sequoia-hope/matrix-play/design/study/sunflower/README.md

# Sunflower: a low-cost 38 mm round board on 4 layers

Started 2026-11-06 at the user's request. The goal was to take the low-cost parallelogram parts (XL-1615RGBC-RF LEDs, AW20198QNR QFN drivers, all in stock at JLC) into a round board, lay the LEDs out in a sunflower pattern at the lower spacing, find how many LEDs a 4-layer board can route, and cost it down. The user first asked for 32–35 mm, then set the diameter at 38 mm, the same as the main round pendant.

Generator: `scripts/sunflower/`, forked from `scripts/parallelogram/`. Boards: `hw/sunflower/<tier>/`.

## Design

- **Outline:** a 38 mm circle. The 35 mm round cell (403535) sits behind the board and is wired to BT1, as on the main pendant.
- **LEDs:** XL-1615RGBC-RF at 0°, laid out as a Vogel spiral with r = 17.2·√((n+a)/(N−1+a)) and θ = n·137.5°. The innermost LED sits at 2.4 mm, so the centre is left for the Q2 light sensor. Density is uniform over the ring. Where diagonal neighbours' 2.0 × 1.9 mm courtyards would overlap, a relaxation step nudges them apart. That step only did anything at 132 LEDs.
- **Matrix map:** LEDs are sorted by angle and cut into wedges of 11. Each wedge is one CS triplet, with cathodes running radially. Within a wedge, the SW line is the LED's radius rank, so SW_m forms a ring across a driver's wedges. U1 takes the west wedges and U2 the east. The table is generated, so firmware reads it from `build_led_cells()`.
- **Back side:** Variant D is also a 38 mm disc, so its proven RP2350, flash, charger, LDO and USB block keeps its exact position (macro offset 0, 0). The rest of the back is placed as follows:

  | Part | Position |
  |---|---|
  | AW20198 drivers | (±12.6, 3) mm |
  | EVQP7J side buttons | north-east and north-west rim (±21°), 0.40 mm proud of the edge |
  | J1 (USB pads) | Variant D's position |
  | BT1 battery socket | Molex PicoBlade 1.25 mm 2-pin right-angle, 53261-0271 (C177225), at the north-west rim (−11.4, −10.2) mm, turned 250°, plug entering from the board-centre side |

- **Battery connector:** the user asked for a JST-style plug and first picked JST GH 1.25 mm. The 1.25 mm plugs on most small LiPo cells are friction-fit Molex PicoBlade clones ("micro JST 1.25", MX1.25), which don't mate with latching GH, so BT1 is now a genuine PicoBlade 53261-0271 (C177225, 27k at JLC; the CJT A1251WR-S-2P clone, C225111, is a cheaper same-size option). Its courtyard is 9.4 × 6.8 mm, wider than GH's 7.0 × 6.5 mm. `scripts/sunflower/jst_site.py` searches every routed tier for a spot where the courtyard clears all back parts. With the plug facing the rim nothing fits on every tier. The user chose the north-west rim with the plug entering from the board-centre side, which needs no parts moved. The alternative was the south-east rim by the charger, which needs U8, C6 and R8 moved. The battery nets run about 30 mm across the board at 0.25 mm, roughly 20 mV of drop at the 300 mA charge rate. Pin 1 is +, marked on the silk; check the cell's plug polarity, since makers differ. The plug has to go in before the cell is laid on the board, and the cell rests on the socket body.
- **Silkscreen:** the front carries the main pendant's seed web, the Voronoi cells of the LED centres with a ring round the outside, clipped clear of pads. The back names the buttons by function (PWR on SW1, USER/WAKE; BOOT on SW2, BOOTSEL) and marks the battery socket BATT with + and −, plus a LIPO 403535 note and IC designators.
- **Stackup:** 4 layers, JLC04161H-7628. In1 is an unbroken GND plane, In2 is the only inner signal layer. Vias are 0.30/0.15 mm. No vias go through the solid exposed pads except their own GND thermal vias.

## Tiers and results (ultraroute 3de3d83)

| Tier | LEDs | Drivers | mm² per LED | Nearest spacing | Opens | Hard DRC | Vias | Vias in SMD pads | BOM/bd @10 |
|---|---:|---:|---:|---:|---:|---:|---:|---:|---:|
| s1-66 (pofv) | 66 | 1 | 13.8 | 3.46 mm | **0** | **0** | 395 | 83 | $10.73 |
| s2-88 (pofv) | 88 | 2 | 10.4 | 3.00 mm | **0** | **0** | 472 | 84 | $12.02 |
| s2-110 (pofv) | 110 | 2 | 8.3 | 2.69 mm | 1 (`I2C_SDA` at U1 pin 28) | 5 (the 2 old `+3V3` 0.10 mm tracks by U3, 3 dangling stubs) | 632 | 121 | $12.37 |
| s2-132 (pofv) | 132 | 2 | 6.9 | 2.38 mm | 2 (an LED cathode by U3, one GND link) | 0 | 709 | 137 | $12.72 |

Numbers are after the battery socket moved to the north-west rim (2026-11-06; first JST GH, then Molex PicoBlade). Each board was re-routed locally round the new socket: `apply_jst.py` swaps the footprint, moves it and strips the copper in the way, then `route_variant.py --continue-plough` runs with a rip disc at the site. `finish_jst.sh` then cleans the copper, keeping `clean_copper_4l.py`'s output only when it stays at 0 open, and redoes silk, 3D models and the audit. s2-110 and s2-132 were at 0 open before the move; one more targeted pass each didn't close their new opens. The pre-move boards are kept as `route/pre_jst.kicad_pcb` (pads) and `route/pre_picoblade.kicad_pcb` (GH) in each folder.

For comparison, the parallelogram's p2-132 used 9.6 mm² per LED and its p3-162 (10.5 LEDs/cm²) did not close. Main round-pendant Variant E is $26.46 per board in parts, on 8 layers with 5 WLCSP drivers.

"pofv" means the router put same-net vias inside SMD pads (79–125 per board, about half of them in LED pads), so the board must be ordered with filled and capped vias (POFV).

**Threshold:** with vias allowed in pads, every tier up to 132 LEDs on the 38 mm disc routes to 0 opens on 4 layers. s2-110 and s2-132 still have small width and joint defects left by the router at tight spots. Unlike the parallelogram, a sunflower has no columns lined up over the drivers' 3.4 mm solid exposed pads: the escapes spread in every direction, so the 4-layer ceiling is not set by column pitch. Past 132 LEDs the limit would come from LED packing first: at 0° the XL-1615 courtyards start to collide at 132 and needed relaxation.

## Cost-down

Per board at qty 10 (live LCSC prices, `cost.json`):

1. **4 layers instead of 8.** This is the largest saving, in fab cost. Fab price was not quoted; read it from JLC's quote tool.
2. **AW20198 QFN instead of IS31FL3745 WLCSP.** $0.89 against about $2.26 each, in stock at JLC, with no Global Sourcing or pre-order. 66 LEDs need 1 driver; 88–132 need 2.
3. **XL-1615 instead of XL-1010.** $0.0159 against $0.027–0.029 each: $0.84 to $1.47 less per board, and 699k in stock against 12.9k.
4. **No vias in pads.** POFV is an added cost on JLC 4-layer boards. The rules generator now writes `no via hole in an SMD pad` (`physical_hole_clearance`, with the solid exposed pads exempt). ultraroute honours it since 0b0f336. Re-route results are below.
5. **Not yet done: RP2040 instead of RP2350 + L1.** $1.01 against $1.57, which also drops the AOTA inductor (43 in stock at JLC). It means a new MCU block, because the current one is copied from Variant D.

### No vias in pads (s1-66, s2-88)

These were re-routed from bare boards with the rule in place. The generator's pre-placed regulator GND vias now also stay out of all pads, which leaves 1 PGND via where there were 2.

| Tier | Opens | Hard DRC | Vias | Note |
|---|---:|---:|---:|---|
| s2-88 | **0** | **0** | 529 | Raw router copper: `clean_copper_4l.py` breaks 2 connections on this board, so it isn't used. Left: thin pad joints and untidy copper (off-centre via joins, cap gaps) that DRC accepts. |
| s1-66 | 1 (`SW1_4` at U1 pin 3) | 5 (3 GND-plane necks on In1, 2 dangling USB_DM stubs) | 434 | Probe board, not for fab. |

A bounding-box check of vias in non-GND SMD pads flags a few on each board, all false: rotated BT1 pads and the drivers' unnumbered paste windows. Tested against the real pad shapes, neither board has a via in a copper pad.

Keeping vias out of pads costs at most an open or two and some clean-up, so a POFV-free 4-layer order is in reach at 88 LEDs. The filled-via (POFV) routes are kept as `hw/sunflower/s1-66-pofv` and `s2-88-pofv`, each with fab files.

## USB-C study (s2-110-usbc)

Asked for on 2026-11-06: a real USB-C on the back instead of the wire pads, buttons and battery socket at the top, an LED at the centre, and the light sensor out at the rim. Built as its own variant beside s2-110 (`hw/sunflower/s2-110-usbc`, `VariantSpec(centre_led, usb_c, als_pos)` in `config.py`).

- **Receptacle:** HRO TYPE-C-31-M-12 (C165948, 322k at JLC), KiCad's footprint, on B.Cu at the south rim, mouth out, front 0.3 mm past the edge. Its 4 shell legs and 2 pegs go through the board, so they are keepouts for the front LEDs: `sunflower_points(..., keepouts=...)` pushes LED centres out of them (and out of the light sensor's spot) before the courtyard relaxation. Note that flipping a footprint to B.Cu mirrors it front-to-back, so the receptacle sits at 180°.
- **Why not beside the battery socket:** at every angle next to the socket on the north rim, the receptacle's 10.7 × 9.5 mm courtyard lands on U3 itself (and Y1, the RP2350 decoupling). That spot needs the RP2350 block moved, which every tier copies from Variant D. At the south rim it only displaces U7 (ESD), U8/R8/C6 (cell protection) and C1, which the legaliser moves round it.
- **Centre LED and light sensor:** the spiral starts at the centre (LED 0 at 0, 0); Q2 sits on F.Cu at the top rim (0, −18.2) with R43/C70 behind it.
- **Route:** from scratch, then plough passes with wider shove reach and targeted rip-ups. VBAT_EN would not route from GPIO14 (pin 18), nor from GPIO15 or GPIO0: its 22 mm run south to Q1 (by the USB-C) has to cross the LED field. It now sits on **GPIO28 (pin 42)**, beside VBAT_SENSE on pin 40, and routes along the same inner-layer path (`VariantSpec.vbat_en_gpio`, this variant only; firmware must use GPIO28 here). Unlike s2-110 (121 vias in pads), this variant keeps the no-via-in-pad rule, so U2's south pins had to escape between its PVCC caps: those caps (C40-C42) now sit 0.45 mm further out (`pcb_gen.py`, east driver, USB-C variants only). The +3V3 neck at the LDO output was a second stub into U6 pin 1; the via now feeds the fanout track directly. **Result: 0 opens, 0 DRC errors and warnings, copper audit, pad joints, sync and nets checks clean; 612 vias. Fab files in `hw/sunflower/s2-110-usbc/fab/`.** BOM $12.55 at qty 10 ($0.18 over s2-110 for the receptacle).
- **USB data fix:** the first USB-C schematic joined D+/D- (A6/A7, B6/B7) into CC1: the jogged wire from J1 down to U7 ended on the CC1 wire. `sch_gen.py` now joins J1 and U7 by `USB_DM_C`/`USB_DP_C` labels; the board was synced and those nets re-routed. Commit 997affe carried the short.
- **Bring-up pads and board ID (2026-11-07):** asked for after the first route. Fourteen 1.0 mm test pads on the back (KiCad's pad with its courtyard cut to 0.75 mm, `round_pendant:TestPoint_Pad_D1.0mm_CrtYd0.75`, so they fit the pockets between routed parts):
  - Power: VSYS, 3V3, VBAT, 1V1, VBUS and GND.
  - Debug: RUN, SWCLK and SWDIO, grouped at the north rim.
  - I2C0: SDA and SCL.
  - **UART1 on GPIO24 (TX, TP14) and GPIO25 (RX, TP15).**
  - GPIO29, the spare ADC input (TP16).

  UART first went on GPIO8/9 with pads west of U3 (TP9/TP10). Those pads blocked the west LED rows and ACC_SDA, so they were dropped on the user's call. **Board ID straps** are on GPIO19/20/21 (pins 31-33), read with pull-ups: `ID = GPIO19 + 2·GPIO20 + 4·GPIO21`, with tied = 0 and open = 1. This board ties GPIO19 to GND through net tie NT1, so it reads **ID 6**; boards without straps read 7. The tie is a net tie, not a wire, because ERC flags a bidirectional pin on GND. Re-routed locally from the 612-via board over eight plough passes (`route/run-tp*.log`). **Result: 0 opens, 0 DRC errors and warnings, copper audit, pad joints, sync and nets checks clean; 637 vias; fab files re-exported (BOM unchanged: test pads and net tie are not assembled).** Back silk names each test pad only where the label clearly sits by its own pad. 3V3, VBAT, RUN, CLK, SDA and VBUS have no room for one; the viewer shows their nets.
- **LX cutout trimmed (2026-11-07):** the In1 GND cutout under the regulator's switch node was the bounding box of U3 pin 48 and L1's LX pad, so it also cleared plane under pins 46/47 and the PGND pour (9.2 mm²). `pcb_gen.py` now draws it as the VREG_LX copper itself (zone and LX pads) grown 0.25 mm: 5.4 mm². Applied to the routed board in place (no copper moved, plane refilled): 0 DRC, copper audit clean; gerbers re-exported, BOM and CPL unchanged.
- **Release set, CPL fix, and phase gates (2026-11-08):** `hw/sunflower/s2-110-usbc/fab/` (`sunflower-s2-110-usbc-gerbers.zip`, `bom-jlcpcb.csv`, `cpl-jlcpcb.csv`) is the current release set; the older KiCad Fabrication Toolkit export from 01:37 on 2026-11-07 (predating test pads, the LX cutout trim, and CPL fixes) was moved aside to `hw/sunflower/s2-110-usbc/production-stale-2026-11-07-0137/`. `scripts/sunflower/export_and_cost.py` was fixed to mirror Bottom-side rotations `(180 - rot_kicad + rot_off) % 360` and apply EasyEDA pick-origin offsets across all 34 LCSC parts (`BT1` at `110.00°`, `(87.7073, -89.4751)`; `J1` at `0.00°`, `(100.0000, -114.0290)`), verified across all 191 placements (`design/renders/sunflower-s2-110-usbc/cpl-check-{top,bottom}.png`). All 34 unique LCSC parts are in stock with normal lifecycle on 2026-11-08 (`L1` `C42411119` restocked to 1,520; lowest stock is `U6` `C2860046` at 531). Full phase-gate evidence lives in `design/gates/sunflower-s2-110-usbc/phase0.md`..`phase10.md` (study/sim/bring-up docs: `intent-s2-110-usbc.md`, `architecture-s2-110-usbc.md`, `brief-s2-110-usbc.md`, `stackup-4l.md`, `bringup-s2-110-usbc.md`, and `design/sim/sunflower-s2-110-usbc/`): **Gates 1, 2, 3 `passed`; Gates 0, 4, 10 `awaiting_signoff`; Gates 5, 6, 7, 8, 9 `failed`** on frozen `Rev S3C` rules/placement/copper/silk findings listed below.
- **Helpers:** `scripts/sunflower/fix_open_4l.py` (4-layer copy of the one-connection maze fixer; no via holes in SMD pads) and `gnd_via.py` (tie a GND pad to the In1 plane). Neither found legal room round U2.

## Open items

- **s2-110-usbc user sign-off (Gates 0, 4, 10 in `design/gates/sunflower-s2-110-usbc/`):** decide between ordering `Rev S3C` (`hw/sunflower/s2-110-usbc/fab/`) as a `5–10` unit bench prototype with documented Gate 5–9 waivers and firmware guards vs spinning `Rev S3D` first; confirm `403535` cell `297 mA` (`~0.6–0.8C`) charge rate, `BT1` pre-mating (`3.02 mm` to `C9`, `4.04 mm` to `U3`) + `0.05 mm` Kapton + `≥ 2.4 mm` rear spacer (`~9.6 mm` stack over `3.40 mm` mated `BT1` / `3.26 mm` `J1`), `SW1/SW2` `+0.40 mm` nominal plunger overhang, front Voronoi silk art, and `B.SilkS` identity omission.
- **s2-110-usbc `Rev S3C` prototype assembly & firmware guards (if ordered before `Rev S3D`):** order PCBA (`JLC04161H-7628`, `ENIG 1U"`, green LPI mask) with reflow **`Pass 1 = B.Cu`, `Pass 2 = F.Cu` (`≤ 245 °C`)** (`Q2` `XYC-PT19C-L1` allows 1 reflow pass only) and **NO `F.Cu` wave/hand-soldering on `J1`'s 4 PTH shield slots** (`sunflower-B_Paste.gbp` omits paste on `J1`'s PTH slots while `F.Cu` LEDs sit `0.18–0.29 mm` away; tack `J1`'s outer `B.Cu` slot edges under microscope on bench, and switch to full-SMT `TYPE-C-31-M-22` `C530612` or add `B.Paste` in `Rev S3D`); verify `BT1.1–BT1.2` continuity open before connecting a cell (`VBAT` via `@(86.99, 89.16)` is `0.107 mm` from `BT1.2`, and 29 vias sit under `BT1`); run XIP flash in **1-bit (`0x0B`) or 2-bit (`0xBB`) SPI** (`U4.8` is `8.56 mm` / 4 vias from nearest cap `C14`, giving `312–554 mV` 4-bit QSPI SSO droop vs `78–156 mV` in 1x/2x); enforce `ADC4` thermal caps (`GCC ≤ 105` on battery for `≤ 48 °C`, `GCC ≤ 9` CC / `≤ 24` CV gated on `PGOOD == 0 || CHG == 0` for `≤ 45 °C` LiPo); set `GPIO4/5` `12 mA` pad drive + `AW20198` `GCR = 0xB9`, `GPIO26/27` `PDE = 0, IE = 0` (`RP2350-E9`), and `≥ 30 ms` (`6 τ`) `VBAT_EN` (`GPIO28`) settle (`bringup-s2-110-usbc.md`).
- **s2-110-usbc `Rev S3D` hardware fixes (Gates 5–9):**
  - *RP2350 regulator & zones (measured on `s2-110-usbc`):* `+1V1` `RP2350 ring` fills as **1 whole piece (`6.0625 mm²`)**, whereas `+3V3` `RP2350 band` splits into **4 pieces (`[1.9164, 4.6139, 0.2974, 2.9284] mm²` = `9.7561 mm²`)** with 11 foreign vias inside `U3 ring`. Add power spokes from `COUT` (`C18`, `Zone 11`, currently 0 spokes) into `+1V1` ring so core `DVDD` current does not flow through `U3.50` `VREG_FB` (Gate 7 `B1`); give `C17` (`CFILT`) its own GND via separate from `U3` `PGND` `@(102.43, 99.10)` (Gate 7 `B2`); swap `In2.Cu` to solid `GND` plane + `LX cutout` (`0.21 mm` directly beneath `B.Cu` `U3`/`L1`) so `+3V3` `ADC_AVDD` and `VSYS` do not cross under `VREG_LX`/`L1` (`19–48 mV_pk` coupled spikes, Gates 5/6/7/8); and stitch `+3V3` band with locked tracks as on Variant F (Gate 7 `B4`).
  - *Thermal vias, PDN, flash & battery socket:* move `U3.61` (1 via) and `U5.17` (2 vias) open vias out of `B.Paste` windows into paste-free cross channels and add `U1.41` in-pad GND vias (Gate 7 `B5`); move `C22` beside `U4.8` (`≤ 2 mm`) for 4-bit `75 MHz` QSPI (Gates 6/8); pull `BT1` clear of Molex's `3.0 × 2.5 mm` restricted area, co-locate `U8` beside `BT1`, and parallel power-rail vias (`438 mΩ` PCB battery loop, `236.7 mΩ` `VSYS → U1`) (Gates 6/7); populate `.kicad_pro` `"netclass_assignments"` (Gate 5 `B3`).
  - *Silkscreen & fab layers:* move `BT1` `+`/`-` and `J1` `USB 5V` outside their connector housings (currently occluded when assembled), add `B.SilkS` pin-1 dots on `U1/U4/U5/U6/U9` + `B.Fab`/`F.Fab` designators, relabel `SW1` `"PWR"` → `"USER"`, add missing `TP*` net labels, and pull silk off open vias (Gate 9).
- **Other Sunflower tiers (`s1-66-pofv`, `s2-88-pofv`):** re-export `fab/cpl-jlcpcb.csv` with the fixed `scripts/sunflower/export_and_cost.py` before ordering PCBA (`BT1` and Bottom-side ICs on earlier exports predate the Bottom-mirror CPL fix), and check `+3V3` band / `+1V1` ring zone piece counts on whichever other tier is chosen.
- s2-88 (no vias in pads): 2 thin pad joints and copper tidying, then fab export.
- s2-110 and s2-132: close the opens left by the socket move (s2-110: I2C_SDA at U1; s2-132: an LED cathode near U3 and one GND link).
- s1-66 (no vias in pads): 1 open at U1's SW side. Try U1 turned 90° or 180° so its SW pins face the LED field.
- ultraroute: the necks and sub-width segments near U3 (s2-110 `+3V3` at 0.10 mm under a 0.15 mm rule, the s2-88 CS1_1 neck) are the min-connection-width items already on the ultraroute session's list.
