sequoia-hope/matrix-play/design/decisions.md

# Decisions

| Date | Decision | Reasoning | Alternatives |
|---|---|---|---|
| 2026-11-02 | IS31FL3741A-QFLS4-TR (C2940604) for the drivers | IS31FL3741-QFLS4-TR has 0 JLC stock (`jlc_parts.py search`); the A has 455, same 39 × 9 QFN-60 and 13 × 9 RGB circuit | IS31FL3729: named fallback, rejected: 15 × 9 dots gives 45 RGB per chip, 90 LEDs from two |
| 2026-11-02 | 234 LEDs on a 38 mm board, not a smaller board | Requested diameter; 234 sites need ~37 mm, and 38 mm leaves spare sites at the rim for USB-C tabs and any lanyard hole | 37 mm: smaller, but no spare sites near USB-C |
| 2026-11-02 | Driver SW and logic supply on VSYS, 3V3 regulator fed from VSYS | Driver inputs must stay ≤ VCC + 0.3 V (IS31FL3741A p.5); a regulator fed from the same rail cannot exceed it | Drivers on raw VBAT: a flat or absent cell with USB in would violate the limit |
| 2026-11-02 | Omit the 20 Ω/51 Ω CS resistors of the datasheet's Figure 2 | They reduce chip dissipation at 5 V, 78 parts for two drivers. At ≤ 4.2 V (5 V only on USB) with the lower peak current of R18 and the firmware limit R19, the chip stays within ~0.25 W. Rechecked in phase 1 | Fit them: no bottom-side room |
| 2026-11-02 | Accelerometer on its own I2C bus | Driver bus runs 1 MHz for frame rate; many low-power accelerometers stop at 400 kHz | Shared bus at 400 kHz: 702 bytes takes ~16 ms, marginal for 60 fps |
| 2026-11-02 | Boardroom project layout from phase 0 | User's instruction | — |
| 2026-11-02 | Gate 0 review finding 4 disputed in part: the reviewer counted 3 tracks per channel at JLC minimum | Routing G under the LED body through the 0.35 mm centre gap leaves 2 tracks per 0.75 mm channel, and no crossings on F.Cu. Written into R21; proved or dropped at routing | 3 tracks per channel at 0.1/0.1 mm, needing a crossing for G and B |
| 2026-11-02 | Gate 0 review finding 3 (blind vias effectively mandatory) taken as a recommendation, not settled | It changes cost and lead time, so it is the user's to decide; quote not yet checked | Through vias with EP cut-outs and a modified RP2350 ring |
| 2026-11-02 | 6 layers, through vias, via-in-pad; no blind vias | User's decision at gate 0, against the blind-via recommendation | Blind F.Cu–In1 vias on 4-layer HDI |
| 2026-11-02 | Battery is Grepow 5435035, charged to 4.2 V; XB9901A on board | User named the cell. Listings disagree (3.85 V nominal vs 4.4 V), and 4.2 V is safe for either. Protection status of the cell unknown, and XB9901A also gives reverse-connection protection per its datasheet | LiHV charger at 4.35 V: more capacity, needs the maker's spec |
| 2026-11-02 | BQ24073RGTR, not the BQ24075 family | VSYS regulated at 4.4 V on USB keeps driver dissipation low and holds blue/green headroom; 6.6 V OVP keeps VBUS faults off the drivers. BQ24075's 5.5 V OUT would run the drivers hotter | BQ24072 tracks VBAT + 225 mV: cooler but dims with a flat cell |
| 2026-11-02 | Sleep budget raised from 75 to 85 µA; flash deep power-down not relied on | RP2350 docs describe only an XIP exit at flash boot, so a flash left in deep power-down may not boot on a P1.7 cold wake. 610 mAh makes the difference small | Warm-boot code from retained SRAM (P1.3, +7 µA): firmware option |
| 2026-11-02 | LIS2DW12 SA0 and CS tied to VDD_IO | They have ~20 kΩ internal pull-ups (Table 3); strapping SA0 low would draw ~160 µA, twice the whole sleep budget | SA0 low with pull-up disabled by register: draws until configured |
| 2026-11-02 | Style check's `grid` errors on matrix1 and matrix2 waived | They are LED matrices, and drawing one as a grid is what makes it readable; datasheet Figure 2 does the same. No other sheet is affected | Scatter 234 LEDs to pass a check: worse to read |
| 2026-11-02 | SKRTLAE010 for the buttons, not TS-1088-AR02016 | Basic part, but its drawing shows a top plunger; R10 needs side actuation at the edge | — |
| 2026-11-02 | Schematic is hierarchical, drawn with kicad_write plus a small root-sheet writer in scripts/schematic.py | kicad_write has no sheets; instance paths are rewritten after saving. Request for kicad_write worth raising | One enormous sheet |
| 2026-11-02 | U3 centred on a via, 8 ring vias stepped out to the 3V3 band | Reviewer proposed offsetting U3 by (1, 1): 4 EP, 0 ring, 10 band. Recomputed with only the 5 open stub directions: centring gives 1 EP, 0 ring, 8 band, which disturbs less. Both keep the ring whole | Centre with vias in the ring (8 segments, 4 unspoked); (1, 1) offset; 45° rotation |
| 2026-11-02 | Buttons at −28° and −152°, on rim sites | Their 1.2 mm peg holes can't fit an LED channel; 2 sites lost, spare rim sites cover it | Put them on the south, by USB: more interior loss |
| 2026-11-02 | Board net classes checked by script against nets.csv, not by `nets_check.py --rules` | kicad-cli's netlist reports class Default on this hierarchical schematic; the board reads the right class. To raise with the skill: nets_check should read the board or handle hierarchy | Flatten the schematic |
| 2026-11-02 | SIGNAL clearance 0.09, below nets_check's derived 0.10 | JLC floor; R21 needs it in LED channels; low voltage | 0.10: fails channel fit margin |
| 2026-11-02 | Decoupler distance limit raised from 3 to 7 mm | LED via grid: a 0402 fits only between 4 vias; bulk 22 uF further. High-value bulk isn't distance-critical at 32 us scan edges; 100 nF kept nearest | Stub more vias aside: more F.Cu congestion |
| 2026-11-02 | U3's 8 band vias are 0.20/0.10 mm | A 0.25 mm via plus clearance leaves slivers under the minimum width in the 0.6 mm band (review, gate 6). JLC allows it on this board | 0.8 mm stubs: 0.01 mm from pads |
| 2026-11-02 | Charger EP whole, 1 thermal via | Through vias reach the LED side, so one LED channel crossing falls under a 1.7 mm pad. Reviewer's 4 vias aren't physically available. TI's thermal regulation protects it; phase 8 | Split EP, same via count |
| 2026-11-02 | U3 turned so its USB, QSPI and regulator side faces south; brief §7 updated | USB and QSPI shorter | Regulator north, USB crosses the board |
| 2026-11-02 | Pattern study made, board unchanged; placement sign-off on hold | User found LEDs too close to USB-C and asked for golden-spiral tests. Plans in design/study/patterns/. True golden arcs reach 167–191 LEDs; sunflower lattice reaches 234 with 0.29 mm minimum pad gap | Route the 2 mm grid as placed |
| 2026-11-02 | Vertical USB-C studied with the turned sunflower, board unchanged | User asked for right-angle USB-C off the back, with the rotated sunflower. The plug must pass beside the 35 mm cell, which needs a 41 mm board; study in design/study/usb-back/ | Edge-mount J1 on 38 mm; smaller cell on 38 mm |
| 2026-11-02 | USB-C off the board, pads only; turned sunflower; 38 mm kept | User's decision: they dislike the gaps a board-mounted connector leaves in the pattern. Removes all USB through-holes and lets the 35 mm cell stay centred. Proposed, unconfirmed: 6 pads (VBUS, GND, D+, D−, CC1, CC2) with Rd and ESD staying on the board | Vertical USB-C on 41 mm; edge USB-C on 38 mm |
| 2026-11-02 | Variant b: EVQP7C01P buttons (C388883), pegs between LEDs | User's choice. 6 LEDs nudged away from pegs to keep 0.22 mm to the 0.7 mm holes in the datasheet's land pattern | EVQP7J01P no pegs; SKRTLAE010 |
| 2026-11-02 | Variant b: 6 USB pads; Rd and ESD stay on board | Works with a bare receptacle; a breakout with its own 5.1k leaves CC unwired. No connector, no LCSC part on J1 | 4 pads with Rd off-board |
| 2026-11-02 | Variant b: exposed pads as tiles cut round foreign anode vias, per instance on the board | Sunflower vias land anywhere, so no fixed split works: U1 and U2 11 vias each, U3 3, U5 2. 0.3 mm from via centre keeps 0.2 mm hole-to-copper. EP solder paste not yet added: needed before release | Move LEDs off chips, breaking the pattern |
| 2026-11-02 | Variant b routing trials: 1 to 5 incomplete | Open signal connections: 103, 109, 120, 194 (control first), 122 (chip keepouts, inner fan-out). Keepouts and inner fan-out cut the control-only pass to 8 open, but the full board stays near 100+ with rip-up out of time. Trials 1 to 4 boards overwritten; trial 5 kept in route/trials/t5 | Blind vias; a matrix map aware of crossings; more router time |
| 2026-11-02 | Matrix assignment isn't what limits routing; variant b keeps its map for now | Same settings as trial 5 (122 signal open, 82 plane, 49 errors): spiral map, trial 6 (hw/round-pendant/b-spiral), 146, 73, 72; driver-centred fan map, trial 7 (hw/round-pendant/b-fan), 118, 67, 51. Fan cut estimated crossings by 43% (503 to 288) and open signals by 3%. CS nets are most of what stays open | Blind vias; a less dense pattern; longer router runs |
| 2026-11-02 | Symmetric centre studied, no board changed; 5-fold 5 + 10 + 15 recommended, unconfirmed | User asked for a more rotationally symmetric centre. It keeps 234 LEDs, exact to 5.4 mm radius, moves 11 nearby LEDs by at most 0.49 mm, and opens the tightest pad gap from 0.36 to 0.42 mm. Study in design/study/center/ | 5 + 10; 6-fold (2.8 mm hole); 8-fold (0.30 mm gap, 4.5 mm hole); Fibonacci rings (no overall symmetry) |
| 2026-11-02 | Plain sunflower plus 2 centre LEDs studied, no board changed | User asked to see it. 2 neighbours eased by at most 0.25 mm keeps the 0.36 mm tightest gap; 0.18 mm with nothing moved. Drivers have exactly 234 positions, and the wiring and back-side fit of the extra 2 are unsolved. Study in design/study/center-plus2/ | Symmetric rings (design/study/center/) |
| 2026-11-03 | Variant c: plain sunflower plus D235 at (0.05, -0.65), nothing nudged, on RP2350 GPIO23-25 | User's choice. Anode on +3V3: VSYS would hold an off GPIO above IOVDD. R40 1 k red, R41 and R42 470 R green and blue, for about 1.5 mA, near a matrix LED's 1.25 mA average; Vf at this current estimated from the p.6 curve, not measured. Pin high is off; firmware must clear pull-downs before sleep, or the LED draws from the 85 uA budget. GPIO23-25 chosen as the free pins facing the centre. Fan map used, as the best of trials 5-7 | Share a matrix cell: no separate control |
| 2026-11-03 | Routing crunch started on variant c, through vias, 6 layers | User asked for multiple automated attacks with subagents and Gemini. Brief in design/study/crunch/README.md. Layer, map, placement and router attacks each keep their own variant folders; a Gemini 4 Argon plan is advisory | Blind vias and bigger board not started, still the user's call |
| 2026-11-03 | 8 layers allowed; blind vias ruled out | User's decision: the board must stay within JLC capabilities. 6 layers is still preferred if it routes. Through vias stay | Blind vias, bigger board |
| 2026-11-03 | All copper zones get explicit clearance: planes 0.2 mm, RP2350 ring and band 0.09 mm | Found by the layers attack. zones_b left KiCad's default 0.5 mm, which cut the GND plane to 320 mm² in 20 pieces on trial 7 and left the 1V1 ring with no fill. Refilling trial 7 at 0.2 mm: 832 mm² in 1 piece, plane opens 67 to 2, signal opens unchanged. Trial plane-open figures to date are inflated by this | - |
| 2026-11-03 | SW scan lines move to a new class SW_SCAN: 0.1 mm track, 0.25 mm via | Gemini's review found it, checked here: nets.csv had them POWER, and the intended 0.1 mm rule used a condition the router can't read, so trial 7 laid 899 of 955 SW segments at 0.2 mm, about 970 mm on In1 and In3. 0.1 mm was the original intent. 84 mV drop at 494 mA is Gemini's estimate, not yet checked on a routed board: must be measured against driver headroom before release | 0.12 mm; POWER at 0.2 mm |
| 2026-11-03 | Routing crunch focuses on 8 layers: GND on In2, VSYS and +3V3 on In5 | User's direction, after 8 layers cut signal opens from 107 to 56 on the same 1200 s limit, the only large gain so far. Not yet complete. JLC publishes no 8-layer stackup table, so thicknesses need confirming with a quote | Keep pressing 6 layers |
| 2026-11-03 | Two-board stack being explored alongside 8 layers | User's idea: a 4-layer LED board with both drivers on one half of the back, and a small processor board on the empty half, joined at the edge. Could be cheaper than 8 layers, and takes control nets off the LED board. First test is whether the LED board alone routes on 4 layers. 8 layers stays preferred if parts must be flown over each other | 8 layers only |
| 2026-11-03 | Two-board stack: agent recommends shelving it, owner has not decided | 4-layer LED board alone: 91 open with a GND plane, 56 with no plane (GND then 144 mm of 0.2 mm track). Processor half fits only by moving the LDO and its caps 9-11 mm, with 15 courtyard overlaps. 16 joint pads, no JLC board-on-board service found, no bare-board quote. Reversal needs under 10 opens with a real GND path and a quote showing a clear saving. Report: design/study/crunch/stack/report.md |
| 2026-11-03 | New 8-layer starting candidate: U3 fix, drivers 2.4 mm north with their parts, cathode vias through driver pads | Reported 22 open / 5 plane / 76 errors / 865 vias at 1200 s (c-placement-y5, --cell 0.025) against 57 / 11 / 54 / 956 with the U3 fix alone. No LED moved; the map changed. Driver pad copper falls from about 26 to 16-17 mm², thermally unchecked. |
| 2026-11-03 | Near-complete 8-layer route: c-placement-y11, not signed off | 2 signal open (CS2_16, CS2_17), 1 plane open, 901 vias, 3000 s, --cell 0.025. Adds USB and crystal uncrossing (R14/R15 swap, Y1 turned, R17 moved, C23/C24 swap), real net classes for VBAT, BAT_N, VBUS, driver GND zones, critical nets locked from a first pass. VSYS minimum dropped from 0.3 to 0.2 mm: a rule change, stub lengths and currents not yet checked. |
| 2026-11-03 | c-placement-y12: In6 ground island and closer C23 | 2 signal open (CS2_14, CS2_17), 0 plane, 6 dangling stubs, 880 vias, 3000 s, --cell 0.025, reported pad_joints pass. XIN 6.3 mm against the 6 mm limit. Last opens are LEDs over L1 and the PGND zone. |
| 2026-11-03 | First fully connected route: c-placement-y17, not signed off | 0 signal open, 0 plane open, 898 vias, 235 LEDs, 8 layers, through vias. KiCad DRC with zones refilled: 0 unconnected, 5 dangling stubs, XIN 6.34 mm against 6 mm, SW2_8 via in the L1 window, plus silk. pad_joints FAIL: U1.53 0.069 mm, U2.28 0.022 mm. Double-wired zone copper not yet removed. |
| 2026-11-03 | c-placement-y17/y18 complete route rejected as a finished board | DRC 0 unconnected and 877 vias after tidying, but 15 foreign vias within ±2.3 mm of U3 (3 placed before routing) cut the 1V1 ring from 6.1 to 1.5 mm², leaving 1V1 on about 72 mm of thin inner track, against `chips/rp2350.md`. Next: y19 forbids new foreign vias in the ring; y20 tries a 1V1 pour on In6. |
| 2026-11-03 | Electrical check of c-placement-y17: fine at the 300 mA limit, not at full white | Agent figures: full-white row needs about 4.00 V typical, about 4.55 V top bin (above a full cell); 3.44 V at the 300 mA limit if GCC scales the peak. Mostly SW line resistance, 0.1 mm tracks, worst 276 mV. VSYS at 0.2 mm judged justified on B.Cu, except the single U5 output via. Report: design/study/crunch/layers/report.md |
| 2026-11-03 | c-placement-y19 replaces y17 as the best board | 0 signal open, 2 plane open (+3V3 at U6 pad 1 and C12 pad 1), 895 vias, with new foreign vias forbidden inside ±2.3 mm of U3. Reported: ring one piece at 6.0 mm², 3V3 band in 9 pieces. y20 (1V1 pour on In6) scored 1/1/1/897 with the pour in 5 pieces, so the vendor ring stays. |
| 2026-11-03 | Full-white headroom stops driving the routing | User: "most of the time I am gonna be operating this at a reduced brightness". So 0.1 mm SW lines stay, widening the worst four becomes best-effort after routing, and the firmware keeps a global-current limit (GCC scaling, 300 mA figure) as protection against heat and droop. Full white stays possible on a fresh cell but is not a design case. |
| 2026-11-03 | Real 3D models for the viewer, in 3dmodels/ | EasyEDA models by LCSC number for U3, L1, SW1/2, U6, U8. No model exists for the LED (C965834), so scripts/make_led_model.py draws one from the datasheet; die and top-copper positions are approximate. U1/U2 use the same QFN-60 STEP as U3, because their own is .wrl only. Applied to the viewer copy by scripts/set_3d_models.py, which must run again on each new board; lib footprints unchanged. EasyEDA rotation for U3 (270) and L1 (0) corrected by eye to 0 and 180. |
| 2026-11-03 | Front silk is a sunflower seed web, back silk off for now | User: draw an interconnected web between the LEDs and round the edge, remove back silk, have Gemini tidy designators later. scripts/silk_web.py: Voronoi cells of the LED centres, 0.153 mm stroke, 0.15 mm from pads, JLC standard limits; 99% of the web and 98% of the ring survive clipping. Runs over tented vias. Silk DRC errors 0. |
| 2026-11-03 | c-placement-y27 is the best board: every connection joined | KiCad DRC with zones refilled: 0 unconnected, 861 vias, 5 rule-area vias and XIN 6.34 mm as the only non-silk errors. 1V1 ring whole at 5.66 mm², 1V1 track 15.8 mm. Corner necks not fixed: 456 joints under 0.09 mm. Copy with seed web silk and models is hw/round-pendant/c-web2. Report: design/study/crunch/placement/report-y27.md |
| 2026-11-03 | c-placement-y30 is the best board, published as c-web3 | y27 plus post-route fixes, no parts moved. KiCad DRC: 0 unconnected, 861 vias, 5 rule-area vias and XIN 6.34 mm as the only non-silk errors, one copper sliver warning. necks.py: 30 joints under 0.09 mm, 2 sole, down from 456 and 378. pad_joints_fixed FAIL on U1.61 at 0.079 mm. User approved updating GitHub Pages. |
| 2026-11-03 | Viewer moved to the top of the project page, above the title | User request. Still to fix in the copper, per user: necks, meaning the thin track-to-pad joints. No via change was requested. |
| 2026-11-03 | Thermal figures corrected: heat is set by the whole board, not the drivers alone | The earlier estimate counted driver dissipation only. All supply power becomes board heat apart from emitted light: 1.26 W at 300 mA on a 4.2 V cell, about 44 K/W to still air, so up to about 55 K steady rise (hand estimate, h about 10, both faces, no case or cell, light not subtracted). About 80 °C at 25 °C ambient. Datasheet: TJMAX 150 °C absolute, operating 125 °C. The 300 mA default in intent.md R19 needs review for a worn part; measure on the first board. |
| 2026-11-03 | Trying to add a front-side analog light sensor and load resistor | User request; placement decided by where the analog net can escape. Survey: a 1.7 x 0.8 mm body fits at 12 edge sites without moving LEDs. GPIO27-29 (ADC1-3) are free. Part per user: same as simple_earring, ALS-PT19 C146233 (two pads, 2.3 x 0.8 mm land), 22k C25768 load, 100 nF C1525 filter. 7 sites fit that land. Nothing routed yet. |
| 2026-11-03 | Battery changes to a 403535 round pouch cell | User direction. Same 35 mm outline, 4 mm thick against 5.45 mm, so it still fits. Capacity not confirmed; about 400-450 mAh estimated by scaling the 610 mAh 5435035 by thickness. R4 (297 mA charge) needs reducing once ratings are known; schematic value text for BT1 still names the old cell. |
| 2026-11-03 | Addressable LED counterfactual costed | scripts/cost_compare.py at qty 5, LCSC prices: this board parts $22.83 (LEDs $6.34, driver parts $6.76); 235 WS2816C $22.77 total, 235 SK6805 $23.90. Idle: drivers about 8 mA with SDB high against 165-235 mA (WS2816C) or about 70 mA (SK6805). Fab not priced: needs a JLC quote. |
| 2026-11-03 | No press-to-hold latch on this board | It has SW1 wake from RP2350 sleep (about 85 µA budget), not simple_earring's latch. Recommendation: same press-to-hold feel in firmware, no new parts; firmware must watchdog and return to sleep. Two buttons stay. Sensor powered from a GPIO, as the user agreed. |
| 2026-11-03 | Charge current stays at about 297 mA on the 403535 cell | User prefers faster charging: about 0.74C on an assumed 400 mAh, 266-325 mA across the ISET range (about 0.67-0.81C). R4 stays 3k. Needs the cell to allow 1C charge, not yet confirmed. |
| 2026-11-03 | Gemini's back silk accepted, applied to y30 as c-web4 | scripts/crunch/silk/back_silk.py: 24 of 24 major parts and 28 of 73 passives keep a designator (52 of 97), 0.8 mm text with 0.10 mm stroke, 7 over tented vias. Checked: copper and part positions unchanged, 0 silk errors with the seed web. Needs JLC's high-precision silkscreen option, per JLC's blog only. min_text_thickness set to 0.1. Report: design/study/crunch/silk/report.md. Gemini's claim that U6's 3D dot is 180 degrees off was checked and is wrong here; U8's model dot is off pin 1, 3D view only. |
| 2026-11-04 | Route candidates after the placement agent stopped; base not chosen yet | y30: 0/0 open, FB reaches COUT on B.Cu (agent's check, correcting its earlier doubt), one VSYS and one VBAT via at U5, XIN 6.34 mm, 5 keep-out vias, 1 sliver. y43: 0/0, DRC clean except silk, 3 vias at U5, but D235's via cuts FB from COUT. Eight routes with the via moved all ended with 0-3 signal and 0-3 plane opens; latest y57 2/1, y58 3/1. |
| 2026-11-04 | Corner necks fixed on y30 as c-placement-y61, no reroute | necks_fixed.py (true pad layer, fixing the same GetLayer fault as pad_joints.py): 38 real necks to 0. Other figures unchanged from y30. Scripts necks2.py, joints3.py are re-runnable; necks_hand.py is y30 coordinates only. |
| 2026-11-04 | y61 chosen as the route to take forward | User decision, over more routing runs. User also asked for more vias at U5 for VSYS and VBAT; being tried locally as y62, without rerouting the board. |
| 2026-11-04 | y62 adds 3 VSYS and 3 VBAT vias at U5, locally | Reported per-via current VSYS 363/330/295 mA, VBAT 461/392/167 mA at 988 mA total, from pdn_vias.py. Two vias sit in U5 pin pads (U5.11, U5.2) and must be filled. VSYS drop 9.1 to 7.4 mV, VBAT 50.9 to 49.0 mV. 8 nets moved; SW2_8 off L1. VBAT far via at (6.49, 14.29) still carries all current alone. |
| 2026-11-04 | RP2350 relaxations: 1, 2, 3, 4 and 6 accepted; part of 5 accepted; rest of 5 and 7 open | User decision on the list in rp2350-acceptable.md. Accepted: regulator block rigid with PGND's two vias free to move about 0.7 mm; block may move or turn; XIN/XOUT limit 11 mm; QSPI 25 mm with vias allowed, slower flash clock as the fix if marginal; U3 100 nF parts within 4 mm pad centre to pad centre; one via per USB line before the 27 Ω resistors. Open: dropping 90 Ω as a goal, and foreign vias through U3's exposed pad. Not yet applied to the .kicad_dru. |
| 2026-11-04 | Relaxation 7 rejected: no signals through U3's exposed pad | User decision: the ground pad is one solid pad, and soldering over many small pads with signals between them is not acceptable. Reverses the 2026-11-02 row that tiled exposed pads round foreign vias. User confirmed it covers U1, U2 and U5 too and asked for a reroute, overriding the earlier choice of y61/y62; y62 stays on disk for comparison. User also accepted dropping 90 Ω USB impedance as a goal (relaxation 5). Measured on y62 (vias inside each pad's outline; copper by raster): U1 24 foreign, 16 GND, 54% copper; U2 21 foreign, 16 GND, 50%; U3 3 foreign, 9 GND, 89%; U5 2 foreign, 2 GND, 73%. No tile has a paste layer. y62 fails this rule on all four. |
| 2026-11-04 | Solid exposed pad reroute started: c-solid-z6 running; z5's first try failed on a full disk, and its rebuild z7 was stopped at 01:48 by a queue stop signal, exit 143, cause unknown | board.py knob solid_ep: one solid pad on U1, U2, U3 and U5, footprint paste windows kept, build stops if a foreign via lands in a pad. From exp/y45.json without ep_cathodes or ep_prune, stub_rings up to 3.6 mm. z5 has 16 GND vias on U1 and U2, z6 has 9 (a relaxation, labelled for comparison). Both have U3 9 and U5 2 (U5 asked for 4; only 2 fit). Rules: XIN, XOUT and Net-(C24-Pad1) max 11 mm, USB_DM and USB_DP one via. Pre-route DRC errors are silk and text only; placement_check passes. z1 to z4 are failed builds, kept. The library's pads on U1, U2 and U3 were separate rectangles with gaps, not one pad. Paste windows cover 4.0 of 29.2 mm² on U1 and U2 and 4.84 of 11.6 on U3: to review before release. |
| 2026-11-04 | First solid-pad routes: z6 51 signal, 4 plane, 6 errors, 870 vias; z7 56 signal, 2 plane, 4 errors, 882 vias | KiCad's judge, 3000 s, deadline hit. Most opens have an LED end over a chip body. Straight F.Cu stubs from those pads (z9) about half fail and give crossing and hole clearance errors. Agent crunch-solid takes it from here, reporting in design/study/crunch/solid/report.md. |
| 2026-11-04 | Variant d: 5× IS31FL3745-CLS4-TR WLCSP-36 BGA LED drivers (C2678907), routed to 0 open and 0 DRC errors with solid exposed pads | User requested a BGA LED driver variant after QFN-60 solid exposed pads stalled routing. Five WLCSP-36 drivers (2.895 × 2.895 mm, 6 × 6 balls at 0.50 mm pitch, zero exposed ground pad, 8 SW × 18 CS = 48 RGB cells each, 5 × 47 = 235 RGB LEDs including D235) replace the two QFN-60 drivers, cutting driver footprint area from 98 to 41.9 mm² and scan peak current from 494 to 204 mA. Solid exposed ground pads enforced on U3 (11.56 mm², 9 GND vias, 0 foreign vias) and U5 (2.89 mm², 2 GND vias, 0 foreign vias); U3 +1V1 ring 1 piece (10.83 mm² union). Routed on 8 layers with through vias in ultraroute: 876 vias, 5,870 track segments, 0 locked copper, KiCad DRC 0 violations and 0 unconnected items (1 copper_sliver warning), pad_joints and pad_joints_fixed 0 thin joints, ERC 0 errors, sync_check/placement_check/nets_check PASS. Front sunflower seed web silk (99% kept) + 5 WLCSP A1 pin-1 dots + 58/104 tidy back designators (27/27 majors). Audit: design/parts/drivers-bga.md; viewer: viewer/round-pendant-d.html. | C2678772 IS31FL3235A (no scan matrix: 79 chips needed for 235 RGB); C2678908 IS31FL3746B (12 RGB/chip: 20 chips needed); C2874518 IS31FL3729 (QFN-40 with exposed pad, no BGA) |
| 2026-11-05 | Variant d copper cleanup, strict `.kicad_pro` DRC rules, and topological `copper_audit.py` gate | User inspection caught leftover partial-rip-up trace stubs, discontinuous trace joins, and narrow copper necks on Variant D. Root causes: (1) `.kicad_pro` had `min_connection = 0.0` and `connection_width`/`copper_sliver`/`isolated_copper`/`via_dangling`/`hole_to_hole`/`holes_co_located` set to `warning`; (2) KiCad's connectivity treats any `> 0 nm` same-net round-endcap overlap as connected and non-dangling, hiding 119 off-center via grazes (`.00/.25` escape vias vs `.x175/.x137` ultraroute grid), 22 cap-to-cap gaps, 25 mid-segment partial-rip-up stubs, 5 dangling stubs, 580 duplicate collinear sub-segments, 1 `In1.Cu` 10.8° V-notch sliver (`SW3_1`), and 1 `< 86 µm` morphological neck (`CS1_11`). Tightened `.kicad_pro` (`min_connection = 0.09`, all six severities promoted to `error`) and ran `scripts/bga/clean_copper_d.py` + `scripts/bga/copper_audit.py`: tracks reduced from 5,870 to 5,218 (876 vias), 0 defects across all 7 `copper_audit.py` categories, 0 `kicad-cli pcb drc --severity-all` errors or warnings, and 0 `pad_joints` / `pad_joints_fixed` thin joints. Re-exported `hw/round-pendant/d/fab/` Gerbers/BOM/CPL and rebuilt viewer. | KiCad DRC alone (misses same-net cap-overlap stubs and off-center via grazes) |
| 2026-11-05 | Keep `5× IS31FL3745-CLS4-TR` WLCSP-36 via JLCPCB Global Sourcing; WLCSP thermal margin verified | User decision: keep `IS31FL3745-CLS4-TR` (`C2678907`, ~2,078 at DigiKey / ~648 at Mouser via JLCPCB Global Sourcing, alongside `L1`) rather than switching to in-stock QFN-EP drivers (`4× AW20198QNR` QFN-40 or `6× IS31FL3729` QFN-32) whose solid exposed ground pads re-block LED anode vias. Why matrix drivers are mostly QFN-EP in general: single-chip signage/keyboard drivers sinking `300–600 mA` off `5 V` burn `0.8–1.5 W` in one package and target cheap 2/4-layer `0.15 mm` boards. Here, current is split across 5 spaced WLCSPs fed from LiPo `VSYS` (`3.7 V` nom, `4.2 V` full): at `300 mA` board total (`60 mA`/chip, mean `VF ≈ 2.53 V`), each `IS31FL3745` dissipates `0.10 W` (`100 mW`). At `θJA = 47.49 °C/W` (`is31fl3745.pdf` p. 5; flip-chip solder balls conduct directly from silicon into 8-layer `In2.Cu` `GND` + `In5.Cu` `VSYS` planes), local die-to-board rise is `4.7 °C` (`< 5 °C`) atop the `~80 °C` whole-board temperature (`~85 °C` vs `125 °C` operating / `150 °C` `TJMAX`, `40 °C` margin). | `4× AW20198QNR` (`C5137654`, `11.56 mm²` solid EP × 4); `6× IS31FL3729` (`C2940549`, `7.29 mm²` solid EP × 6) |
| 2026-11-05 | Variant e: front-side 12-o'clock top-rim `ALS-PT19` ambient light sensor added, routed & cleaned to `0` DRC errors/warnings | User requested the ambient light sensor on the front (`F.Cu`) top rim with the LEDs, keeping `5× IS31FL3745-CLS4-TR`. Placed `Q2` (`ALS-PT19-315C/L177/TR8`, `C146233`, `1.7 × 0.8 mm`) on `F.Cu` at `(-2.04, -18.04 mm, +6.0°)` tangent to the 12-o'clock bezel (`0.40 mm` pad-to-edge, `0.20 mm` courtyard to `D115`/`D116`, zero LEDs moved), powered from `U3.3` (`GPIO1` → `/MCU/LIGHT_PWR`, `0 µA` sleep draw) with `R43 = 22 kΩ` (`C25768`) and `C70 = 100 nF` (`C1525`, `τ = 2.2 ms`) on `B.Cu` directly behind `Q2` feeding `U3.41` (`GPIO27/ADC1` → `/MCU/LIGHT`). Routed on 8 layers in `ultraroute` and cleaned with `clean_copper_d.py`: `5,221` tracks, `879` vias, `0` locked copper, solid `U3.61` (`9` GND vias, `0` foreign) & `U5.17` (`2` GND vias, `0` foreign), `0` `kicad-cli pcb drc --severity-all` errors or warnings, `0` `copper_audit.py` defects, `0` `pad_joints` / `pad_joints_fixed` thin joints across `1,408` SMD pads, ERC `0` violations, and `sync_check`/`placement_check`/`nets_check` PASS (`332` BOM/CPL parts in `hw/round-pendant/e/fab/`). Audit: `design/parts/light-sensor.md`; viewer: `viewer/round-pendant-e.html`. | Back-side sensor (occluded by battery/neck); continuous `+3V3` collector tie (wastes sleep current under ambient light) |
| 2026-11-05 | 4-layer low-cost `25 × 70 mm` skewed-parallelogram variant family (`hw/parallelogram/p1-66..p4-264`) built, costed, and routed across 5 density tiers | User requested a low-cost 4-layer skewed-parallelogram variant family (`25 × 70 mm` tip-to-tip, `17.75°` skew, centered `20 × 35 mm` prismatic `802035`/`102035` LiPo pocket, zero BGA, solid `B.Cu` exposed ground pads, 100% locally in-stock JLCPCB PCBA BOM) spanning lower to higher LED density to find the empirical 4-layer routing ceiling. Selected Shanghai Awinic `AW20198QNR` (`C5137654`, QFN-40 `5 × 5 mm`, `3.4 × 3.4 mm` solid EP, `18 CS × 11 SW = 66` RGB LEDs/chip, JLC stock `6,055`, `$0.78`), Panasonic `EVQP7J01P` peg-less buttons (`C2828254`, stock `6,971`), and Newopto `XYC-PT19C-L1` top-bezel light sensor (`C2693594`, stock `25,206`). Routed all 5 tiers on 4 layers (`In1.Cu` unbroken solid `GND` plane, `In2.Cu` single inner signal layer, `0.30/0.15 mm` through vias, `0` foreign EP vias): `p1-66` (`6×11 = 66` LEDs, `$11.45` BOM / `$10.05` w/ `XL-1615RGBC` + `RP2040`) routes **`475/475` (`100.0%`, `0` open, `0` DRC errors/warnings, `0` `copper_audit` defects, `0` `pad_joints`, Gerbers/BOM/CPL in `hw/parallelogram/p1-66/fab/`)**; `p2-132` (`6×22 = 132` LEDs, `$14.06` BOM) hits the exact 4L knee at **`759/761` (`99.74%`, `2` open on `U2.10`/`U2.12`)**; `p3-162` (`9×18 = 162` LEDs, `$15.47` BOM) reaches `870/901` (`96.6%`, `31` open); `p3-198` (`9×22 = 198` LEDs, `$16.44` BOM) reaches `989/1,045` (`94.6%`, `56` open); `p4-264` (`12×22 = 264` LEDs, `$19.03` BOM) saturates at `1,190/1,329` (`89.5%`, `139` open) once column pitch (`2.55/2.02 mm`) drops below the `3.40 mm` solid QFN EP width. Study: `design/study/parallelogram/README.md`. | `0.45/0.20 mm` vias on 4L (`74` open on `p2-132`); `IS31FL3745` WLCSP (requires 8L + Global Sourcing) |
| 2026-11-05 | Variant f: RP2350 pin-to-decap links, DVDD fingers, LDO links and FB finger as locked tracks, not 0.2 mm zones | User spotted thin rectangular "pours" off the RP2350 3V3 that should be traces and didn't line up. Cause: `u3fix.py` drew each link as two butted rectangular zones so it would survive autoroute's `--strip`; `reserve_escapes.py`'s keepout list skipped `IOVDD`, so 5 locked LED escape vias (plus one later) landed on them and the refill carved them (pin 11→C9 kept 32 % of its copper, pin 54→C13 split in two), and a +3V3 track split the FB finger, so FB sensed on the ring side (report-final.md had flagged this). DRC and unconnected stayed 0 through the In5 plane. Locked tracks survive `--strip` and are obstacles to every via planner; pin 54's path straightened to y 97.90 and finger 50 moved 0.06 mm to keep CS1_7/CS3_18's escapes; 10 nets rerouted locally (`scripts/variant_f/`). `copper_audit.py` gains STRIP_ZONE and ZONE_INTRUSION checks | Keep zones plus a keepout per strip: still square-ended joints, still invisible to DRC |
| 2026-11-05 | Variant f: no direct track from IOVDD pins 11 and 54 to C9 and C13; they decouple through the In5 3V3 plane | With a real 0.2 mm track beside each pin, `via_sites.py` finds no legal escape via site for CS1_7/CS3_16 (pin 54) or CS3_5/CS3_18/I2C_SDA (pin 11), and the router left 3 open whatever was ripped. E had the same electrical result after its vias cut those two zones. Asked the user (status.json `decap-11-54`) | Move C9/C13 or LED escapes (placement change, user's call); laser microvias (pending JLC quote) |
| 2026-11-05 | Parallelogram lower-density tiers (`p1-66` & `p2-132`): swapped RGB LED from `XL-1010RGB-YG` (`C965834`) to `XL-1615RGBC-RF` (`C965840`) — both now `100%` routed & `0` DRC on 4 layers; compiled `ultraroute` notes | User requested swapping the lower-density 4-layer parallelogram boards (`p1-66`, `p2-132`) to `XL-1615RGBC-RF` (`1.6 × 1.5 × 0.6 mm`, `C965840`, `718k+` in JLC stock, `Pin 2 = Anode, 1 = R, 3 = B, 4 = G`, CPL rotation `180°`; audit: `design/parts/leds-xl1615.md`) while keeping `XL-1010RGB` on 9–12-column `p3-162..p4-264`, and sending compiled `ultraroute` UX/engineering notes upstream. Also replaced `RP2350` `0.24 mm` `IOVDD`/`FB` strip zones in `scripts/parallelogram/pcb_gen.py` with 17 locked `B.Cu` tracks and wrapped all 4 `vendor *` regulator zones in `.kicad_dru` rule areas (`0` `strip_zones`, `0` `zone_intrusions`). `XL-1615RGBC`'s `0.80 mm` horizontal intra-pad gap (`2.3×` wider than `XL-1010`'s `0.35 mm`) cut vias by `22–27%` (`467 → 343` on `p1-66`, `859 → 670` on `p2-132`), lowered qty-10 BOM to **`$10.61/bd`** (`p1-66`) and **`$12.60/bd`** (`p2-132`), and closed **`p2-132` from `2` opens (`99.74%`) to `761/761` (`100.00%`, `0` open)**! Both `p1-66` and `p2-132` pass strict `ERC = 0`, `kicad-cli pcb drc --severity-all = 0` errors / `0` warnings / `0` unconnected, `copper_audit.py = 0` across all 9 checks, `pad_joints.py = 0`, `sync_check = 0`, `nets_check --routed = 0`, with Gerbers/BOM/CPL/PDF in `hw/parallelogram/{p1-66,p2-132}/fab/`. Delivered `ultraroute` report to `design/ultraroute-requests.md` & `~/Software/ultraroute/docs/research/round-pendant-user-notes-2026-11.md` + repro bundle in `~/Software/ultraroute-lab/repro/round-pendant-parallelogram/`. | Keep `XL-1010RGB` on `p1-66`/`p2-132` (`$0.84–$1.46/bd` dearer, `12k` vs `718k` stock, `2` opens on `p2-132`); swap `XL-1615RGBC` onto `p3-198`/`p4-264` (`0.42–0.95 mm` alley crowds `9–12` columns) |
| 2026-11-05 | Variant g (attempt, not adopted): moving C9/C13 next to IOVDD pins 11/54 for real tracks leaves LED escapes unroutable; F stays the board | User asked to move C9 and C13 so they get real traces. C9 → (93.48, 92.20) 180° (pad 1 on pin 11's axis, 1.2 mm track; courtyard 0.03 mm off U3's) and C13 → (98.02, 98.08) 180° under pins 53/54 (1.28 mm track; no legal GND via under it — D19/D20 pads above — so 2.24 mm GND track to its old via). C13 there covers CS3_16's only escape from D135-4: KiCad DRC probing (`scripts/variant_g/probe_sites.py`) finds no legal via for it within 2 mm, and five router passes (kept, adopt/shove, neighbour unlock, 1.5 mm region unlock) left 2 open. C9 alone: CS3_4 (D104-4 to D103-4) loses its via site to C9 pad 1 and stays open after kept, adopt and region-unlock passes; no legal via within 2 mm of either pad once CS3_5/SW3_2/I2C_SDA are rerouted. Alternatives: move LED escapes/LEDs, shift R14/R15 ~0.5 mm down for C13, or laser microvias (JLC quote). Work files in `hw/round-pendant/g/route`, scripts in `scripts/variant_g/`. |
| 2026-11-06 | Sunflower family: 38 mm round, XL-1615 LEDs in a Vogel spiral, AW20198 QFN drivers, 4 layers (`hw/sunflower/`, study `design/study/sunflower/README.md`) | User asked for a cheaper, smaller round board using the parallelogram's low-cost LEDs and drivers in a sunflower pattern, and where 4 layers stop working; diameter first 32–35 mm, then set by the user at 38 mm. With vias allowed in pads (POFV), all four tiers reach 0 opens on 4 layers: 66 (1 driver, 0 DRC, $10.61 BOM @10), 88 (2 drivers, 0 DRC, $11.90), 110 (2 `+3V3` width errors left, $12.25), 132 (1 thin joint and 1 stub left, $12.60). With no vias in SMD pads (new `.kicad_dru` rule, no POFV), 88 reaches 0 opens and 66 is left with 1 open at U1. No tier chosen yet; fab price not quoted | Keep 8 layers and WLCSP drivers (Variant E/F, $26.46 BOM) |
| 2026-11-06 | Sunflower family: JST GH 1.25 mm battery socket (SM02B-GHS-TB, C189893) in place of hand-solder pads, at the north-west rim; front seed-web silk; PWR/BOOT/BATT +/- back labels | User asked for the main pendant's front silk pattern, button labels and a JST connector, and picked GH from PH/GH/SH. `jst_site.py` found clear courtyard only at the NW rim on every tier (the SE spot by U8 needs U8/C6/R8 moved), so the battery nets run ~30 mm. Local re-routes: s1-66-pofv, s2-88-pofv, s2-88 0 open and 0 DRC; s2-110 0 open (2 old +3V3 width errors); s2-132 2 opens left, second pass queued; s1-66 probe unchanged at 1 open. +$0.35/board. |
| 2026-11-06 | Sunflower battery socket: Molex PicoBlade 53261-0271 (C177225) in place of JST GH, at the north-west rim with the plug entering from the board-centre side | A reviewer flagged that the 1.25 mm plugs on most small LiPos are friction-fit PicoBlade clones, not latching GH. PicoBlade is wider (9.4 mm courtyard), so no rim-facing site clears every tier; the user chose NW with the plug facing in over moving U8/C6/R8 to the SE rim. Re-routes: s1-66-pofv, s2-88-pofv, s2-88 0 open and 0 DRC; s2-110 1 open, s2-132 2 opens; s1-66 probe 1 open. Connector cost +$0.12/board. |
| 2026-11-06 | Sunflower USB-C study (s2-110-usbc): HRO TYPE-C-31-M-12 on the back at the south rim, centre LED, light sensor at the top rim | User asked for USB-C on the back (dodging the LEDs) next to the battery socket if possible, buttons and socket at the top, an LED at the centre and the sensor at the rim. Next to the socket the receptacle lands on U3 at every angle, so it went to the south rim, where only USB-side parts move. Front LEDs steered round its 6 through-holes. Routed from scratch to 3 opens after four passes; VBAT_EN then moved from GPIO14 to GPIO28 (pin 42, beside VBAT_SENSE) for this variant only, as it would not route from the north edge of U3. No via-in-pad, so U2's PVCC caps moved 0.45 mm out to free its south pin escapes. A schematic bug that merged USB D+/D- into CC1 was fixed and re-routed. Final: 0 opens, 0 DRC, audits clean, 612 vias, fab files exported. |
| 2026-11-07 | s2-110-usbc bring-up pads and board ID straps; UART1 on GPIO24/25 | User asked for test pads on spare signals (UART, I2C, VBUS, spare GPIO) and board ID straps so firmware can tell boards apart. UART first went on GPIO8/9 with pads west of U3, but those pads blocked the west LED rows and ACC_SDA; the user chose to drop them and use GPIO24/25 (also UART1). ID straps on GPIO19-21, read with pull-ups, tied = 0: this board ties GPIO19 (net tie NT1) and reads 6; boards without straps read 7. Test pads use a 0.75 mm courtyard copy of KiCad's 1.0 mm pad to fit. Re-routed to 0 opens, 0 DRC, audits clean, 637 vias, fab files re-exported | UART on GPIO8/9 (would not route), resistor straps (extra parts), OTP board ID (per-unit step) |
| 2026-11-07 | s2-110-usbc: In1 LX cutout follows the VREG_LX copper instead of a bounding box | User spotted a rectangle missing from the inner GND plane at the 1V1 inductor. The cutout (chips/rp2350.md §6.3.8.1: cut layer 2 under the LX node) was the bounding box of U3 pin 48 and L1's LX pad plus 0.25 mm, which also took plane from under pins 46/47 and the PGND pour: 9.2 mm². Now the VREG_LX zone and LX pads grown 0.25 mm: 5.4 mm². Plane refilled, 0 DRC, audits clean, gerbers re-exported. | Keep the box (more plane missing than the datasheet asks); remove the cutout (datasheet asks for it) |
| 2026-11-07 | Parallelogram boards: In1 LX cutout follows the VREG_LX copper instead of a bounding box | Same fault as s2-110-usbc (the user asked for it fixed here too): the layer-2 cutout was the bounding box of U3 pin 48 and L1's LX pad, 9.2 mm², taking plane from under pins 46/47 and the PGND pour. Now the VREG_LX zone and LX pads grown 0.25 mm (5.4-5.5 mm²), in `scripts/parallelogram/pcb_gen.py` and on all ten boards in place (plane refilled, no copper moved). p1-66, p2-132 and both -usb boards stay at 0 DRC with audits clean; gerbers re-exported, BOM/CPL unchanged. On p3-162, p3-198 and p4-264 the old box covered the PGND tie vias, which now reach the plane as designed. | |
| 2026-11-07 | Sunflower family: pn-dense, a 38 mm round board with LEDs on a dense Penrose P3 tiling (hw/sunflower/pn-dense) | User asked for the pattern explorer's dense Penrose tiling on a round board. Cloned s2-110-usbc (USB-C on the back, centre LED, rim light sensor, test pads, PicoBlade, 2x AW20198, 4L) and took the LED field from the explorer's construction: Robinson-triangle deflation (level 4) of the ten-triangle sun, LEDs at rhomb vertices, scaled so the closest pair is the dense pitch hypot(1.6+0.25, 1.5+0.25) = 2.547 mm, cropped to r 17.2 mm, snapped to the 0.025 mm router grid (<=0.018 mm). Vertices in keepouts are dropped, not pushed, so the tiling stays exact: 4 dropped at the USB-C holes, 67 LEDs. The wedge matrix map now spreads n unevenly (<=11 per wedge) instead of requiring multiples of 11; front silk is the rhomb edges. Board ID strap GPIO20 (ID 5). Routed with route_variant.py plus one rip-region plough pass: 0 open, 0 DRC errors/warnings, copper_audit 0, pad_joints 0, 419 vias, none in pads. $11.75 BOM @10. | Push vertices out of keepouts (distorts the tiling); one driver (67 LEDs is one over AW20198's 66) |
| 2026-11-07 | pn-dense-1d: one AW20198 plus the centre LED driven directly from RP2350 GPIO7/8/9, anode on +3V3 (hw/sunflower/pn-dense-1d) | User chose to keep all 67 Penrose LEDs, drop U2 and drive one LED from GPIOs. The centre vertex (D67) takes GPIO7/8/9 (pins 10/12/13, the only three free adjacent pins) through R80 150 R / R81 510 R / R82 510 R; U1 drives 66 LEDs in 6 wedges of 11. Anode on +3V3 = IOVDD, so no pin can exceed IOVDD in any state (rp2350.pdf Tables 1426/1433/1436); VSYS was rejected because a floating pin's voltage depends on LED leakage the datasheet doesn't give. Green/blue at ~1.07 mA at 100 % PWM (matrix average: 400/30k x 255/256 x 0.0805, aw20198 p. 18); red runs at a ~8 mA peak and is matched by PWM duty (13 % for average current, ~20 % for brightness) because xl-1615 p. 6 shows red dark below 5 mA. Firmware: 12 mA drive, pins high early in boot. Routed 0 open; clean_copper_4l.py wrongly deleted one CS1_7 run, which was restored from the router output (plus 3 small joint fixes); 0 DRC errors/warnings, copper_audit 0, pad_joints 0, 528 vias, $10.81 BOM @10 (-$0.94). | Anode on VSYS (headroom, but pin voltage can't be bounded when floating); drop one LED (user declined) |
| 2026-11-07 | Square-bezel bga13-169: more router time does not close it | Re-ran route_variant.py with 3 seeds x 1800 s (was 1 x 960 s): seeds 0/1 gave 56 and 55 open (previous best 50); the run was then stopped for low machine memory. Opens cluster on driver CS lines at the WLCSP-36s behind the array, so the limit is the 0.5 mm-pitch ball escape under a 1.65 mm LED grid, not search time. Board file restored to its pre-run state; the viewer shows the earlier 50-open plough. Next step is the user's choice (status.json square-bezel-escape). | Keep adding seeds/time |
| 2026-11-08 | s2-110-usbc: Bottom-side CPL rotation & EasyEDA pick-origin fix (`scripts/sunflower/export_and_cost.py`); stale `production/` moved aside | Phase 10 CPL audit caught that `export_and_cost.py` computed `(rot_kicad + rot_off) % 360` without Bottom-layer mirroring `(180 - rot_kicad + rot_off) % 360` or EasyEDA pick-origin offsets (`BT1` `+0.950 mm` Y, `J1` `+1.571 mm` Y), leaving `BT1` (`70°` vs `110°`), `J1` (`180°` vs `0°`), `U1/U2`, `U4`, `Q1`, `U9`, and `SW1/SW2` mis-rotated/shifted in `cpl-jlcpcb.csv`. Fixed `export_and_cost.py`, re-exported `hw/sunflower/s2-110-usbc/fab/`, verified all 191 parts against all 34 LCSC EasyEDA models (`0.000 mm` centroid error, `0.00°` rotation error; `design/renders/sunflower-s2-110-usbc/cpl-check-{top,bottom}.png`), and moved the stale 01:37 2026-11-07 KiCad Fabrication Toolkit folder to `hw/sunflower/s2-110-usbc/production-stale-2026-11-07-0137/`. | Hand-fix CPL CSV (violates `sync-and-release.md`; other Sunflower tiers also share `export_and_cost.py`) |
| 2026-11-08 | s2-110-usbc gate reviews: 4 reviewer claims disputed with datasheet/footprint proof (`Q2` polarity, `U8` split-EP bars, `U8` `B.SilkS` dot, `BT1–SW2` clearance) | (1) `Q2` (`XYC-PT19C-L1`, `C2693594`): `xyc-pt19c-l1.pdf` p. 8 mislabels phototransistor leads "Anode/Cathode", but internal die-paddle leadframe geometry vs `als-pt19.pdf` p. 3 and EasyEDA `C2693594` confirms Collector = Pin 1 (`Mark` side, `LIGHT_PWR`) and Emitter = Pin 2 (`LIGHT`), matching `mcu.kicad_sch`. (2) `U8` (`XB9901A`): `XySemi_DFN-6_1.8x1.4mm.kicad_mod` merges `nc` pins 2/3/5 into the `1.30 × 0.28 mm` (`GND`) and `0.79 × 0.28 mm` (`BAT_N`) exposed bars per `xb9901a.pdf` p. 9. (3) `U8` `B.SilkS` dot: at `180°` on `B.Cu`, Pin 1 sits at bottom-left right beside the `B.SilkS` dot (`cpl-check-bottom.png`); only the `.wrl` 3D dot is `180°` off (as noted 2026-11-03). (4) `BT1 ↔ SW2`: true `pcbnew` `B.Fab` clearance is `1.017 mm` (`0.898 mm` to `SW2` pad); regenerated `floorplan-s2-110-usbc.svg` from exact `B.Fab` vertices. | Rewire `Q2`/`U8` or move `BT1` for non-existent collisions |
| 2026-11-08 | s2-110-usbc `Rev S3C` prototype waivers for Gates 1–3 (`sch_gen.py` style, `C35 = 100 nF`, `BT1` `MP` nails, `_C`/`_MCU` & `Net-(...)` names) | Frozen routed `Rev S3C` schematic/PCB kept at `0` ERC / `0` DRC / `0` parity errors by waiving: (a) `sch_gen.py` programmatic LED grid, 24.3 mm `USB_D*_C` label jump, and `U3`/`U5` stacked power pins (`schematic_style_check.py`); (b) shared `C35 = 100 nF` on CMOS `LED_SDB` (`GPIO6`, `R31 = 100 kΩ` pull-down) vs `1 µF/chip` example; (c) `BT1` `Conn_01x02` leaving mechanically isolated `MP` nails un-netted (`Molex 53261` rated `1.0 A` in `PS-51021-024`); (d) `_C`/`_MCU` diff-pair suffixes and `Net-(...)` names (clean up in `Rev S3D`); and (e) passive/family-ID rows in `sources.csv` (all 34 LCSC parts verified normal lifecycle & in stock via `jlc_parts.py show`). | Edit schematic symbols/labels now (desynchronizes frozen `Rev S3C` PCB) |
| 2026-11-08 | s2-110-usbc phase gates 0–10 completed (`design/gates/sunflower-s2-110-usbc/`); `Rev S3C` prototype order vs `Rev S3D` respin awaits user sign-off | Gates 1–3 `passed`; Gates 0, 4, 10 `awaiting_signoff`; Gates 5–9 `failed` on frozen `Rev S3C` and Gate 10 Gerber review added 1 PCBA catch (`sunflower-B_Paste.gbp` omits paste on `J1`'s 4 PTH shield slots while `F.Cu` rings sit `0.18–0.29 mm` from `D10`/`D104`/`D110`, forbidding `F.Cu` wave/iron soldering): `COUT` (`C18`, `Zone 11`) has `0` power spokes so core `+1V1` flows via `U3.50` `VREG_FB`; `C17` (`CFILT`) shares `U3` `PGND`'s single via `@(102.43, 99.10)`; `In2.Cu` routes `+3V3` `ADC_AVDD` & `VSYS` `0.21 mm` under `B.Cu` `VREG_LX`/`L1` (`19–48 mV_pk` spikes) while `LX cutout L2` sits on `In1.Cu`; `+3V3` band splits into 4 pieces (`9.7561 mm²`) vs whole `+1V1` ring (`6.0625 mm²`); `U3.61` (1) & `U5.17` (2) open vias clip `B.Paste`; `U4.8` is `8.56 mm` from `C14` (`312–554 mV` 4-bit QSPI SSO droop); `BT1` has 29 vias in Molex restricted area + `0.107 mm` `VBAT` via to `BT1.2` + `438 mΩ` PCB battery loop; `.kicad_pro` has `netclass_assignments: null`; and `BT1` `+`/`-` & `J1` `USB 5V` silk are occluded under connector bodies. User chooses at Gate 10: order 5–10 `Rev S3C` prototypes (`ENIG 1U"`, `Pass 1 = B.Cu`, `Pass 2 = F.Cu ≤ 245 °C` for `Q2`, no `F.Cu` soldering on `J1` + microscope `B.Cu` outer-slot tacking, `Kapton + ≥ 2.4 mm` spacer, and FW guards: `1x/2x` SPI XIP, `ADC4` `GCC ≤ 105` battery / `≤ 9` CC / `≤ 24` CV on `PGOOD == 0 \|\| CHG == 0`, `GPIO4/5` `12 mA` + `GCR = 0xB9`), or spin `Rev S3D` first (incl. full-SMT `TYPE-C-31-M-22` `C530612`). | Mark Gates 5–10 passed without fixing copper or user sign-off |
| 2026-11-08 | Parallelogram `p2-132-usb6` (`hw/parallelogram/p2-132-usb6/`): two peg-less `EVQP7J01P` side buttons added on the West long edge (`SW5` `USER_C` on `GPIO9`, `SW6` `USER_D` on `GPIO0`), `J1` untouched, routed to `0` open & `0` DRC | User asked for two more side buttons near each end of one long (`62 mm` vertical) edge of `p2-132-usb` with everything else — explicitly including `J1` at `(-1.24, +26.82 mm, 162.26°)` — kept as-is and all existing variants byte-identical. **Why West edge (`x = -12.50 mm`):** the East South edge is occupied by `BT1` (`(+8.40, +20.05)`), `U8` (`(+10.00, +12.60)`), and SE wing `SW4` (`(+9.15, +28.65)`), whereas the West edge is clear at both ends outside the `[-10.0, +10.0] × [-21.5, +13.5] mm` LiPo pocket: `SW5` at `(-10.85, -22.00, +90°)` (`0.31 mm` courtyard south of `SW3`, `13.31 mm` north of `SW2`) and `SW6` at `(-10.85, +22.80, +90°)` (`1.81 mm` rotated-courtyard clear of `J1`, `2.91 mm` clear of `U4`), both protruding `0.45 mm` past `x = -12.50 mm` like `SW1`/`SW2` (`CPL Rot = 90.00°`, `Mid X = 88.825 mm`). Wired `SW5 -> R46 (1 kΩ) + C71 (100 nF) -> /MCU/USER_C (GPIO9, U3.13)` and `SW6 -> R47 (1 kΩ) + C72 (100 nF) -> /MCU/USER_D (GPIO0, U3.2)` (`>= 20 ms` press+release SW debounce; `-92.69%` `8 kV` ESD clamp current with `350 V` `0402` air-flashover in `design/sim/p2-132-usb6/`). Routed (`route_variant.py`) & polished (`clean_copper_4l.py`): `795/795` pad connections (`0` open), `4,921` tracks, `729` vias (`ENIG 1U" + POFV = Yes`, `0` EP paste overlaps across `U1=5, U2=5, U3=5, U5=2`), `0` `kicad-cli pcb drc --severity-all --schematic-parity` errors/warnings/parity, `0` ERC errors, `copper_audit.py = 0`, `pad_joints.py = 0`, `plane GND` (`1,309.17 mm²`) / `RP2350 ring` (`8.61 mm²`) / `RP2350 band` (`11.06 mm²`) each `1` piece, `0` foreign EP vias, `$13.25` BOM @ qty 10 (`40/40` rows in JLCPCB PCBA stock), and `p2-132-usb` + `p1-66-usb` proven `100%` byte-identical in scratchpad regeneration. | East long edge (collides with `BT1`, `U8`, and `SW4`); peg switches `EVQP7C01P` (drills punch into `F.Cu` LED matrix) |
| 2026-11-08 | `p2-132-usb6` gate review dispositions (`design/gates/parallelogram-p2-132-usb6/phase4..10.md`): `LX cutout L2/L3`, `POFV = Yes`, inherited parent placement & 4L autorouted `VSYS` nodal proof, solid `B.Cu` zone ties, and `B.SilkS` policy | (1) **Regulator keepouts (Gate 5):** Added `LX cutout L3` (`no_tracks, no_pour`) on `In2.Cu` `0.21 mm` directly beneath `B.Cu` `VREG_LX`/`L1`, while retaining the shaped `5.43 mm²` `In1.Cu` `LX cutout L2` (`plane GND` stays `1` unbroken `1,309.17 mm²` piece) per `chips/rp2350.md` §6.3.8.1 and the 2026-11-07 user decision. (2) **`POFV = Yes` & `0` EP paste overlap (Gates 6, 7, 9, 10):** `non_ep_via_in_pad = 118` (`75` `F.Cu` LED pads + `43` `B.Cu` IC pads vs `134` on `p2-132-usb`) is ordered with **`POFV = Yes` (epoxy-filled & copper-capped VIPPO) + `ENIG 1U"`** per `design/study/parallelogram/README.md` §2 (providing planar capped vias under SMD pads and `F.SilkS` web), and `U2`'s redundant 6th EP via `@(106.036, 91.435)` was dropped so `0` EP vias touch `B.Paste`. (3) **Inherited parent placement & 4L `VSYS` topology (Gates 6, 7, 8):** Disputed moving parent `p2-132-usb` parts (`C17, C1/C2/C5, C30..C44, Y1, BT1`) per explicit task rule (*"Everything else stays as it is"*); all `33/33` decouplers pass `placement_check.py` (`1.17–3.56 mm`), `USB 2.0` FS (`18.63 mm`) is `< 0.15 × l_crit`, and an exact `pcbnew` `VSYS` resistive nodal solve (`sim_buttons.py`) proves `ΔV(U6.4) = -60.72 mV` and `ΔV(U1.5) = -114.50 mV` at the `300 mA` wearable budget (`GCC <= 0x74`, `V(U6.4) = 3.437 V >= 3.42 V` at `V_BAT = 3.55 V`; guarded in `bringup.md` §3 with `SRCR = 0x07` & `SLEWFAST = 0`). (4) **Solid `B.Cu` zone ties & shared `checks.toml` (Gates 5, 9):** Retained `ZONE_CONNECTION_FULL` on `B.Cu` `RP2350` rings/EPs (`plane GND` is internal `In1.Cu` reached via necked traces), and kept `F.Cu` LED text/dots hidden per `intent.md` line 98 while placing `37` `B.SilkS` texts (`[0.0°, 90.0°]`, contiguous 3-col URL, `16/20` major refs, `0` passives) + `12/12` `B.SilkS` pin-1 dots outside 3D bodies (`0` non-LED `silk_check` errors). | Move parent `p2-132-usb` parts (violates task scope); remove `In1.Cu` `LX cutout L2`; edit shared `checks.toml` mid-run |
| 2026-11-08 | Round Pendant `f-usbc` (`hw/round-pendant/f-usbc/`, `Rev FU`): full-SMT USB-C (`TYPE-C-31-M-22`, `C530612`) added to 8-layer Variant F via local southern rip-up & `ultraroute` re-route (`0` LEDs moved, `147/147` locked RP2350 tracks untouched) | Replaced `J1` (`USB_Pads` at `(100.0, 116.5)`) on Variant F (`Ø38.0 mm`, `1.00 mm` `JLC08101H-1080` 8L ENIG + POFV) with Korean Hroparts `TYPE-C-31-M-22` (`C530612`, 16-pin full-SMT, 4 SMD gull-wing shell pads) on `B.Cu` at **`(107.787, 110.926) mm`, `KiCad rot = -156.05°`** (pointing `23.95°` E of S, `8.35°` non-radial skew from mouth midpoint `(109.865, 115.606)` at `32.30°` E of S): at due South `(100, 113.5, 180°)` the `5.78 mm`-spaced `Ø0.65 mm` NPTH pegs hit front LEDs (`< 0.08 mm`), whereas at SSE `-156.05°` both NPTH holes thread `{D234, D235, D231, D226}` and `{D76, D66, D74, D64}` with **`0.220 mm` / `0.220 mm`** `F.Cu` LED-pad clearance (`0.214 mm` to `CS2_12`, `≥ 0.201 mm` on all inner/bottom layers, **`0` front LEDs moved**). Datasheet `type-c-31-m-22.pdf` p. 1 & STEP confirm `2-Ø0.50 mm × 0.70 mm` plastic pegs terminate **`0.30 mm` below `F.Cu`** on the `1.00 mm` PCB; `parallelogram`'s verified `2.30 × 1.80 mm` `S1` pads (`16.56 mm²` total `S1` area = `92%` of `2.50 × 1.80 mm`, `+0.27 mm` heel/toe fillet beyond the `1.48 mm` stainless foot) preserve **`≥ 0.205 mm` `hole_clearance`** to `6` fixed front-LED escape vias (`CS5_17, CS5_16, SW2_3, CS2_18, SW2_6, CS2_10`). Only `8` southern `B.Cu` parts (`BT1, U7, U8, C1, C6, R5, R8, TP3`) moved inside a `195 mm²` crescent (`85.6%` of F's copper verbatim, `147/147` locked RP2350 tracks & `9/9` zone piece counts intact): **`0` unconnected, `0` DRC violations (`2` inherited `U3` pin 42/43 `{slash}` parity strings), `0` `copper_audit` routing/strip defects, `0` thin pad joints, `5,555` tracks, `886` vias (`+10` vs F), `$26.62` BOM @10 (`+$0.36` vs F `$26.26`)**. | Move front LEDs at due South (violates zero-LED-move goal); through-hole `TYPE-C-31-M-12` (`1.28 mm` PTH stakes pierce `1.0 mm` front LED array); widen `S1` to `2.50 mm` (violates `0.200 mm` `hole_clearance` to `6` fixed LED vias) |
| 2026-11-08 | `round-pendant-f-usbc` gate review dispositions (`design/gates/round-pendant-f-usbc/phase4..10.md`): parent Variant F copper/rule parity, `U7`/`U8`/`R1–R2` southern placement, SI/crosstalk waivers, `≤ 0.51 W` worn thermal ceiling, and `B.SilkS` waivers | (1) **Gate 5 (`B1, B2, M3, M4`):** Added a 2nd parallel `0.30/0.15 mm` `VBAT` via (`(100.860, 115.700)`) and verified `0.30 mm` `In3.Cu` internal conductor ampacity (`> 0.8 A` plane-cooled `0.076–0.17 mm` between `In2.Cu GND` and `In5.Cu VSYS` per IPC-2152 vs `0.34 A` max continuous / `0.297 A` charge; widening `In3.Cu` beyond `0.30 mm` violates `0.200 mm` `hole_clearance` to adjacent matrix vias); disputed hiding `U3` pin 42/43 `{slash}` schematic-parity strings per explicit prompt rule (*"name them, don't hide them"*); retained inherited Variant F `.kicad_pro` unused class templates (`SW_SCAN`/`BATTERY`/`USB_POWER`), northern `0.09 mm` QSPI escapes, and `3× 0.20/0.10 mm` `U3` perimeter vias (`status.json` `jlc-8l-quote`). (2) **Gate 6 (`MAJOR-1..3`):** Moved `USB_DM_C`'s `1.10 mm` `F.Cu` hop to `In6.Cu` (`0` unclamped `F.Cu` USB copper), added a 2nd parallel `GND` via (`(102.470, 110.730)`) inside `J1.S1` NW's `2.30 × 1.80 mm` copper pad (`dist = 0.000 mm`) alongside `(102.126, 110.639)`, and bridged `U8.1..3` into a 2nd `0.30/0.15 mm` `GND` via (`(97.017, 114.689)`); proved via an exhaustive 8-layer `0.25/0.15 mm` via scan that **zero legal TH via pockets exist anywhere within `2.00 mm` of `U7.2` `(100.475, 113.245)`** (e.g. `(100.68, 112.75)` collides `-0.027 mm` with fixed `D91.3` on `F.Cu`, `-0.112 mm` with `U7.1` on `B.Cu`, `-0.034 mm` with `SW2_1` on `In1.Cu`, and `+0.031 mm < 0.090 mm` with `CS2_13` on `In3.Cu`), so `U7.2`'s `2.21 mm` narrow `B.Cu` stem into `J1.S1` (`L_shield ≈ 1.09 nH` to USB cable shield; `L_eff ≈ 1.39 nH` into `In2.Cu GND`) + two-stage **`R14/R15 = 27 Ω`** series isolation (`I_U3,pk ≈ 2.4 A < 1 ns`) + `C1 = 1 µF` `1.78 mm` from `U5.13` is optimal without moving front LEDs; justified keeping `U8` at `-90°` (**`0.300 mm` CAD copper/`B.Mask` gap** = **`3.0×` JLC's `0.10 mm` ENIG dam min**, `~0.20–0.22 mm` physical LPI web, reinforced by mandatory temporary Kapton masking over `U8` during `BT1` wire soldering + pre-power `BT1.2 ↔ TP8` ohmmeter check in `bringup-f-usbc.md`, avoiding displacement of `R1/R2/C41/C42`), and keeping `R1/R2` at Variant F's SSW coordinates per minimum-displacement rule (`CC1`/`CC2` are `0 Hz` DC `5.1 kΩ` sense lines). (3) **Gate 8 (`MAJOR-2..4`):** Upgraded `si_audit.py` with point-to-point USB skew (`Orient. A = 2.64 mm / 17.5 ps`, `Orient. B = 3.74 mm / 24.7 ps`), exact `U7.2` Y-network inductance (`1.09 nH` shield / `1.39 nH` `In2.Cu`), Gauss-Seidel nodal DC IR drop (`VBUS = 4.44 mΩ @ 60 °C`, `VBAT = 55.01 mΩ @ 60 °C`), Shapely `unary_union` crosstalk scan, and `θ_BA = 32.4 / 49.5 °C/W` thermal model; waived inherited Variant F northern couplings (`U2-RSET ↔ I2C_SCL` `< 5 ns` during `I2C` burst, `/MCU/RUN` `-0.38 V` vs `-2.31 V` `VIL` margin, `In6.Cu` under `Y1` `12 mV` vs `±2500 ppm` USB FS tolerance, and `VBAT_SENSE` `C7 = 100 nF` `31.8 Hz` filter); established **`≤ 0.51 W` continuous worn thermal ceiling** (`1.26 W` short burst only) with closed-loop `ADC4` foldback (`42 °C` charge / `47 °C` wear) and LED blanking on `~CHG == 0`. (4) **Gate 9 (`MAJOR-2, MAJOR-4, MAJOR-5, MINOR-1, MINOR-2`):** Placed all `13/13` `B.Cu` + `Q2` `F.Cu` `OD = 0.30 mm` pin-1 dots strictly outside courtyards/3D bodies, restricted `B.SilkS` to `0° / 270°` (`90° CCW`) draw rotations, placed `'+'`/`'-'` directly north of `BT1.1`/`BT1.2` clear of `U8`, enabled `(subtractmaskfromsilk yes)`, generated collision-free `342/342` assembly maps (`render_assy_clean.py`), printed `TP2, TP4, TP5, TP8` on `B.SilkS` while mapping via-crowded `TP1, TP3, TP6, TP7` on `assembly-bottom.pdf` with leader lines (`0` `[silk-over-via]`), and waived multi-character `'BAT'`/`'3V7'` beside `BT1` (`886` vias leave zero `≥ 2.4 mm` via-free pocket within `9.25 mm` of `BT1`), full `'round-pendant'` / repo URL / `CERN-OHL-P-2.0` strings (no unbroken `9–22 mm` `B.SilkS` corridor), and inherited Voronoi silk over epoxy-filled capped POFV vias. | Rip up northern Variant F copper (violates local reroute scope); alter `U3` pin 42/43 names to hide `{slash}` parity |
| 2026-11-09 | `parallelogram-p2-132-usb6` Option 1 SE battery/switch revision ("move the switch") & fresh-context Release Audit resolutions (`hw/parallelogram/p2-132-usb6/`, `design/gates/parallelogram-p2-132-usb6/`) | **Option 1 placement & local SE reroute:** Rotated right-angle battery socket `BT1` (`CJT A1251WR-S-2P`, `C225111`) `90°` CCW from `(+8.40, +20.05, +90°)` to **`(+7.97, +23.00, 0°)`** (`CPL = 180.00°`) so its mating mouth (`y = +20.70`) faces straight North (`-Y`) toward the LiPo pocket with **`6.03 mm` unobstructed plug-entry runway** to `0402` `R8` (`7.20 mm` to `U8`), eliminating the old `1.28 mm` tilted-plug gap to `U5`; shifted SE push button `SW4` (`TS-1187A`, `C318884`) into the SE acute corner at **`(+8.15, +30.55, 162.26°)`** (`CPL = 17.74°`, parallel to `J1` and the `17.74°` South bezel) and relocated only `C1` `(+2.65, +23.65, 180°)`, `R5` `(+5.70, +16.95, -90°)`, `R45` `(+10.70, +27.10, -90°)`, `TP1` `(+6.25, +14.30)`, and `TP3` `(+6.55, +12.19)` (`0` IC moves, `0` front LED moves; `5,416` tracks, `719` vias, `0` DRC/ERC/copper_audit/pad_joints/parity, sibling `p2-132-usb`/`p1-66-usb` `100%` byte-identical). **Release audit resolutions & waivers:** (1) Upgraded `C71`/`C72` from `16 V` `C1525` to **`C307331`** (`CL05B104KB54PNC`, `100 nF 50 V X7R`, `21.98M` stock, `$13.26` BOM @10, `41/41` BOM rows in JLCPCB PCBA stock) with nonlinear Class-II DC-bias ESD modeling (`450 V` `0402` sparkover, `13.65 V` clamped / `17.38 V` OC `< 50 V`, `36.35 V` margin); waived adding new caps/TVS to inherited `p2-132-usb` switches `SW1..SW4` (`1 kΩ` series resistors; `SW2` shares `/MCU/QSPI_SS` and cannot accept `100 nF`). (2) Mandated **`JLC04161H-7628` + `ENIG 1U"` + `POFV = Yes` (IPC-4761 Type VII)** across all docs (`164` via-in-paste overlaps across `89` `F.Paste` + `75` `B.Paste`, disclosing JLCPCB's `~$70–$95` 4L `POFV` bare-PCB lot surcharge vs 6L free promo) and split `--excellon-separate-th` drills (`719` PTH + `2` NPTH). (3) Documented `18.76 mm` clear lateral span between `1.55 mm` max `SW1`/`SW2`/`SW5` `EVQP7J01P` bodies (`<= 18.0 mm` cell on `1.0 mm` tape OR `>= 1.8–2.0 mm` VHB/foam standoff for `20 × 35 mm` `602035`), `>= 30 ms` (`6τ`) `VBAT_SENSE` wait + `RP2350-E9` `IE=0, PDE=0` + 50/50 `1.25 mm` LiPo harness polarity check in `bringup.md`, realistic still-air wearable thermal ceiling **`0.541 W` (`GCC <= 0x40`, `33.3 °C/W`, `<= 43.0 °C`)** + `ADC4` foldback on `0.95 W` handheld bursts + mandatory `AW20198` analog `GCC` scaling across the full `273.8–370.3 mΩ` upstream battery path (`+ 3.0 mΩ`/via) at `V_BAT = 3.50 V`, `11` native `fp.Reference()` `B.SilkS` designators + **`8/8` TP labels** (`VSYS`, `VB`, etc.) + collision-free `133/133` `F.Fab` & `98/98` `B.Fab` `assembly-{top,bottom}.pdf` + `fab/schematic.pdf`, synced `.kicad_pro`/`.kicad_dru` (`8` netclasses, `0` orphans) into `route/preroute_4L.*`, and waived inherited 4L northern `C11` (`2.99 mm`)/`C41` (`2.67 mm`) `GND`-via traces, lumped-regime `19.67 mm` USB FS `0.10 mm` escapes/`2–3` vias (`0.105 ns << 4 ns`), and unlocked post-autoroute copper (frozen by `0`-violation DRC + `copper_audit`). | Keep `BT1` at `+90°` (`1.28 mm` tilted-plug gap to `U5`); Option 2 Westward shift (moves `U5`/`U7`); modify inherited `SW1..SW4` circuits or northern `p2-132-usb` copper |
| 2026-11-09 | Round Pendant `f-usbc-rtc` (`hw/round-pendant/f-usbc-rtc/`, `Rev FUR`): inward-facing `1.25 mm` battery socket (`BT1`: CJT `A1251WR-S-2P`, `C225111`) + East I2C1 Real-Time Clock (`U13`: Seiko Epson `RX8130CE:BB`, `C1542426`) on 8-layer `f-usbc` (`0` LEDs moved, `147/147` locked RP2350 tracks intact) | **Architecture & placement:** (1) Replaced `BT1` wire pads with right-angle 2P SMT `CJT A1251WR-S-2P` (`C225111`, `$0.09/bd`) on `B.Cu` at SW **`(89.200, 110.550) mm`, `KiCad rot = -28.00°`** (`CPL = 208.00°`), facing **inward NNE (`+28°` E of N)** with **`4.884 mm` nominal (`4.649 mm` min) flat plug-insertion runway** to `0.80 mm`-tall `U4` (`5.845 mm` to `C22`; `3.20 mm` housing matches `J1`'s `3.16–3.26 mm` shell for `0 mm` added stack thickness, `0.00 mm` rim overhang, `15.16 mm²` total `B.Cu` solder area), shifting `Q1, R9..R12, C7, R1, R2` into the vacated 6-o'clock South pocket and `U8, C6, R8, TP3` immediately SE of `BT1`. (2) Added `Seiko Epson RX8130CE:BB` (`C1542426`, `$0.72/bd`, `3.2 × 2.5 × 1.0 mm` `SMD-10P`, built-in `32.768 kHz` crystal, `0x32` on `400 kHz` `I2C1` alongside `U9 LIS2DW12` `0x19`) in the vacant East `B.Cu` pocket at **`(114.750, 101.200, 0.00°)`** (`CPL = 180.00°`, `0` existing parts moved) powered from always-on `+3V3` (`VIO = VDD = VBAT = +3V3` per `ETM50E-10` §4.2 EX7, `1.50 µA` typ with `FOUT = OFF`, `POWMAN` `PWRUP2` wake on `U3` Pin `31` `GPIO19` via `R32 = 100 kΩ`, `C75 = 100 nF`, `C76 = 1 µF`) with locked `B.Cu` rule area **`RX8130_xtal_end`** (`[114.30..115.20, 102.30..103.05] mm`, `0` intrusions) under the Pin `1–10` `*1` crystal inspection short side (`ETM50E-10` Fig. 9 p. 11). **Routing, release & waivers (`5,883` tracks, `918` vias, `0` DRC/ERC/copper_audit/pad_joints, `$27.44` BOM @10):** (1) **Under-`BT1` planar POFV vias:** `13` fixed front-LED escape `0.25/0.15 mm` vias + `1` `0.10 mm` `SW1_4` segment sit under `BT1`'s thermoplastic base (`Molex 53261` restricted area vs `CJT A1251` open land pattern); justified because `JLC08101H-1080` uses **`POFV = Yes` (planar copper-capped vias) + `100%` LPI `B.Mask` tenting** (`0` `B.Mask` and `0` `B.Paste` openings under `BT1`, `0.25 mm` contact standoff). (2) **`RTC_INT` & southern crosstalk:** `10` active-display `CS4_*`/`SW4_*`/`I2C_SCL` crossings over `/MCU/RTC_INT` are `0 V/ns` (`0.00 V` coupled noise) in `POWMAN` sleep and `< 0.21 V` (`<< 1.32 V` margin) awake; `VBAT_SENSE` is filtered at `31.8 Hz` by `C7 = 100 nF`. (3) **`B.SilkS` & order notes:** `14/14` outside-courtyard `OD = 0.30 mm` `B.Cu` pin-1 dots, `0° / 270°` only, mouth-aligned `'+'` `(89.60, 106.90)` / `'-'` `(91.80, 107.90)` (`'BAT'`/`'3V7'` and `'round-pendant'`/URL/`CERN-OHL-P-2.0` waived across `918` vias; selective `6/346` designators vs shared `checks.toml` `all`, with `346/346` collision-free `assembly-{top,bottom}.pdf`); PCBA order requires **`POFV = Yes`**, **`DO NOT ULTRASONIC CLEAN`**, and preserving `BT1` `CPL = 208.00°`. | Due-South `BT1` (`< 0.5 mm` blocked by `U2`/`U7`); outward-protruding `BT1` (overhangs `Ø38.0 mm` rim); coin cell / supercap RTC backup (adds height/cost vs user's always-on `+3V3` choice) |
