sequoia-hope/matrix-play/design/gates/parallelogram-p2-132-usb6/brief.md

# Mechanical and layout brief: parallelogram-p2-132-usb6

Phase 4 variant brief. Parent board: `parallelogram-p2-132-usb` (`hw/parallelogram/p2-132-usb/`, documented in `design/study/parallelogram/README.md` §5). Earlier project artifacts inherited where unchanged: `design/intent.md` (electrical/sleep/firmware architecture; parallelogram family divergences logged in `design/decisions.md`), `design/parts/{rp2350-core.md,buttons.md,parallelogram-io.md,passives.md}`, `design/datasheets/evqp7j01p.pdf`.
Floorplan drawing: `design/renders/parallelogram-p2-132-usb6/floorplan.svg` (`floorplan.png`). Pre-route outline & placed board snapshot: `hw/parallelogram/p2-132-usb6/route/preroute_4L.kicad_pcb`.

## 1. Board outline and size
Skewed parallelogram, enclosure-free bare wearable pendant outline, unchanged from `p2-132-usb`:
- Width: `25.00 mm` (`x ∈ [-12.50, +12.50] mm` relative to board center `(100.0, 100.0) mm`).
- Side height: `62.00 mm`; skew: `8.00 mm` (`tan(α) = 8/25 = 0.32`, slant angle `17.7447°`), giving `70.00 mm` unfilleted sharp tip-to-tip height and **`69.260 mm` filleted overall height** (`y ∈ [-34.630, +34.630] mm`).
- Corner fillets: **`R = 1.000 mm`** at all four corners (`NW` center `(-11.50, -33.63)`, `SW` `(-11.50, +26.27)`, `NE` `(+11.50, -26.27)`, `SE` `(+11.50, +33.63)`).
- Straight vertical edge spans:
  - **West edge (`x = -12.50 mm`):** `y ∈ [-33.630, +26.270] mm` (`59.900 mm` straight vertical run between corner fillet tangents).
  - **East edge (`x = +12.50 mm`):** `y ∈ [-26.270, +33.630] mm` (`59.900 mm` straight vertical run between corner fillet tangents).

## 2. Mounting holes
None (unchanged from `p2-132-usb`; handheld / lanyard / bezel-mounted wearable pendant).

## 3. Connector and edge-switch placement

Every connector and switch from `p2-132-usb` stays at its **exact** parent coordinates and rotation (specifically `J1` is **not** re-aligned). Two new peg-less side-actuated Panasonic `EVQP7J01P` (`C2828254`, `3.50 × 2.90 × 1.35 mm` body, `1.70 mm` knob, `0.20 mm` push travel, `10 µA 2 V DC to 50 mA 12 V DC`, `10 ms` max ON/OFF bounce) tactile switches (`SW5`, `SW6`) are added on the **West (`x = -12.50 mm`)** vertical long edge, one near the North end and one near the South end:

| Ref | Part / MPN (LCSC & Footprint) | Side | Position `(x, y)` mm | Rot (°) | Facing / Overhang & Mating | Function & Net |
|---|---|---|---|---|---|---|
| `J1` | HRO `TYPE-C-31-M-22` (`C530612`, `USB_C_Receptacle_Hroparts_TYPE-C-31-M-22`, 16P SMT + `2 × Ø 0.65 mm` NPTH boss holes) | Back (`B.Cu`) | `(-1.24, +26.82)` | `162.2553` | South slanted edge (`usb_s = -2.45`, `usb_ye = 3.60`), shell mouth overhangs South `Edge.Cuts` by `1.520 mm` perp; unchanged | USB-C `5 V` power + USB 2.0 FS `D+/D−` (`CC1`/`CC2` `5.1 kΩ` `R1`/`R2`) |
| `BT1` | CJT `A1251WR-S-2P` (`C225111`, `Molex_PicoBlade_53261-0271_1x02-1MP_P1.25mm_Horizontal`) | Back (`B.Cu`) | `(+8.40, +20.05)` | `+90.0` | East-South back; mating mouth at `x = +5.80` opens West (`-X`) inward (`1.28 mm` body gap to `0.85 mm`-tall `U5` QFN: insert plug slightly tilted, route leads North to LiPo). `Pad 1` South (`y = +20.675`) = `+` `VBAT`; `Pad 2` North (`y = +19.425`) = `−` `BAT_N` | Single-cell LiPo (`VBAT` / `/Power/BAT_N` via `U8` `XB9901A`) |
| `SW1` | Panasonic `EVQP7J01P` (`C2828254`, peg-less) | Back (`B.Cu`) | `(+10.85, +1.50)` | `-90.0` | East edge (`+X`), knob to `x = +12.95` (`0.45 mm` rest overhang, `+12.75` at full `0.20 mm` stroke) | Power / wake button (`/MCU/BTN`, `U3.15` `GPIO11` via `R18` `1 kΩ`) |
| `SW2` | Panasonic `EVQP7J01P` (`C2828254`, peg-less) | Back (`B.Cu`) | `(-10.85, -3.50)` | `+90.0` | West edge (`-X`), knob to `x = -12.95` (`0.45 mm` rest overhang, `-12.75` at full `0.20 mm` stroke) | `BOOTSEL` (`/MCU/QSPI_SS` via `R16` `1 kΩ`) |
| `SW3` | XKB `TS-1187A-B-A-B` (`C318884`) | Back (`B.Cu`) | `(-9.15, -28.65)` | `+90.0` | Flat-face back (`-Z`), NW acute wing | `USER_A` (`/MCU/BTN_NW`, `U3.10` `GPIO7` via `R44` `1 kΩ`) |
| `SW4` | XKB `TS-1187A-B-A-B` (`C318884`) | Back (`B.Cu`) | `(+9.15, +28.65)` | `+90.0` | Flat-face back (`-Z`), SE acute wing | `USER_B` (`/MCU/BTN_SE`, `U3.31` `GPIO19` via `R45` `1 kΩ`) |
| **`SW5`** | **Panasonic `EVQP7J01P` (`C2828254`, peg-less)** | **Back (`B.Cu`)** | **`(-10.85, -22.00)`** | **`+90.0`** | **West edge (`-X`), North end; knob to `x = -12.95` (`0.45 mm` rest overhang; `-12.75` at full `0.20 mm` stroke)** | **`USER_C` (`/MCU/USER_C`, `U3.13` `GPIO9`, `1 kΩ` `R46` + `100 nF` `C71`)** |
| **`SW6`** | **Panasonic `EVQP7J01P` (`C2828254`, peg-less)** | **Back (`B.Cu`)** | **`(-10.85, +22.80)`** | **`+90.0`** | **West edge (`-X`), South end; knob to `x = -12.95` (`0.45 mm` rest overhang; `-12.75` at full `0.20 mm` stroke)** | **`USER_D` (`/MCU/USER_D`, `U3.2` `GPIO0`, `1 kΩ` `R47` + `100 nF` `C72`)** |

### Why West edge (`x = -12.50 mm`) was chosen over East edge (`x = +12.50 mm`)
- **East edge (`x = +12.50 mm`, straight `y ∈ [-26.270, +33.630] mm`) fails at the South end:** from `y = +6.27 mm` down to `y = +32.45 mm`, the East perimeter is continuously occupied by `R9` (`[+6.27, +8.13]`), `Q1` (`[+6.61, +8.60]`), `R11` (`[+8.93, +9.87]`), `C6` (`[+10.19, +11.11]`), `U8` (`[+11.71, +13.49]`), `R8` (`[+13.68, +14.62]`), `BT1` (`[+15.28, +24.82]`), and `SW4` (`[+24.86, +32.45]`). Zero `5.29 mm`-tall `EVQP7J01P` courtyard pocket exists on the East South end without moving inherited parts.
- **West edge (`x = -12.50 mm`, straight `y ∈ [-33.630, +26.270] mm`) has clean North and South pockets:**
  - **`SW5` (North, `y = -22.00 mm`):** Courtyard centerline `[-13.05, -9.30] × [-24.60, -19.40]` (`GetBoundingBox()` with stroke `[-13.10, -9.26] × [-24.645, -19.355]`) clears `SW3` courtyard (`y_max = -24.900` centerline / `-24.855` stroke bbox) by **`0.300 mm` centerline (`0.210 mm` stroke bbox, `0.650 mm` copper-to-copper)** and `SW2` courtyard by **`13.300 mm` centerline (`13.210 mm` stroke bbox)**. Copper pads span `x ∈ [-12.10, -9.60]`, giving **`0.400 mm` copper-to-edge clearance** (`>= 0.30 mm` JLC 4L routed rule). Peg-less SMD construction (`EVQP7J01P`, `0` new holes) preserves all `132` front LEDs untouched.
  - **`SW6` (South, `y = +22.80 mm`):** Courtyard sits `9.30 mm` south of the LiPo pocket (`y_max = +13.50`), clears `J1` rotated courtyard polygon by **`1.794 mm` true polygon distance** (`0.987 mm` axis-aligned stroke bbox, `1.814 mm` copper-to-copper), clears `U4` courtyard by **`2.900 mm` centerline (`2.810 mm` stroke bbox)**, and keeps its `3.50 mm` plastic body (`y_max = +24.550 mm`), `4.70 mm` terminal span (`y_max = +25.150 mm`), and `5.00 mm` copper pad (`y_max = +25.300 mm`) respectively **`1.720 mm`, `1.120 mm`, and `0.970 mm` north** of the SW `R = 1.000 mm` fillet tangent (`y = +26.270 mm`).
  - **3D LiPo pocket envelope (`x ∈ [-10.0, +10.0]`, `y ∈ [-21.5, +13.5] mm`):** All side switches (`SW1`, `SW2`, `SW5`) sit at `|x| = 10.850 mm`, so their `1.35 mm`-tall plastic bodies reach inward to `|x| = 9.400 mm` (`18.80 mm` clear lateral span `x ∈ [-9.40, +9.40]`; `SW5` body spans `y ∈ [-23.75, -20.25]`, extending `1.25 mm` South and `0.60 mm` East into the nominal `20 × 35 mm` box, just as `SW1`/`SW2` extend `0.60 mm` into mid-span). Therefore: (a) a `501035` (`10 × 35 mm`, `x ∈ [-5, +5]`) or any `≤ 18.5 mm`-wide cell clears `SW1`/`SW2`/`SW5` bodies laterally (`4.40 mm` on `501035`) on `1.0 mm` foam tape; (b) a full `20 × 35 mm` (`802035`/`102035`) cell requires **`≥ 1.5 mm` foam tape** so the cell bottom clears the `1.35 mm`-tall `SW1`/`SW2`/`SW5` housings (`U1`/`U2`/`U3` QFNs are `0.75–0.85 mm` and `R46`/`C71` `0402`s at `x = -7.40 mm` are `0.50 mm`).

## 4. Assembly sides
Double-sided PCBA at JLCPCB (unchanged from `p2-132-usb`):
- **Top (`F.Cu`):** `132 × XL-1615RGBC-RF` (`1.6 × 1.5 mm` RGB LEDs on **`3.70 × 2.60 mm`** skewed grid, `6` columns `x ∈ {-9.25, -5.55, -1.85, +1.85, +5.55, +9.25}` × `22` rows) + `Q2` (`XYC-PT19C-L1` ambient phototransistor at **`(0.00, -29.90)`**, `rot = -17.7447°` tangent to North bezel; inherited family divergence from `intent.md` R12). Only `2 × Ø 0.65 mm` NPTH boss holes from inherited `J1` (`+1.873, +26.591` and `-3.632, +24.829`, `0.294 mm` min drill-to-pad clearance to `D109.4`) penetrate the board; `SW5`/`SW6` add **`0` holes**.
- **Bottom (`B.Cu`):** All active electronics, power path, connectors, test points, and tactile buttons (`98` bottom footprints total, `90` assembled bottom parts + `8` SMD test pads: `92` from `p2-132-usb` + `SW5`, `SW6`, `R46`, `R47`, `C71`, `C72`).

## 5. Layer count & stackup lock
Locked to **4 layers, `1.6 mm` nominal (`1.586 mm` finished) FR-4, JLCPCB `JLC04161H-7628`, `ENIG 1U"`, `POFV = Yes` (epoxy-filled & copper-capped via-in-pad)** (`1 oz` `35 µm` outer / `0.5 oz` `15.2 µm` inner, `0.2104 mm` `7628` prepreg `Er = 4.4`, `1.065 mm` core, `0.30/0.15 mm` through vias, `0` blind/buried vias; `POFV = Yes` plates all `118` perimeter/LED SMD via-in-pads flat with `0` open barrels and `0` `F.SilkS` web dimples, while exposed thermal pads `U3=5`, `U5=2`, `U1=5`, `U2=5` additionally sit `100%` on solder-paste crossbars with `0` paste overlap):
- `F.Cu` (L1): LED pads, `Q2`, `CS` vertical column buses, inter-column routing alleys.
- `In1.Cu` (L2): **Dedicated whole-board solid `GND` reference plane** (`plane GND`, `1` unbroken piece; cut only around `VREG_LX` switch copper `LX cutout L2` per `decisions.md` 2026-11-07).
- `In2.Cu` (L3): Horizontal `SW` scan buses, power (`VSYS`, `+3V3`, `+1V1` `COUT`/`DVDD` spokes), MCU GPIO / I2C escape tracks, with `LX cutout L3` blocking traces directly `0.21 mm` above `B.Cu` `VREG_LX`/`L1.2`.
- `B.Cu` (L4): All ICs, passives, buttons, `J1`, `BT1`, `1` whole-piece RP2350 `+1V1` ring (`RP2350 ring`) and `1` whole-piece `+3V3` band (`RP2350 band`), `0`-via `12 MHz` crystal, and short USB/QSPI links.

## 6. Density philosophy
Compact wearable (`0402` passives for logic/RC/I2C/LED-driver decoupling, `0603`/`0805` for bulk power capacitance and `2016` for `L1`). Decorative skewed diamond lattice web on `F.SilkS` (clipped clear of all `F.Mask` pads) + selective functional/connector/button/identity labels and major IC designators on `B.SilkS`; `F.Fab`/`B.Fab` assembly drawings carry full passive designators for bench rework.

## 7. Block floorplan (exact PCB coordinates relative to `(100.0, 100.0) mm`)
Unchanged from `p2-132-usb`, plus `SW5`/`R46`/`C71` and `SW6`/`R47`/`C72`:
- **South power & USB entry:** `J1` (`(-1.24, +26.82, 162.26°)`), `U7` (`USBLC6-2P6` ESD at `(+2.20, +21.95, 180°)`), `U5` (`BQ24073` power-path charger at `(+3.02, +18.55, 0°)`), `BT1` (`(+8.40, +20.05, +90°)`), `U8` (`XB9901A` protection at `(+10.00, +12.60, 180°)`), `Q1` (`NTZD3155C` `VBAT_SENSE` switch at `(+9.20, +7.60, 180°)`), `U6` (`TPS7A0233` LDO at `(-4.70, +13.40, 180°)`).
- **Center MCU & memory/sensors:** `U3` (`RP2350A` QFN-60 at `(0.00, +6.40, 0°)`), `Y1` (`12 MHz` crystal at `(-1.30, -1.80, 0°)`), `L1` (`3.3 µH` core buck inductor at `(+2.00, +13.60, 0°)`), `U4` (`W25Q128JVPIQ` QSPI flash at `(-3.65, +17.60, +90°)`), `U9` (`LIS2DW12TR` accelerometer at `(-8.80, +5.20, 180°)`).
- **North/Mid matrix drivers:** `U1` (`AW20198QNR` at `(0.00, -18.50, +90°)`) and `U2` (`AW20198QNR` at `(+7.40, -8.20, +90°)`), diagonally separated by **`12.68 mm`** center-to-center.
- **New West-edge buttons & RC networks (`x = -7.40 mm`, centered inside `x ∈ [-8.40, -6.40]` Column 0–1 LED alley):**
  - `SW5` at `(-10.85, -22.00, +90°)` paired east (`3.45 mm` DX) with `C71` (`100 nF`, `(-7.40, -22.20, 180°)`) and `R46` (`1 kΩ`, `(-7.40, -21.00, 180°)`), routing to `U3` `Pin 13` (`GPIO9`, `(-3.44, +4.40)`).
  - `SW6` at `(-10.85, +22.80, +90°)` paired east (`3.45 mm` DX) with `R47` (`1 kΩ`, `(-7.40, +21.00, 180°)`) and `C72` (`100 nF`, `(-7.40, +19.80, 180°)`), routing to `U3` `Pin 2` (`GPIO0`, `(-3.44, +8.80)`).
  - **RC debounce & `POWMAN` wake note:** With RP2350 internal pull-up `50–80 kΩ`, press fall time is `τ_fall = 1 kΩ × 100 nF = 0.10 ms` and release rise time to Schmitt `V_IH+` (`2.0 V`) is `3.59–8.83 ms` across corners (`τ_rise = 4.5–8.8 ms`). Because `EVQP7J01P` specifies `10 ms` max ON/OFF bounce, `C71`/`C72` suppress contact chatter spikes while firmware applies a **`>= 20 ms` symmetrical press + release software debounce window** across `SW1..SW6` (`10.0 ms` max OFF bounce + `8.83 ms` slow-corner RC rise = `18.83 ms < 20 ms`). Also, RP2350 `POWMAN` `P1.7` deep sleep provides `4` hardware GPIO wake generators (`PWRUP0..3`): `SW1` (`GPIO11`) and `ACC_INT` (`GPIO10`) use `2`, leaving `2` hardware deep-sleep wake slots selectable in firmware among `{SW3, SW4, SW5, SW6}` (all `6` buttons work simultaneously in active and `dormant` sleep modes).

## 8. Thermal
Unchanged from `p2-132-usb` (`SW5`/`SW6` dissipate `< 0.25 mW` only while held down):
- `U1`, `U2` (`AW20198QNR` QFN-40 `3.4 × 3.4 mm` solid EP): `5` paste-free `GND` thermal vias each directly into unbroken `In1.Cu` `plane GND`, diagonally separated by `12.68 mm`.
- `U3` (`RP2350A` `3.4 × 3.4 mm` solid EP): `5` paste-free `GND` thermal vias; `U5` (`BQ24073` `1.7 × 1.7 mm` solid EP): `2` paste-free `GND` thermal vias.

## 9. Art zone
Front (`F.SilkS`) carries the parallelogram family's skewed diamond lattice web along LED cell midpoints (`0.15 mm` stroke, clipped `0.25 mm` clear of all `F.Cu` pads and `0.35 mm` clear of `Q2`), plus `Q2` collector pin-1 dot. Back (`B.SilkS`) has no decorative art, prioritizing unambiguous functional labels and open-hardware identity.

## 10. Silkscreen policy
Selective functional silkscreen on `B.SilkS` (`0.80 mm` height, `0.15 mm` stroke, strict 2-rotation typography at `0.0°` and `90.0°` only, `>= 0.13 mm` clearance to tented via pads, `>= 0.18 mm` to `B.Mask` openings, `0` strokes under 3D package bodies):
- **Connector & button function labels (`B.SilkS`):**
  - `J1`: `"5V"` (`(+1.50, +24.00, 0.0°)`, nearest to `J1` and outside `BT1` courtyard)
  - `BT1`: `"+"` South (`(+11.70, +21.60, 0.0°)` opposite `Pad 1` `VBAT`), `"-"` North (`(+11.70, +18.60, 0.0°)` opposite `Pad 2` `/Power/BAT_N`), `"BATT"` (`(+10.90, +16.00, 90.0°)`)
  - Buttons: `"PWR"` (`SW1`), `"BOOT"` (`SW2`), `"USER_A"` (`SW3`), `"USR_B"` (`SW4`), **`"USER_C"` (`SW5`)**, **`"USER_D"` (`SW6`)**
- **Selective designators, test-point nets & polarity (`B.SilkS`):** `16/20` major `B.Cu` parts (`J1`, `Q1`, `SW1..SW6`, `U1..U4`, `U6`, `U8`, `U9`, `Y1`; zero passive designators; `BT1`/`U5`/`U7`/`L1` tight courtyards documented in `bringup.md` + `assembly-bottom.pdf`), `4/8` bare test-point net labels (`DIO`, `GND`, `CLK`, `1V1`), plus **`12/12` filled pin-1 dots outside 3D bodies** on `B.SilkS` (`U1..U9`, `Q1`, `L1`, `Y1`) and `Q2` collector dot on `F.SilkS`.
- **Board identity (`B.SilkS`):** `"p2-132-usb6"`, `"rev P1U6"`, `"2026-11"`, `"CERN-OHL-P"`, and contiguous 3-column repository URL block `"github.com/"` + `"sequoia-hope/"` + `"round-pendant"` (`(+11.3/+10.3/+9.1, -15.5..-22.0, 90.0°)`).

## 11. Keepouts
Enforced as KiCad rule areas + `.kicad_dru` rules (`stage_zones` in `pcb_gen.py`):
- **`LX cutout L2` (`In1.Cu`) & `LX cutout L3` (`In2.Cu`):** `no_tracks=True, no_pour=True` shaped `0.25 mm` around `/MCU/VREG_LX` pour and `U3.48`/`L1.2` pads (`5.43 mm²`, preserving `GND` under `L1.1` `+1V1` and blocking `In2.Cu` traces `0.21 mm` under `B.Cu` `VREG_LX`).
- **RP2350 power rings & regulator keepouts (`B.Cu`):** `U3 ring vias` (`+1V1`/`GND`), `U3 band` (`+3V3` only — keeps `RP2350 band` `1` unbroken piece), `U3 ring`, `reg corner`, `L1 window`, `vendor * area`, and `U1/U2/U3/U5 solid EP`.
- **Edge actuator travel & bezel stop:** `SW1`, `SW2`, `SW5`, `SW6` knobs protrude `0.450 mm` past `|x| = 12.500 mm` at rest (`|x| = 12.950 mm`) and reach **`|x| = 12.750 mm` (`0.250 mm` proud of `Edge.Cuts`) at full `0.20 mm` stroke**. Any enclosure bezel or button cap MUST leave `>= 0.25 mm` clearance proud of `x = ±12.50 mm` at full press so the actuator never overtravels past its `30 N` stop.

## 12. Test and debug
Eight inherited bottom-side `Ø 1.0 mm` SMD test points (`TestPoint_Pad_D1.0mm`, exact net mapping verified against `mcu.kicad_sch` & PCB):
- **Power rails (around `U3`/`U6`):** `TP1` `(+6.25, +14.20)` = **`VSYS`**, `TP2` `(-6.90, +11.75)` = **`+3V3`**, `TP3` `(+6.41, +12.15)` = **`VBAT`**, `TP4` `(-7.30, +13.80)` = **`+1V1`**.
- **SWD debug & reset (north of `U3`):** `TP5` `(-5.50, -1.50)` = **`/MCU/RUN`**, `TP6` `(+4.20, -1.20)` = **`/MCU/SWCLK`**, `TP7` `(+3.55, -3.17)` = **`/MCU/SWDIO`**, `TP8` `(-5.40, -3.55)` = **`GND`**.
- **Button & bus probing (inherited family waiver for dedicated `I2C` test pads / `0 Ω` jumpers on `25 × 70 mm` 4L layout, logged in `decisions.md`):** `USER_C` and `USER_D` probe directly at `R46.1`/`C71.1` and `R47.1`/`C72.1`; `I2C0` (`I2C_SDA`/`I2C_SCL`) probes at `0402` pull-ups `R21.2`/`R22.2` (`(-5.20, +2.20/+1.00)`); `I2C1` (`ACC_SDA`/`ACC_SCL`) probes at `R19.2`/`R20.2`.
