sequoia-hope/matrix-play/design/study/sunflower/intent-s2-110-usbc.md

# Design intent: Sunflower `s2-110-usbc` (Rev S3C)

Phase 0 specification for `hw/sunflower/s2-110-usbc/`. Every item has a concrete number or an explicit **"don't care"**.
Parent design: `design/intent.md` (Round Pendant) and `design/study/sunflower/README.md`. Items marked **(open — user sign-off)** require user confirmation at Gate 0.

## Purpose

A low-cost 4-layer, 38.0 mm round wearable RGB LED display worn as a pendant or watch, built exclusively from parts in local JLCPCB PCBA stock with standard non-filled through vias (no POFV). The front carries 110 `XL-1615RGBC-RF` RGB LEDs arranged in a golden-angle Vogel spiral starting with `D1` at the board centre `(0, 0)`, plus a 12-o'clock top-rim ambient light sensor (`Q2`). All control, power, charging, motion sensing, bring-up test pads, and connectors sit on the back, backed by a 35 mm round `403535` LiPo cell plugged into a right-angle Molex PicoBlade 1.25 mm socket (`BT1`). It charges and takes firmware over a back-side USB-C receptacle (`J1`), runs animations from an `RP2350A`, and sleeps at `≤ 85 µA` typ (`≤ 135 µA` worst-case max) until woken by a side button press (`SW1`) or accelerometer motion (`U9`). Intended for personal use and small prototype runs.

## Open source or confidential

Open source (`CERN-OHL-P-2.0`), public GitHub repository `https://github.com/sequoia-hope/round-pendant`, KiCad 9, Boardroom project layout (inherited from `design/intent.md`). Front display carries no text; board revision/repo identity on back silkscreen is **don't care** where displaced by functional connector/test-pad labels (tracked via schematic/PCB title block and `BOARD_ID = 6` hardware strap; **(open — user sign-off)**).

## Requirements

| # | Requirement | Value | Checked at |
|---|---|---|---|
| R1 | Outline | Circle, `38.0 mm` diameter (`±0.2 mm` fab tolerance), zero mounting holes | `Edge.Cuts`, Gate 4 |
| R2 | LED count & spiral | `110` RGB LEDs (`D1`–`D110`) on `F.Cu` in a golden-angle (`137.508°`) Vogel spiral within `r ≤ 17.211 mm` (`0.626 mm` min rotated pad-corner clearance to `Edge.Cuts`), with `D1` at exact centre `(0.00, 0.00 mm)`, courtyard-relaxed (`2.0 × 1.9 mm` courtyards, `1.951 mm` min / `2.688 mm` mean nearest-neighbour centre spacing), and steered clear of `J1`'s 6 through-holes and `Q2`'s top-rim keepout (`r = 2.50 mm` around `(0, −18.20 mm)`) | `config.py`, Gate 4, Gate 6 |
| R3 | LED part | XINGLIGHT `XL-1615RGBC-RF`, `1.6 × 1.5 × 0.6 mm` SMD-4, LCSC `C965840` (`Pin 2 = Anode`, `1 = R`, `3 = G`, `4 = B`; CPL rotation `+180°` vs datasheet top view) | `parts/leds-xl1615.md`, Gate 1, Gate 10 |
| R4 | LED drivers | `2 ×` Shanghai Awinic `AW20198QNR`, QFN-40 `5 × 5 mm` (`3.4 × 3.4 mm` solid exposed `GND` pad), LCSC `C5137654`. Each drives `5` wedges × `11` SW = `55` RGB LEDs (`15 CS × 11 SW = 165` dots; `CS16`–`CS18` unused `NC`) | `parts/drivers-aw20198.md`, Gate 1, Gate 2 |
| R5 | Driver control | Shared `I2C0` (`GPIO4` SDA, `GPIO5` SCL) at up to `1 MHz` (`1 kΩ` pull-ups `R21`, `R22` to `+3V3`). 7-bit addresses `0x20` (`U1`: `AD1 = AD0 = GND`) and `0x25` (`U2`: `AD1 = AD0 = VSYS`). Shared active-high `EN` (`LED_SDB` on `GPIO6`, `100 kΩ` pull-down `R31` + `100 nF` `C35`); `SYNC` floating (`NC`, internal `1 MΩ` pull-down). Full 2-driver PWM update (`2 × 200` to `2 × 203` bytes incl. page write) takes `≈ 3.63–3.84 ms` at `1 MHz` (`≥ 60 fps` at `~23%` bus load). Firmware sets `GPIO4/5` pad drive to **`12 mA`** (`VOL ≤ 0.14 V` at `3.4 mA`, meeting `LGC = 0` `VIL ≤ 0.40 V` at boot) **before** writing **`GCR = 0xB9`** (`LGC = 1` bit 3: `VIL = 0.6 V`, `VIH = 2.4 V`; `SWSEL = 1011`; `CHIPEN = 1`) | Gate 1, Gate 2, firmware |
| R6 | Ambient light sensor | Newopto `XYC-PT19C-L1` (`0603` unfiltered silicon phototransistor, `λp = 850 nm` NIR, LCSC `C2693594`; footprint- and pin-identical drop-in for photopic `ALS-PT19` `C146233`) on `F.Cu` at 12-o'clock rim `(0.00, −18.20 mm, 0°)`. Collector driven by `GPIO1` (`LIGHT_PWR`, `0 µA` sleep draw); emitter to `GPIO27/ADC1` (`LIGHT`) with `R43 = 22 kΩ` and `C70 = 100 nF` (`τ = 2.2 ms`, linear indoor range `~5–293 lx` min / `~440 lx` typ before `VCE(sat)`; substitute `ALS-PT19` or `R43 = 6.8 kΩ` if `1000 lx` daylight ceiling needed) | `parts/drivers-aw20198.md`, `parts/light-sensor.md`, Gate 1, Gate 6 |
| R7 | MCU | `RP2350A` QFN-60 (`C42411118`), `12 MHz` crystal `Y1` (`ABM8-272-T3`, `C20625731`, `CL = 10 pF`, `15 pF` load caps `C23/C24` + `1 kΩ` `R17` damping), `3.3 µH` core inductor `L1` (`AOTA-B201610S3R3-101-T`, `C42411119`), regulator/ring/band power layout per `.claude/skills/pcb-design/chips/rp2350.md` | `parts/rp2350-core.md`, Gate 1, Gate 6, Gate 7 |
| R8 | Flash | Winbond `W25Q128JVPIQ` `128 Mbit` (`16 MB`) QSPI, WSON-8 `6 × 5 mm` (`C190862`), `≤ 75 MHz`, `≤ 25 mm` trace length | `parts/flash.md`, Gate 1, Gate 5, Gate 7 |
| R9 | Debug, bring-up & ID | `14` `Ø1.0 mm` SMD test pads on `B.Cu` (unpopulated): `VSYS` (`TP1`), `+3V3` (`TP2`), `VBAT` (`TP3`), `+1V1` (`TP4`), `RUN` (`TP5`), `SWCLK` (`TP6`), `SWDIO` (`TP7`), `GND` (`TP8`), `I2C_SDA` (`TP11`), `I2C_SCL` (`TP12`), `VBUS` (`TP13`), `UART1 TX` (`GPIO24`, `TP14`), `UART1 RX` (`GPIO25`, `TP15`), and spare ADC `GPIO29` (`TP16`). 3-bit hardware board ID on `GPIO19..21` (read at boot with internal pull-ups, tied = `0`, open = `1`): `GPIO19` tied to `GND` via copper net-tie `NT1` so this board reads `ID = 6` (`0b110`) | Gate 2, Gate 4, Gate 6 |
| R10 | Buttons | Two peg-less side-actuated buttons (`Panasonic EVQP7J01P`, `C2828254`) on `B.Cu` at NE (`+21°`, `SW1` `USER/WAKE` → `1 kΩ` `R18` → `GPIO11`) and NW (`−21°`, `SW2` `BOOTSEL` → `1 kΩ` `R16` → `~{QSPI_SS}`), plunger `~0.40 mm` proud of rim nominally (`0.20 mm` pressed; `0.00 to −0.20 mm` worst-case tolerance **(open — user sign-off)**) | `parts/drivers-aw20198.md`, Gate 4, Gate 6 |
| R11 | Accelerometer | `LIS2DW12TR` LGA-12 (`C189624`) on dedicated `400 kHz` `I2C1` (`GPIO2` SDA, `GPIO3` SCL, `4.7 kΩ` pull-ups `R20`, `R19`), address `0x19` (`SA0 = CS = +3V3`), motion-wake `INT1` on `GPIO10`, `≤ 2 µA` in low-power wake mode at `3.3 V` | `parts/accel.md`, Gate 1, Gate 2 |
| R12 | Assembly | Double-sided PCBA at JLCPCB (`Pass 1 = B.Cu`, `Pass 2 = F.Cu` at `≤ 245 °C` peak so `Q2` sees **at most 1 reflow pass** per `xyc-pt19c-l1.pdf` p. 11): `F.Cu` holds `D1`–`D110` and `Q2` (`111` parts); `B.Cu` holds all other `80` assembled parts (`191` total placements across `36` BOM lines, `100%` local JLCPCB stock). Battery plugged in by hand after PCBA | Gate 1, Gate 4, Gate 10 |
| R13 | Layers & vias | `4` copper layers (`JLC04161H-7628`, `1.6 mm` nominal FR-4, `1 oz` outer / `0.5 oz` inner), standard `0.30/0.15 mm` through vias (`0.35/0.15 mm` on power classes), **zero vias in SMD signal pads (no POFV)**, solid exposed `GND` pads (`U1`, `U2`, `U3`, `U5`) with `0` foreign vias | `stackup-4l.md`, Gate 5, Gate 7 |
| R14 | Charger & power path | `TI BQ24073RGTR` (`C15220`): `CE = GND`, `TD = GND`, `USB500` input limit (`450–500 mA` active once `+3V3` rises on `EN1 = +3V3`, `EN2 = GND`; cold-starts in `USB100` `90–100 mA`; `ILIM` fault resistor `R5 = 3.6 kΩ`), `VO(REG) = 4.4 V` typ (`4.3–4.5 V`) on USB, `6.6 V` input OVP, `297 mA` typ fast charge (`R4 = 3.0 kΩ ±1%` → `263–328 mA`), `10 kΩ` fixed `TS` (`R3`), `5 h` default timer (`TMR` open), load-priority supplement mode | `parts/charger.md`, Gate 1 |
| R15 | Logic LDO | `TI TPS7A0233PDQNR` (`C2860046`), `3.3 V ±1.5%`, `200 mA` rated (`150 mA` budget), `25 nA` `IQ` (`~0.6 µA` sleep ground current), fed from `VSYS` (`VDO ≤ 203 mV` at `150 mA`; enters benign dropout `~3.24 V` near `VBAT = 3.50 V` peak load while keeping `RP2350` `≥ 3.135 V`) | `parts/ldo.md`, Gate 1 |
| R16 | Battery & socket | `403535` round LiPo pouch cell (`35 mm` dia × `4.0 mm` thick, `~400–450 mAh` est., `3.7/3.85 V` nom, charged to `4.20 V`; cell C-rating for `263–328 mA` ≈ `0.58–0.82C` **(open — user sign-off)**). Connects via `BT1` (`Molex 53261-0271`, `C177225`, `1.0 A` rated) on `B.Cu` NW rim `(−11.40, −10.20 mm, −110°)`, plug entering from board-centre side. Protected by `U8` (`XB9901A`, `C669687`, `VCU = 4.25–4.35 V`, `VDL = 2.3–2.5 V`, `IIOV1 = 9 A` hard-short protection; `BAT_N` isolated from `GND`; requires initial USB attach to exit first-mate power-down) | `parts/parallelogram-io.md`, `parts/protection.md`, Gate 1, Gate 4 |
| R17 | Sleep current | `≤ 85 µA` typical (`~68–73 µA` de-duplicated typ; `≤ 135 µA` worst-case max across flash `ICC1,max = 60 µA`) from cell at `25 °C`: `RP2350A` `P1.7` + flash baseline `57 µA` + `LIS2DW12` `2 µA` + `2× AW20198` shutdown (`EN = 0`) `2.6 µA` + `TPS7A0233` `0.6 µA` + `BQ24073` `≤ 6.5 µA` + `XB9901A` `3.9 µA` + `Q1/Q2` off `< 0.2 µA`. Firmware clears RP2350 latched pull-downs (`§9.7`) on externally pulled-up `GPIO2, 3, 4, 5, 12, 13` and clears both `PUE = 0` and `IE = 0` (`RP2350-E9`) on open/analog `GPIO0, 7..9, 14..18, 20..23, 26, 27` before sleep | `parts/`, firmware, bench |
| R18 | LED current (hardware) | `R30 = R33 = 30.0 kΩ` (`1%`): `IOUT,max = 400 / 30 kΩ = 13.33 mA` typ (`12.54–14.14 mA` w/ `±5%` `IMATCH`) per `CS` channel (`aw20198qnr.pdf` p. 18), `11-SW` scan duty `15.9375 µs / 198 µs = 255 / 3168 = 0.08049` (`1/12.42`), `ILED,avg = 1.073 mA` per die at `GCC = SL = PWM = 255`. Hardware full-white total across `110` RGB LEDs (`330` dies): **`354.2 mA` typ** (`332.9–375.6 mA` w/ tol, `≪ 20 mA` DC and `80 mA` pulsed LED abs max) | `parts/drivers-aw20198.md`, `parts/leds-xl1615.md`, Gate 1 |
| R19 | LED current & thermal cap (firmware) | Firmware closed-loop `ADC4` thermal cap: continuous full-white capped at **`GCC ≤ 105` (`~146 mA` avg LED current, `~0.68 W` total w/ MCU)** on pouch-backed battery (`R_th ≈ 35 K/W → ≤ 48 °C` wearable touch / `< 60 °C` LiPo / `< 70 °C` `EVQP7J01P` at `25 °C` ambient) and **`GCC ≤ 9` in CC (`0` at low-bat CC, `≤ 24` in CV taper)** whenever **`(~{PGOOD} == 0) \|\| (~{CHG} == 0)`** (`≤ 45 °C` LiPo charge limit with defeated `TS`, gating on `~{PGOOD}` too because `~{CHG}` goes High-Z on recharge cycles), with `< 15 s` bursts allowed up to `300 mA` (`GCC = 216`) when `T_MCU < 45 °C` **(open — user sign-off)**. Absolute lumen target: **don't care** | firmware, Gate 8 |
| R20 | Peak scan current | Per driver (`15` active `CS` channels): `15 × 13.33 mA = 200.0 mA` per `SW` scan slot (`≤ 240 mA` if all `18` `CS` enabled, `≪ 990 mA` `AW20198` `SW` rating); `400.0 mA` typ (`424 mA` max) combined if both drivers' slots align (`561 mA` typ / `585 mA` max total `VSYS` slot load), decoupled locally by `22 µF + 1 µF + 100 nF` at each driver | `parts/drivers-aw20198.md`, Gate 1, Gate 8 |
| R21 | 4L routing rules | Standard JLCPCB 4-layer rules: `0.10 / 0.10 mm` min track/clearance (`0.09 mm` min connection width), `0.30 / 0.15 mm` min via (`0.05 mm` min annular width in KiCad setup, `0.075 mm` actual on `0.30/0.15 mm`), `0.20 mm` hole-to-copper and hole-to-hole, `0.25 mm` copper-to-edge | `stackup-4l.md`, Gate 5, Gate 7 |
| R22 | Battery monitoring | `VBAT` switched high-side divider (`Q1` `NTZD3155C`, `R11 = R12 = 100 kΩ`, `C7 = 100 nF`) read on `GPIO26/ADC0` after **`≥ 30 ms` (`6 τ`)** settling and enabled by **`GPIO28` (`pin 42`)** on this variant (`0 µA` sleep draw via `R9 = R10 = 100 kΩ`). Firmware shuts down LEDs and sleeps below `VBAT = 3.55 V` (`±5%` uncalibrated ADC/LDO/resistor budget keeps `RP2350` `VREG_AVDD`/`USB_OTP_VDD ≥ 3.135 V`) | `parts/q1-divider-switch.md`, `parts/passives.md`, Gate 2, firmware |
| R23 | Charge indication | `~{CHG}` (`GPIO12`) and `~{PGOOD}` (`GPIO13`) via `100 kΩ` pull-ups (`R7`, `R6`) to `+3V3`; displayed on main RGB LEDs, no separate indicator LED | Gate 2 |
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
