sequoia-hope/matrix-play/design/study/sunflower/stackup-4l.md

# Stackup and design rules: Sunflower `s2-110-usbc` (4-layer)

Phase 5 stackup and constraint specification for [sunflower.kicad_pcb](file:///home/sequoia/pcb/round-pendant/hw/sunflower/s2-110-usbc/sunflower.kicad_pcb), [sunflower.kicad_pro](file:///home/sequoia/pcb/round-pendant/hw/sunflower/s2-110-usbc/sunflower.kicad_pro), and [sunflower.kicad_dru](file:///home/sequoia/pcb/round-pendant/hw/sunflower/s2-110-usbc/sunflower.kicad_dru).
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
