sequoia-hope/matrix-play/design/renders/b/In3.Cu.png

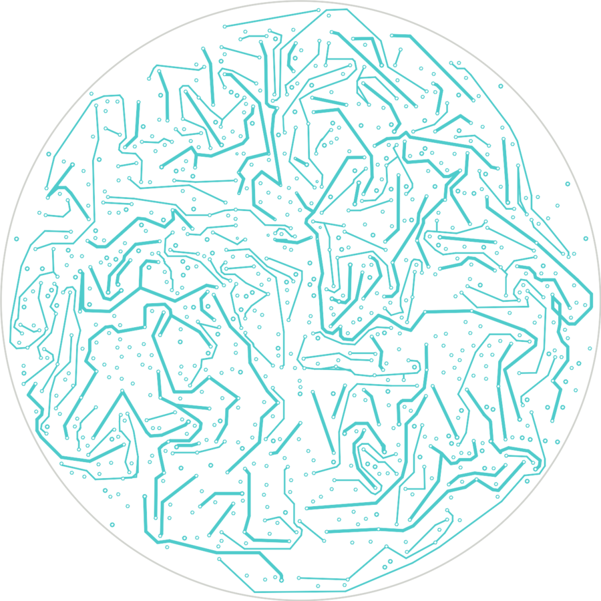
design/renders/b/In3.Cu.png
