sequoia-hope/matrix-play/design/renders/In3.Cu.png

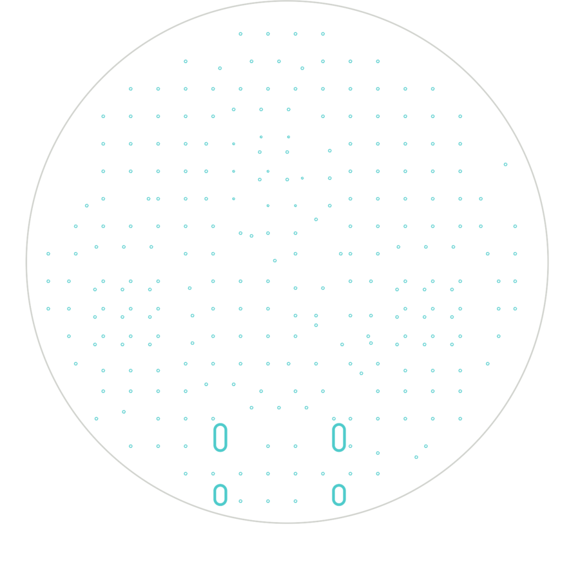
design/renders/In3.Cu.png
