sequoia-hope/matrix-play/design/renders/In4.Cu.png

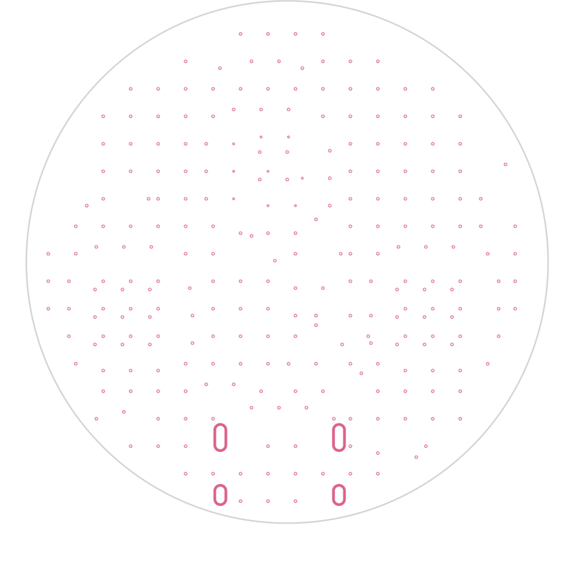
design/renders/In4.Cu.png
