sequoia-hope/matrix-play/design/renders/parallelogram-p2-132-usb6/F.Cu.png

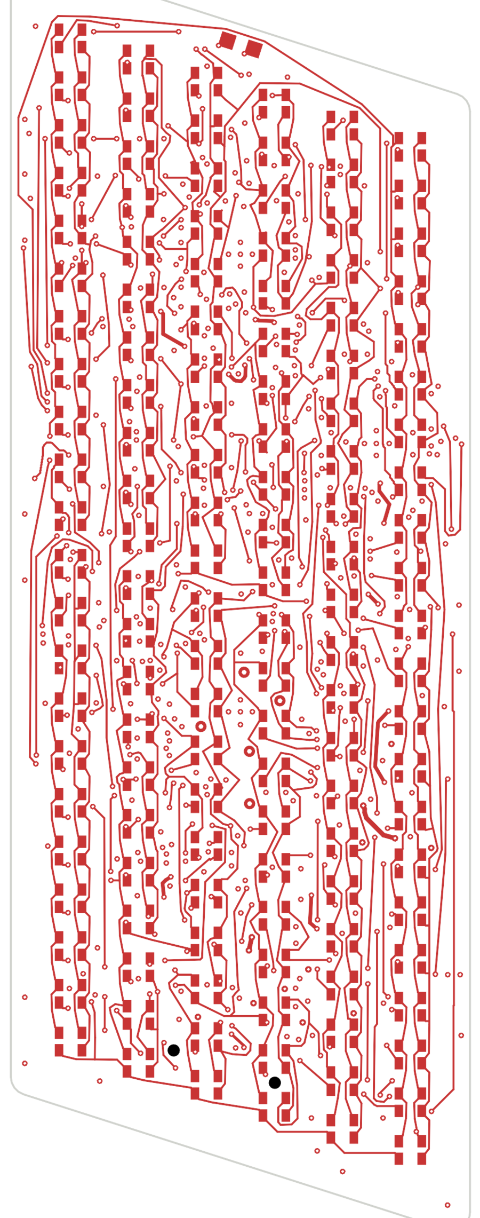
design/renders/parallelogram-p2-132-usb6/F.Cu.png
