sequoia-hope/matrix-play/design/renders/parallelogram-p2-132-usb6/gerbers/drill_parallelogram.png

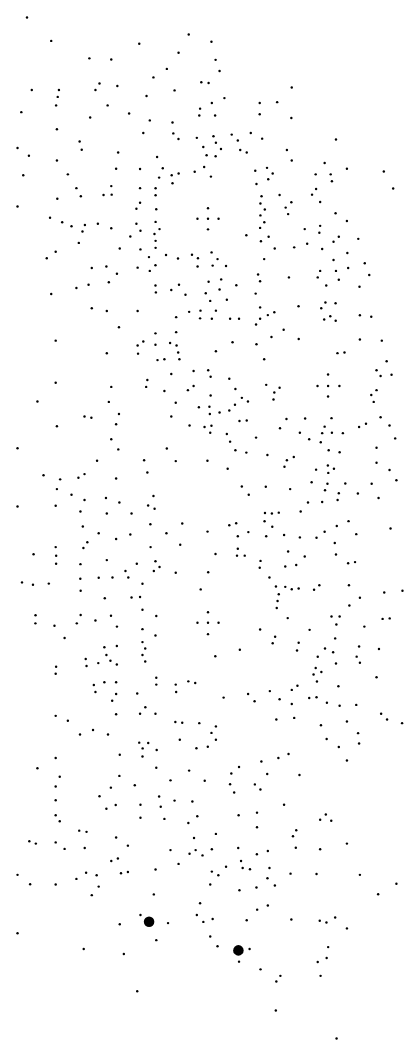
design/renders/parallelogram-p2-132-usb6/gerbers/drill_parallelogram.png
