sequoia-hope/matrix-play/design/renders/parallelogram-p2-132-usb6/In2.Cu.png

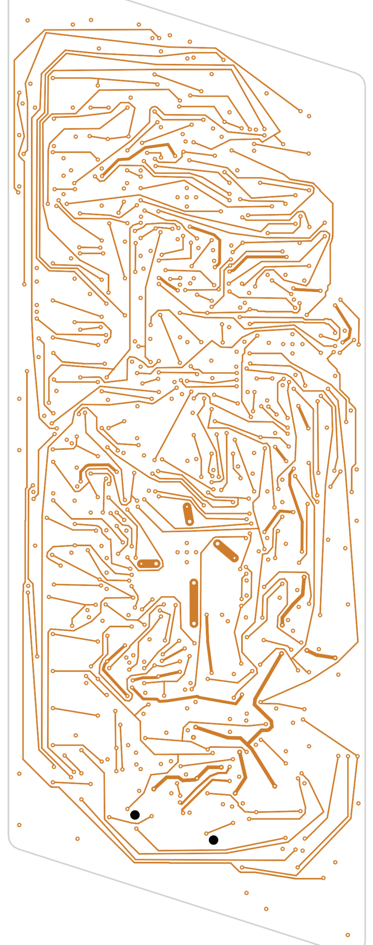
design/renders/parallelogram-p2-132-usb6/In2.Cu.png
