sequoia-hope/matrix-play/design/renders/parallelogram-p2-132-usb6/u3-1v1/before.png

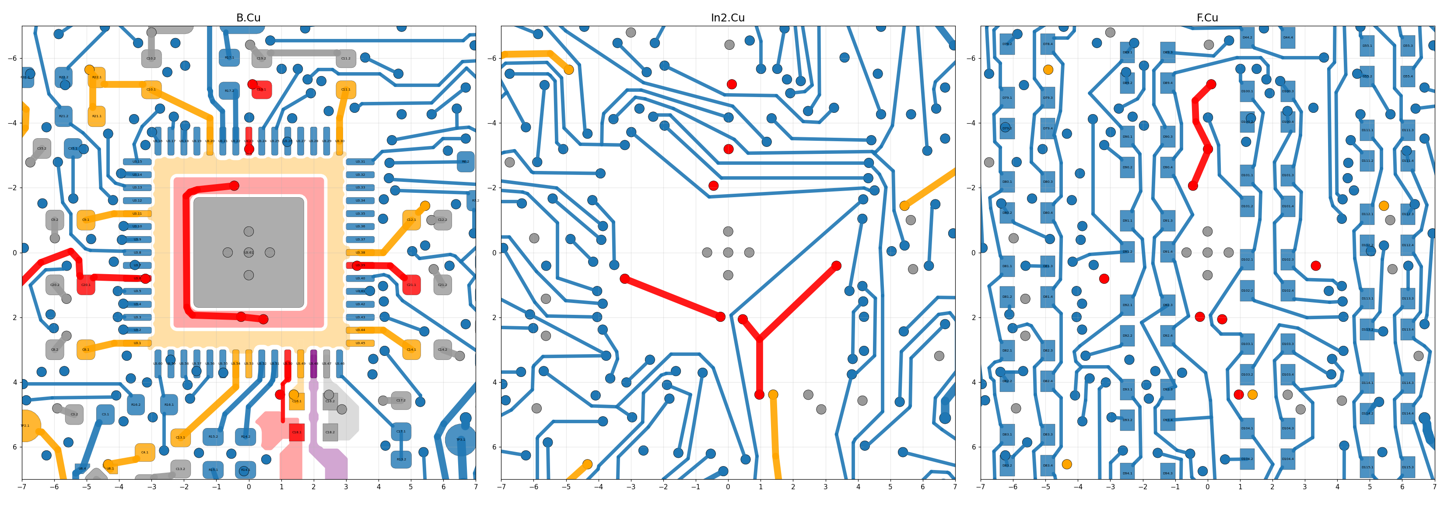
design/renders/parallelogram-p2-132-usb6/u3-1v1/before.png
