sequoia-hope/matrix-play/design/renders/round-pendant-f-usbc-rtc/3d-top.png

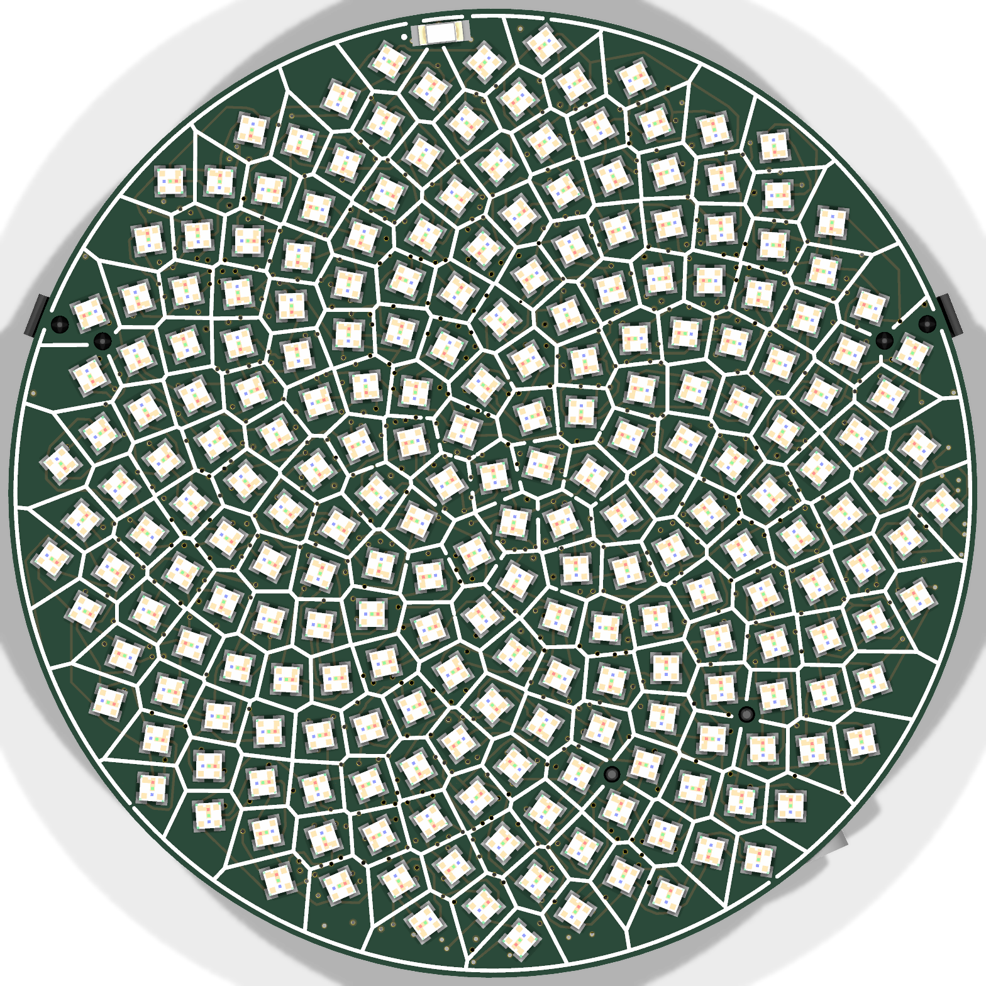
design/renders/round-pendant-f-usbc-rtc/3d-top.png
