sequoia-hope/matrix-play/design/renders/round-pendant-f-usbc-rtc/bottom.png

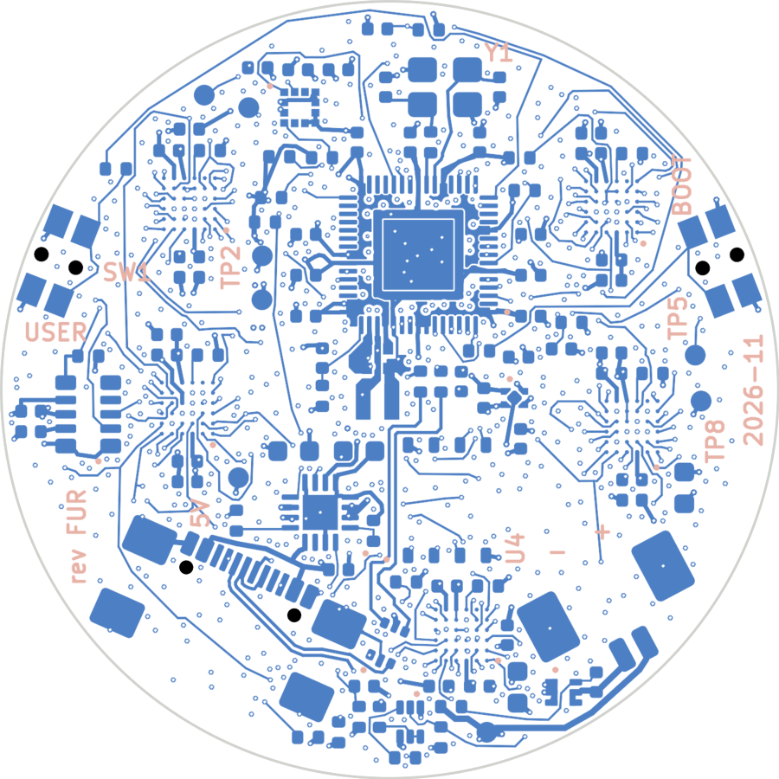
design/renders/round-pendant-f-usbc-rtc/bottom.png
