sequoia-hope/matrix-play/design/renders/round-pendant-f-usbc-rtc/F.Cu.png

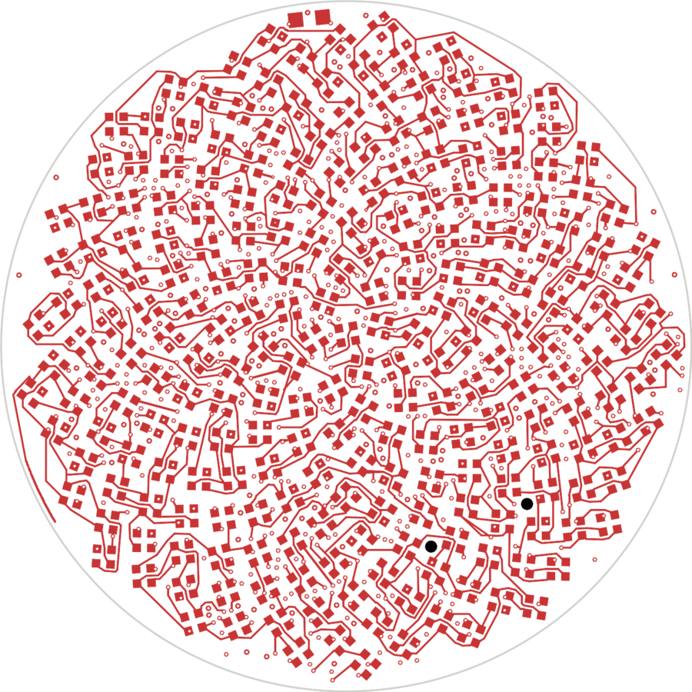
design/renders/round-pendant-f-usbc-rtc/F.Cu.png
