sequoia-hope/matrix-play/design/renders/round-pendant-f-usbc-rtc/gerbers/bottom_copper.png

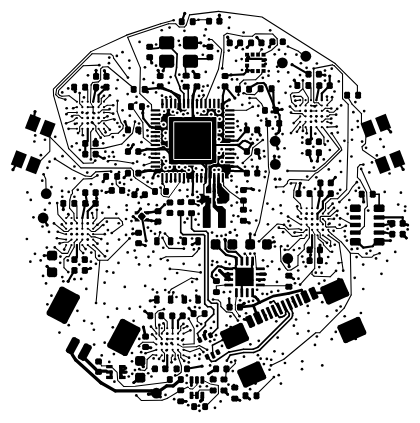
design/renders/round-pendant-f-usbc-rtc/gerbers/bottom_copper.png
