sequoia-hope/matrix-play/design/renders/round-pendant-f-usbc-rtc/gerbers/bottom_mask.png

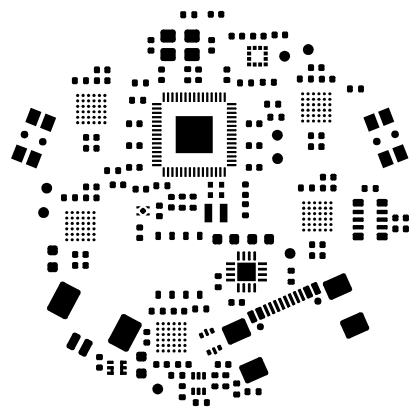
design/renders/round-pendant-f-usbc-rtc/gerbers/bottom_mask.png
