sequoia-hope/matrix-play/design/renders/round-pendant-f-usbc-rtc/gerbers/bottom_paste.png

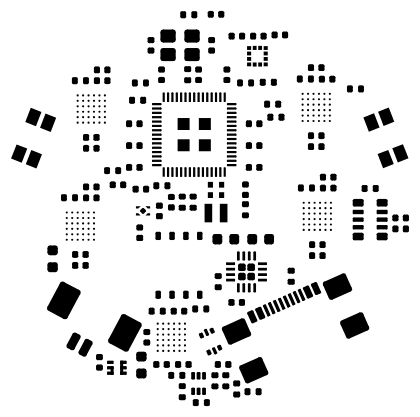
design/renders/round-pendant-f-usbc-rtc/gerbers/bottom_paste.png
