sequoia-hope/matrix-play/design/renders/round-pendant-f-usbc-rtc/gerbers/drill_round-pendant-PTH.png

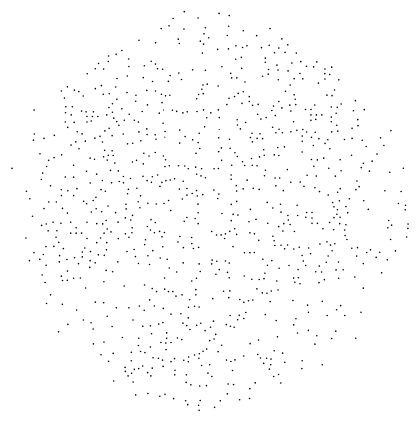
design/renders/round-pendant-f-usbc-rtc/gerbers/drill_round-pendant-PTH.png
