sequoia-hope/matrix-play/design/renders/round-pendant-f-usbc-rtc/gerbers/inner_1_copper.png

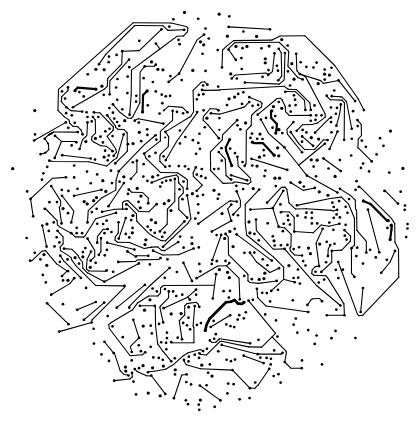
design/renders/round-pendant-f-usbc-rtc/gerbers/inner_1_copper.png
