sequoia-hope/matrix-play/design/renders/round-pendant-f-usbc-rtc/gerbers/sheet.png

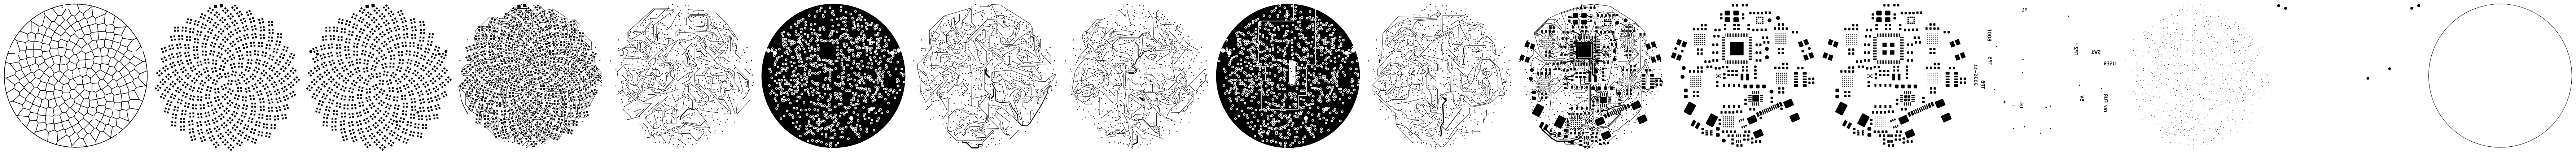
design/renders/round-pendant-f-usbc-rtc/gerbers/sheet.png
