sequoia-hope/matrix-play/design/renders/round-pendant-f-usbc-rtc/gerbers/top_copper.png

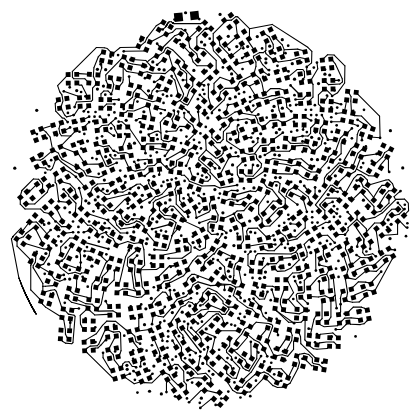
design/renders/round-pendant-f-usbc-rtc/gerbers/top_copper.png
