sequoia-hope/matrix-play/design/renders/round-pendant-f-usbc-rtc/gerbers/top_mask.png

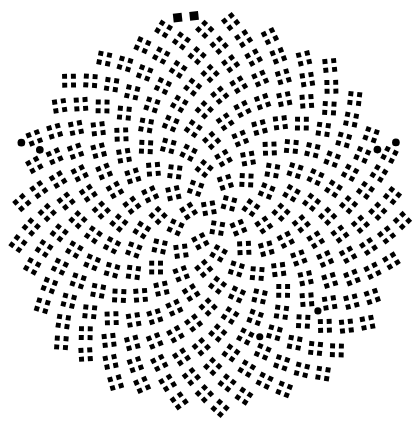
design/renders/round-pendant-f-usbc-rtc/gerbers/top_mask.png
