sequoia-hope/matrix-play/design/renders/round-pendant-f-usbc-rtc/gerbers/top_silk.png

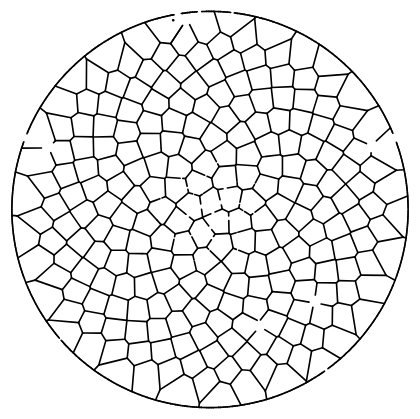
design/renders/round-pendant-f-usbc-rtc/gerbers/top_silk.png
