sequoia-hope/matrix-play/design/renders/round-pendant-f-usbc-rtc/In4.Cu.png

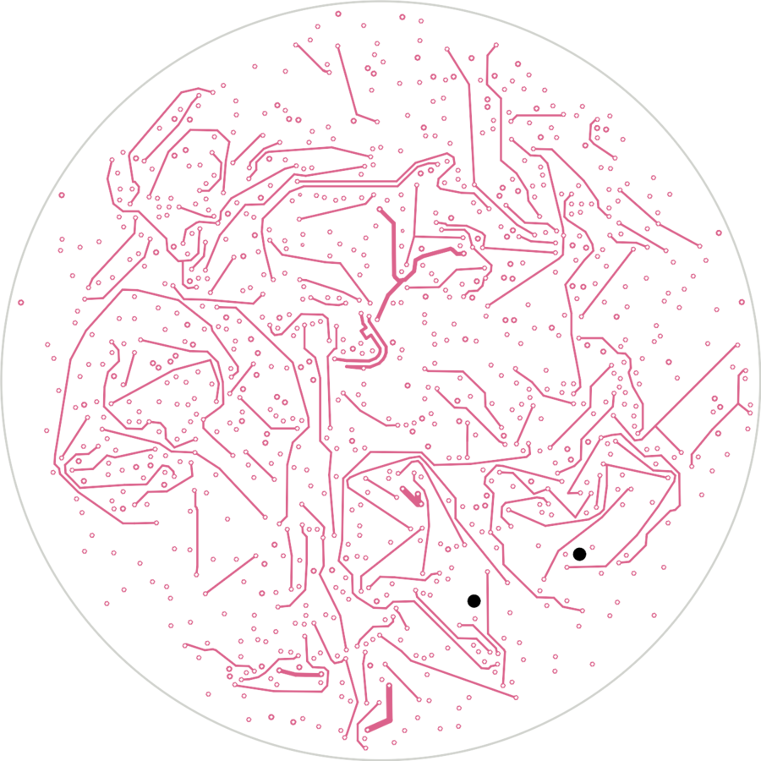
design/renders/round-pendant-f-usbc-rtc/In4.Cu.png
