sequoia-hope/matrix-play/design/renders/round-pendant-f-usbc-rtc/top.png

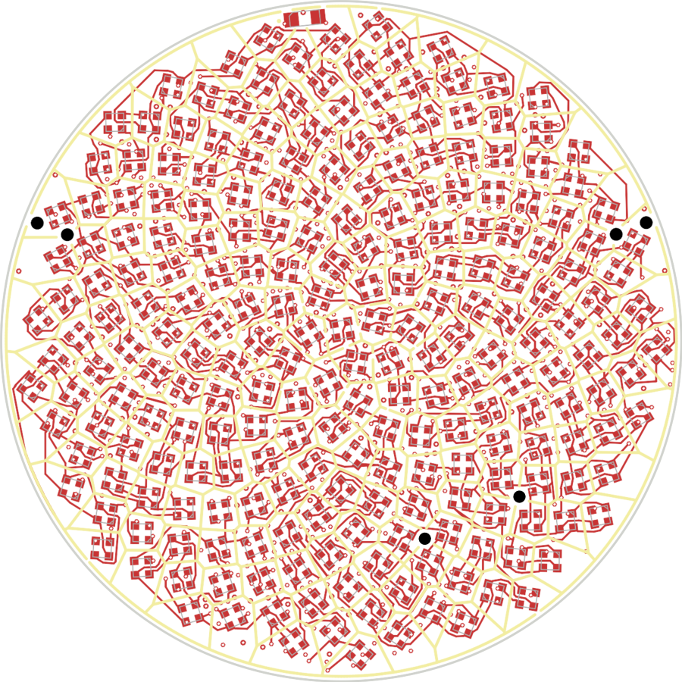
design/renders/round-pendant-f-usbc-rtc/top.png
