sequoia-hope/matrix-play/design/renders/round-pendant-f-usbc/B.Cu.png

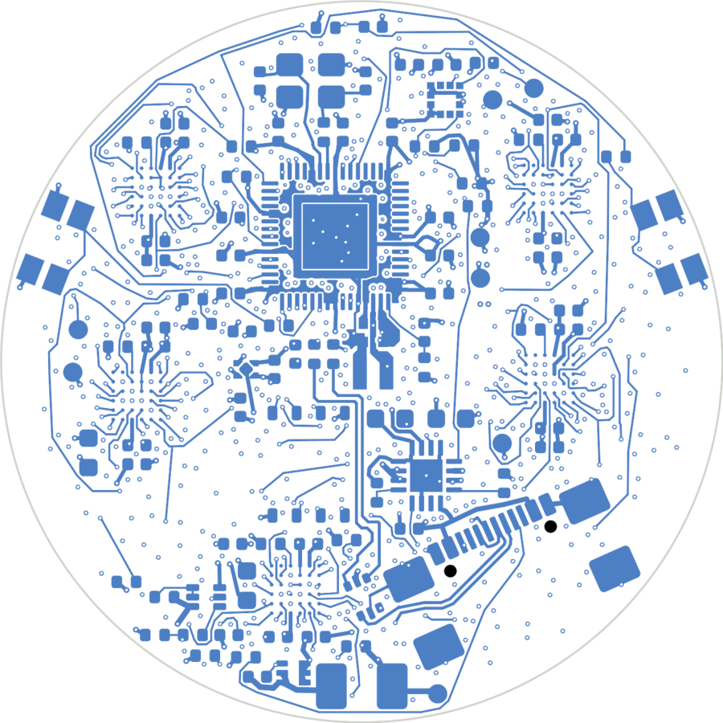
design/renders/round-pendant-f-usbc/B.Cu.png
