sequoia-hope/matrix-play/design/renders/round-pendant-f-usbc/cpl-check-top.png

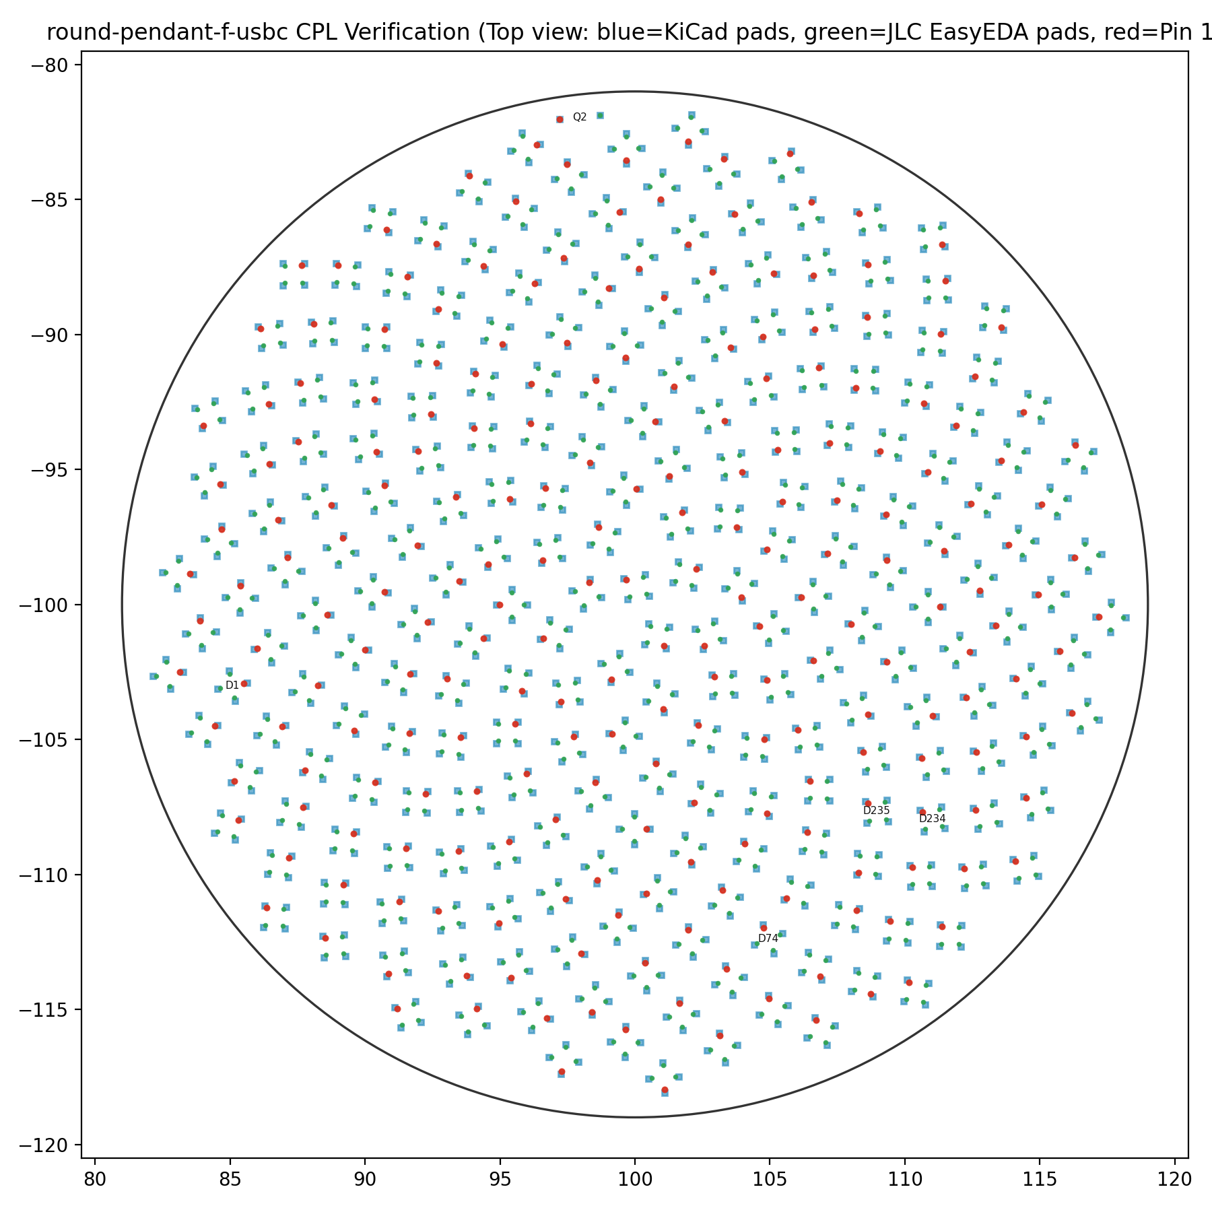
design/renders/round-pendant-f-usbc/cpl-check-top.png
