sequoia-hope/matrix-play/design/renders/round-pendant-f-usbc/gerbers/drill_round-pendant.png

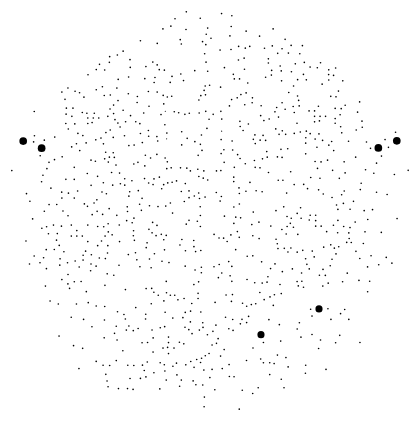
design/renders/round-pendant-f-usbc/gerbers/drill_round-pendant.png
