sequoia-hope/matrix-play/design/renders/round-pendant-f-usbc/gerbers/outline.png

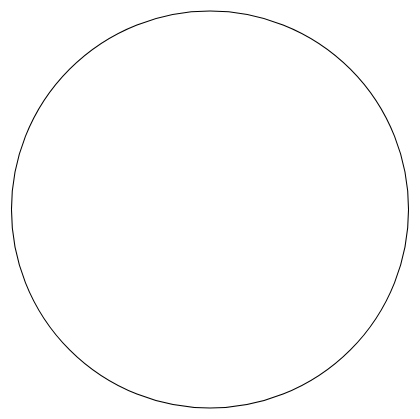
design/renders/round-pendant-f-usbc/gerbers/outline.png
