sequoia-hope/matrix-play/design/renders/round-pendant-f-usbc/In1.Cu.png

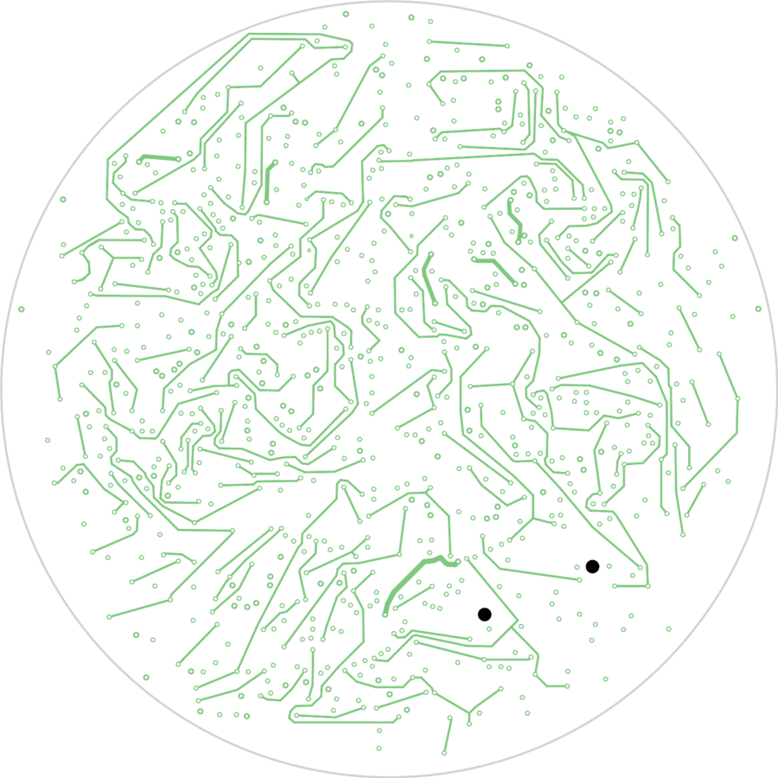
design/renders/round-pendant-f-usbc/In1.Cu.png
