sequoia-hope/matrix-play/design/renders/round-pendant-f-usbc/In6.Cu.png

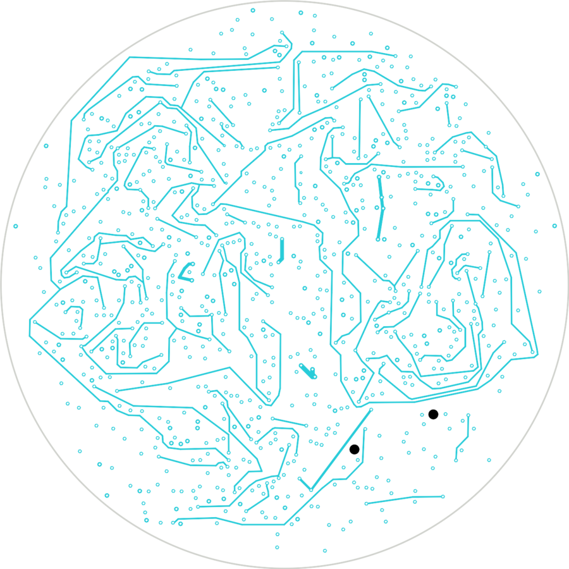
design/renders/round-pendant-f-usbc/In6.Cu.png
