sequoia-hope/matrix-play/design/renders/schematic/sheet-1.png

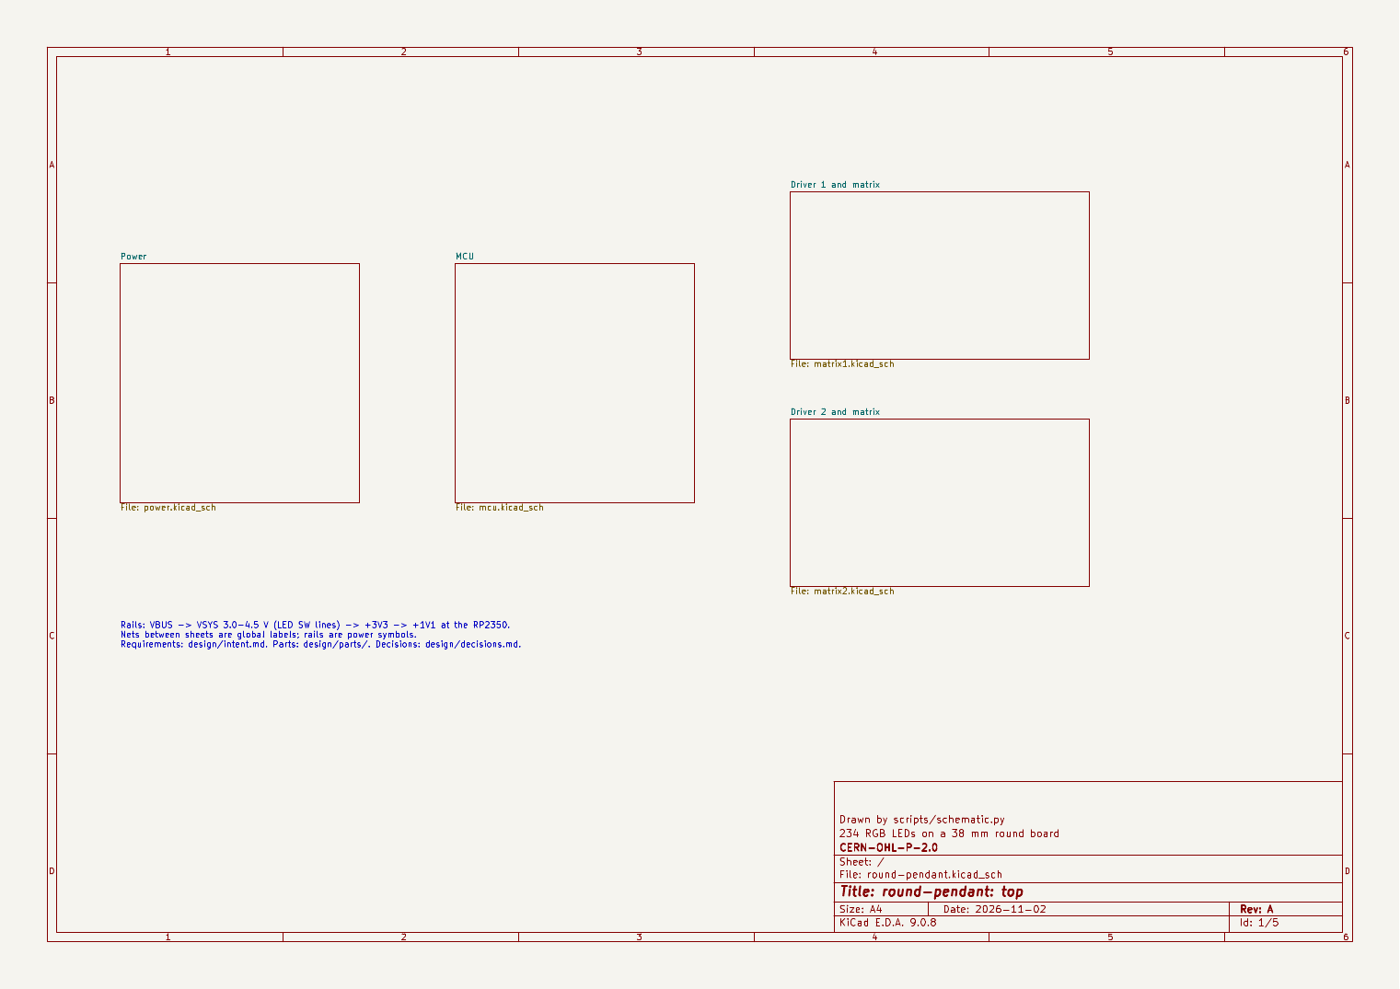
design/renders/schematic/sheet-1.png
