sequoia-hope/matrix-play/design/renders/schematic/sheet-3.png

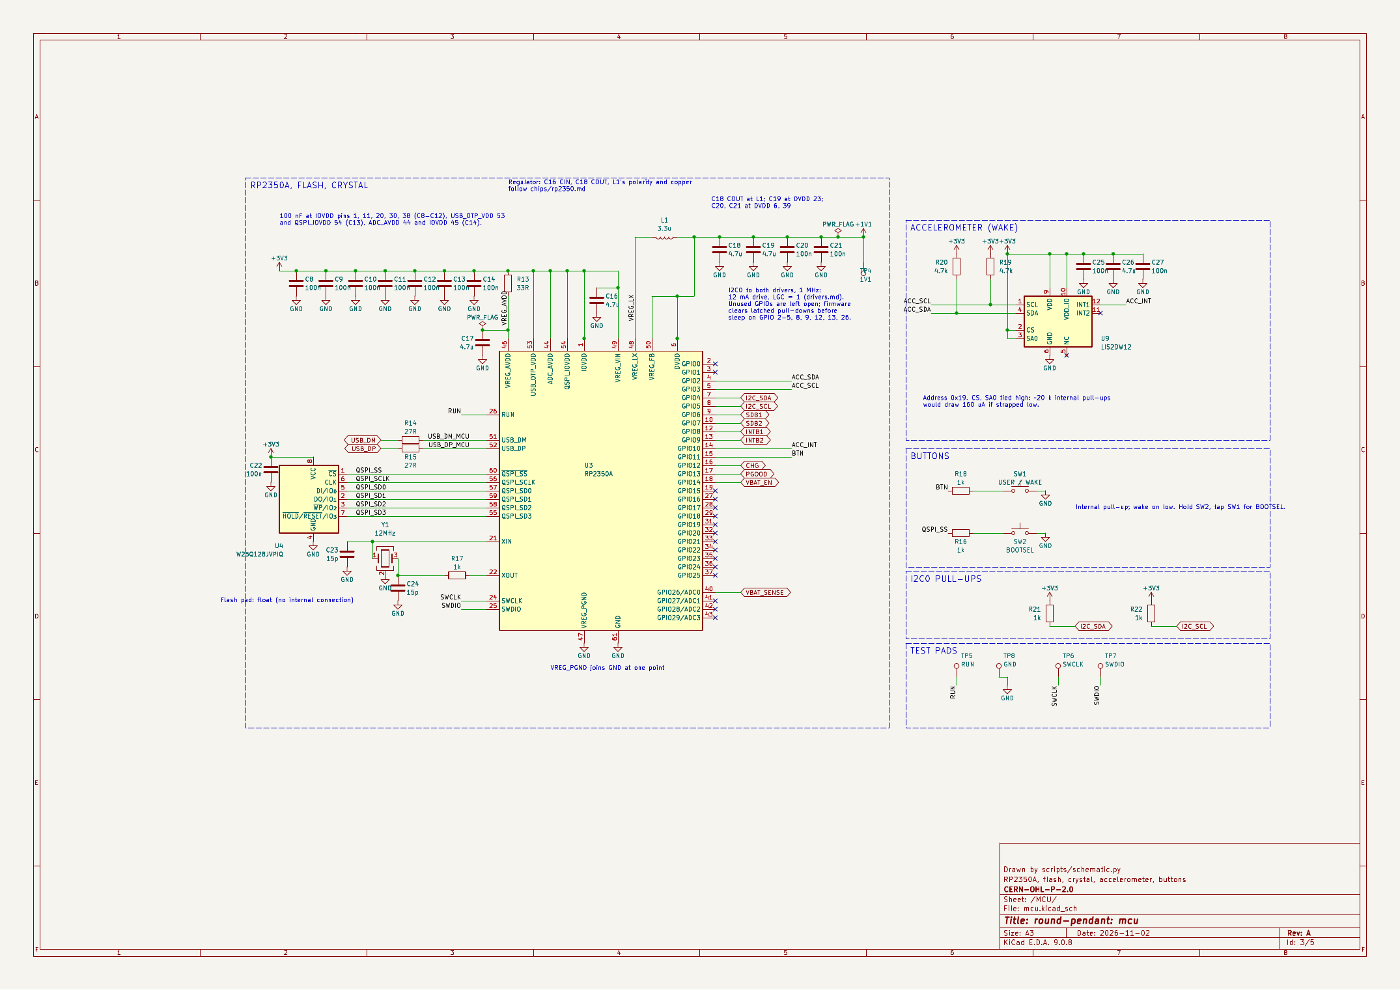
design/renders/schematic/sheet-3.png
