sequoia-hope/matrix-play/design/renders/schematic/sheet-4.png

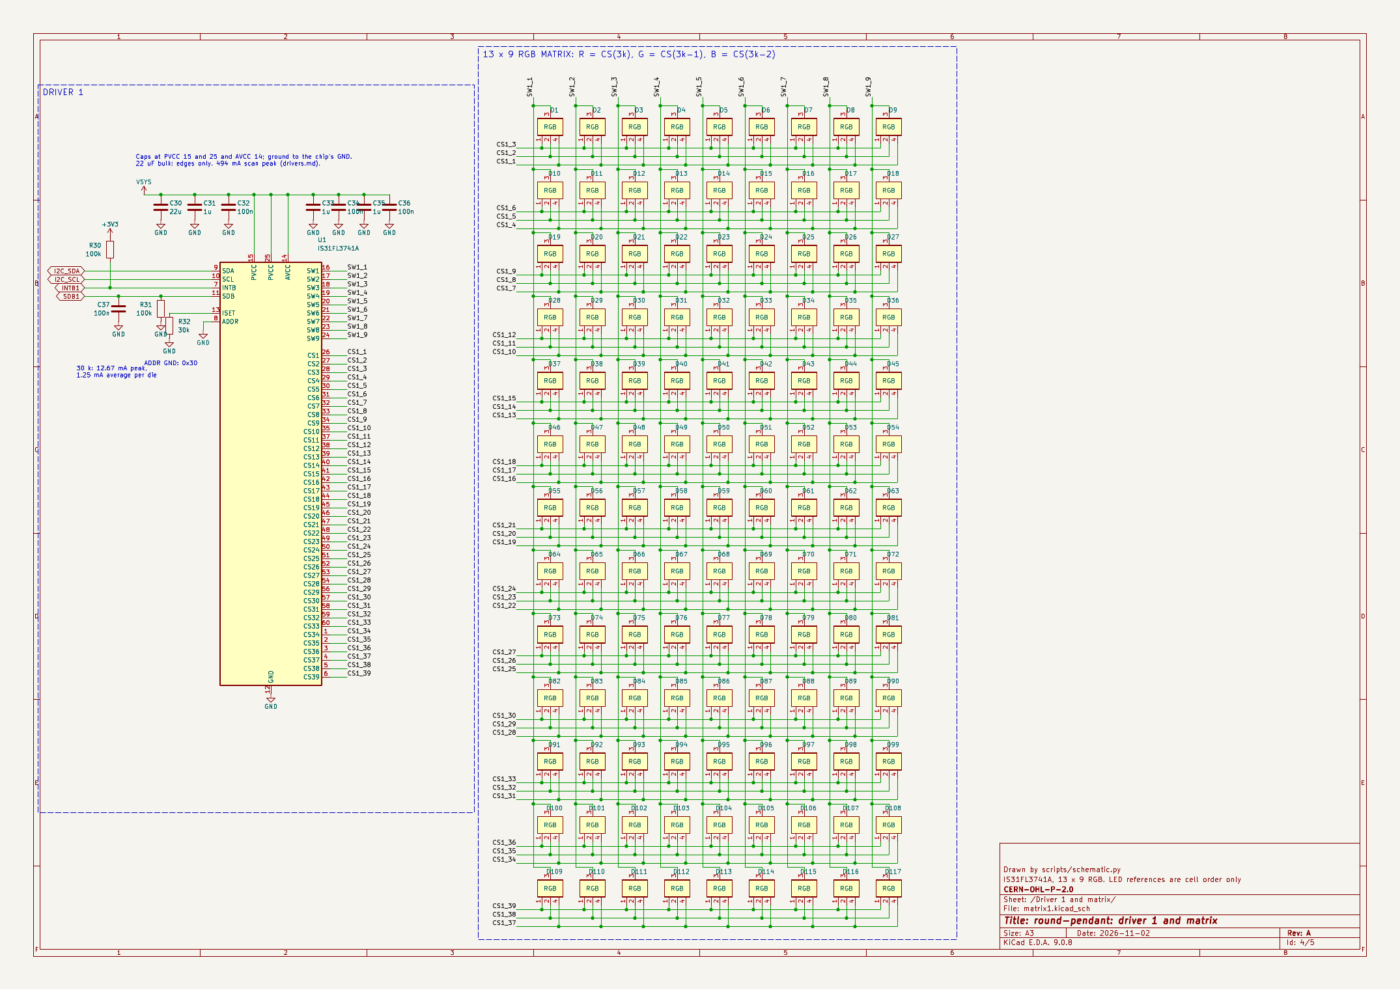
design/renders/schematic/sheet-4.png
