sequoia-hope/matrix-play/design/renders/sunflower-s2-110-usbc/3d-bottom.png

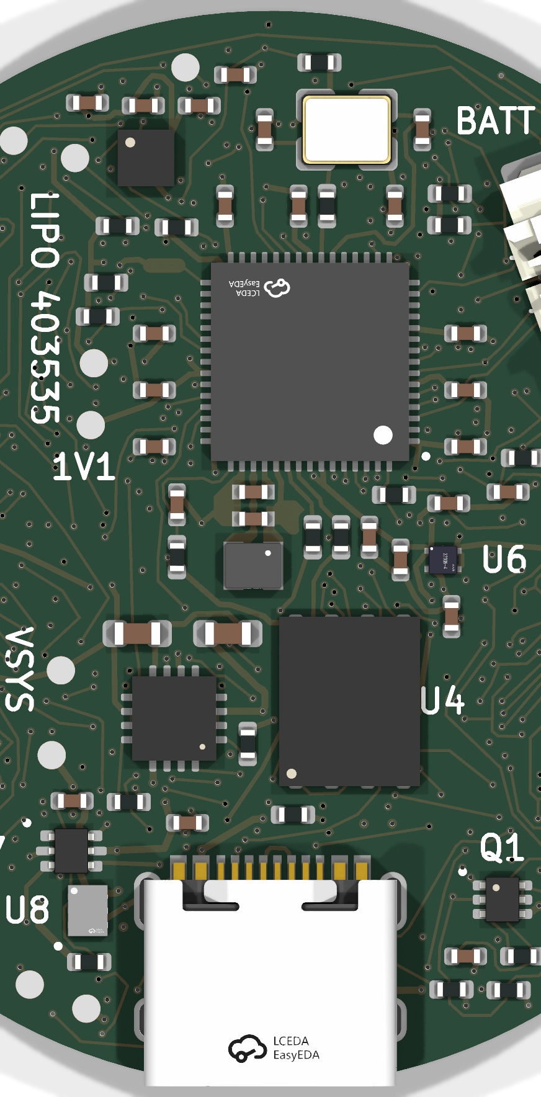
design/renders/sunflower-s2-110-usbc/3d-bottom.png
