sequoia-hope/matrix-play/design/renders/sunflower-s2-110-usbc/B.Cu.png

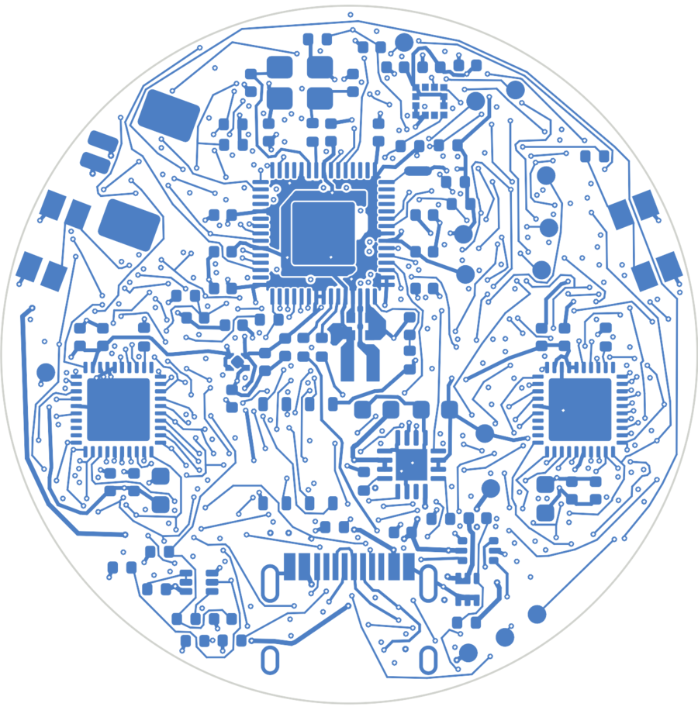
design/renders/sunflower-s2-110-usbc/B.Cu.png
