sequoia-hope/matrix-play/design/renders/sunflower-s2-110-usbc/bottom.png

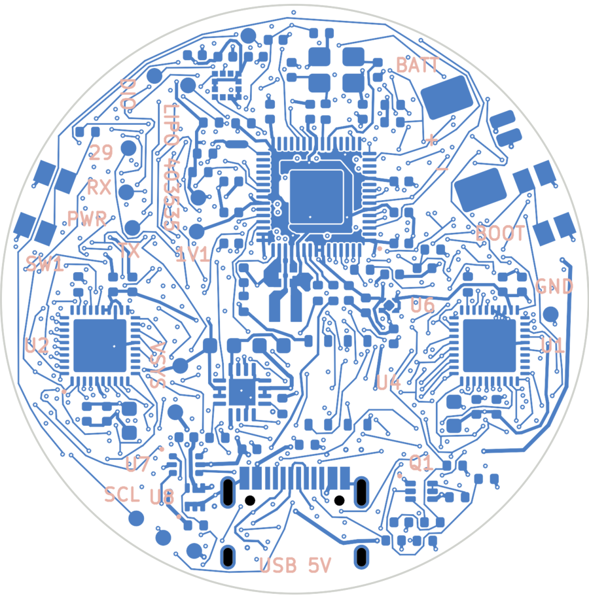
design/renders/sunflower-s2-110-usbc/bottom.png
