sequoia-hope/matrix-play/design/renders/sunflower-s2-110-usbc/gerbers/drill_sunflower.png

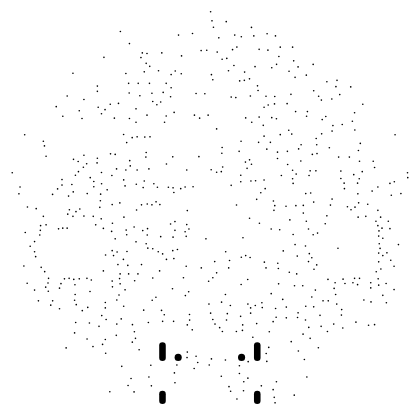
design/renders/sunflower-s2-110-usbc/gerbers/drill_sunflower.png
