sequoia-hope/matrix-play/design/renders/sunflower-s2-110-usbc/gerbers/sheet.png

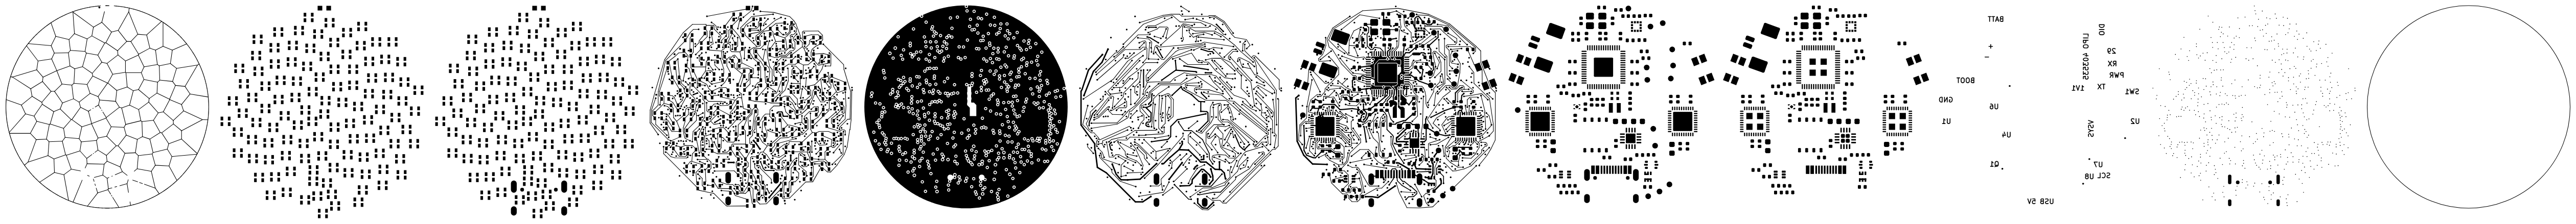
design/renders/sunflower-s2-110-usbc/gerbers/sheet.png
