sequoia-hope/matrix-play/design/renders/sunflower-s2-110-usbc/In1.Cu.png

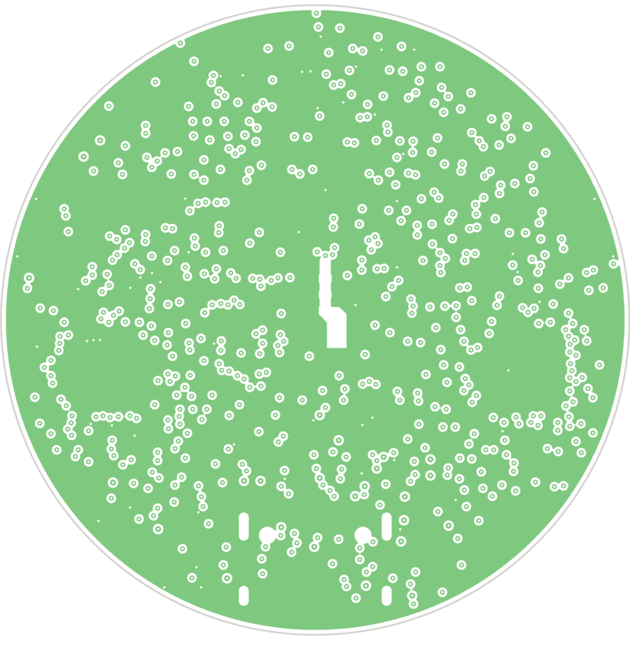
design/renders/sunflower-s2-110-usbc/In1.Cu.png
