sequoia-hope/matrix-play/design/renders/sunflower-s2-110-usbc/sch-page-3.png

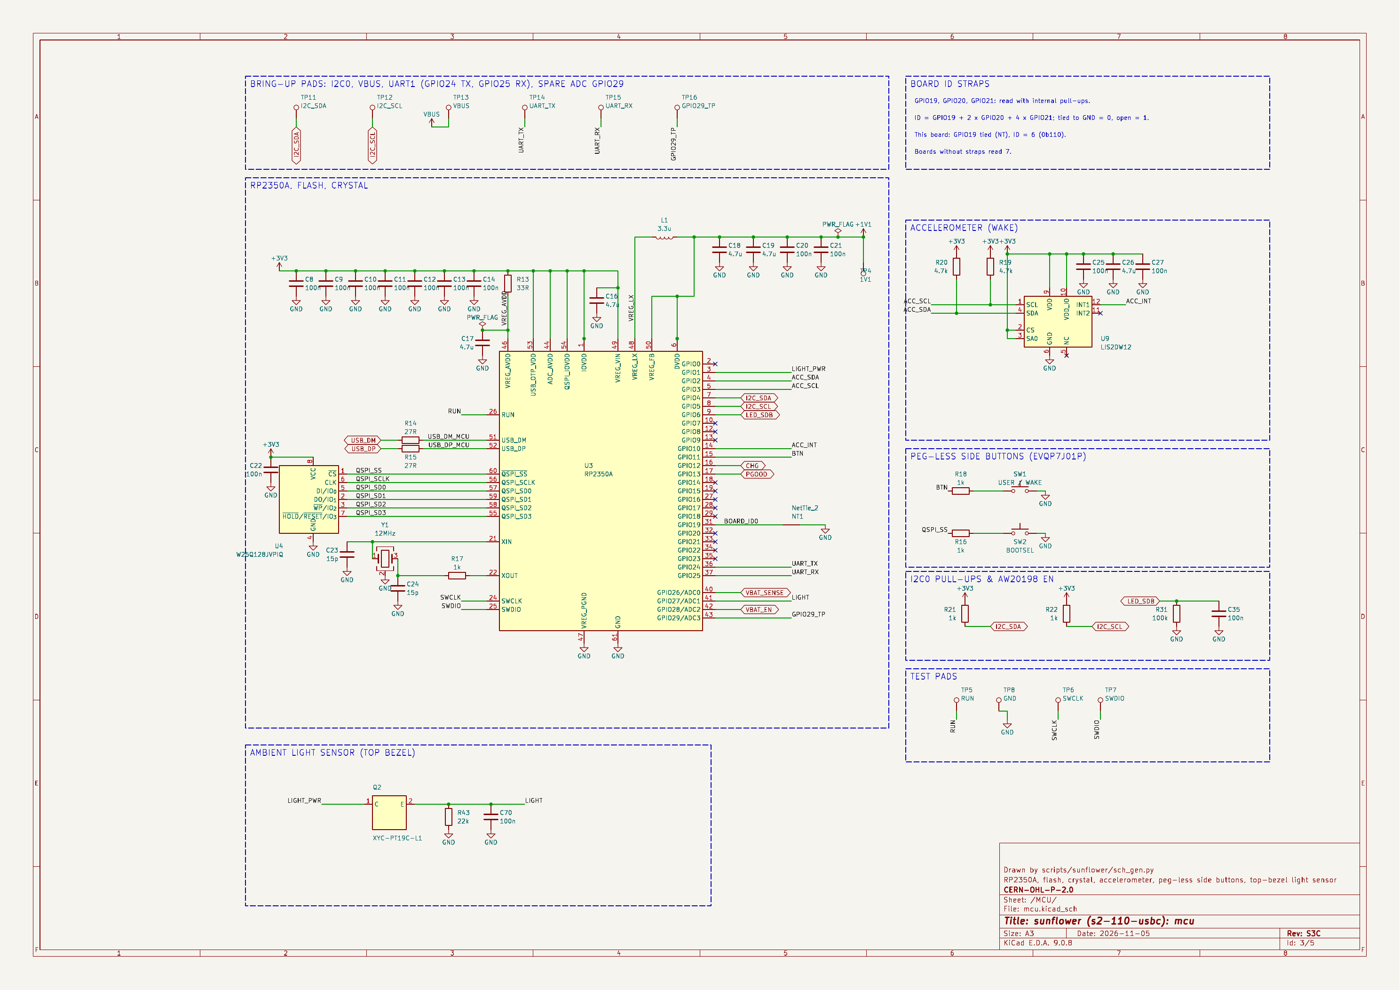
design/renders/sunflower-s2-110-usbc/sch-page-3.png
