sequoia-hope/matrix-play/design/sim/p2-132-usb6/debounce_esd.png

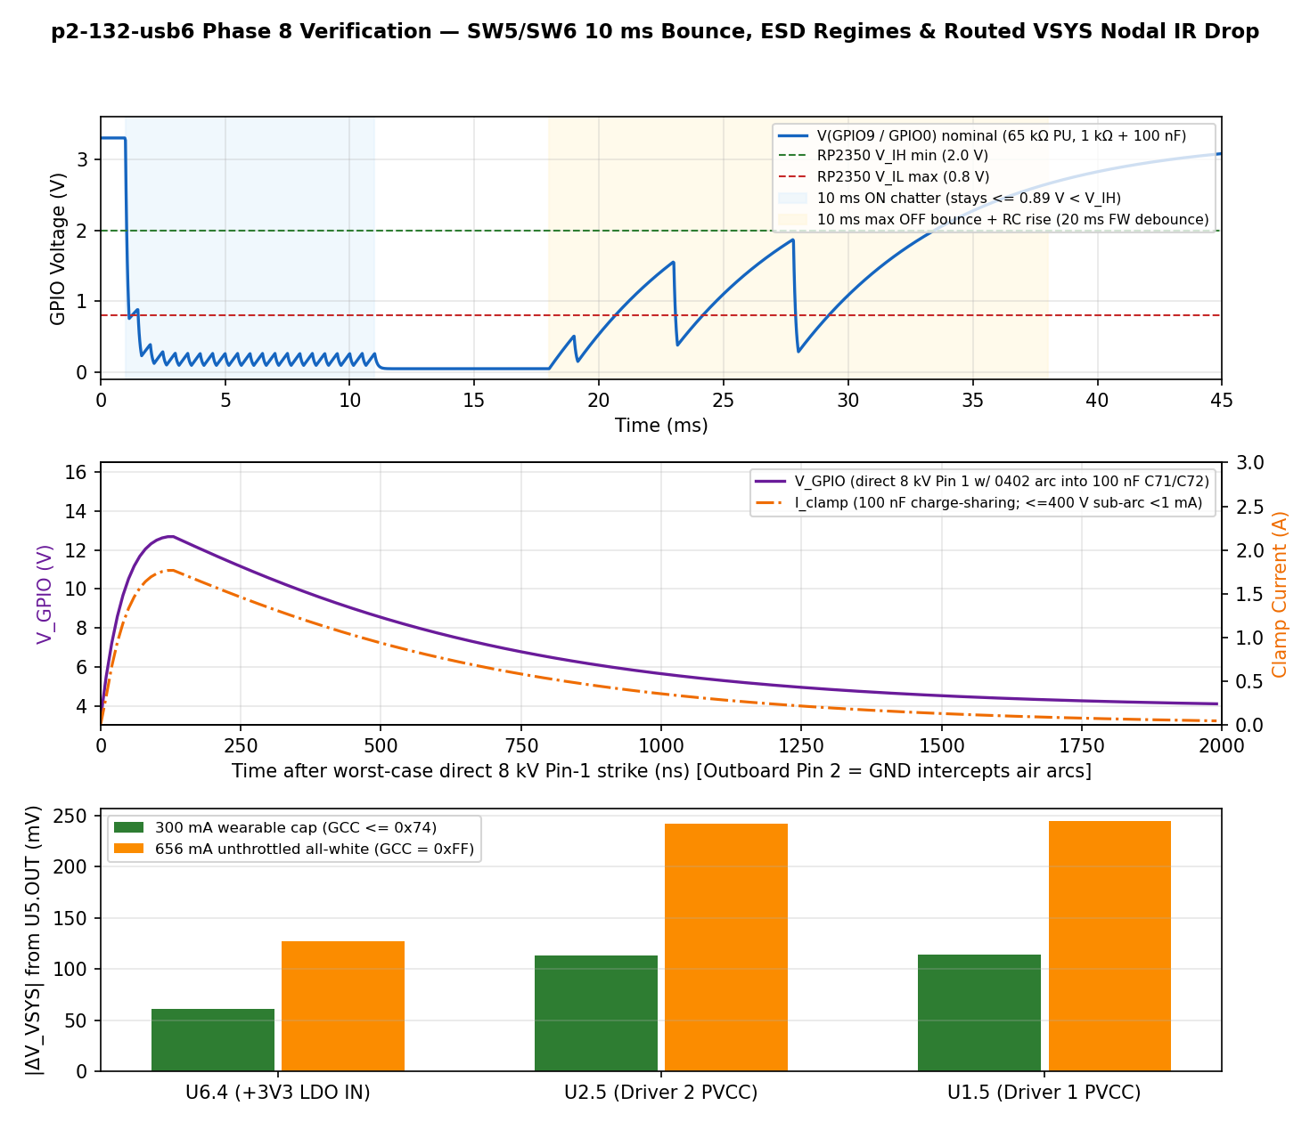
design/sim/p2-132-usb6/debounce_esd.png
