sequoia-hope/matrix-play/design/sim/p2-132/report/img/picoem_frames.png

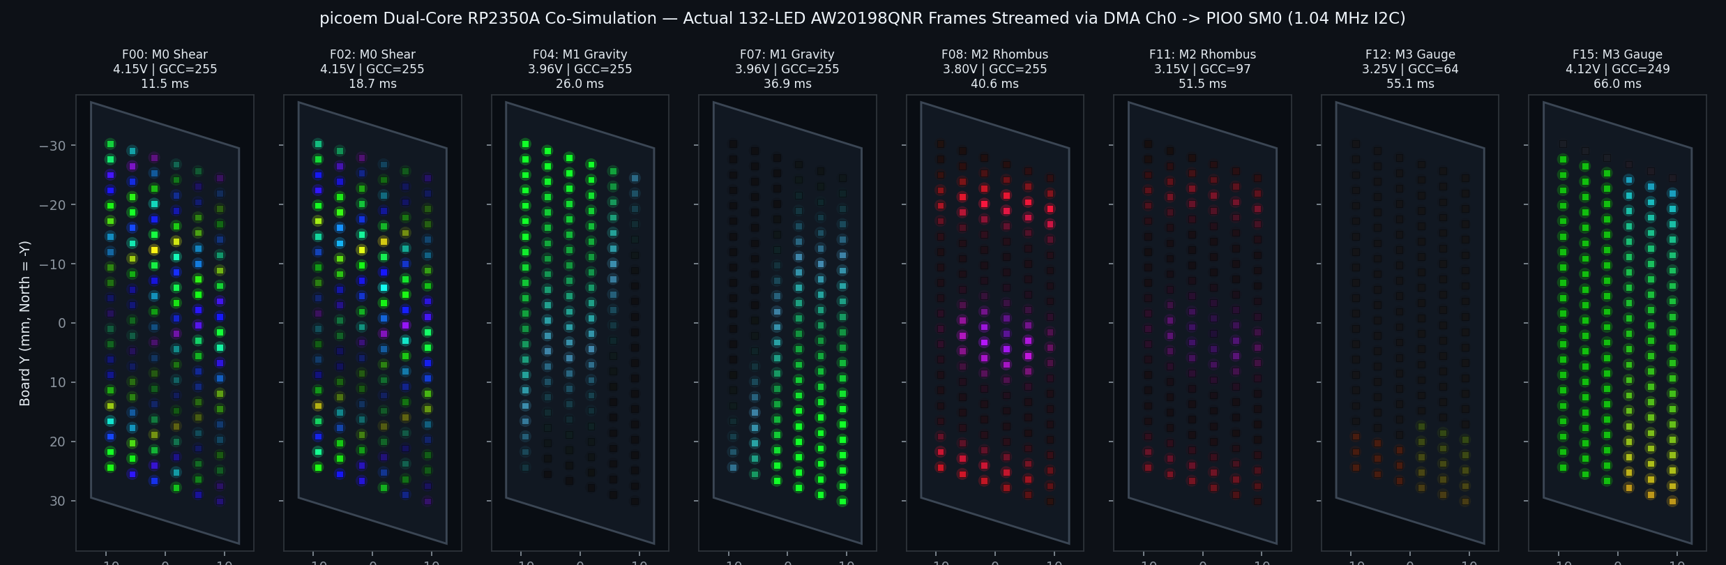
design/sim/p2-132/report/img/picoem_frames.png
