sequoia-hope/matrix-play/hw/round-pendant/f-usbc-rtc/fab/bom-jlcpcb.csv

Comment | Designator | Footprint | LCSC Part # | MPN | Manufacturer
A1251WR-S-2P | BT1 | Molex_PicoBlade_53261-0271_1x02-1MP_P1.25mm_Horizontal | C225111 | A1251WR-S-2P | CJT
1u | C1,C3,C4,C31,C34,C41,C44,C51,C54,C61,C64,C71,C74,C76 | C_0402_1005Metric | C52923 | CL05A105KA5NQNC | Samsung Electro-Mechanics
22u | C2,C30,C40 | C_0603_1608Metric | C86295 | CL10A226MP8NUNE | Samsung Electro-Mechanics
10u | C5 | C_0603_1608Metric | C19702 | CL10A106KP8NNNC | Samsung Electro-Mechanics
100n | C6,C7,C8,C9,C10,C11,C12,C13,C14,C20,C21,C22,C25,C27,C32,C33,C35,C42,C43,C52,C53,C62,C63,C70,C72,C73,C75 | C_0402_1005Metric | C1525 | CL05B104KO5NNNC | Samsung Electro-Mechanics
4.7u | C16,C18 | C_0402_1005Metric_small_pads | C23733 | CL05A475MP5NRNC | Samsung Electro-Mechanics
4.7u | C17,C19,C26 | C_0402_1005Metric | C23733 | CL05A475MP5NRNC | Samsung Electro-Mechanics
15p | C23,C24 | C_0402_1005Metric | C1548 | 0402CG150J500NT | FH
RGB | D1,D2,D3,D4,D5,D6,D7,D8,D9,D10,D11,D12,D13,D14,D15,D16,D17,D18,D19,D20,D21,D22,D23,D24,D25,D26,D27,D28,D29,D30,D31,D32,D33,D34,D35,D36,D37,D38,D39,D40,D41,D42,D43,D44,D45,D46,D47,D48,D49,D50,D51,D52,D53,D54,D55,D56,D57,D58,D59,D60,D61,D62,D63,D64,D65,D66,D67,D68,D69,D70,D71,D72,D73,D74,D75,D76,D77,D78,D79,D80,D81,D82,D83,D84,D85,D86,D87,D88,D89,D90,D91,D92,D93,D94,D95,D96,D97,D98,D99,D100,D101,D102,D103,D104,D105,D106,D107,D108,D109,D110,D111,D112,D113,D114,D115,D116,D117,D118,D119,D120,D121,D122,D123,D124,D125,D126,D127,D128,D129,D130,D131,D132,D133,D134,D135,D136,D137,D138,D139,D140,D141,D142,D143,D144,D145,D146,D147,D148,D149,D150,D151,D152,D153,D154,D155,D156,D157,D158,D159,D160,D161,D162,D163,D164,D165,D166,D167,D168,D169,D170,D171,D172,D173,D174,D175,D176,D177,D178,D179,D180,D181,D182,D183,D184,D185,D186,D187,D188,D189,D190,D191,D192,D193,D194,D195,D196,D197,D198,D199,D200,D201,D202,D203,D204,D205,D206,D207,D208,D209,D210,D211,D212,D213,D214,D215,D216,D217,D218,D219,D220,D221,D222,D223,D224,D225,D226,D227,D228,D229,D230,D231,D232,D233,D234,D235 | LED_XL-1010RGB | C965834 | XL-1010RGB-YG | XINGLIGHT
TYPE-C-31-M-22 | J1 | USB_C_Receptacle_Hroparts_TYPE-C-31-M-22 | C530612 | TYPE-C-31-M-22 | Korean Hroparts Elec
3.3u | L1 | L_pol_2016 | C42411119 | AOTA-B201610S3R3-101-T | Abracon
NTZD3155C | Q1 | SOT-563 | C236117 | NTZD3155CT1G | onsemi
ALS-PT19 | Q2 | SENSOR_ALS-PT19 | C146233 | ALS-PT19-315C/L177/TR8 | EVERLIGHT
5.1k | R1,R2 | R_0402_1005Metric | C25905 | 0402WGF5101TCE | UNI-ROYAL
10k | R3 | R_0402_1005Metric | C25744 | 0402WGF1002TCE | UNI-ROYAL
3k | R4 | R_0402_1005Metric | C25784 | 0402WGF3001TCE | UNI-ROYAL
3.6k | R5 | R_0402_1005Metric | C25891 | 0402WGF3601TCE | UNI-ROYAL
100k | R6,R7,R9,R10,R11,R12,R31,R32 | R_0402_1005Metric | C25741 | 0402WGF1003TCE | UNI-ROYAL
100R | R8 | R_0402_1005Metric | C25076 | 0402WGF1000TCE | UNI-ROYAL
33R | R13 | R_0402_1005Metric | C25105 | 0402WGF330JTCE | UNI-ROYAL
27R | R14,R15 | R_0402_1005Metric | C25100 | 0402WGF270JTCE | UNI-ROYAL
1k | R16,R17,R18,R21,R22 | R_0402_1005Metric | C11702 | 0402WGF1001TCE | UNI-ROYAL
4.7k | R19,R20 | R_0402_1005Metric | C25900 | 0402WGF4701TCE | UNI-ROYAL
30k | R30,R33,R50,R60,R70 | R_0402_1005Metric | C25776 | 0402WGF3002TCE | UNI-ROYAL
22k | R43 | R_0402_1005Metric | C25768 | 0402WGF2202TCE | UNI-ROYAL
USER / WAKE | SW1 | SW_Panasonic_EVQP7C | C388883 | EVQP7C01P | PANASONIC
BOOTSEL | SW2 | SW_Panasonic_EVQP7C | C388883 | EVQP7C01P | PANASONIC
IS31FL3745 | U1,U2,U10,U11,U12 | WLCSP-36_2.9x2.9mm_P0.5mm | C2678907 | IS31FL3745-CLS4-TR | ISSI
RP2350A | U3 | RP2350-QFN-60-1EP_7x7_P0.4mm_EP3.4x3.4mm_ThermalVias | C42411118 | RP2350A | Raspberry Pi
W25Q128JVPIQ | U4 | WSON-8_6x5mm_P1.27mm_NoEPCopper | C190862 | W25Q128JVPIQ | Winbond
BQ24073 | U5 | QFN-16-1EP_3x3mm_P0.5mm_EP1.7x1.7mm | C15220 | BQ24073RGTR | Texas Instruments
TPS7A0233 | U6 | Texas_X2SON-4_1x1mm_P0.65mm | C2860046 | TPS7A0233PDQNR | Texas Instruments
USBLC6-2P6 | U7 | SOT-666 | C15999 | USBLC6-2P6 | STMicroelectronics
XB9901A | U8 | XySemi_DFN-6_1.8x1.4mm | C669687 | XB9901A | XySemi
LIS2DW12 | U9 | LGA-12_2x2mm_P0.5mm | C189624 | LIS2DW12TR | STMicroelectronics
RX8130CE | U13 | Seiko_Epson_RX8130CE_3.2x2.5mm_P0.7mm | C1542426 | RX8130CE:BB | Seiko Epson
12MHz | Y1 | Crystal_SMD_3225-4Pin_3.2x2.5mm | C20625731 | ABM8-272-T3 | Abracon
