sequoia-hope/matrix-play/3dmodels/RTC-SMD_L3.2-W2.5-P0.7-RX8130CE.step

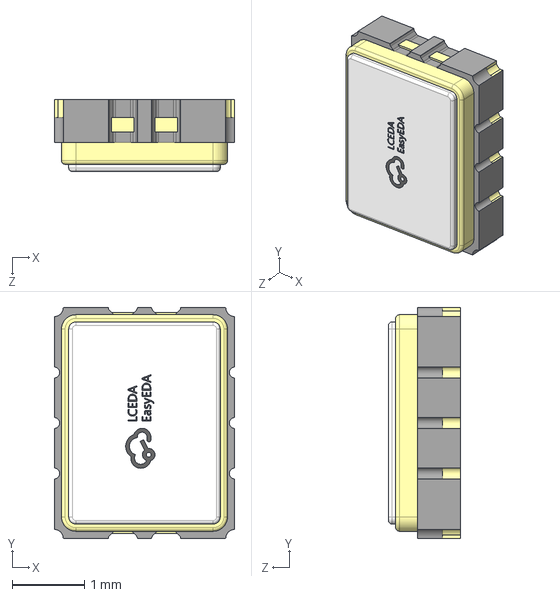
[picture p67: CAD file, 2026-11-10]
3dmodels/RTC-SMD_L3.2-W2.5-P0.7-RX8130CE.step
2.50 x 3.20 x 1.00 mm
