sequoia-hope/matrix-play/design/renders/sunflower-s2-110-usbc/sunflower-s2-110-usbc.step

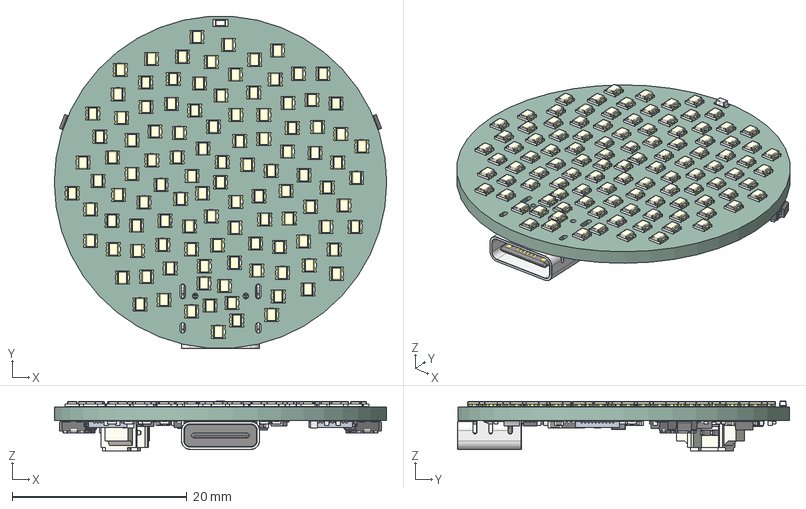
[picture p68: CAD file, 2026-11-09]
design/renders/sunflower-s2-110-usbc/sunflower-s2-110-usbc.step
38.0 x 37.9 x 5.68 mm
LED-ARRAY-SMD_4P-L1.6-W1.5-BR_XL-1615RGBC-RF x 110
SENSORS-SMD_L1.7-W0.8-H0.6
R_0402_1005Metric x 26
C_0603_1608Metric x 4
C_0402_1005Metric x 34
SW-SMD_EVQP7C01P-L3.6-W3.5-H1.4-P3.6-LS4.7 x 2
X2SON-4_L1.0-W1.0-H0.4-P0.65-TL-EPSLDPRT
LGA-12_2x2mm_P0.5mm
QFN-16-1EP_3x3mm_P0.5mm_EP1.7x1.7mm
USB-C-SMD_TYPE-C-31-M-12
DFNFC-6_L1.8-W1.4-H0.6-P0.50-BL_XB9901A
WSON-8-1EP_6x5mm_P1.27mm_EP3.4x4.3mm
Molex_PicoBlade_53261-0271_1x02-1MP_P1.25mm_Horizontal
SOT-666
IND-SMD_L2.0-W1.6_AOTA-B201610S3R3-101-T
Crystal_SMD_3225-4Pin_3.2x2.5mm
sunflower-s2-110-usbc 1.176.1 x 2
QFN-60_L7.0-W7.0-P0.40-TL-EP3.4
SOT-563
sunflower_PCB
