sequoia-hope/matrix-play/hw/parallelogram/p2-132-usb6/fab/parallelogram-p2-132-usb6.step

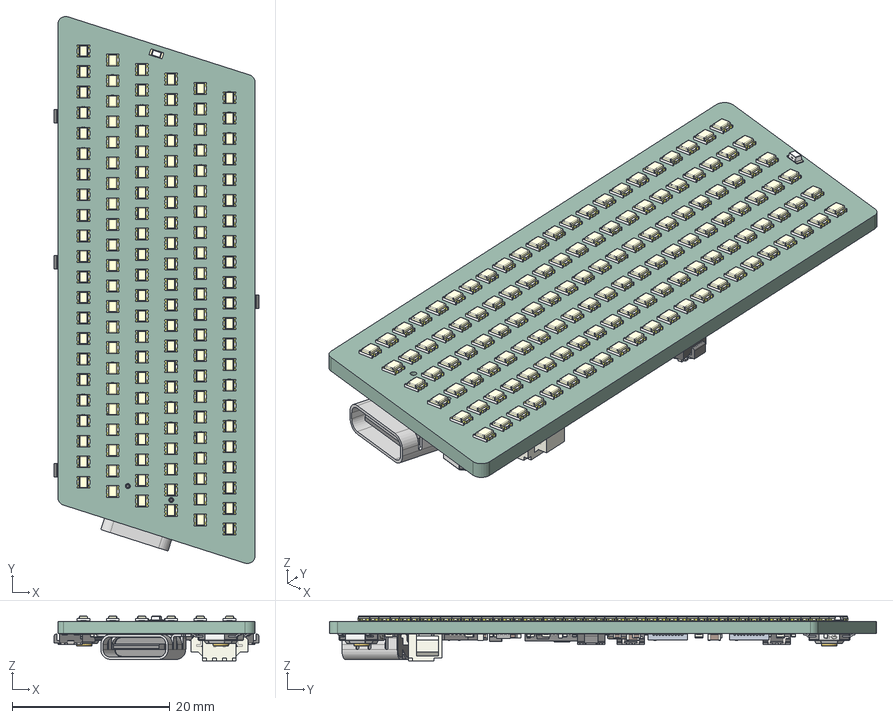
[picture p69: CAD file, 2026-11-09]
hw/parallelogram/p2-132-usb6/fab/parallelogram-p2-132-usb6.step
25.9 x 69.3 x 5.68 mm
LED-ARRAY-SMD_4P-L1.6-W1.5-BR_XL-1615RGBC-RF x 132
SENSORS-SMD_L1.7-W0.8-H0.6
R_0402_1005Metric x 30
C_0603_1608Metric x 4
Molex_PicoBlade_53261-0271_1x02-1MP_P1.25mm_Horizontal
C_0402_1005Metric x 36
SW-SMD_EVQP7C01P-L3.6-W3.5-H1.4-P3.6-LS4.7 x 4
SW-SMD_4P-L5.1-W5.1-P3.70-LS6.5-TL_H1.5 x 2
parallelogram-p2-132-usb6 1.152.1 x 2
SOT-563
Crystal_SMD_3225-4Pin_3.2x2.5mm
LGA-12_2x2mm_P0.5mm
X2SON-4_L1.0-W1.0-H0.4-P0.65-TL-EPSLDPRT
QFN-16-1EP_3x3mm_P0.5mm_EP1.7x1.7mm
IND-SMD_L2.0-W1.6_AOTA-B201610S3R3-101-T
WSON-8-1EP_6x5mm_P1.27mm_EP3.4x4.3mm
SOT-666
DFNFC-6_L1.8-W1.4-H0.6-P0.50-BL_XB9901A
USB-C-SMD_TYPE-C-31-M-22
QFN-60_L7.0-W7.0-P0.40-TL-EP3.4
parallelogram_PCB
