sequoia-hope/matrix-play/hw/round-pendant/f-usbc/fab/round-pendant-f-usbc.step

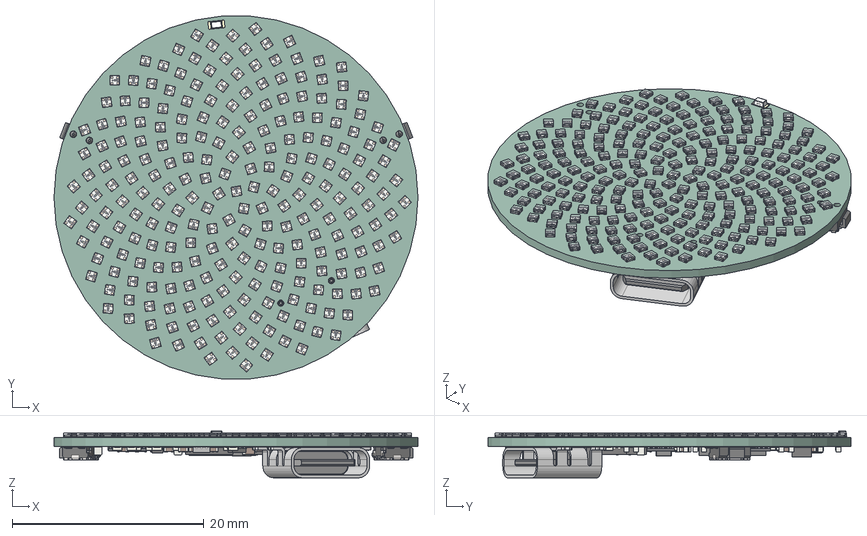
[picture p71: CAD file, 2026-11-09]
hw/round-pendant/f-usbc/fab/round-pendant-f-usbc.step
38.0 x 37.9 x 4.88 mm
p1 x 235
p2 x 235
p3 x 235
p4 x 235
p5 x 235
p6 x 235
p7 x 235
p8 x 235
p9 x 235
p10 x 235
p11 x 235
p12 x 235
p13 x 235
p14 x 235
p15 x 235
p16 x 235
p17 x 235
p18 x 235
p19 x 235
SENSORS-SMD_L1.7-W0.8-H0.6
C_0402_1005Metric x 46
SW-SMD_EVQP7C01P-L3.6-W3.5-H1.4-P3.6-LS4.7 x 2
C_0603_1608Metric x 4
USB-C-SMD_TYPE-C-31-M-22
QFN-60_L7.0-W7.0-P0.40-TL-EP3.4
LGA-12_2x2mm_P0.5mm
R_0402_1005Metric x 29
die x 5
b1 x 5
b2 x 5
b3 x 5
b4 x 5
b5 x 5
b6 x 5
b7 x 5
b8 x 5
b9 x 5
b10 x 5
b11 x 5
b12 x 5
b13 x 5
b14 x 5
b15 x 5
b16 x 5
b17 x 5
b18 x 5
b19 x 5
b20 x 5
b21 x 5
b22 x 5
b23 x 5
b24 x 5
b25 x 5
b26 x 5
b27 x 5
b28 x 5
b29 x 5
b30 x 5
b31 x 5
b32 x 5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
