sequoia-hope/matrix-play/3dmodels/LED-ARRAY-SMD_4P-L0.80-W0.80-H0.6-BR_MHPA0808RGBDT.step

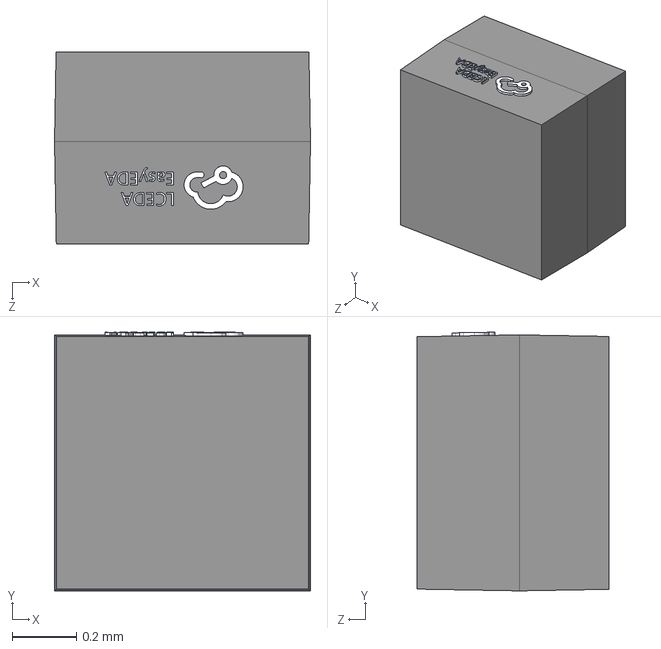
[picture p72: CAD file, 2026-11-06]
3dmodels/LED-ARRAY-SMD_4P-L0.80-W0.80-H0.6-BR_MHPA0808RGBDT.step
0.8 x 0.809 x 0.6 mm
