sequoia-hope/matrix-play/3dmodels/WLCSP-36_2.9x2.9mm_P0.5mm.step

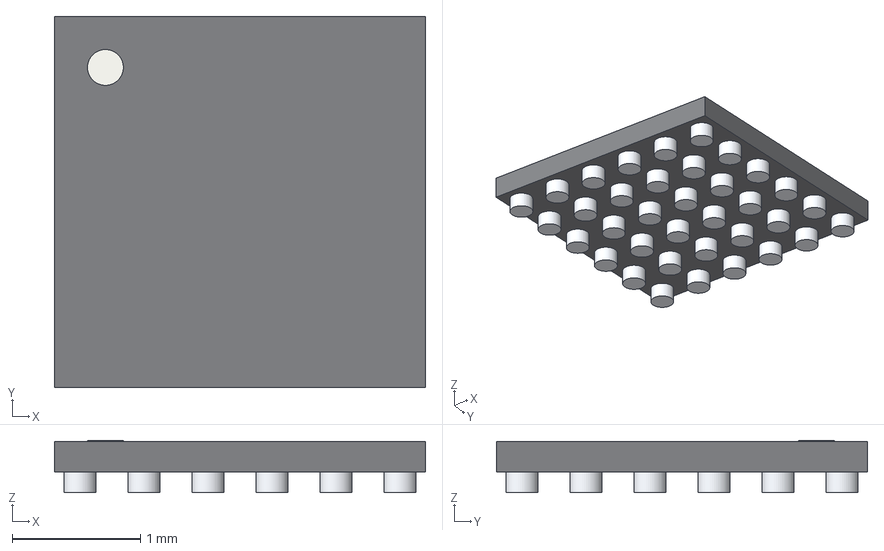
[picture p73: CAD file, 2026-11-05]
3dmodels/WLCSP-36_2.9x2.9mm_P0.5mm.step
2.90 x 2.90 x 0.408 mm
die
b1
b2
b3
b4
b5
b6
b7
b8
b9
b10
b11
b12
b13
b14
b15
b16
b17
b18
b19
b20
b21
b22
b23
b24
b25
b26
b27
b28
b29
b30
b31
b32
b33
b34
b35
b36
pin1_mark
