sequoia-hope/matrix-play/3dmodels/XL-1010RGB-YG.step

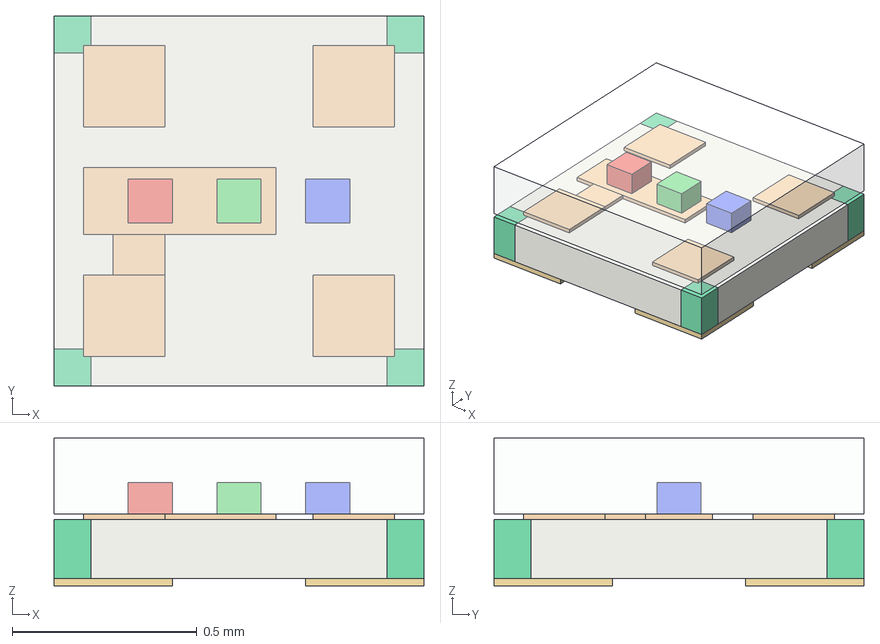
[picture p74: CAD file, 2026-11-03]
3dmodels/XL-1010RGB-YG.step
1.00 x 1.00 x 0.4 mm
p1
p2
p3
p4
p5
p6
p7
p8
p9
p10
p11
p12
p13
p14
p15
p16
p17
p18
p19
