sequoia-hope/matrix-play/3dmodels/DFNFC-6_L1.8-W1.4-H0.6-P0.50-BL_XB9901A.step

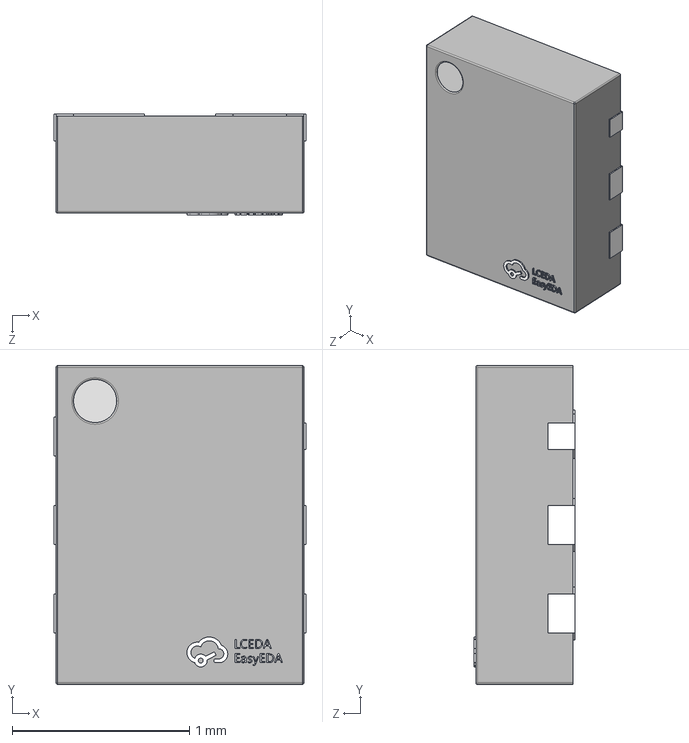
[picture p75: CAD file, 2026-11-03]
3dmodels/DFNFC-6_L1.8-W1.4-H0.6-P0.50-BL_XB9901A.step
1.42 x 1.80 x 0.57 mm
