sequoia-hope/matrix-play/design/renders/parallelogram-p2-132-usb6/assembly-top.pdf

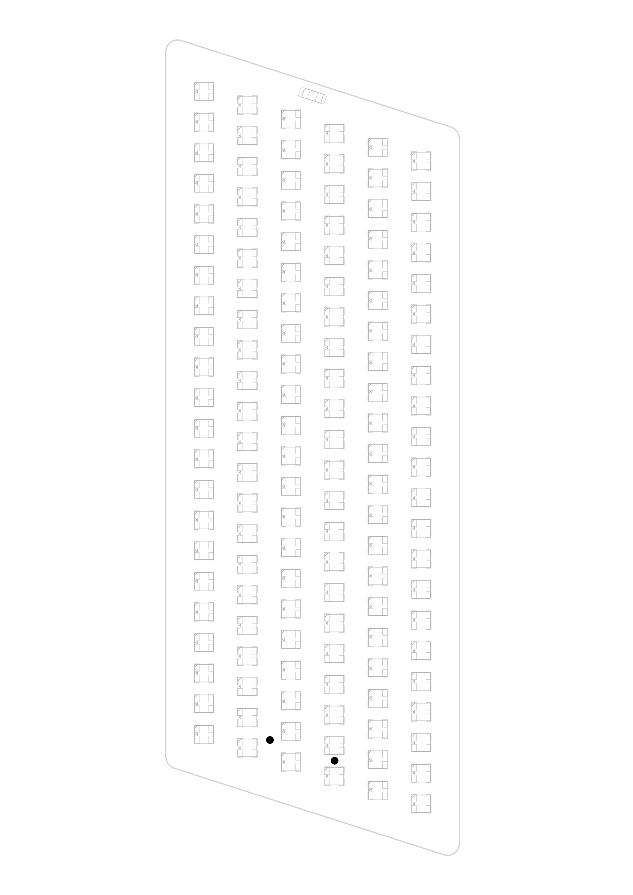
[picture p76: page 1]
