sequoia-hope/matrix-play/design/renders/sunflower-s2-110-usbc/assembly-bottom.pdf

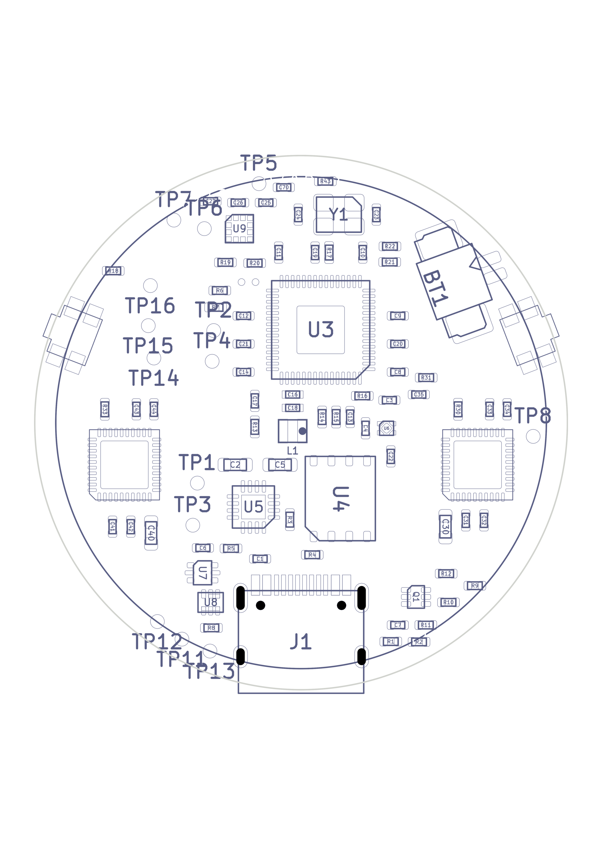
[picture p77: page 1]
