sequoia-hope/matrix-play/design/renders/sunflower-s2-110-usbc/assembly-top.pdf

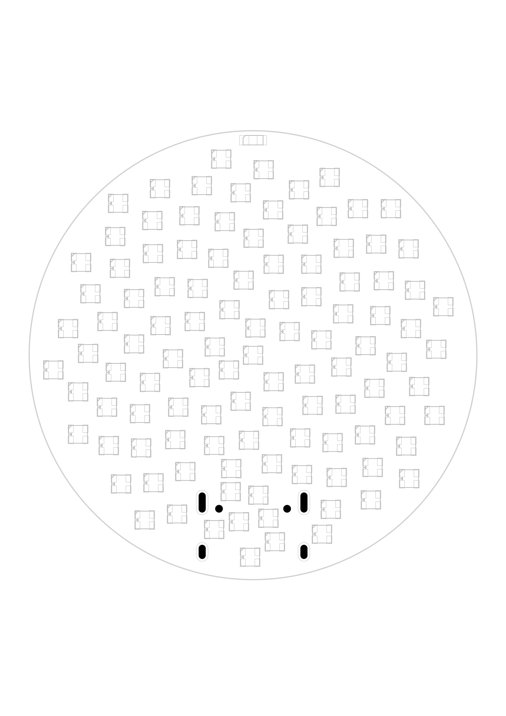
[picture p78: page 1]
