sequoia-hope/matrix-play/hw/parallelogram/p2-132-usb6/fab/assembly-bottom.pdf

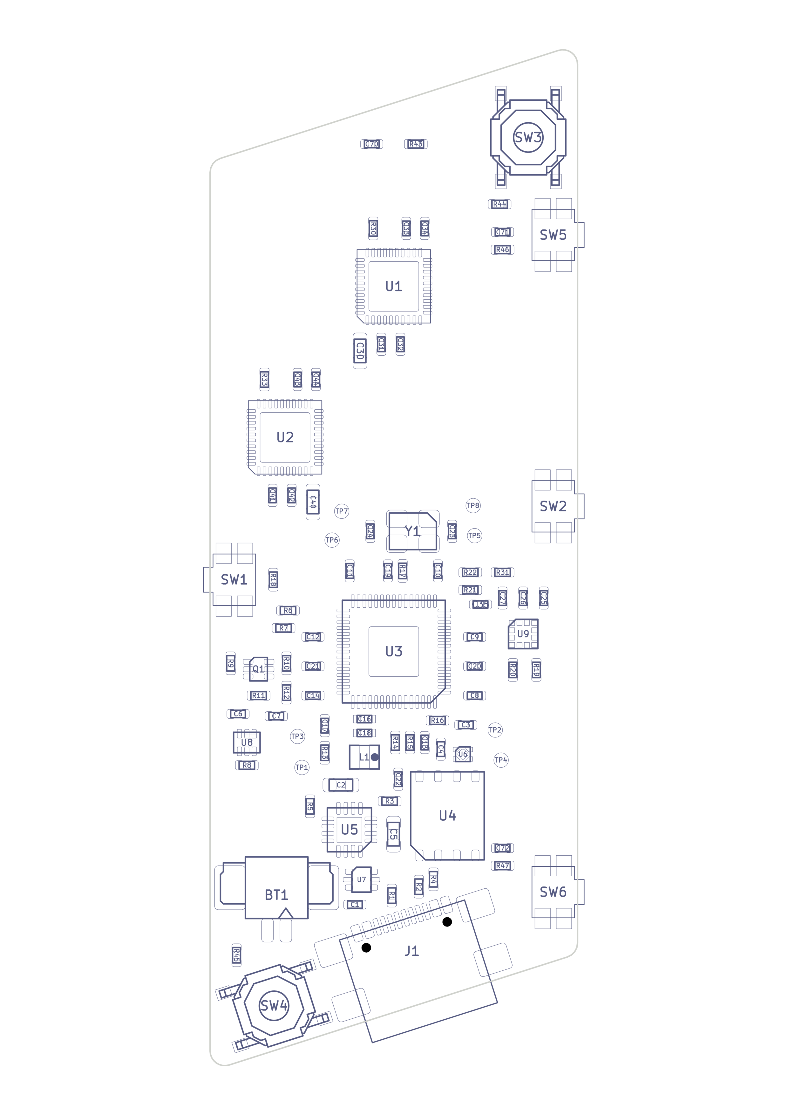
[picture p79: page 1]
