sequoia-hope/matrix-play/design/renders/b/assembly-top.pdf

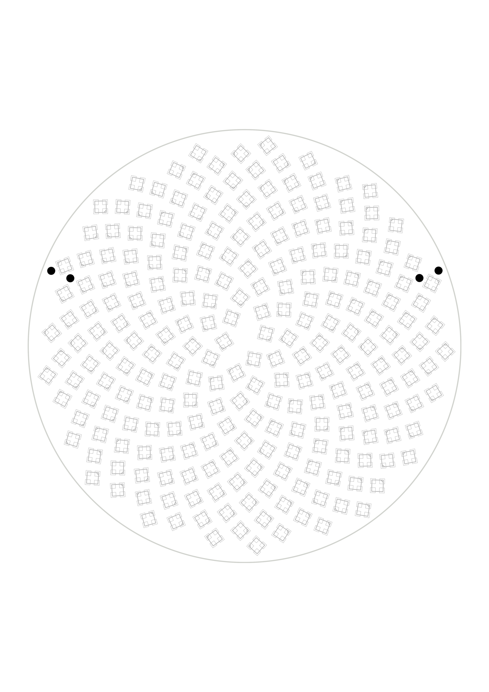
[picture p80: page 1]
