sequoia-hope/matrix-play/design/renders/parallelogram-p2-132-usb6/assembly-bottom.png

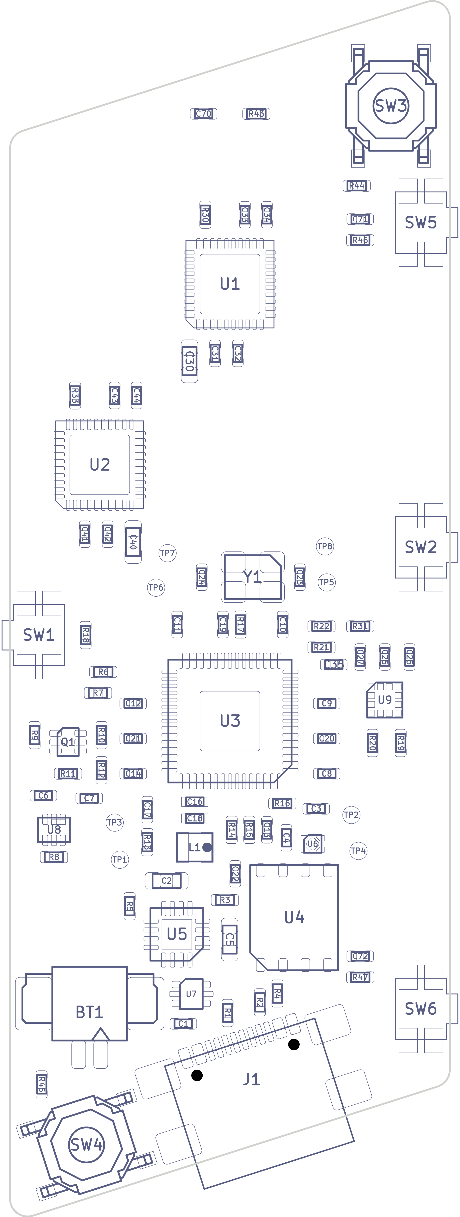
design/renders/parallelogram-p2-132-usb6/assembly-bottom.png
