sequoia-hope/matrix-play/design/renders/parallelogram-p2-132-usb6/assembly-top.png

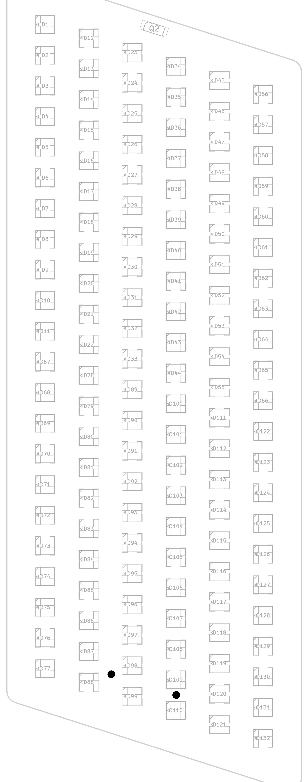
design/renders/parallelogram-p2-132-usb6/assembly-top.png
