sequoia-hope/matrix-play/design/renders/sunflower-s2-110-usbc/assembly-bottom.png

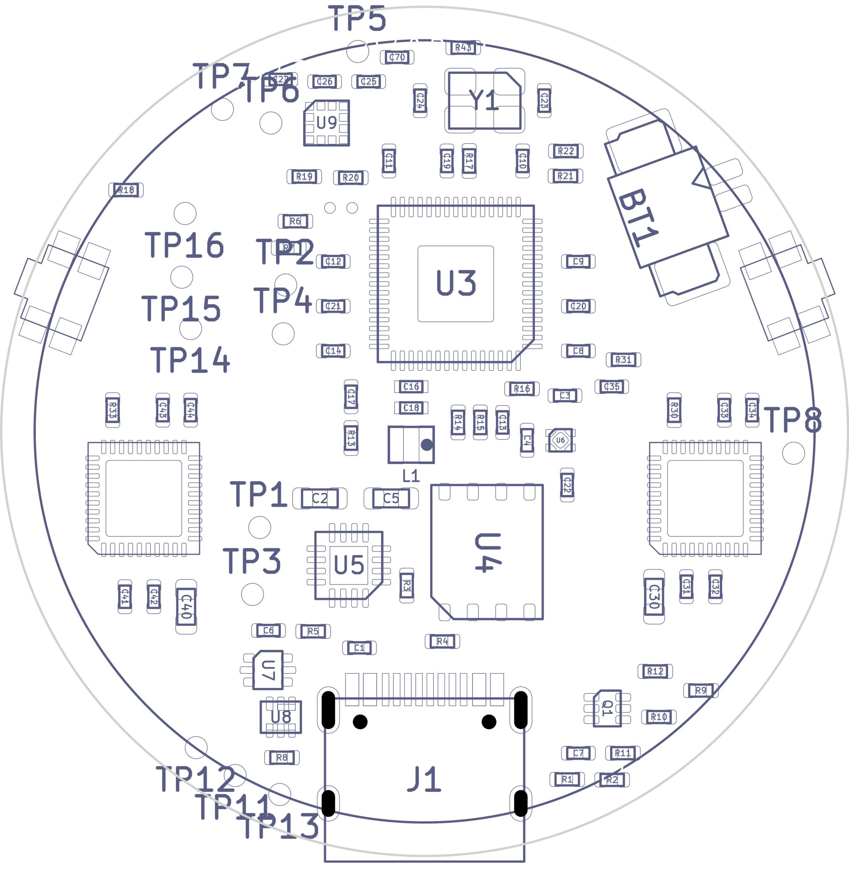
design/renders/sunflower-s2-110-usbc/assembly-bottom.png
