sequoia-hope/matrix-play/design/renders/sunflower-s2-110-usbc/assembly-top.png

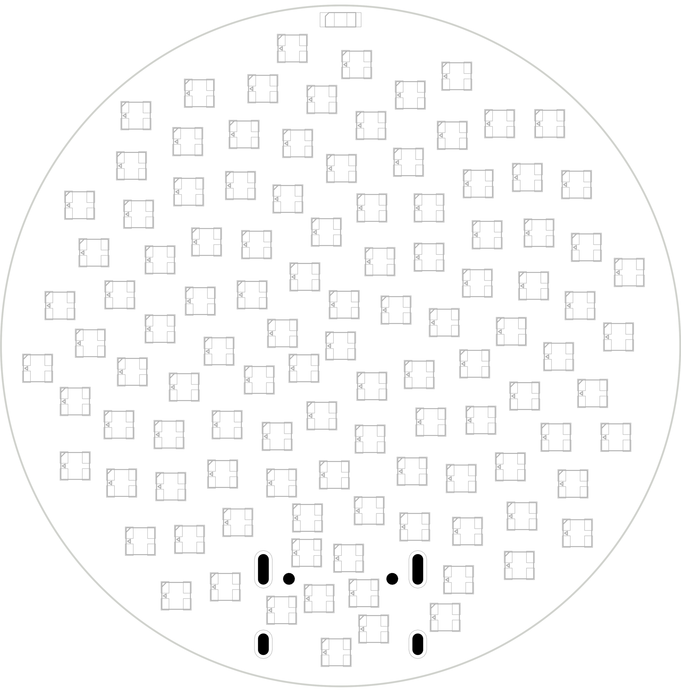
design/renders/sunflower-s2-110-usbc/assembly-top.png
