sequoia-hope/matrix-play/design/renders/sunflower-s2-110-usbc/bringup-map-bottom.png

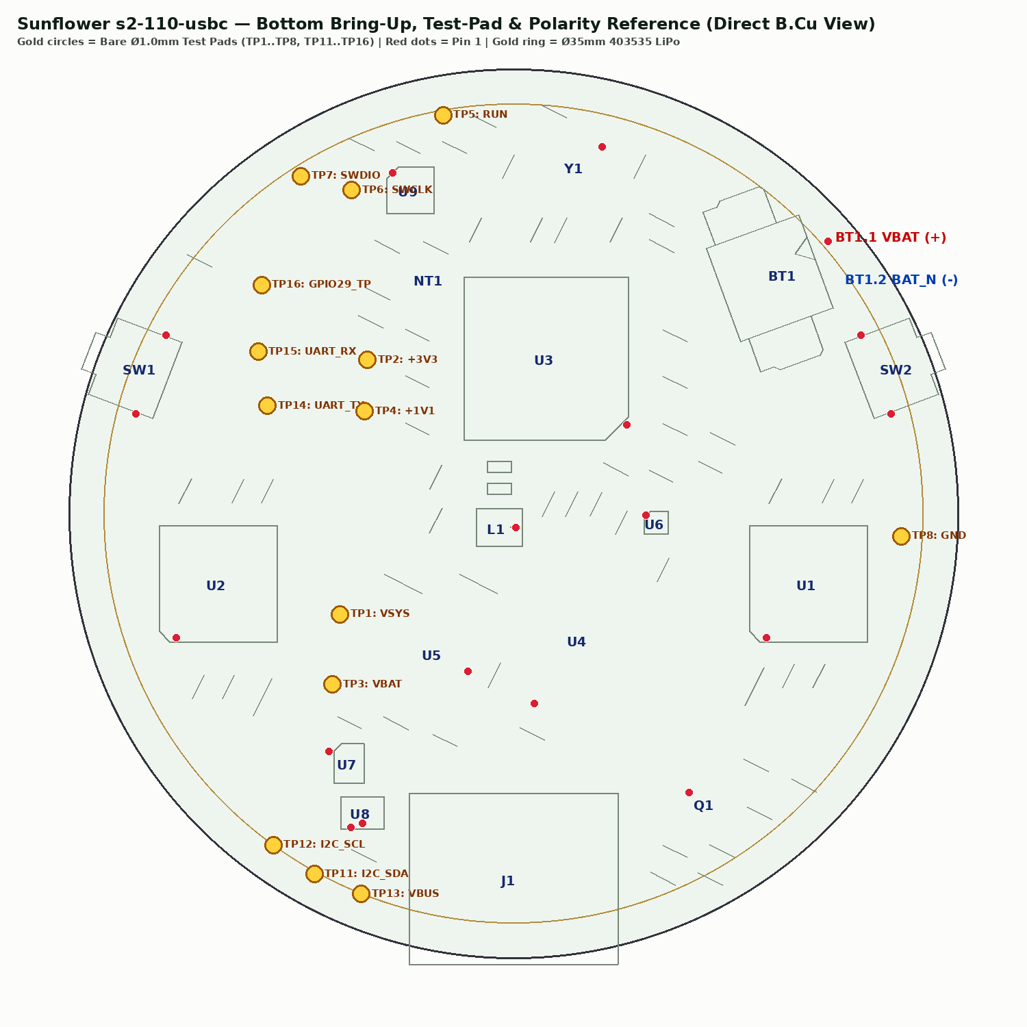
design/renders/sunflower-s2-110-usbc/bringup-map-bottom.png
