sequoia-hope/matrix-play/design/renders/round-pendant-f-usbc/schematic.pdf

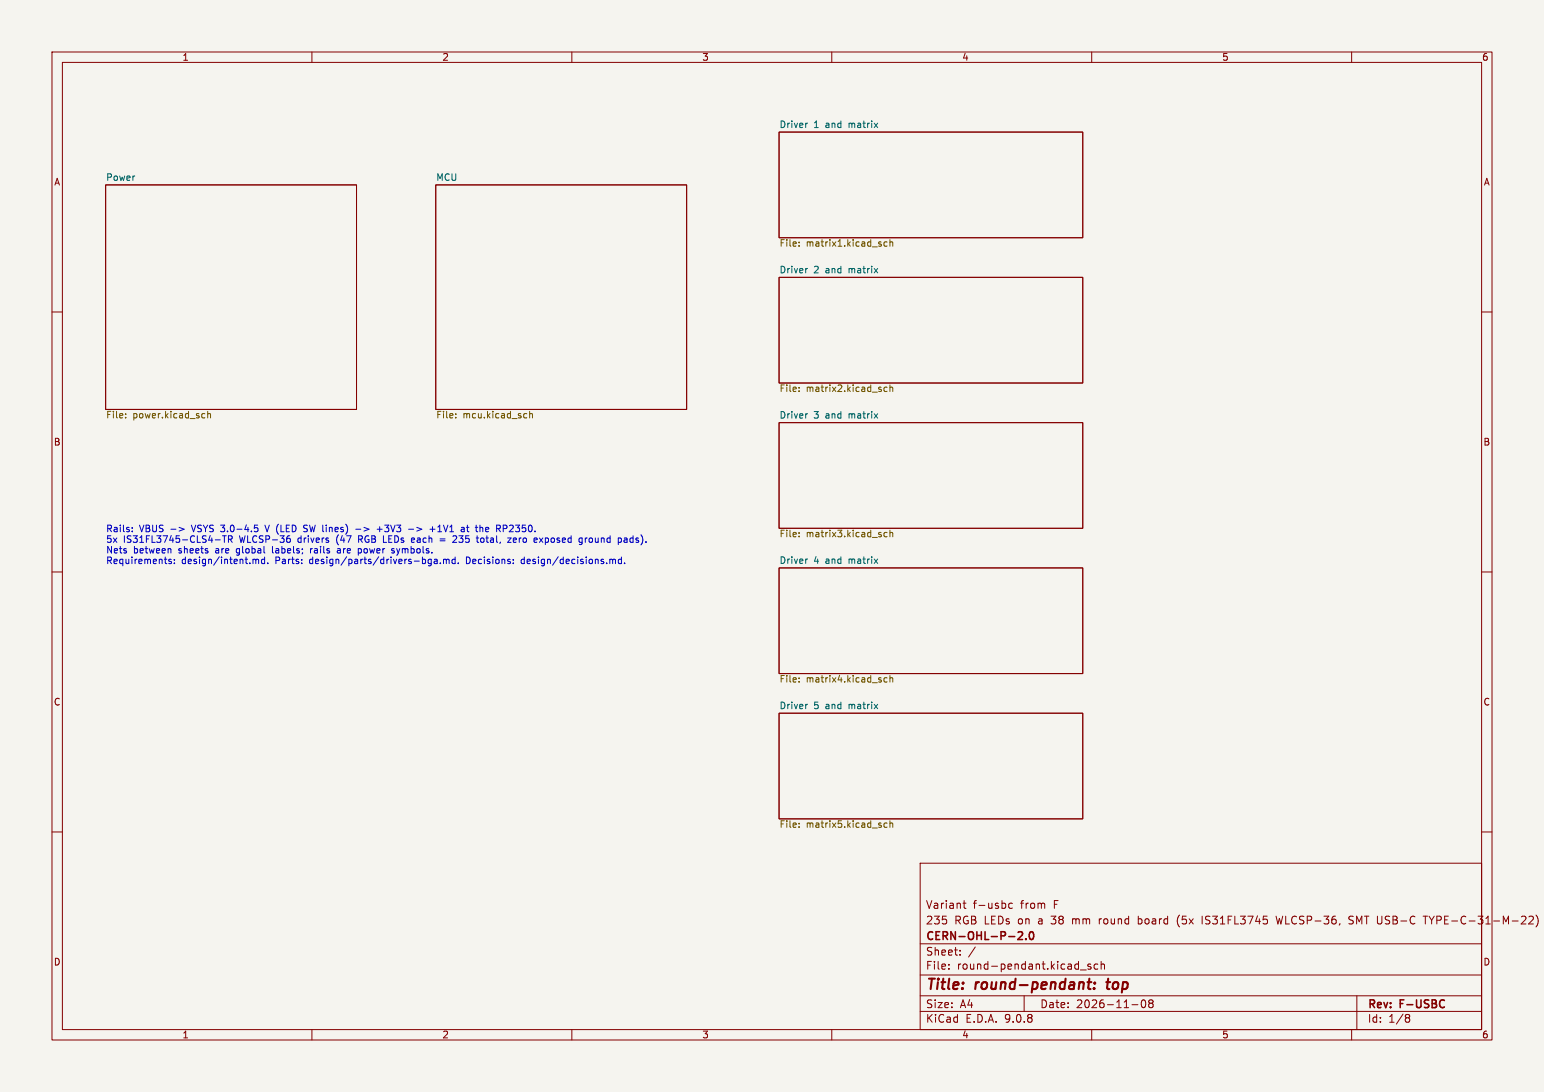
[picture p86: page 1]

File: round-pendant.kicad_sch Sheet: / CERN-OHL-P-2.0

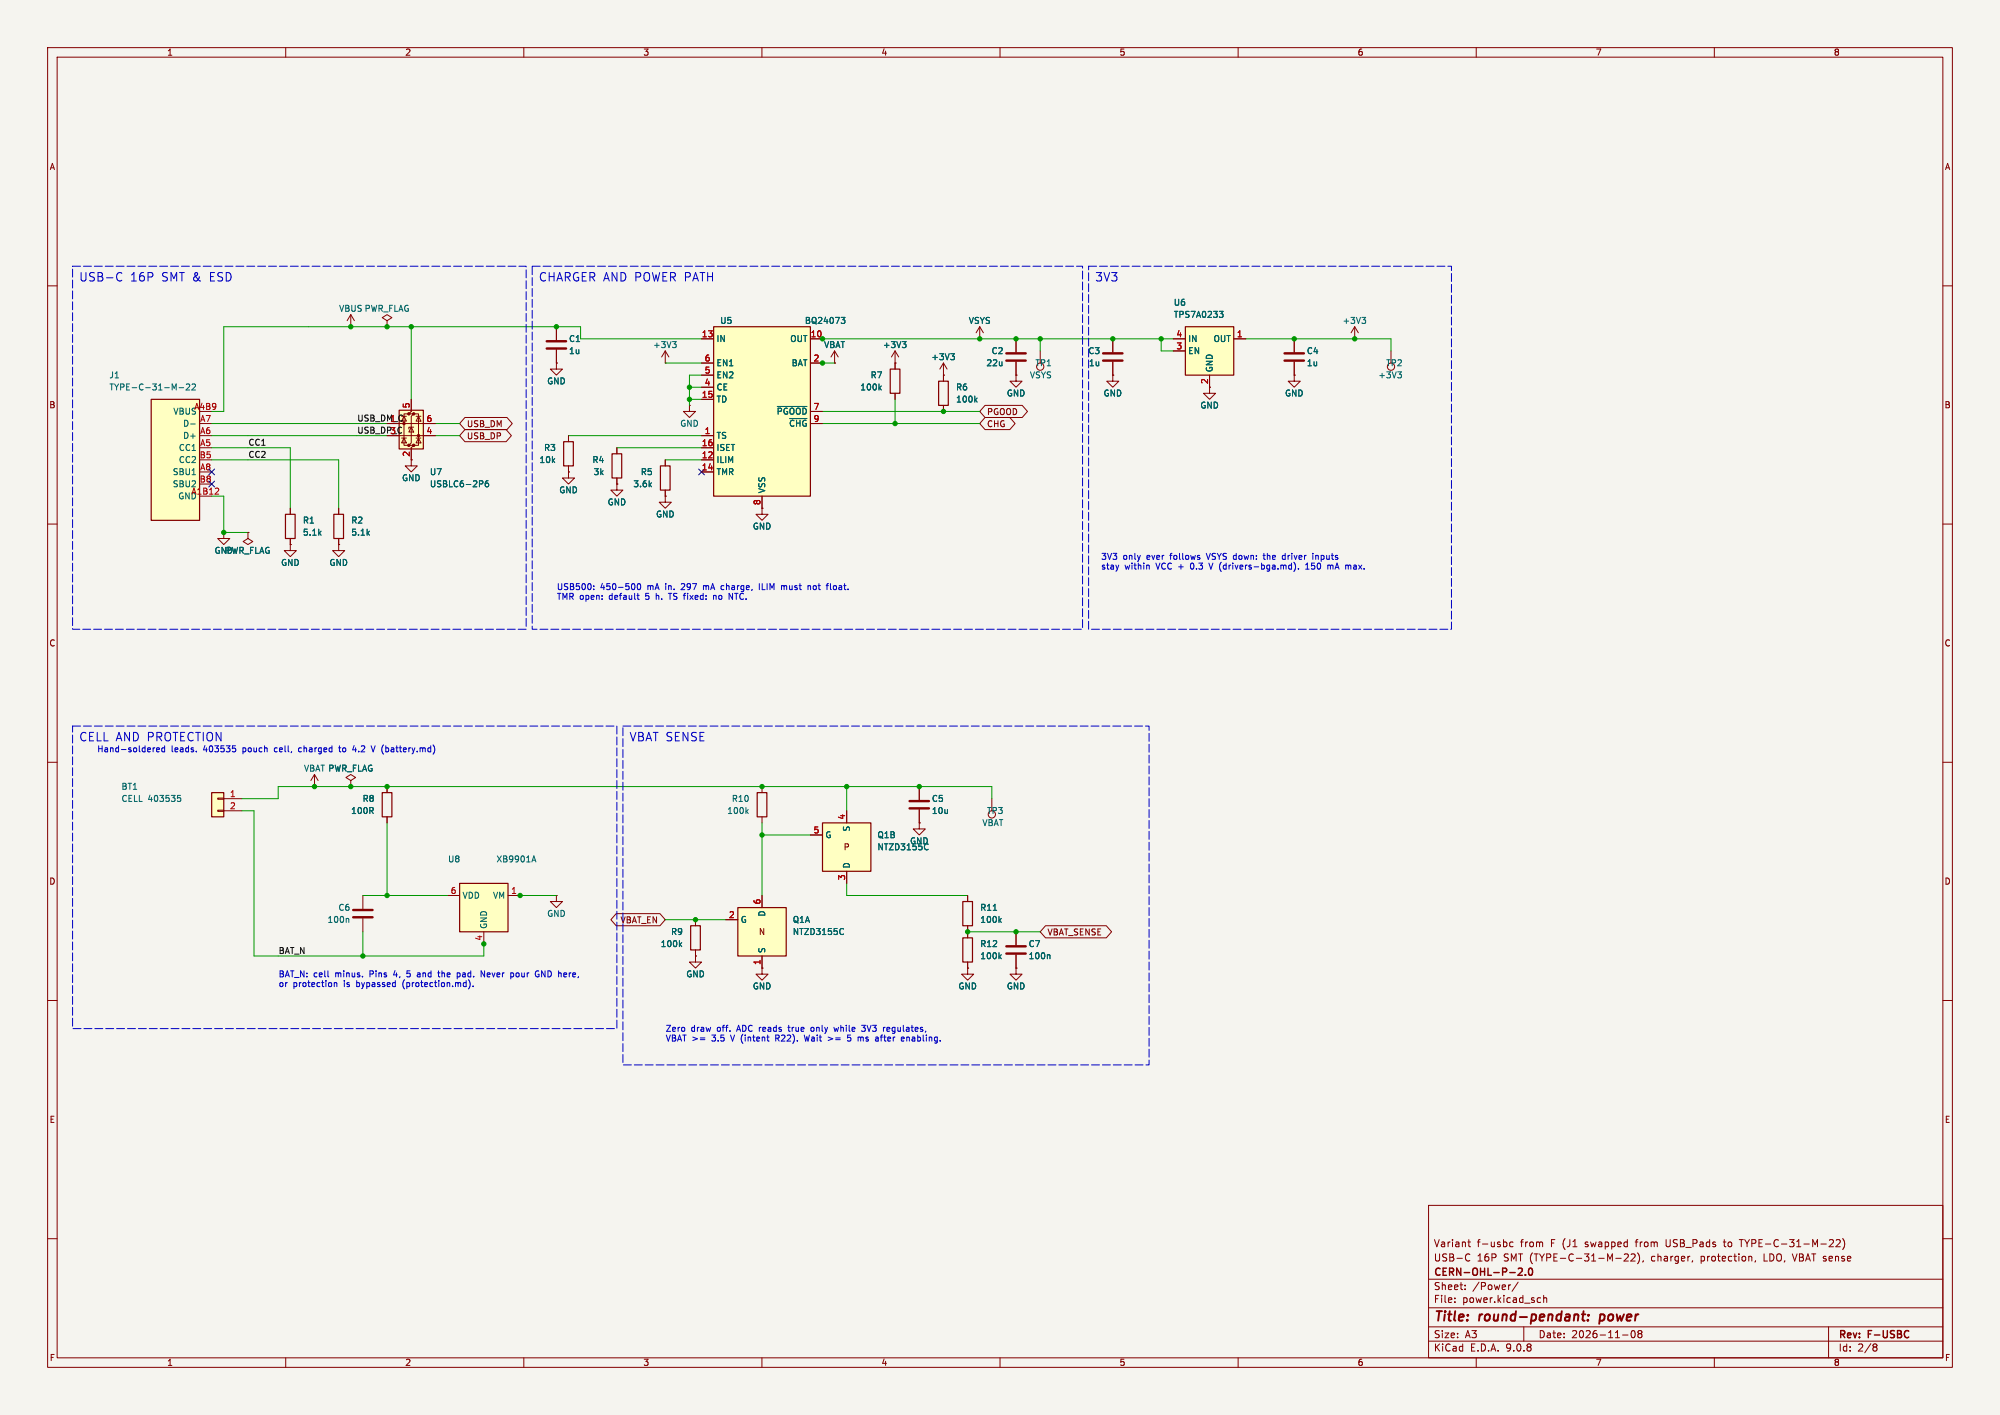
[picture p87: page 2]

CHARGER AND POWER PATH

8 OUT 10 BAT 2 ~{PGOOD}7 ~{CHG}9 U5 BQ24073 +3V3 C6

8 OUT 10 BAT 2 ~{PGOOD}7 ~{CHG}9 VSYS R6

3V3 only ever follows VSYS down: the driver inputs

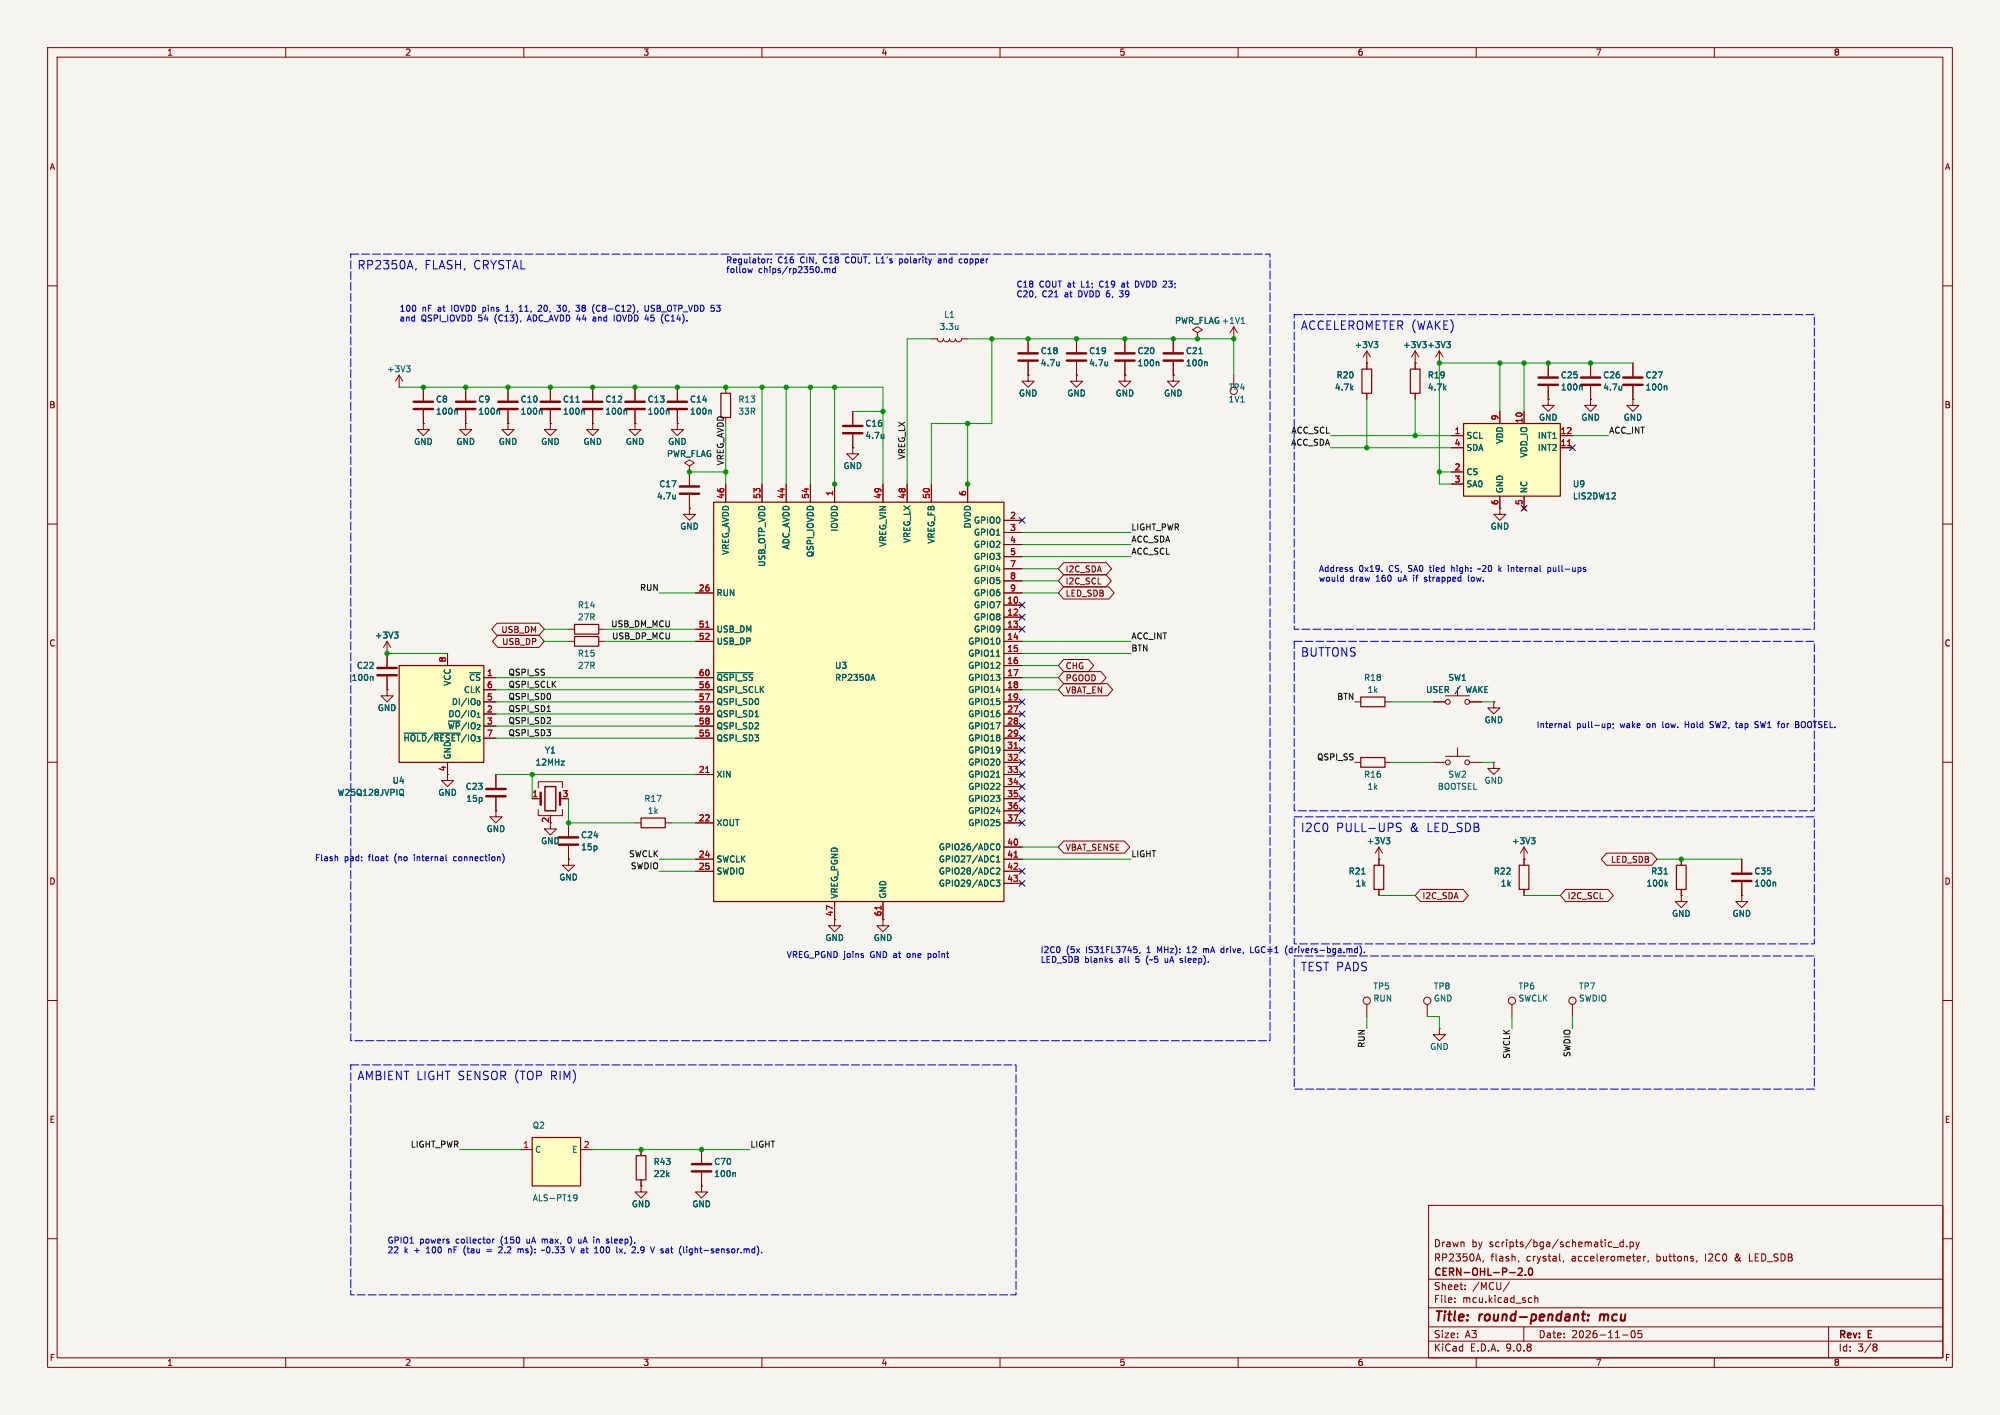
[picture p88: page 3]

C18 COUT at L1; C19 at DVDD 23; C20, C21 at DVDD 6, 39

6 RUN 26 USB_DM 51 USB_DP 52 ~{QSPI_SS} 60 QSPI_SCLK 56 QSPI_SD0 57 QSPI_SD1 59 QSPI_SD2 58 QSPI_SD3 55 XIN 21 XOUT 22 SWCLK 24 SWDIO 25 ADC_AVDD 44 IOVDD

VREG_PGND joins GND at one point

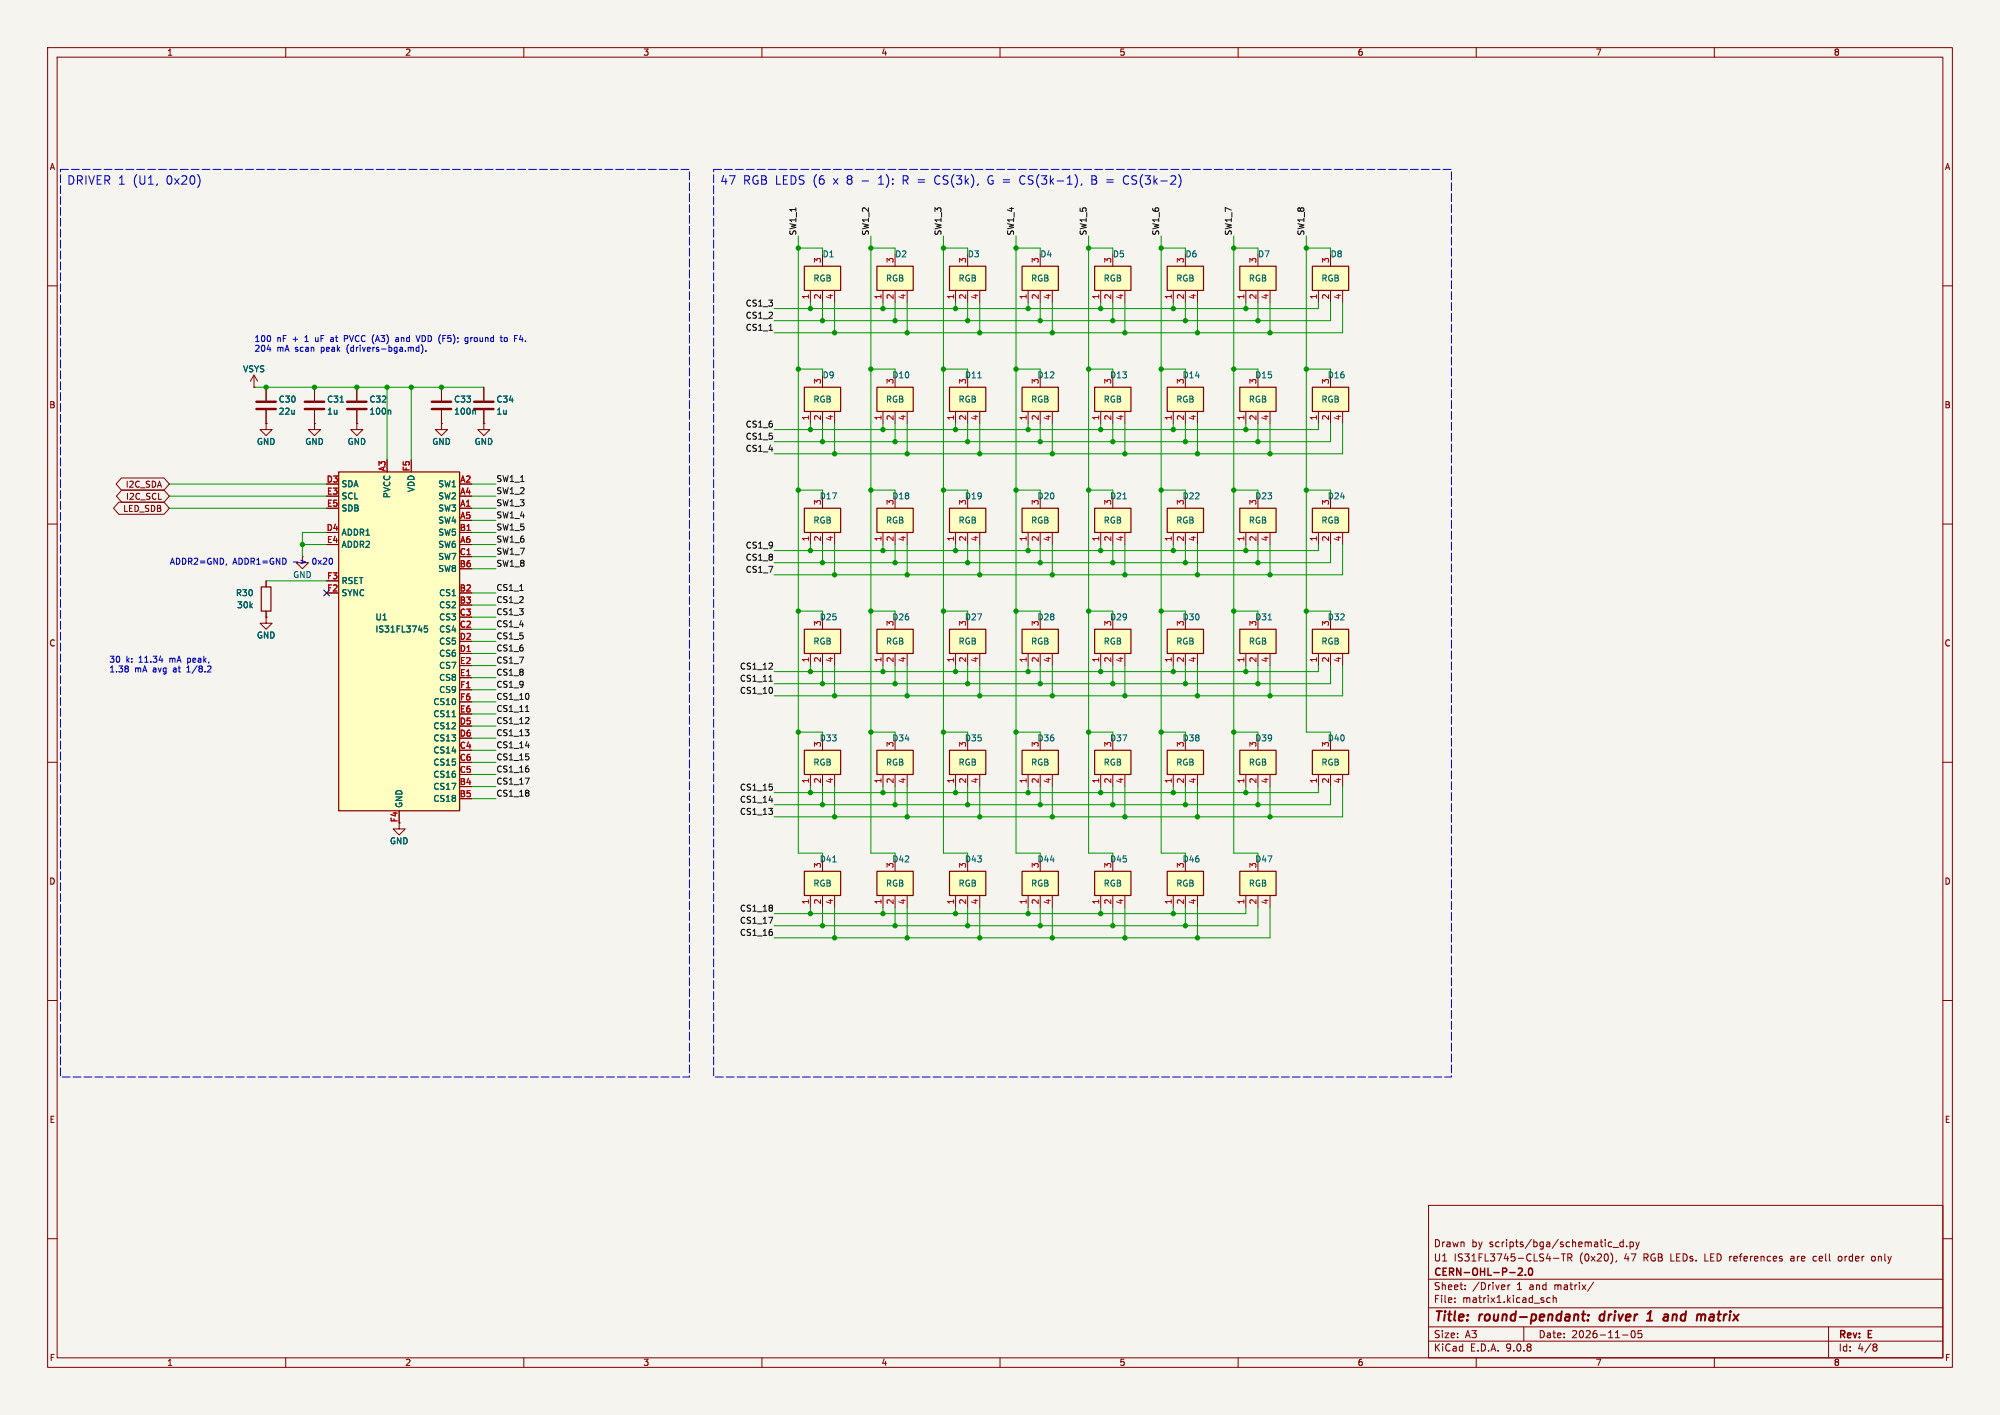
[picture p89: page 4]

100 nF + 1 uF at PVCC (A3) and VDD (F5); ground to F4. 204 mA scan peak (drivers-bga.md).

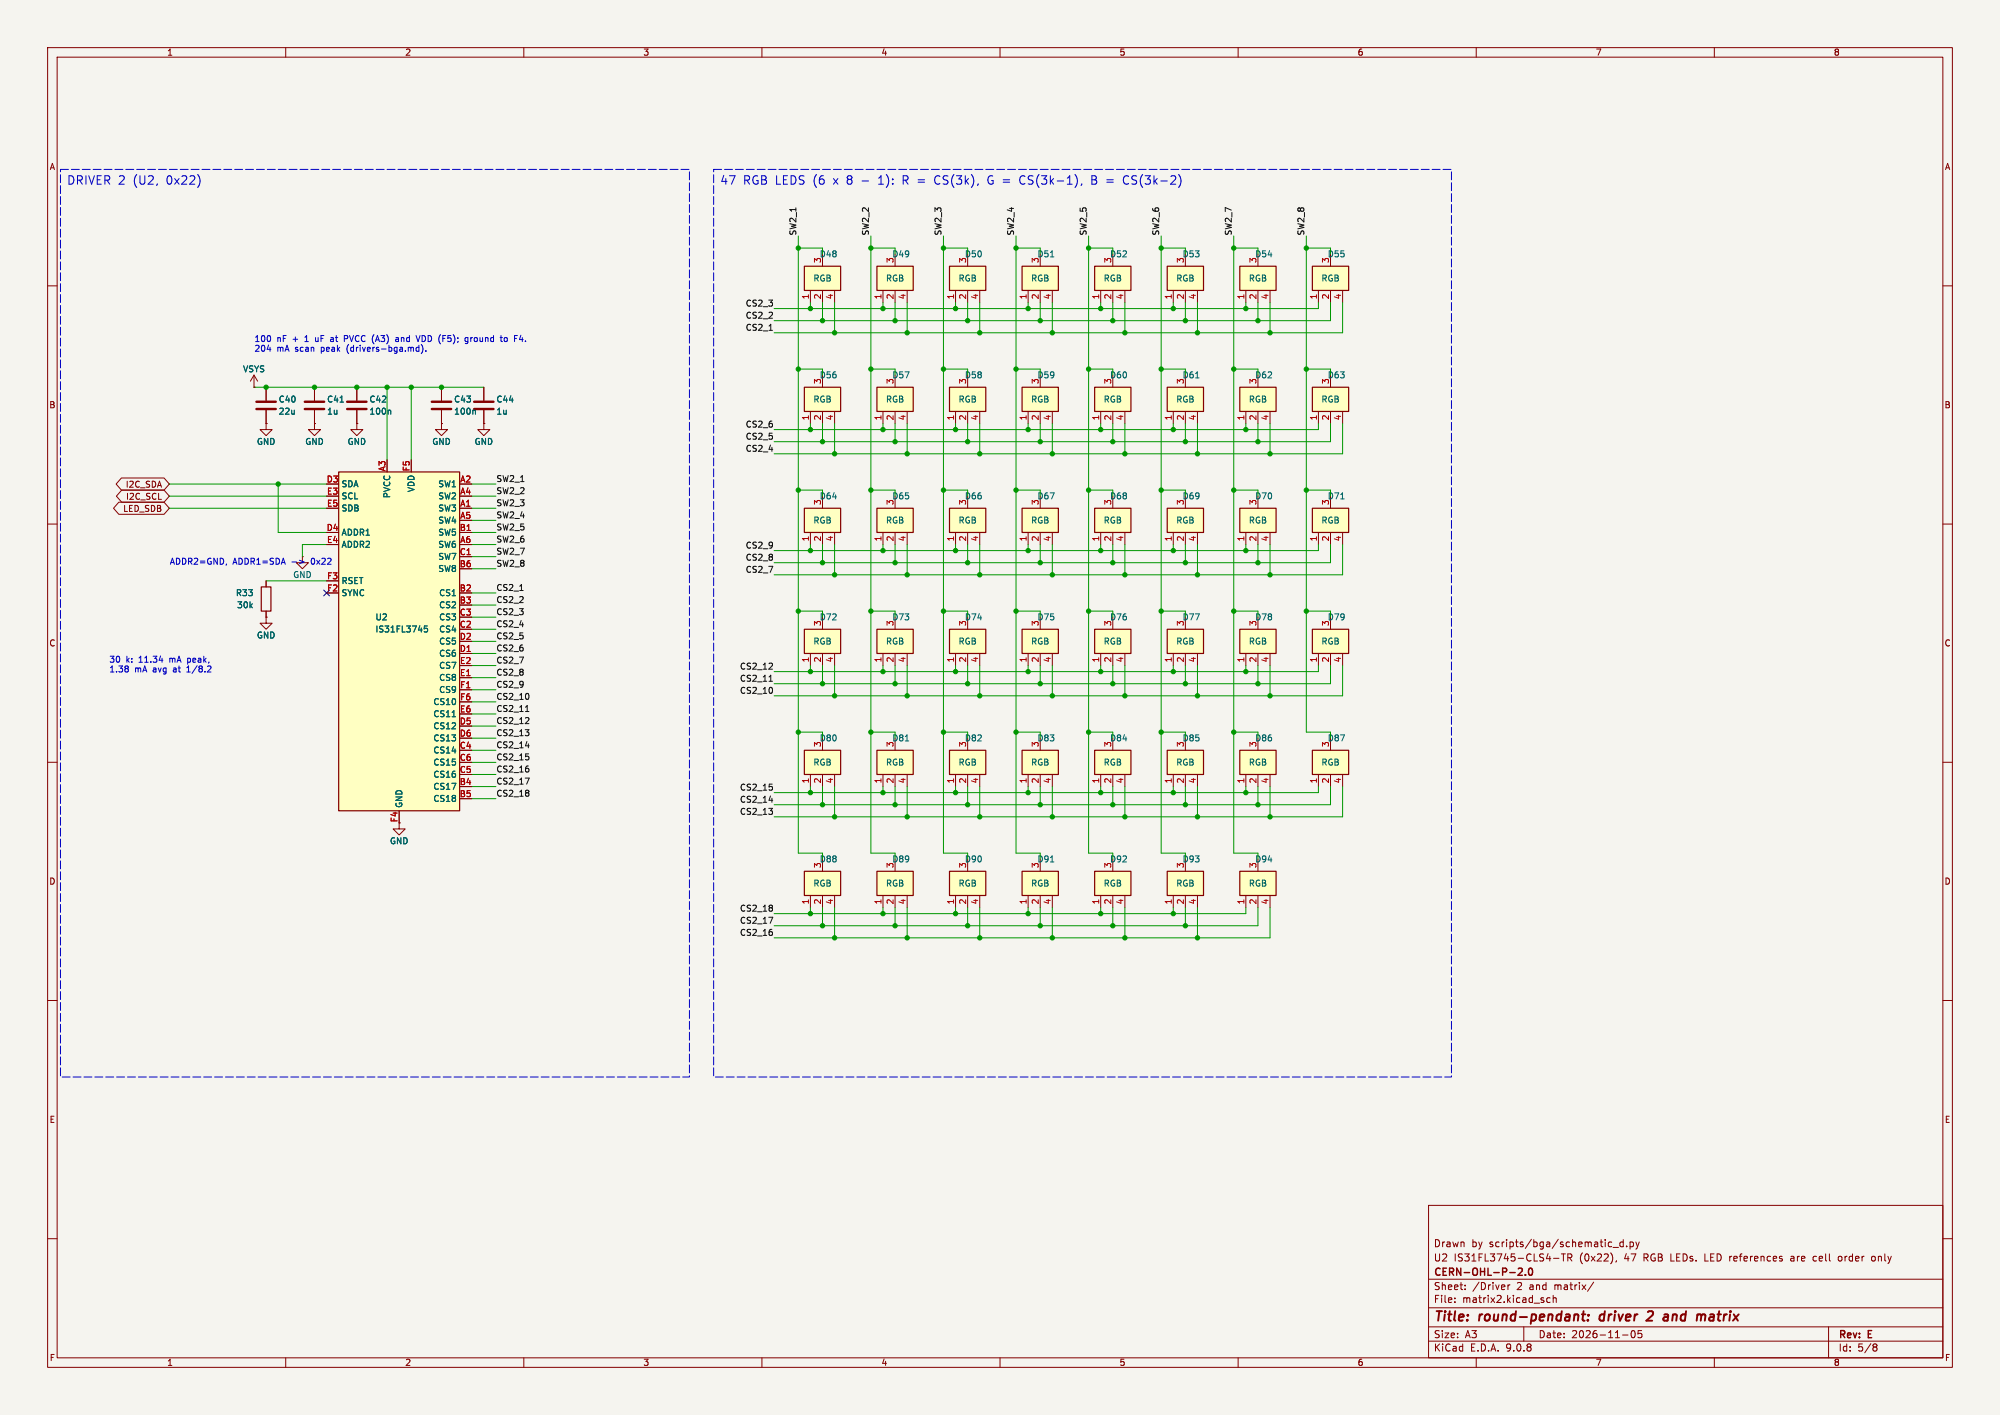
[picture p90: page 5]

30 k: 11.34 mA peak, 1.38 mA avg at 1/8.2

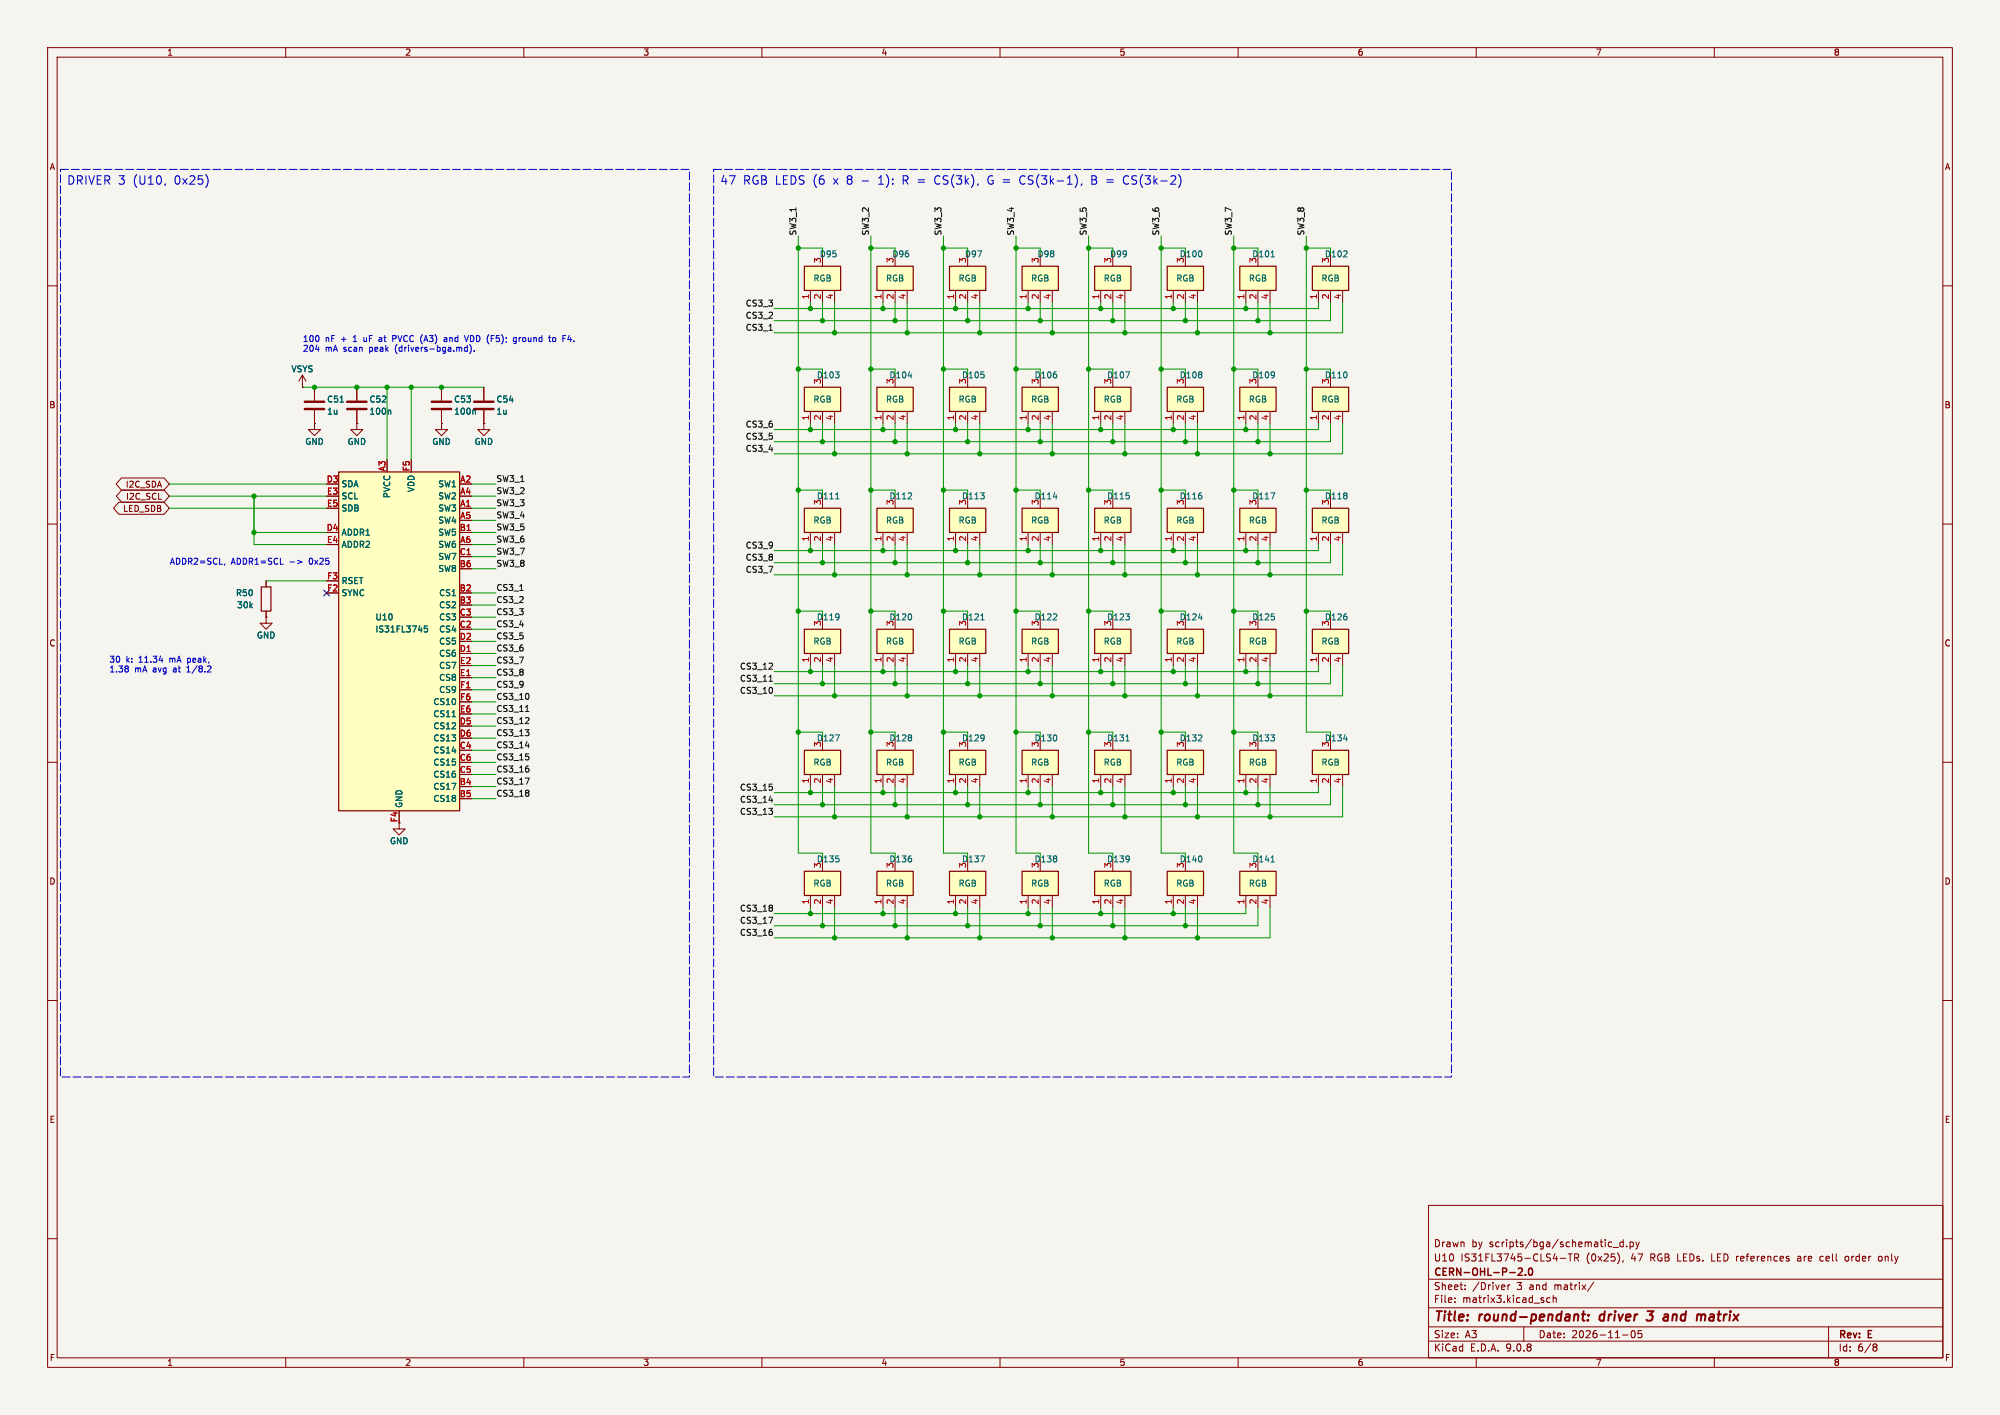
[picture p91: page 6]

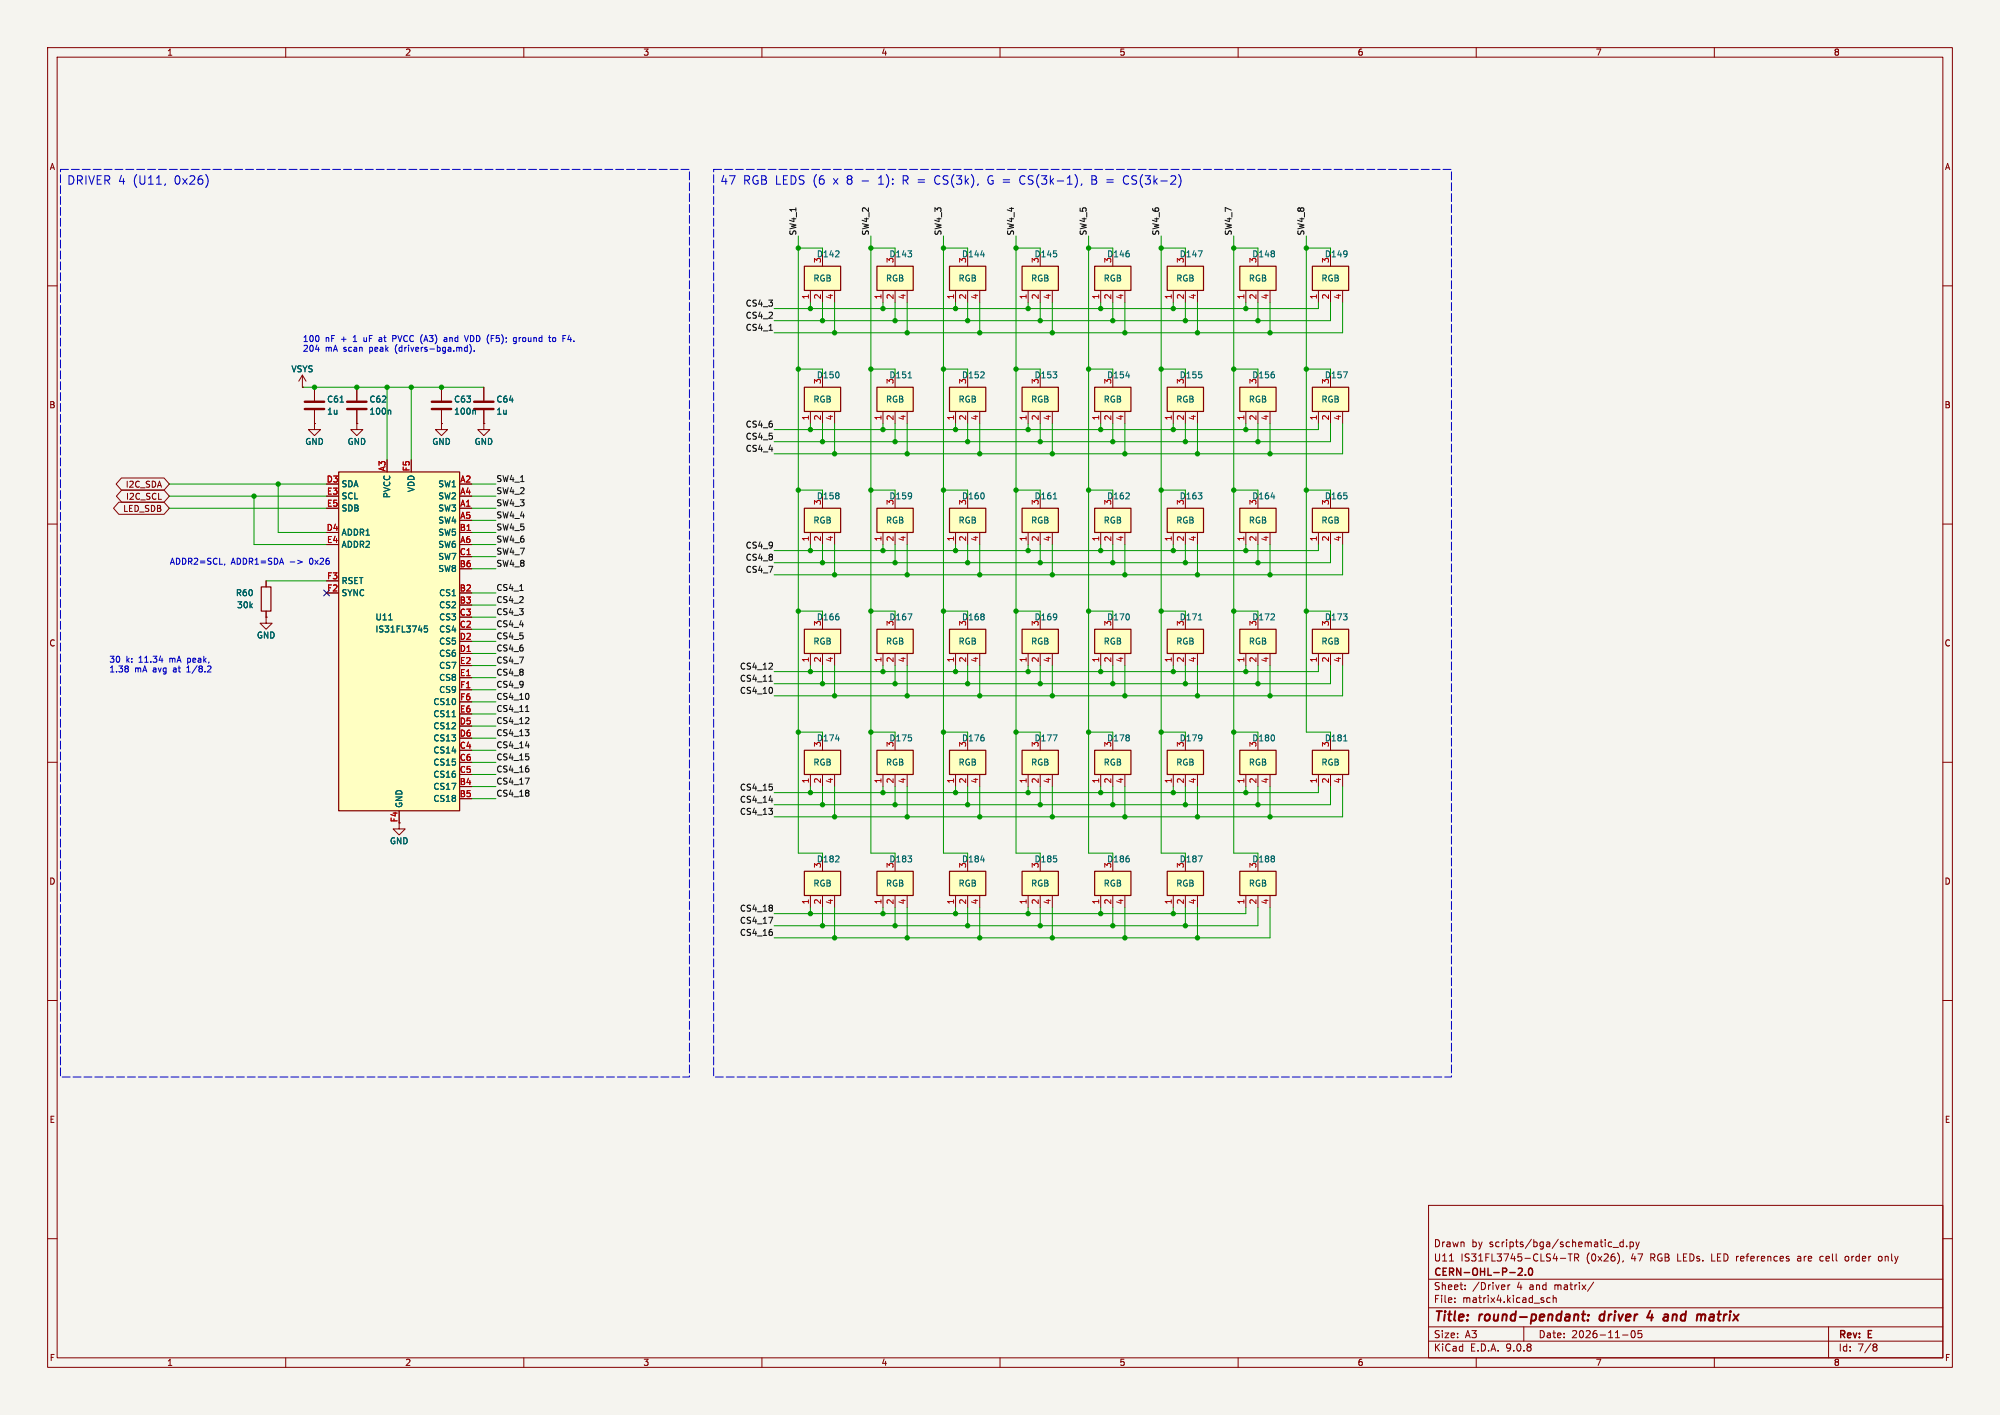
[picture p92: page 7]

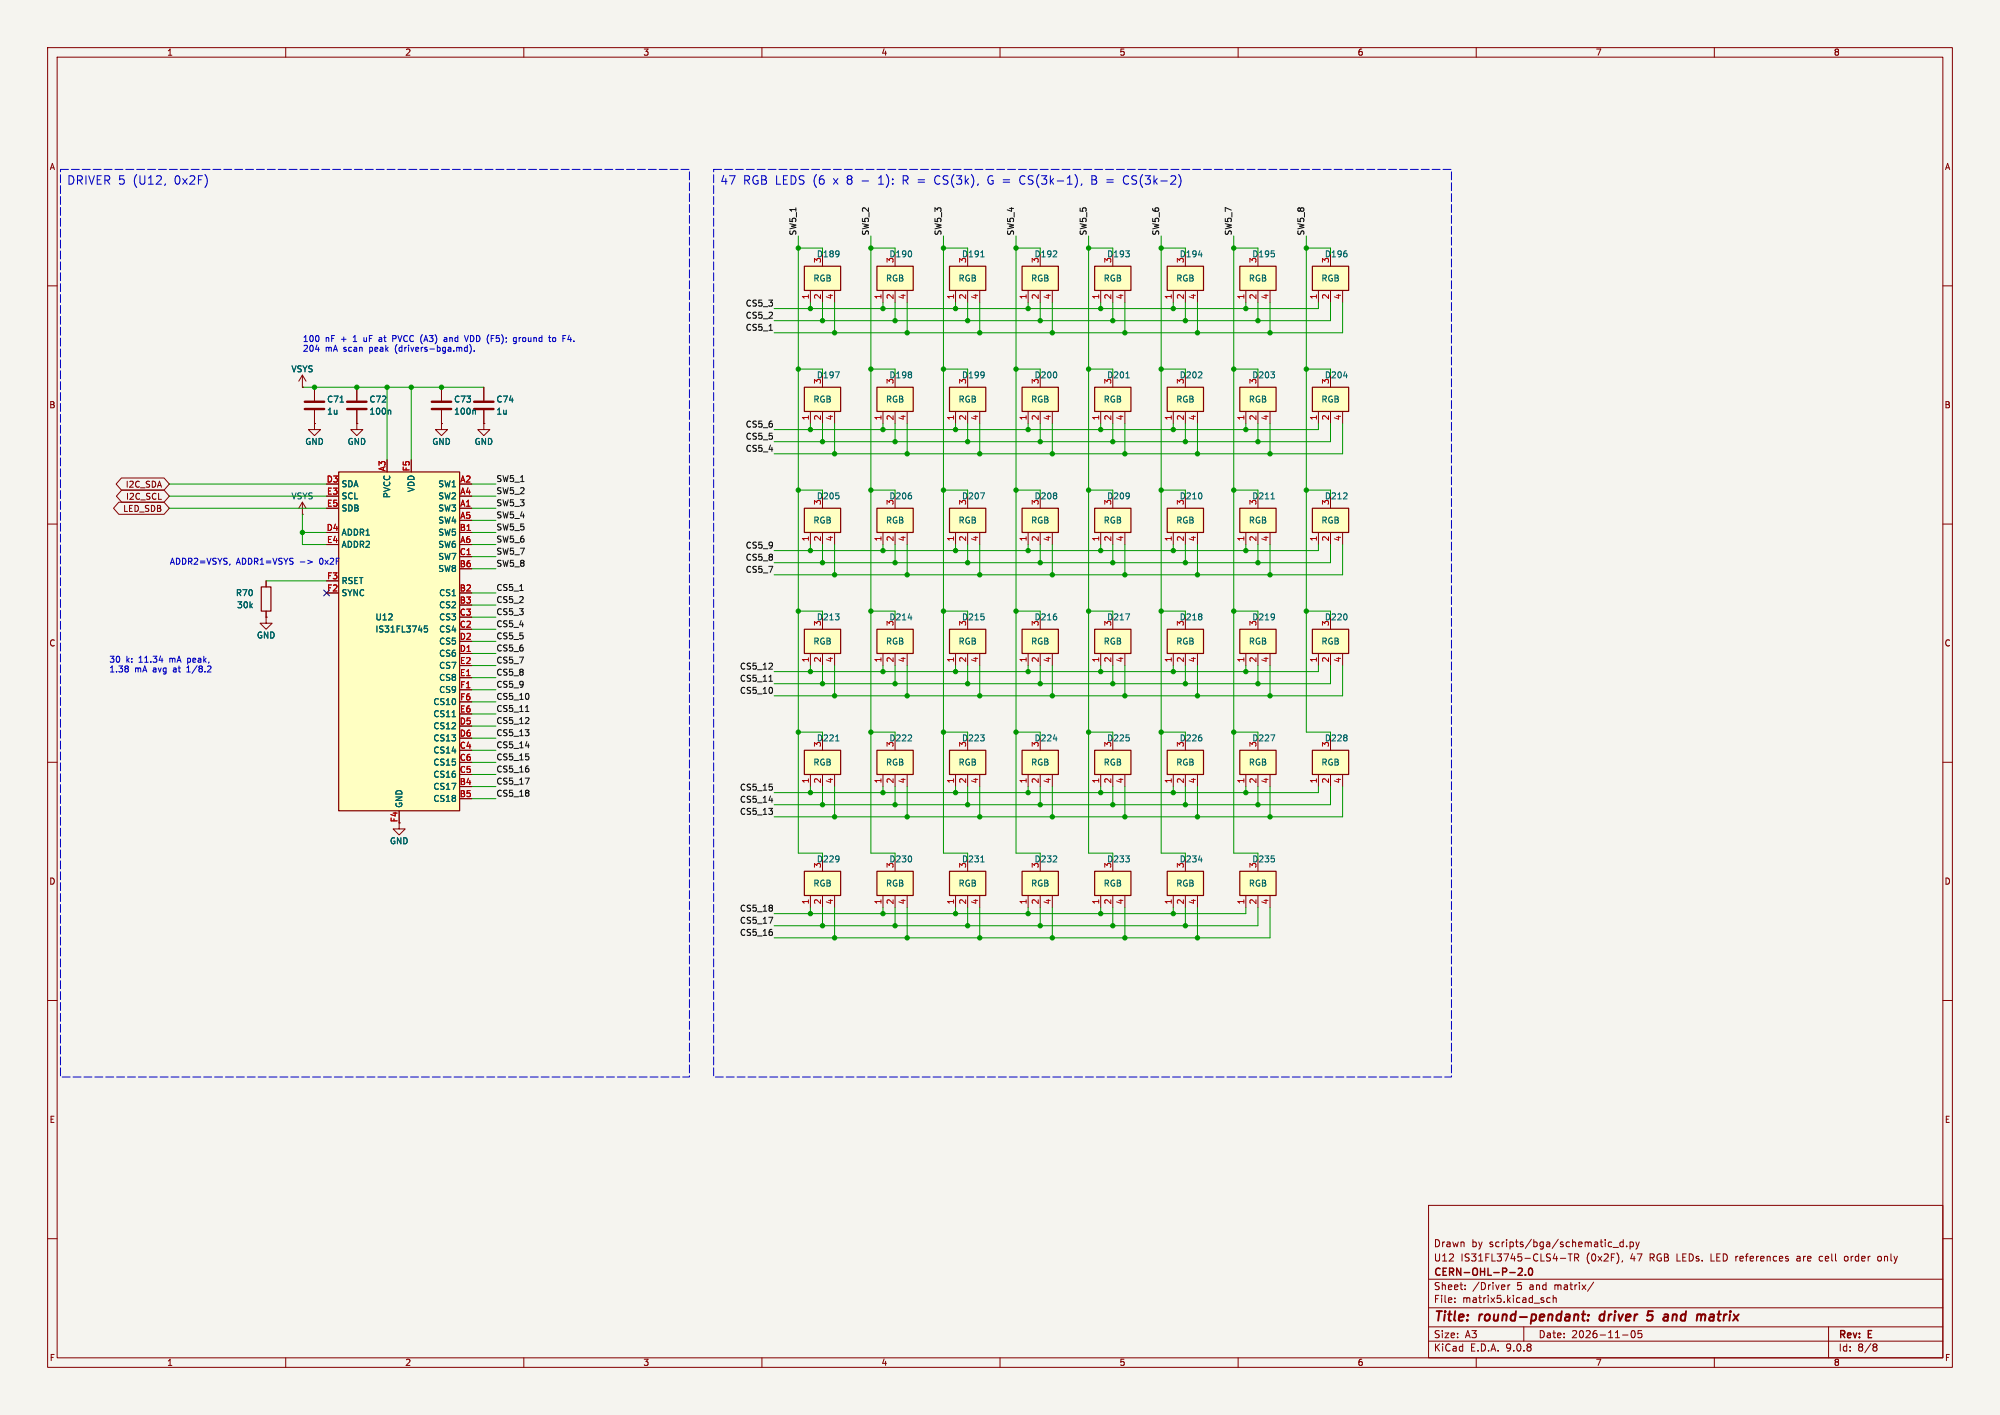
[picture p93: page 8]
