sequoia-hope/matrix-play/hw/parallelogram/p2-132-usb6/fab/assembly-top.pdf

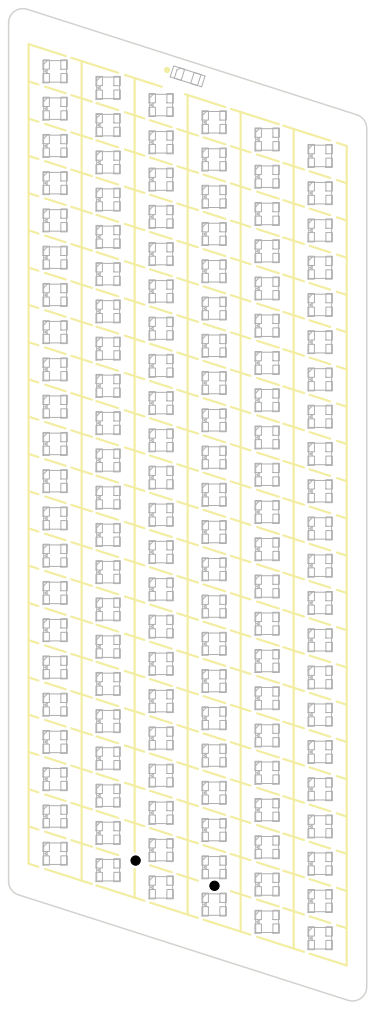
[picture p139: page 1]

File: parallelogram.kicad_pcb Sheet: CERN-OHL-P-2.0
