sequoia-hope/matrix-play/hw/dense-square/s15-225/fab/dense-square-s15-225-schematic.pdf

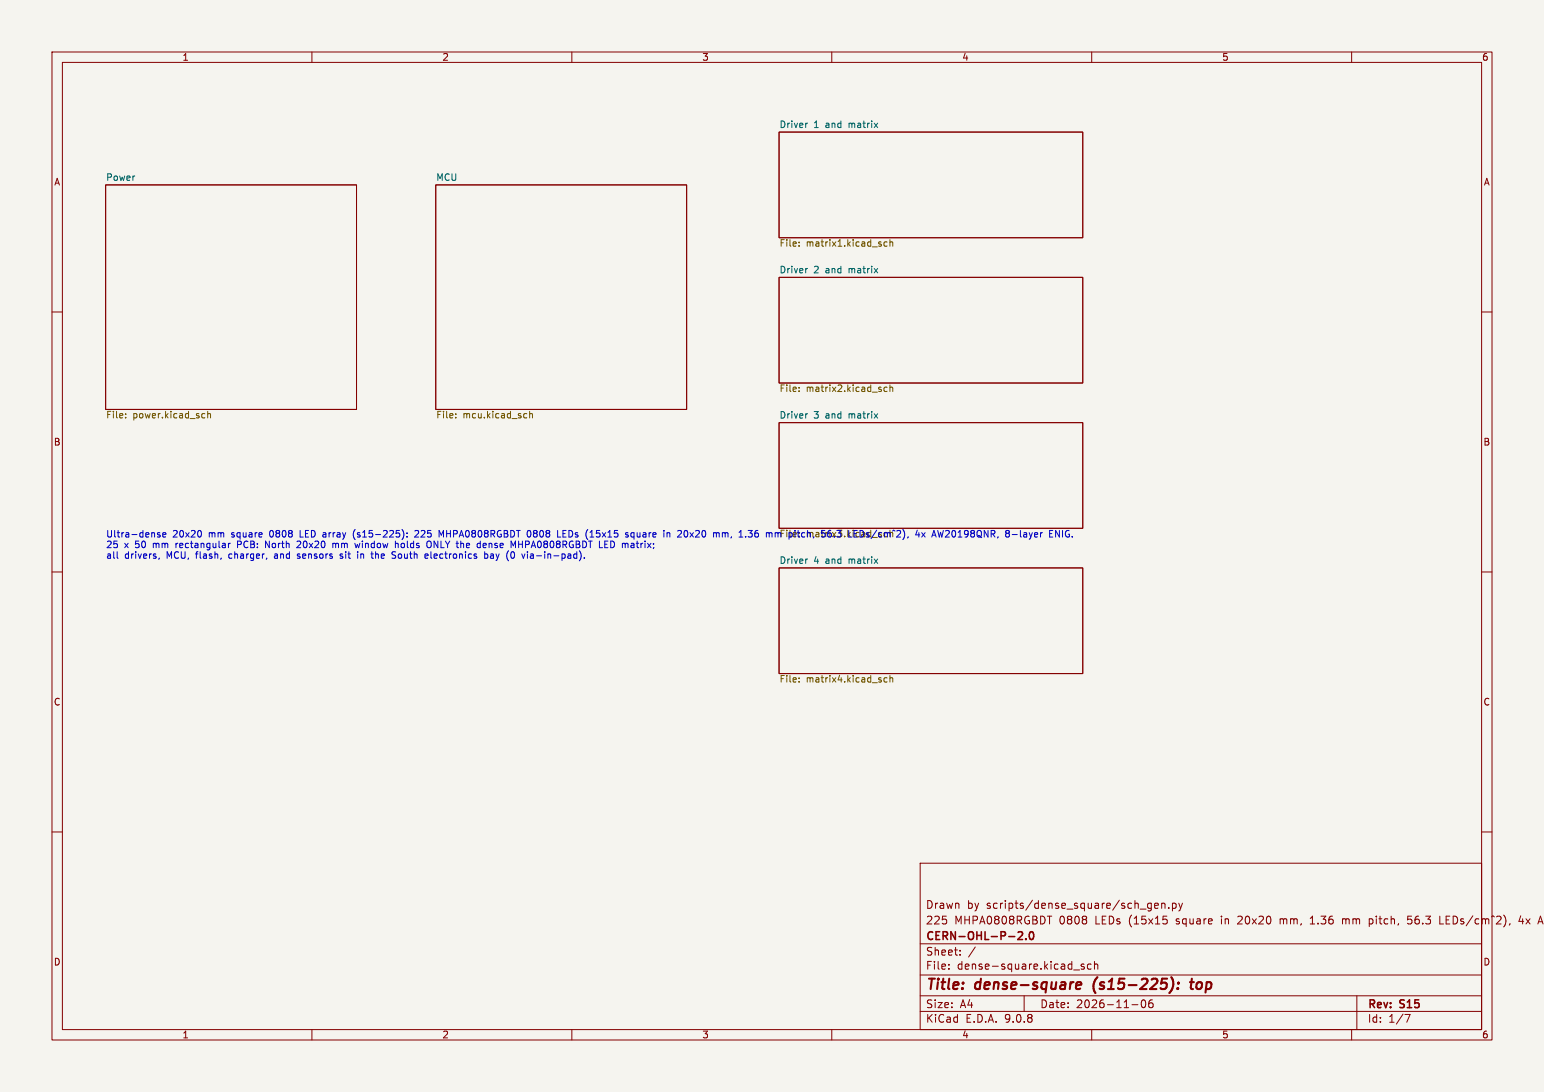
[picture p140: page 1]

File: dense-square.kicad_sch Sheet: / CERN-OHL-P-2.0

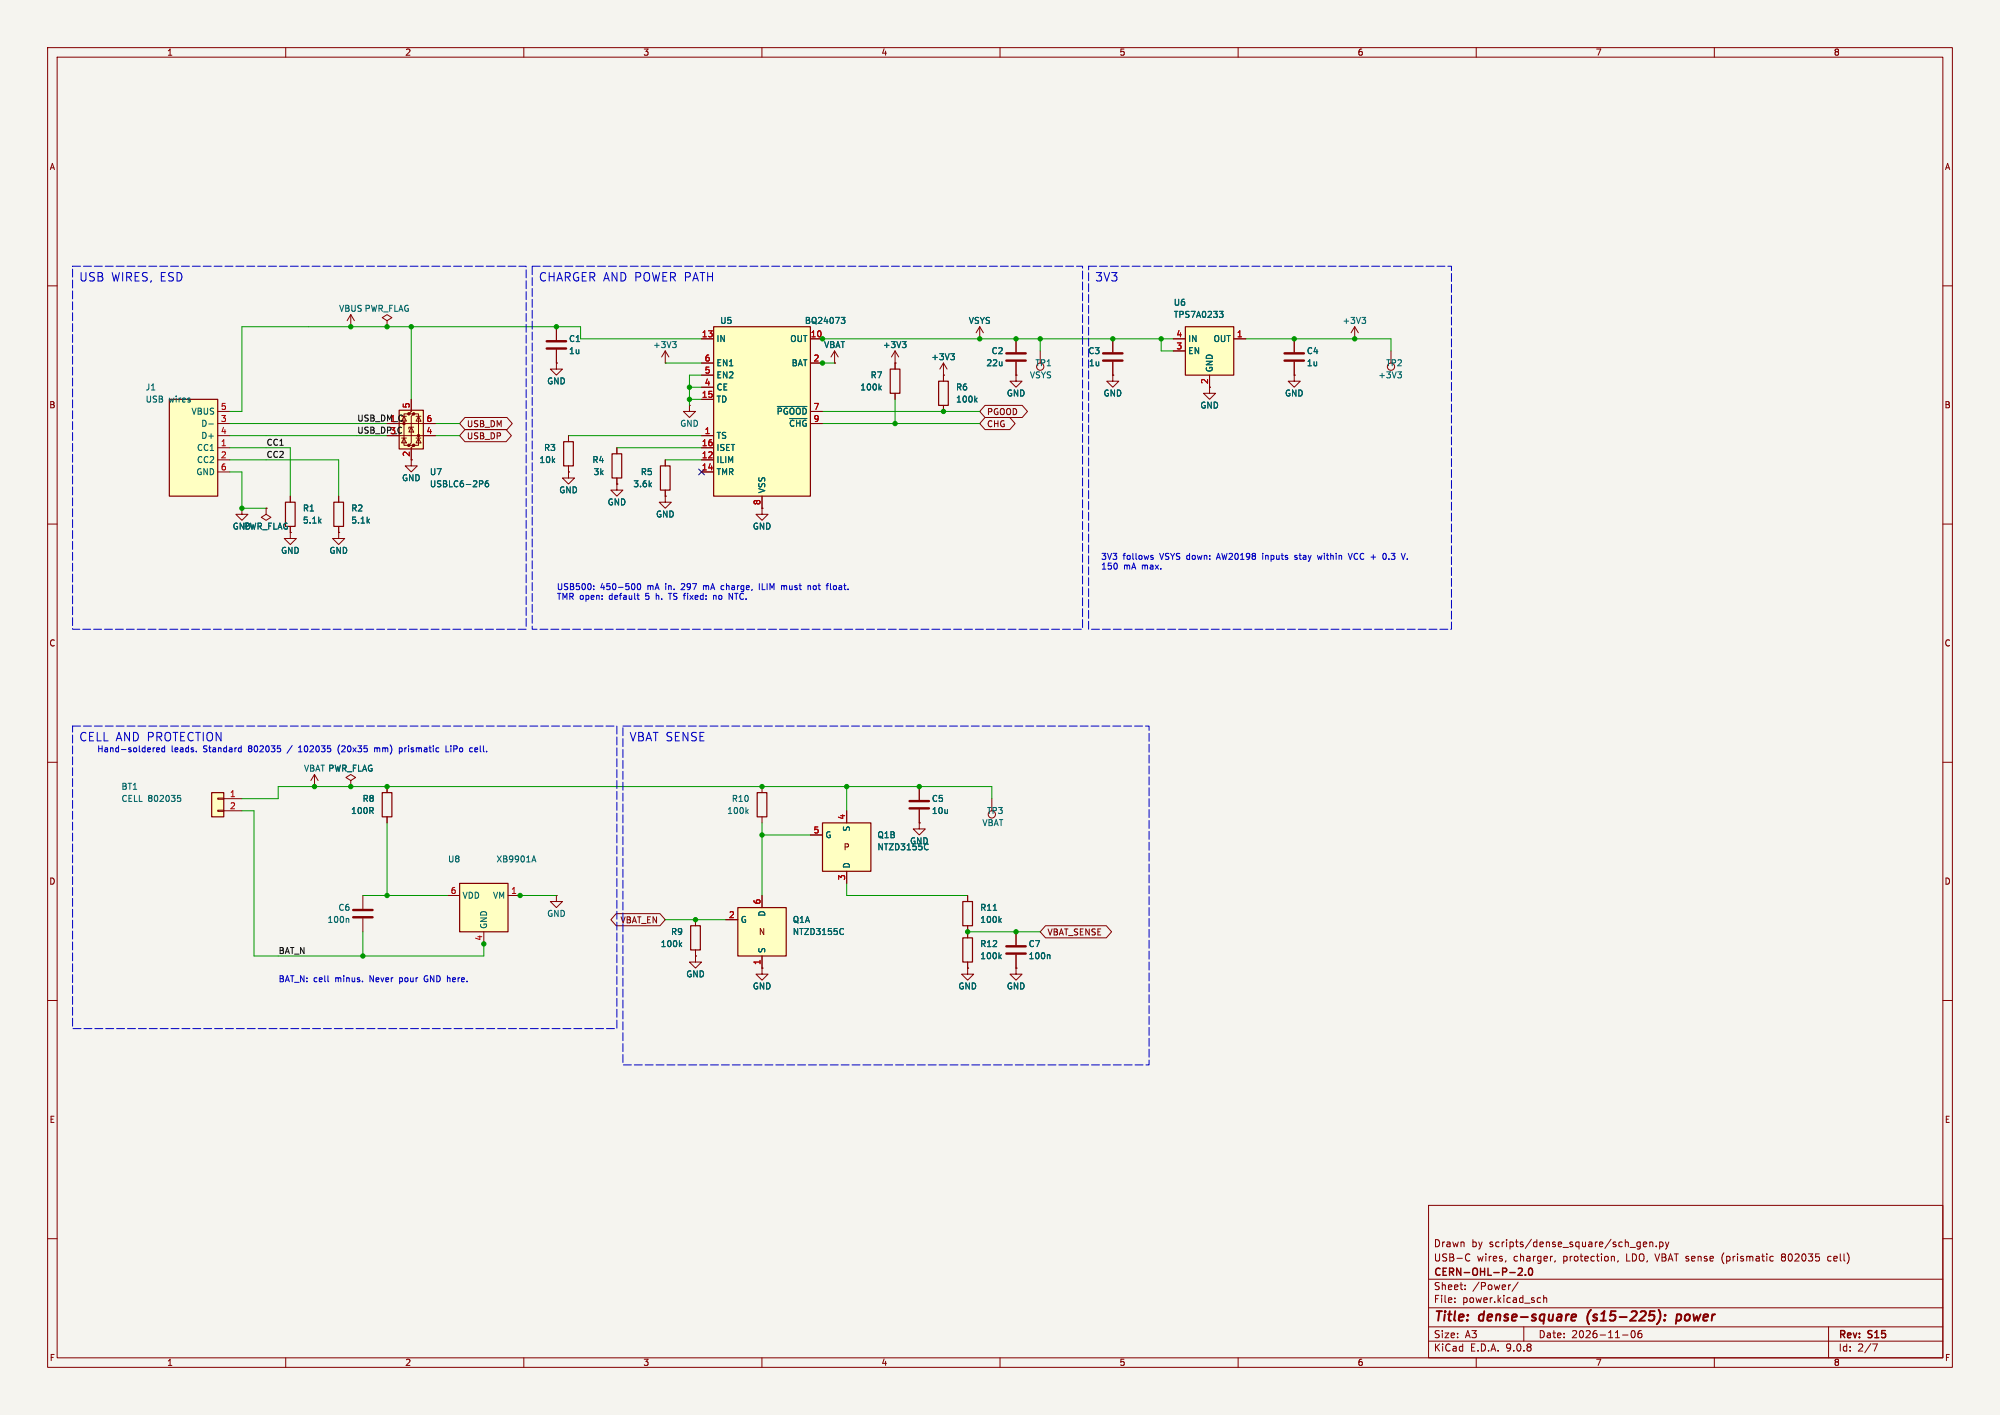
[picture p141: page 2]

2 OUT 1 U6 TPS7A0233 GND GND GND

8 OUT 10 BAT 2 ~{PGOOD}7 ~{CHG}9 U5 BQ24073 GND GND

BAT_N: cell minus. Never pour GND here. CELL AND PROTECTION

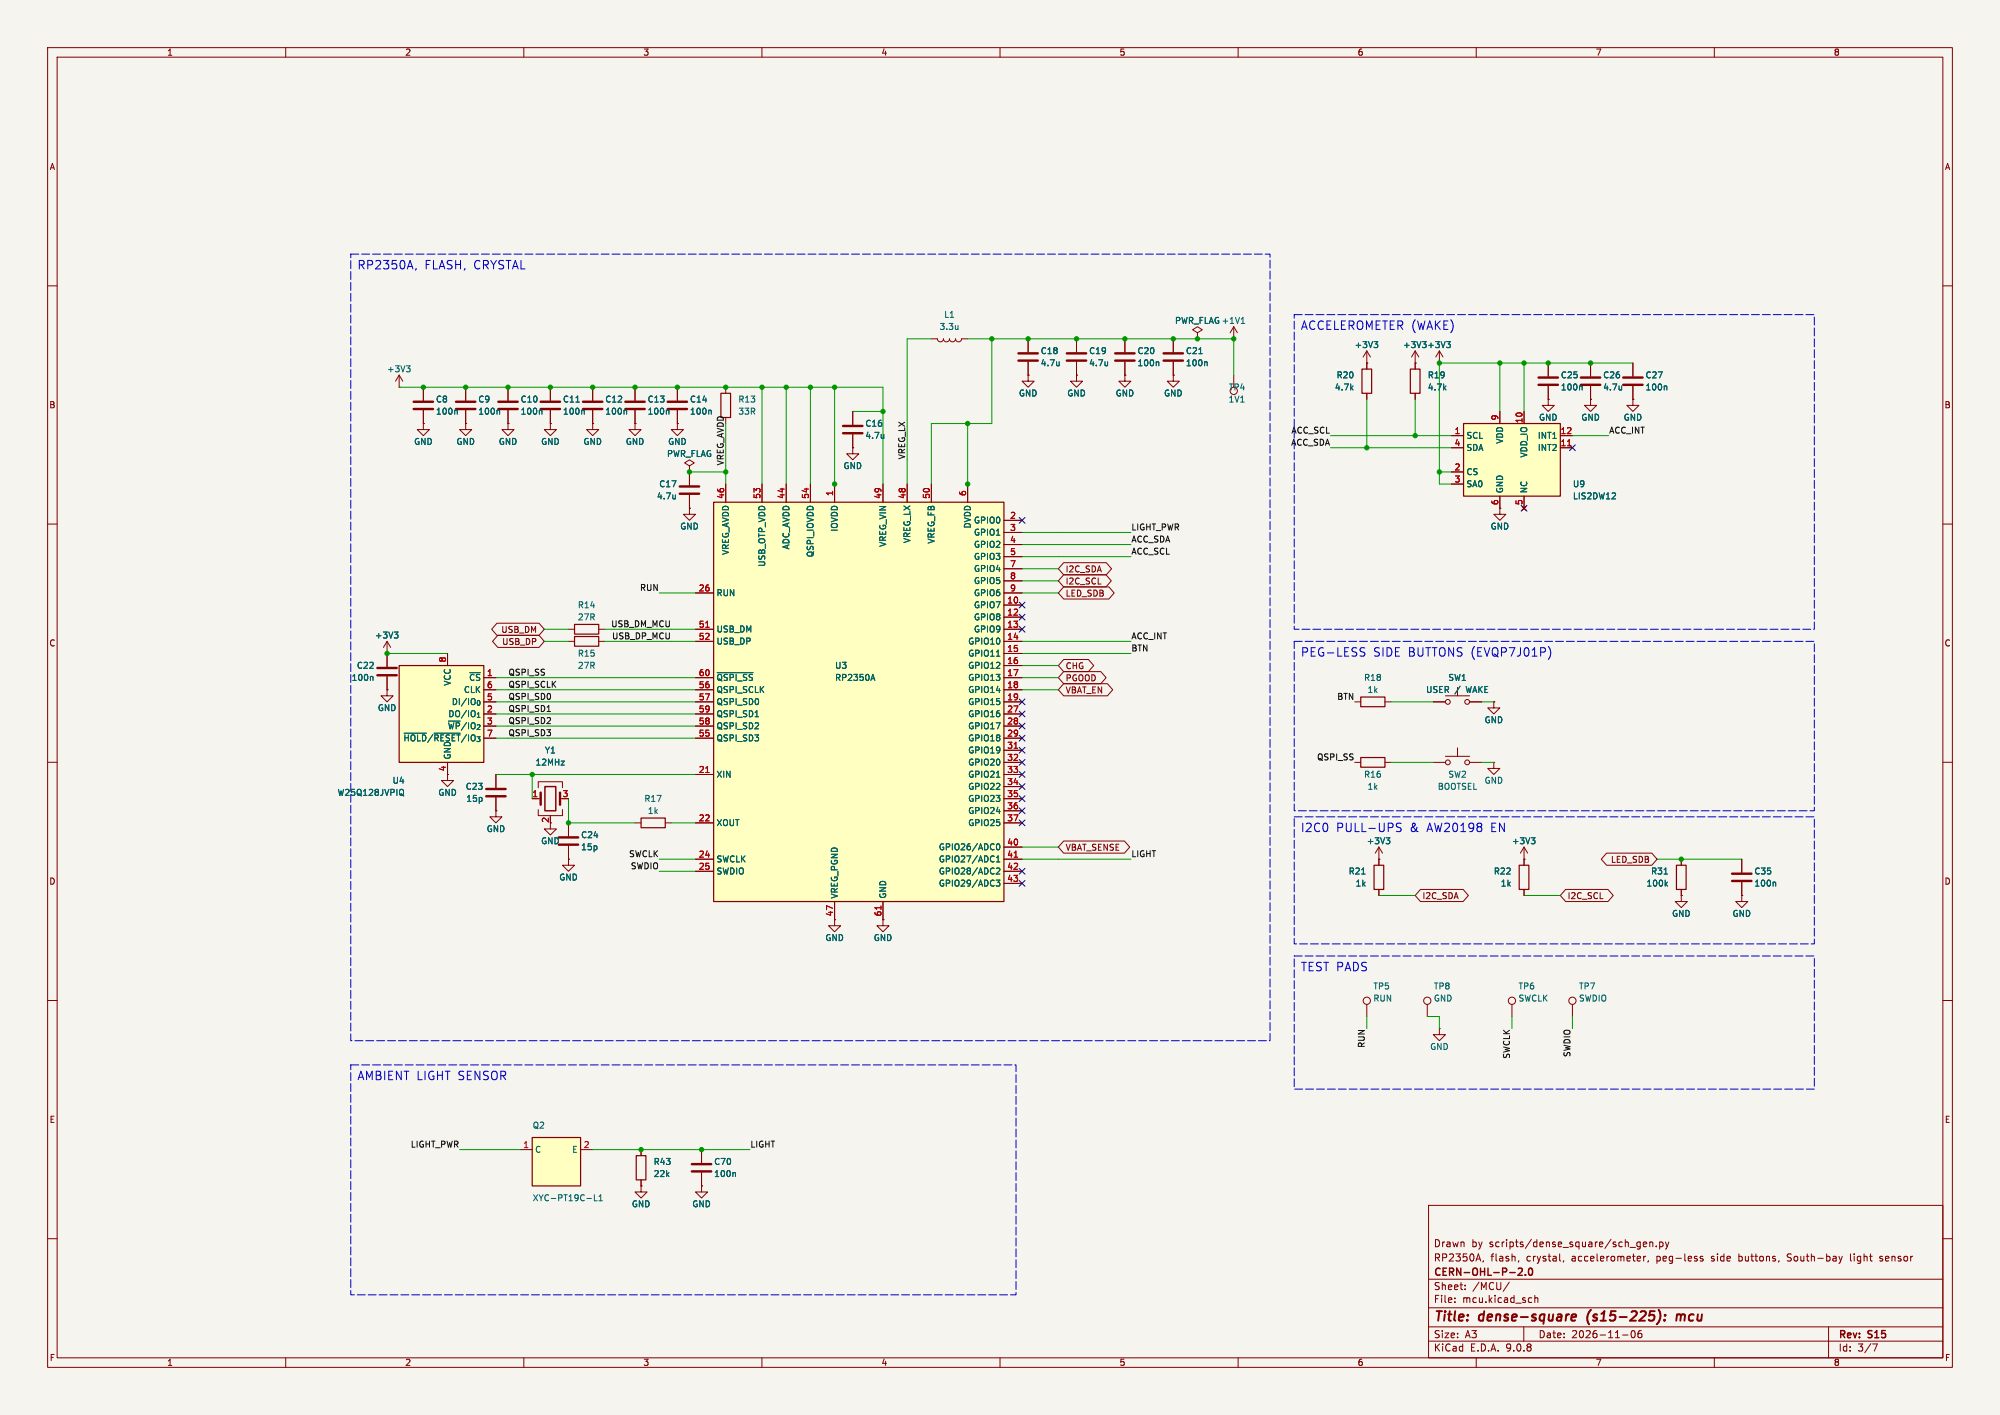
[picture p142: page 3]

6 RUN 26 USB_DM 51 USB_DP 52 ~{QSPI_SS} 60 QSPI_SCLK 56 QSPI_SD0 57 QSPI_SD1 59 QSPI_SD2 58 QSPI_SD3 55 XIN 21 XOUT 22 SWCLK 24 SWDIO 25 ADC_AVDD 44 IOVDD

PEG-LESS SIDE BUTTONS (EVQP7J01P)

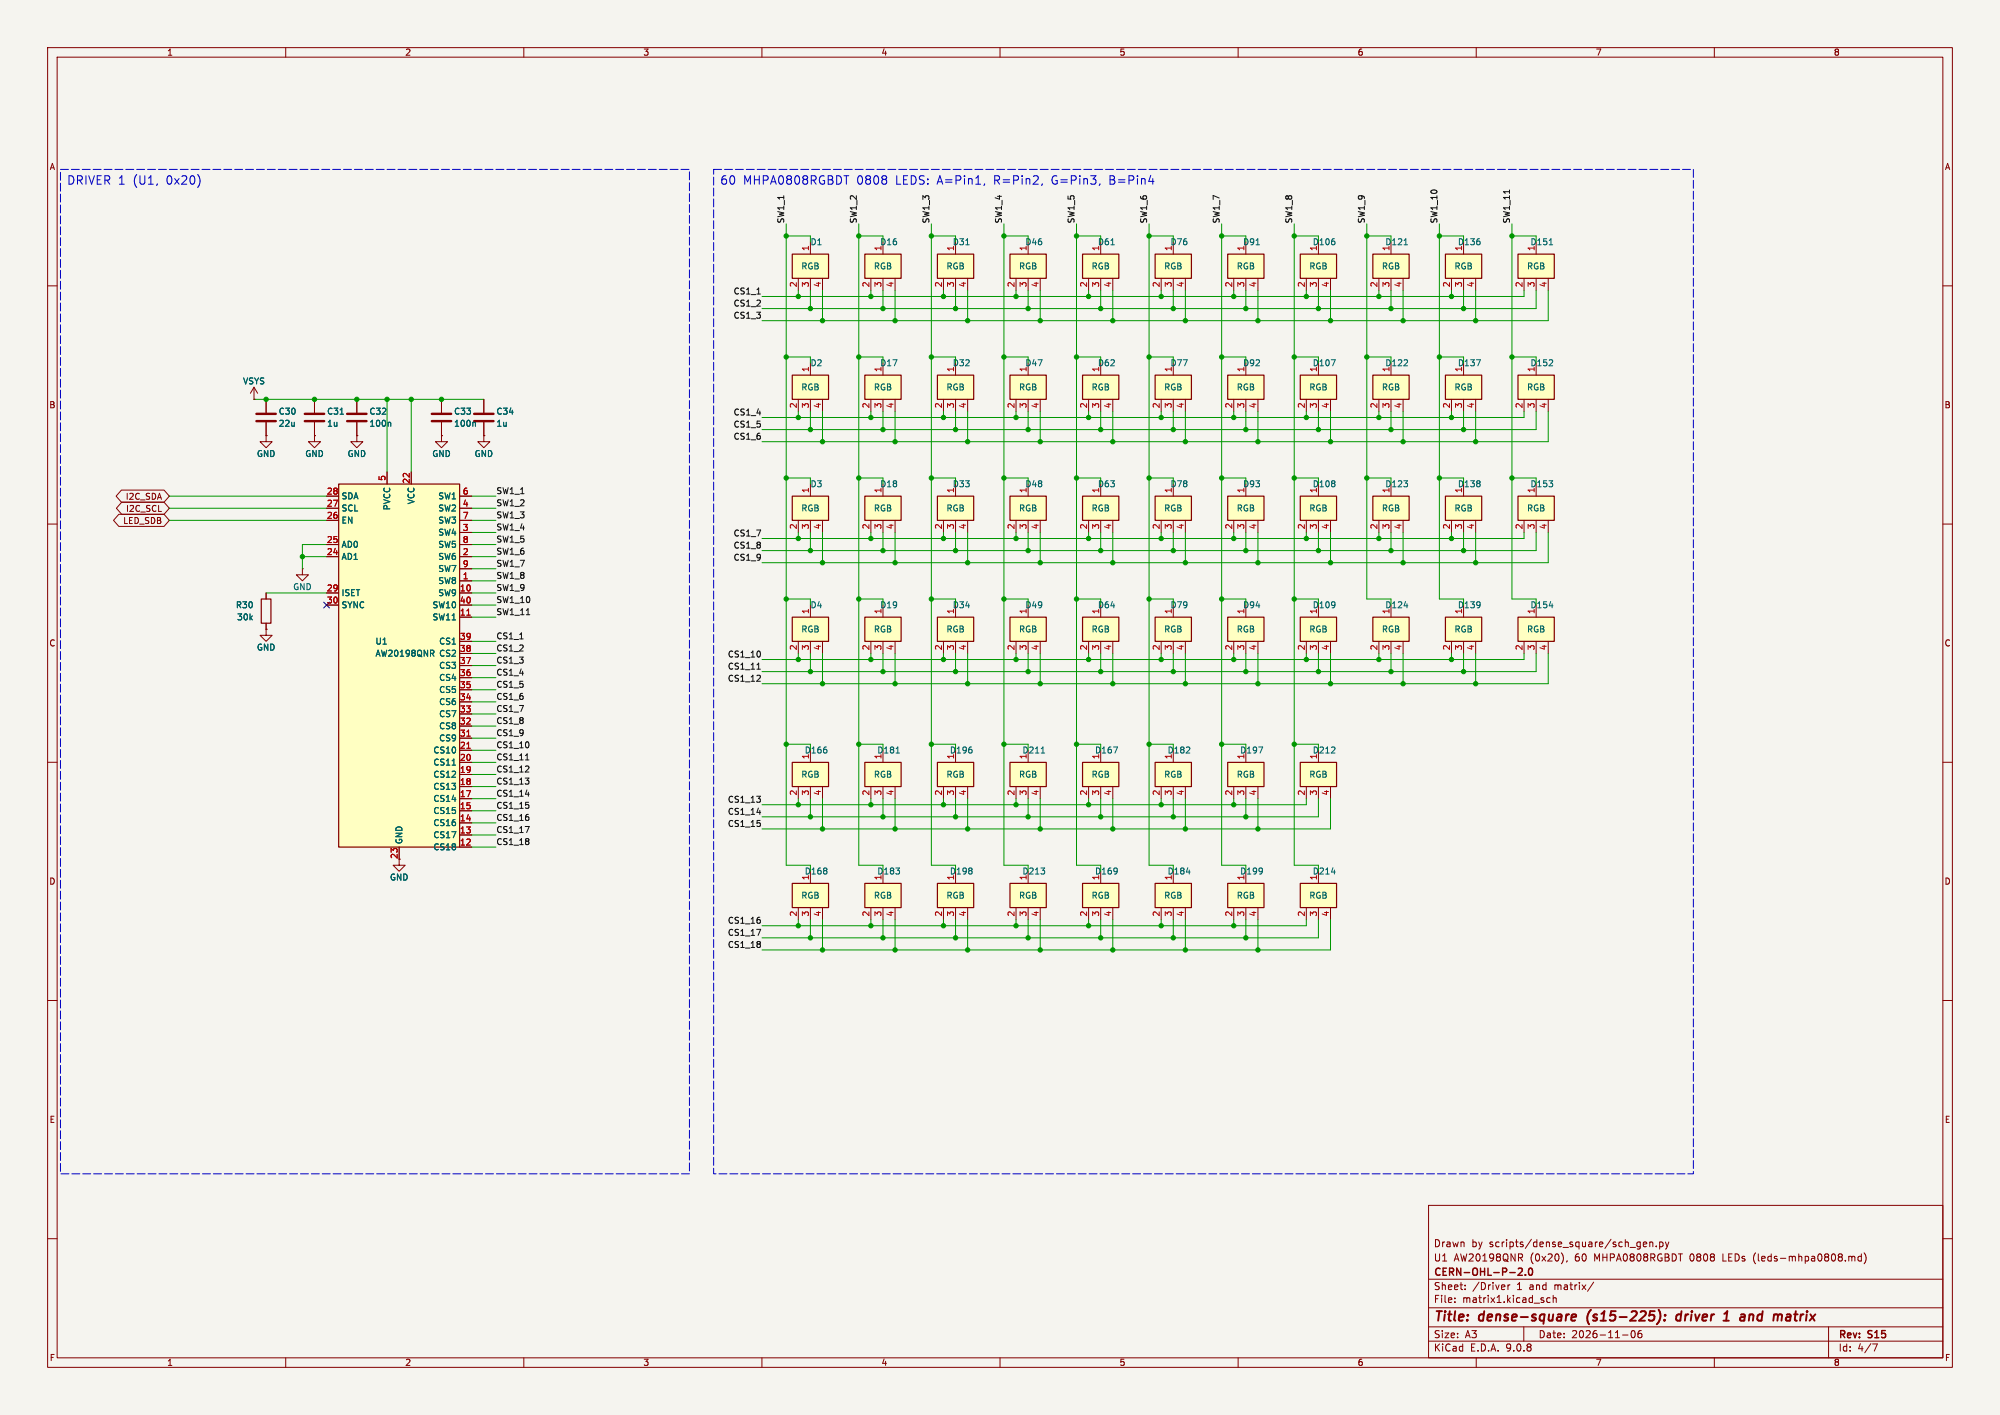
[picture p143: page 4]

5 GND 23 VCC 22 SW1 6 SW2 4 SW3 7 SW4 3 SW5 8 SW6 2 SW7 9 SW8 1 SW9 10 SW10 40 SW11 11 CS1 39 CS2 38 CS3 37 CS4 36 CS5 35 CS6 34 CS7 33 CS8 32 CS9 31 CS10 21 CS11 20 CS12 19 CS13 18 CS14 17 CS15 15 CS16 14 CS17 13 CS18 12 GND GND

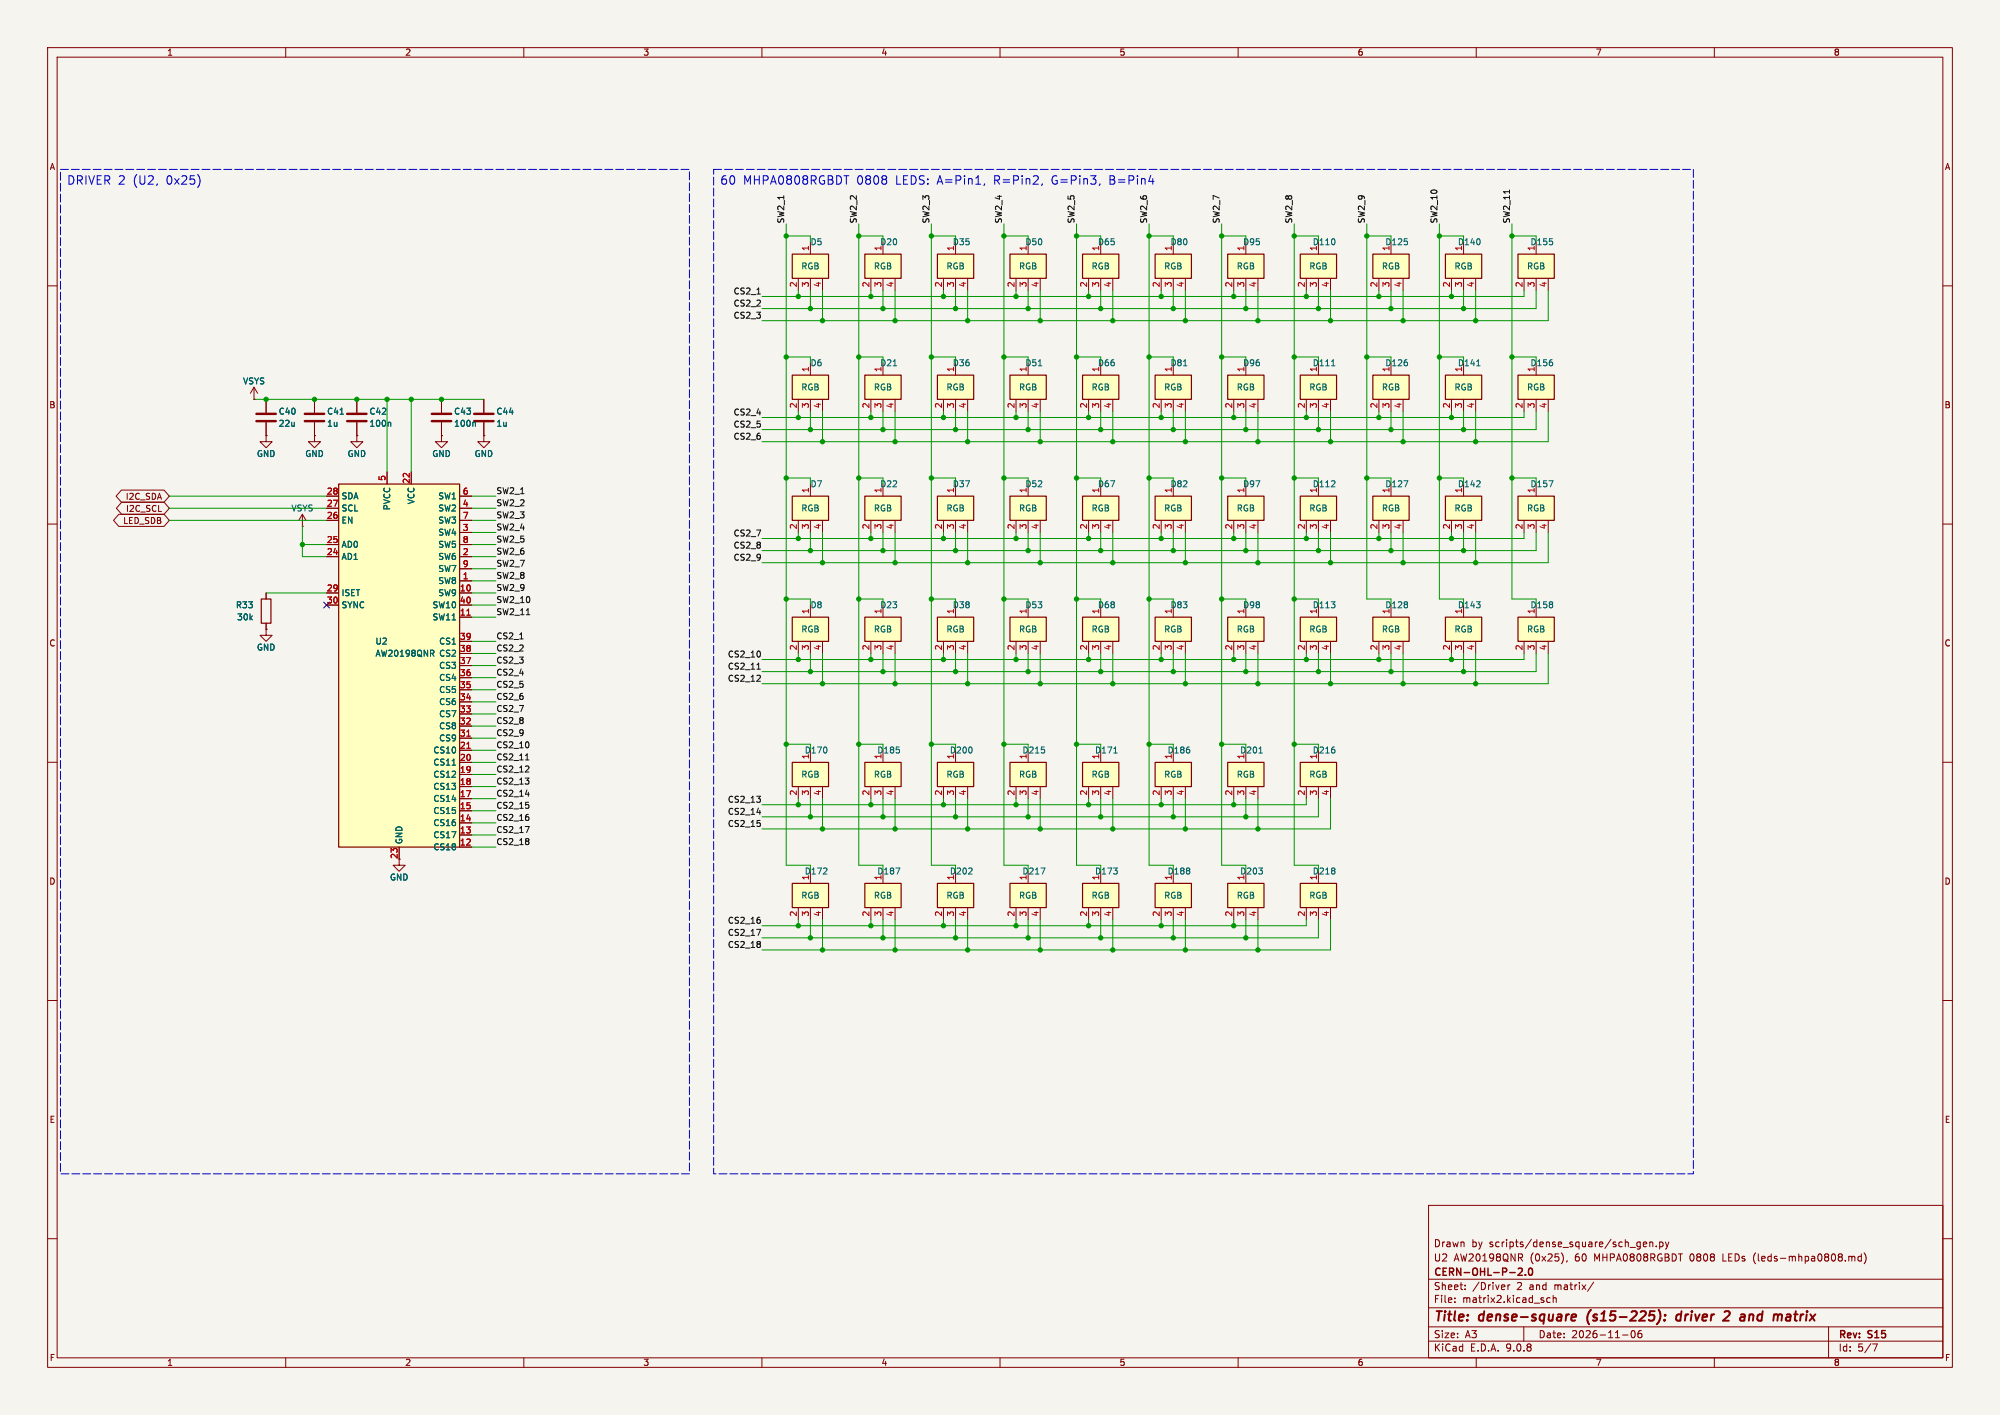
[picture p144: page 5]

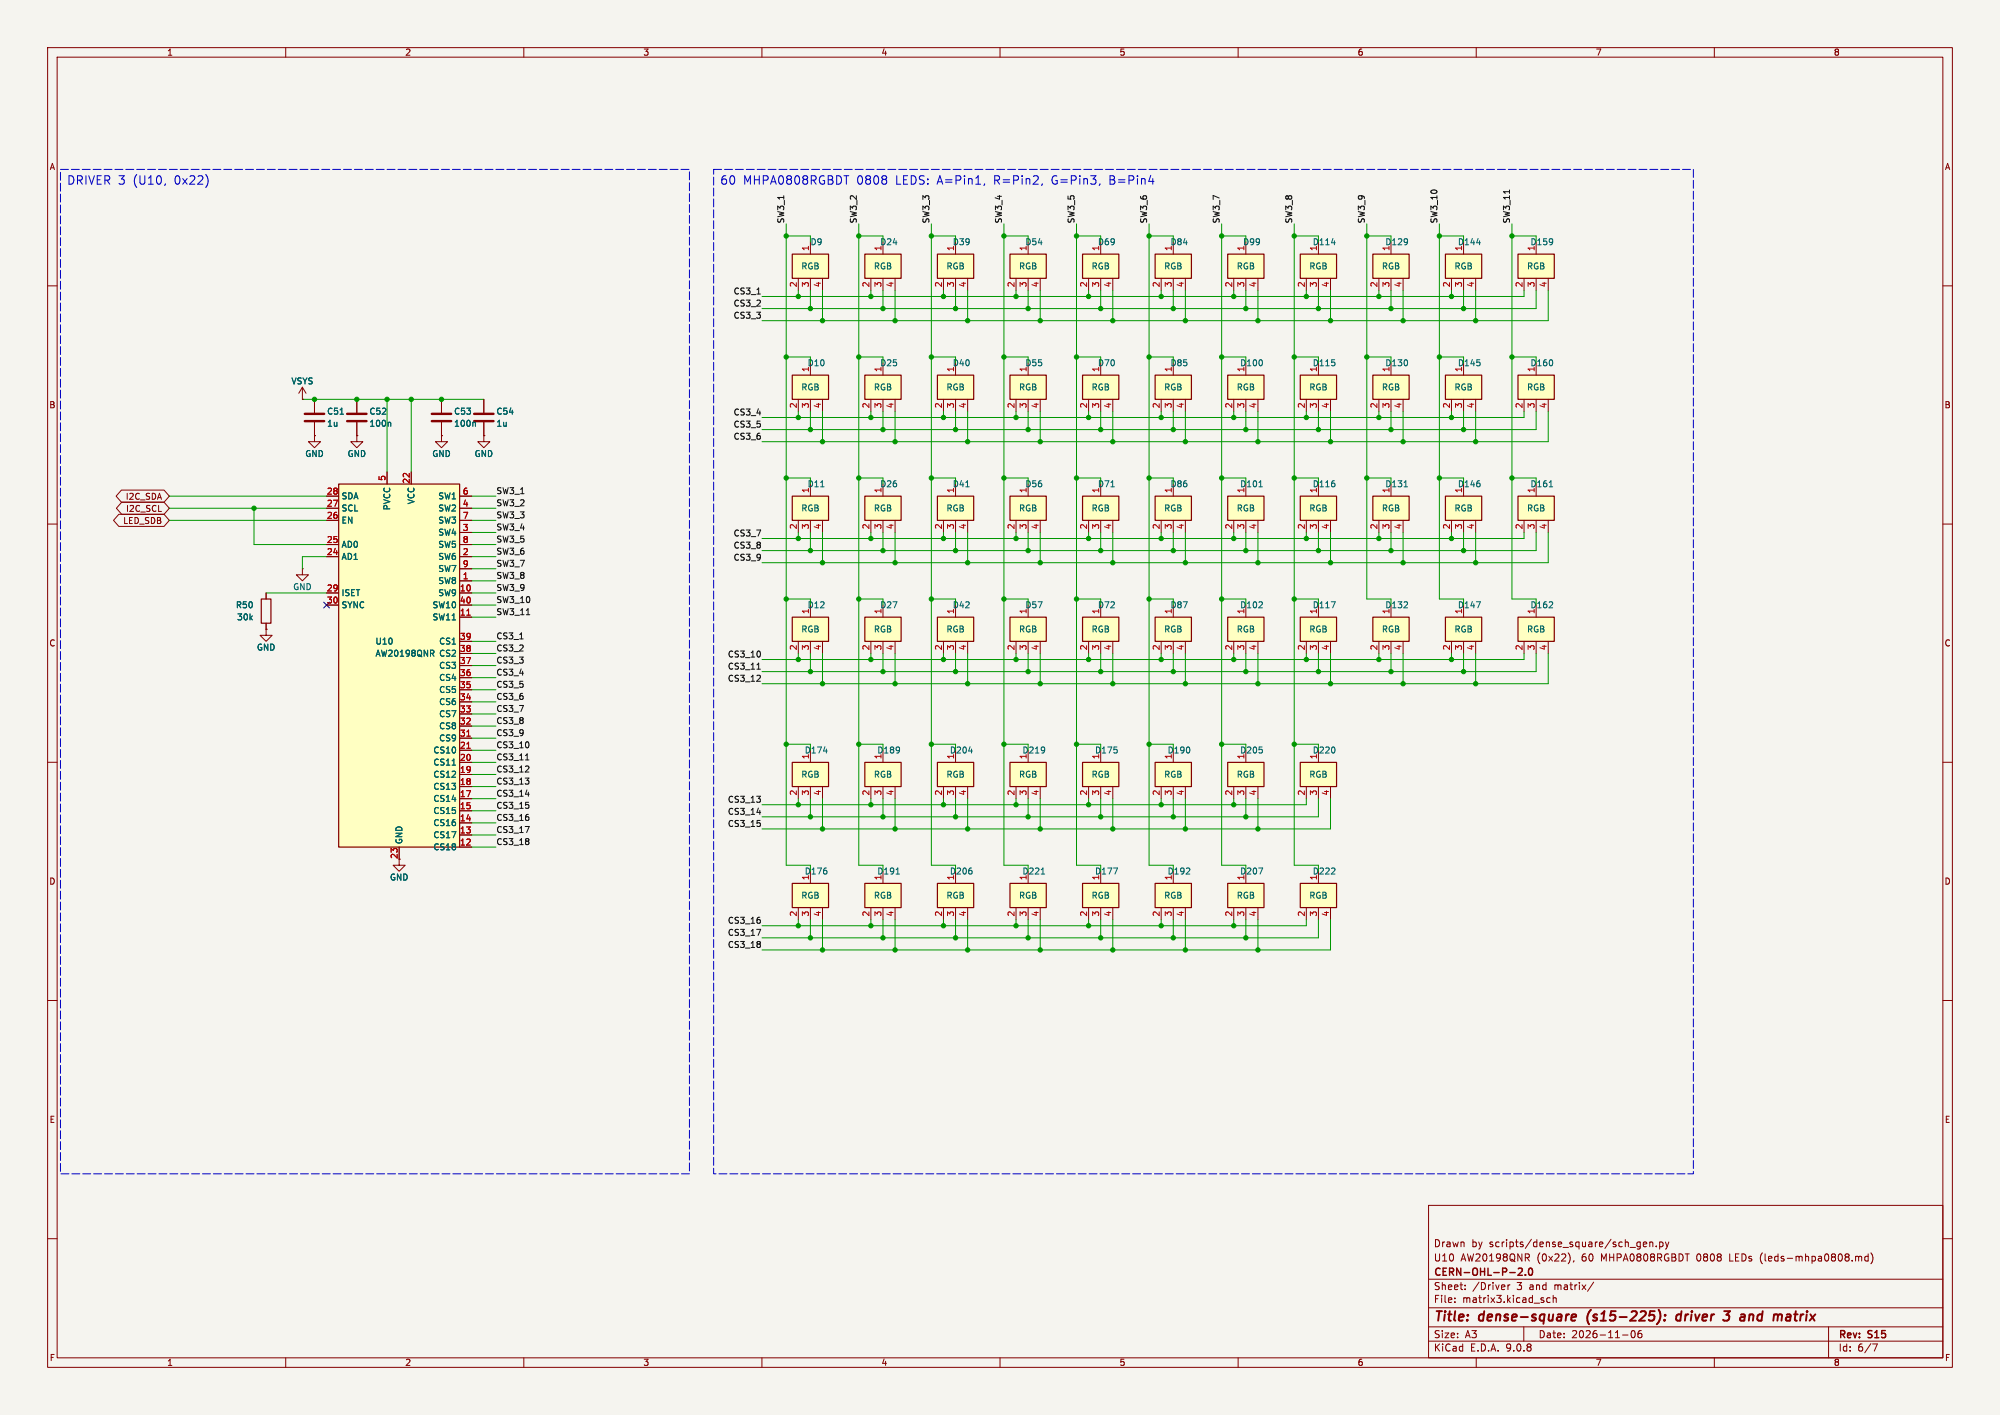
[picture p145: page 6]

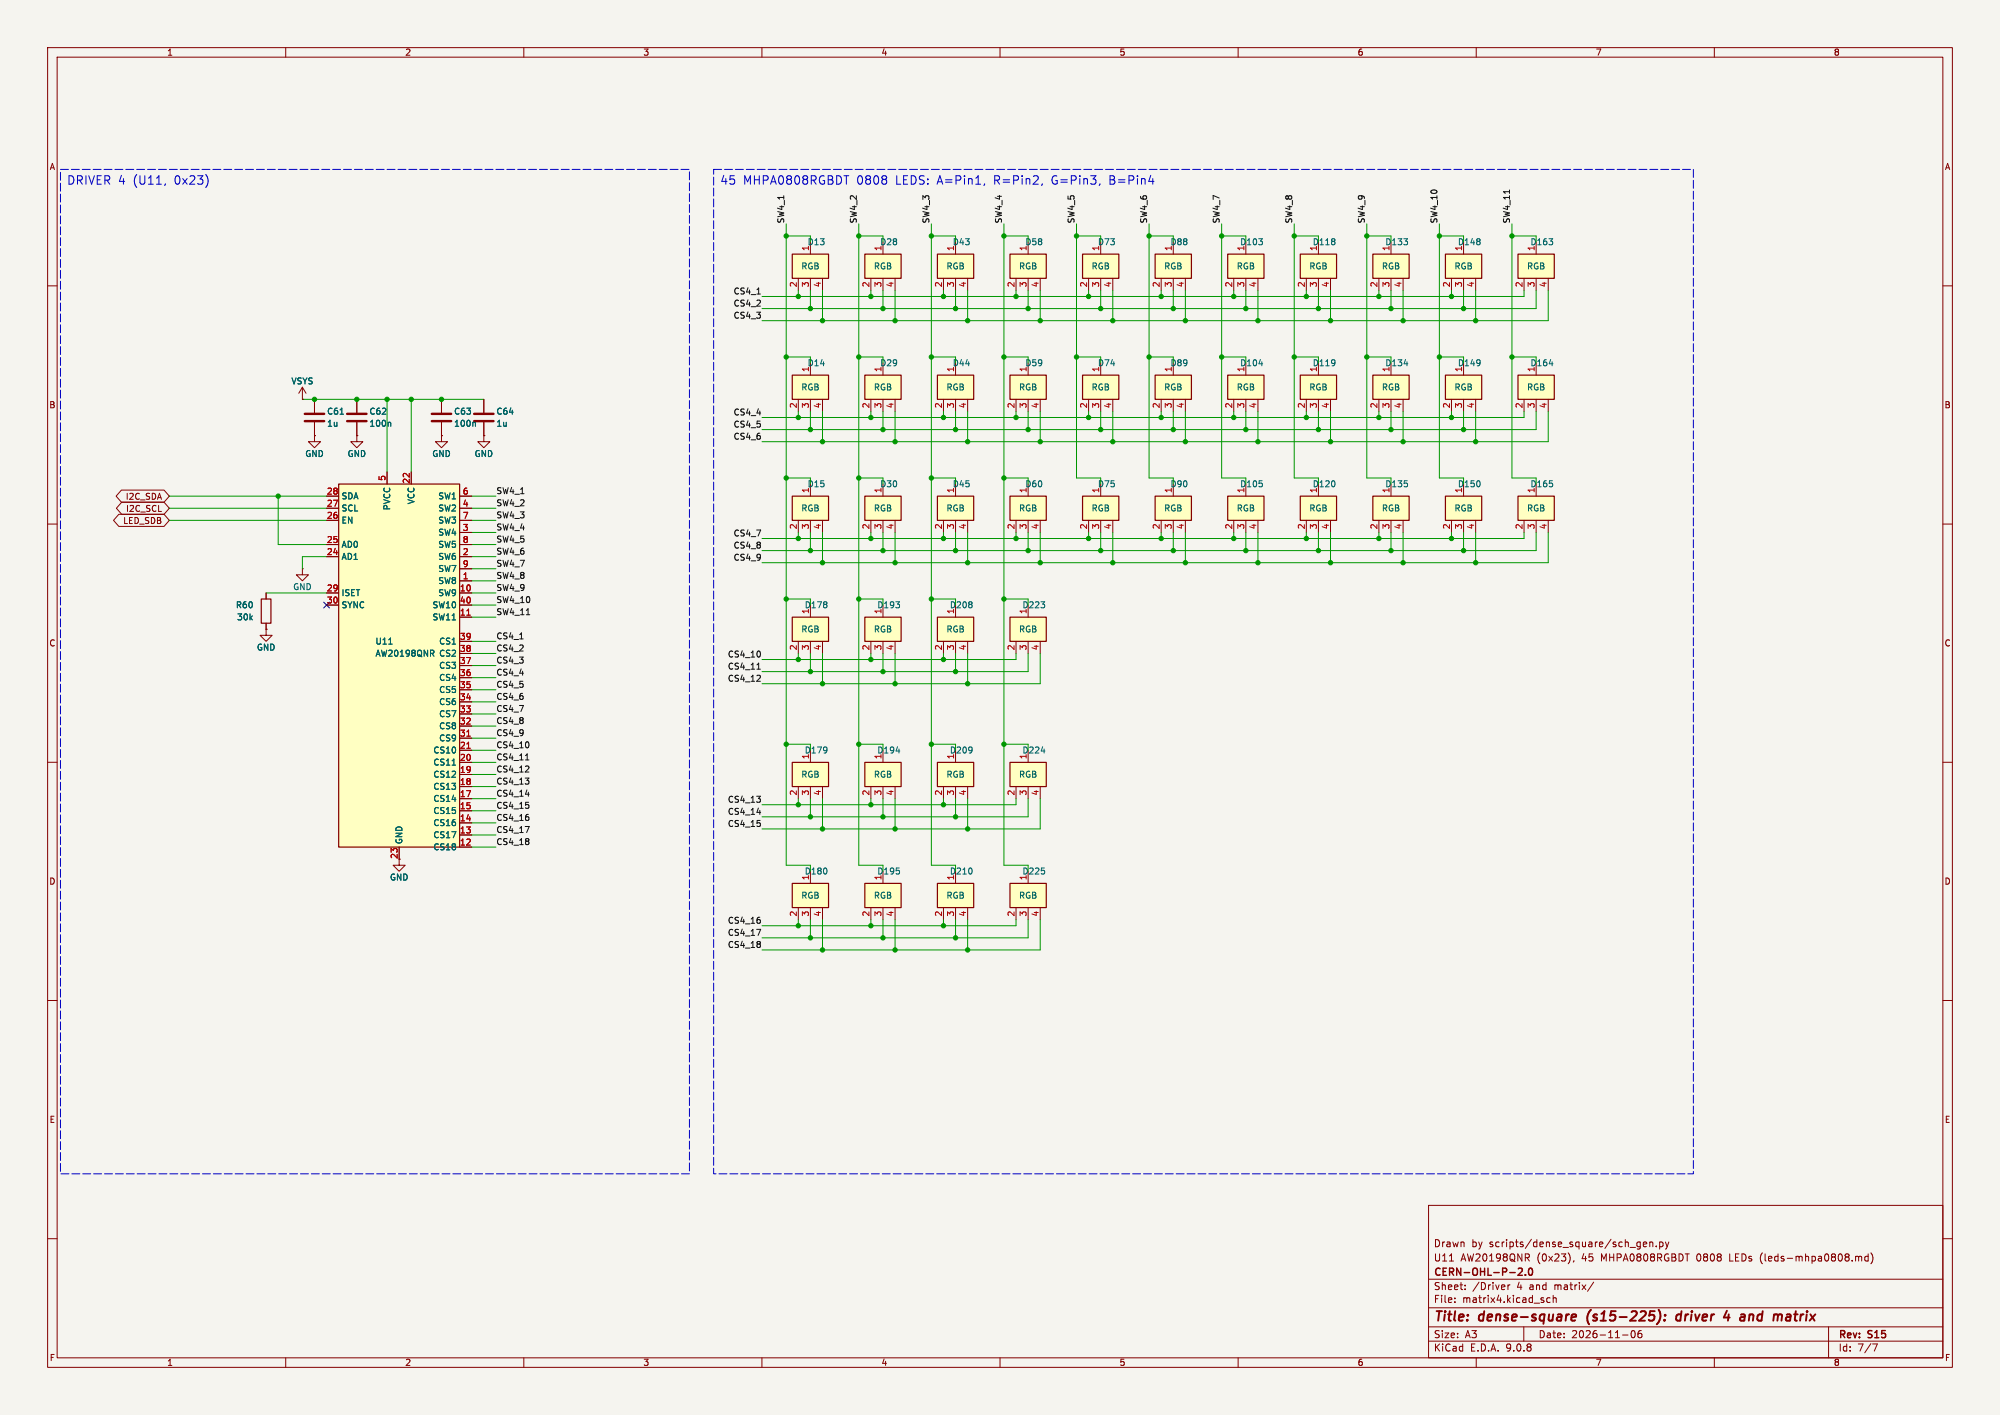
[picture p146: page 7]

4 D59 RGB GND GND GND
