sequoia-hope/matrix-play/design/renders/round-pendant-f-usbc-rtc/assembly-bottom.pdf

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

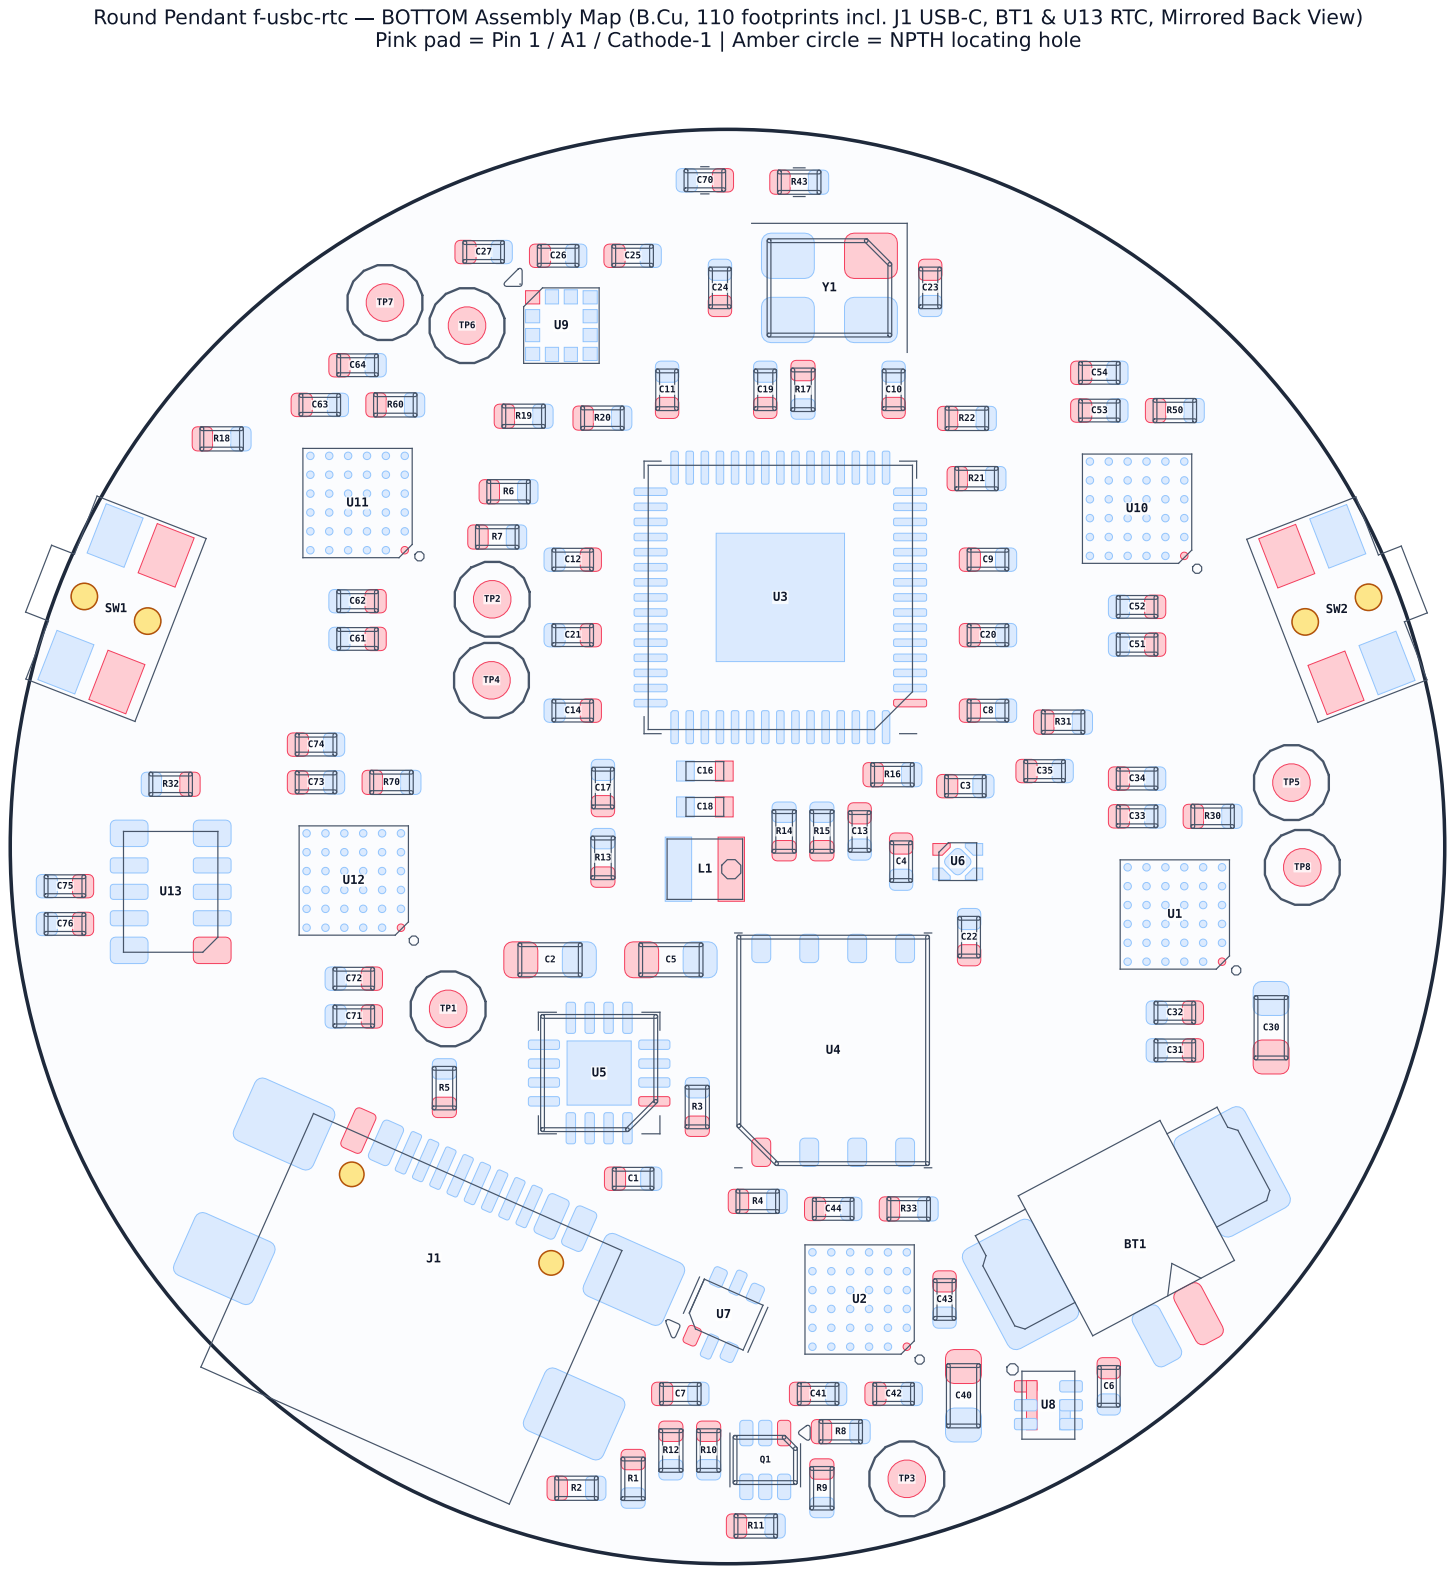
[picture p147: page 1]
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
