sequoia-hope/matrix-play/hw/round-pendant/f-usbc-rtc/fab/assembly-top.pdf

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

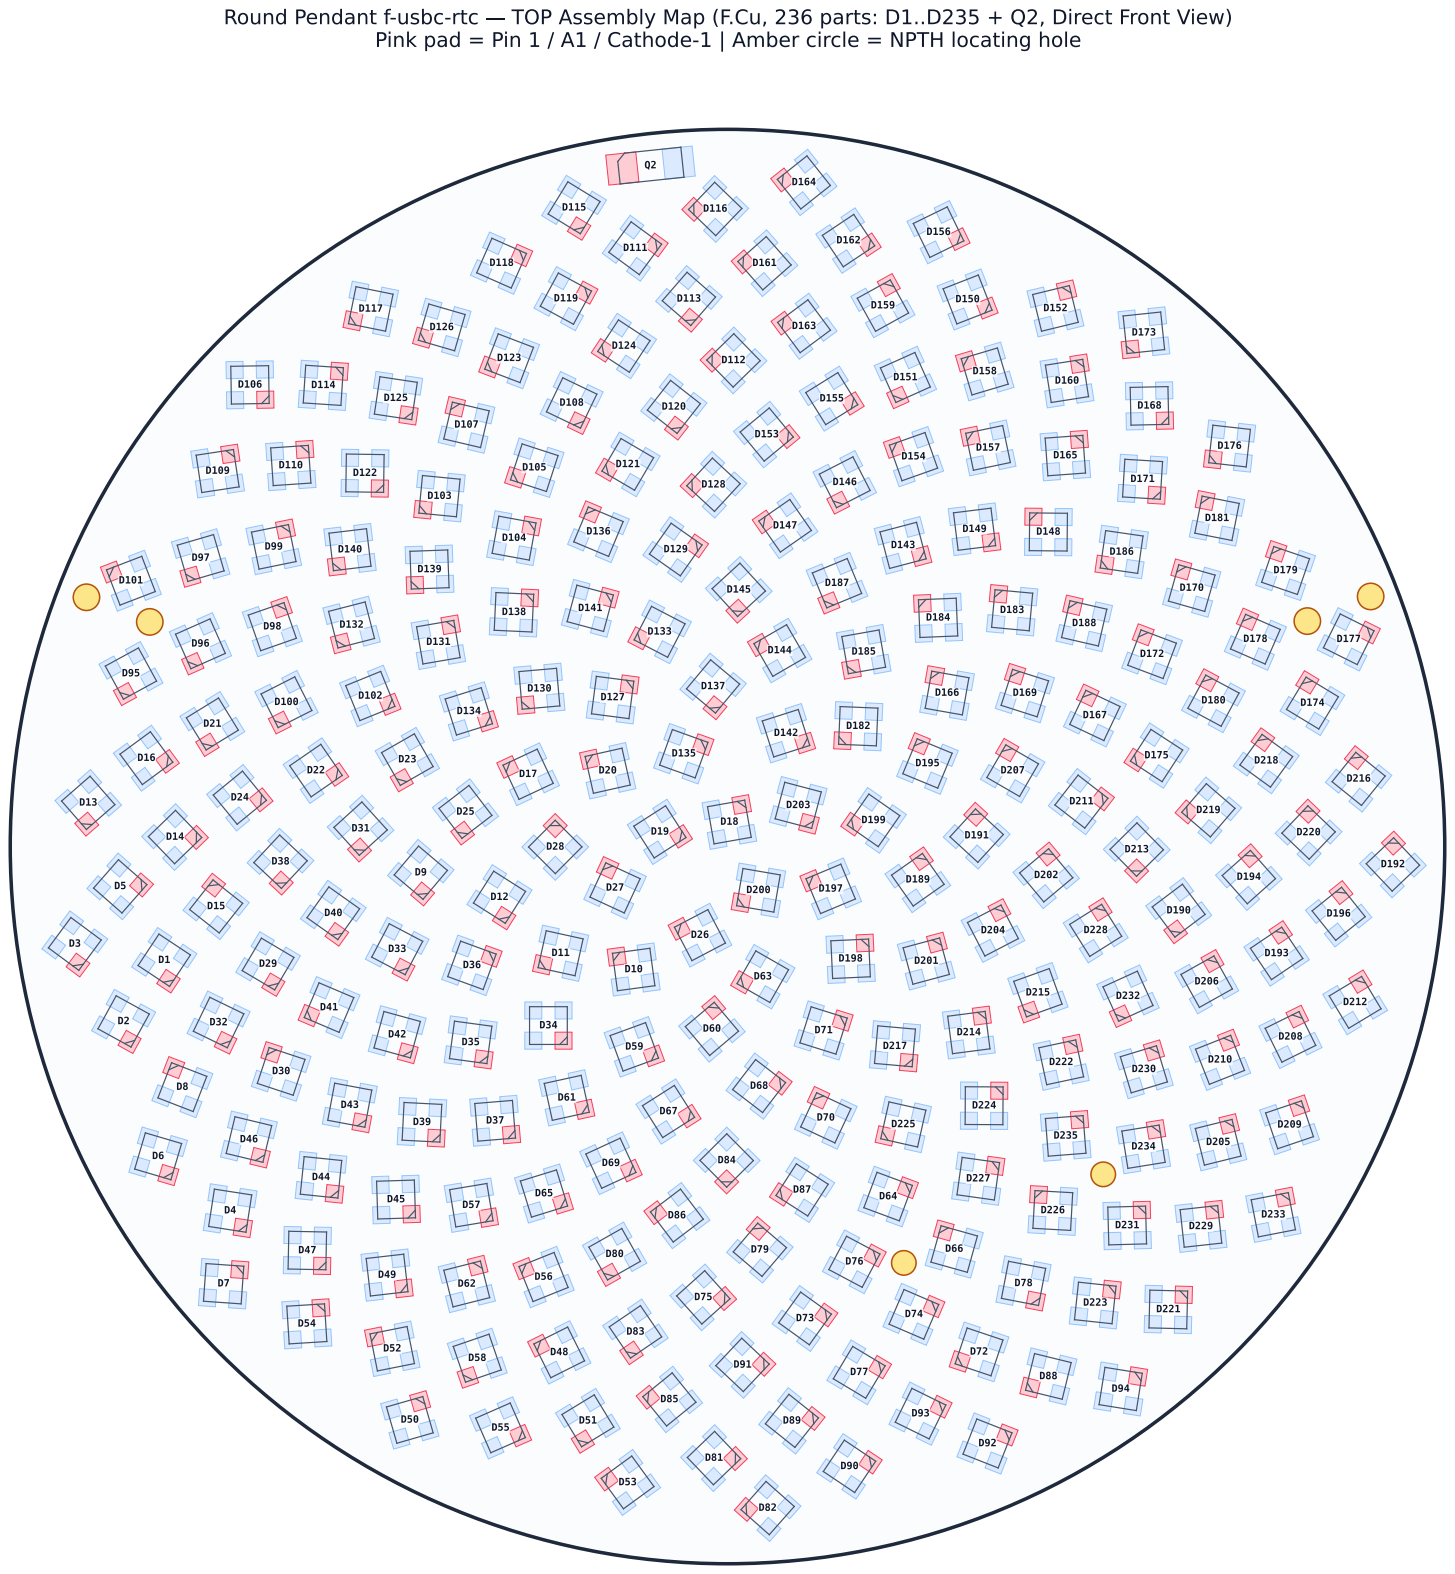
[picture p148: page 1]
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
