sequoia-hope/matrix-play/hw/round-pendant/f-usbc/fab/assembly-bottom.pdf

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

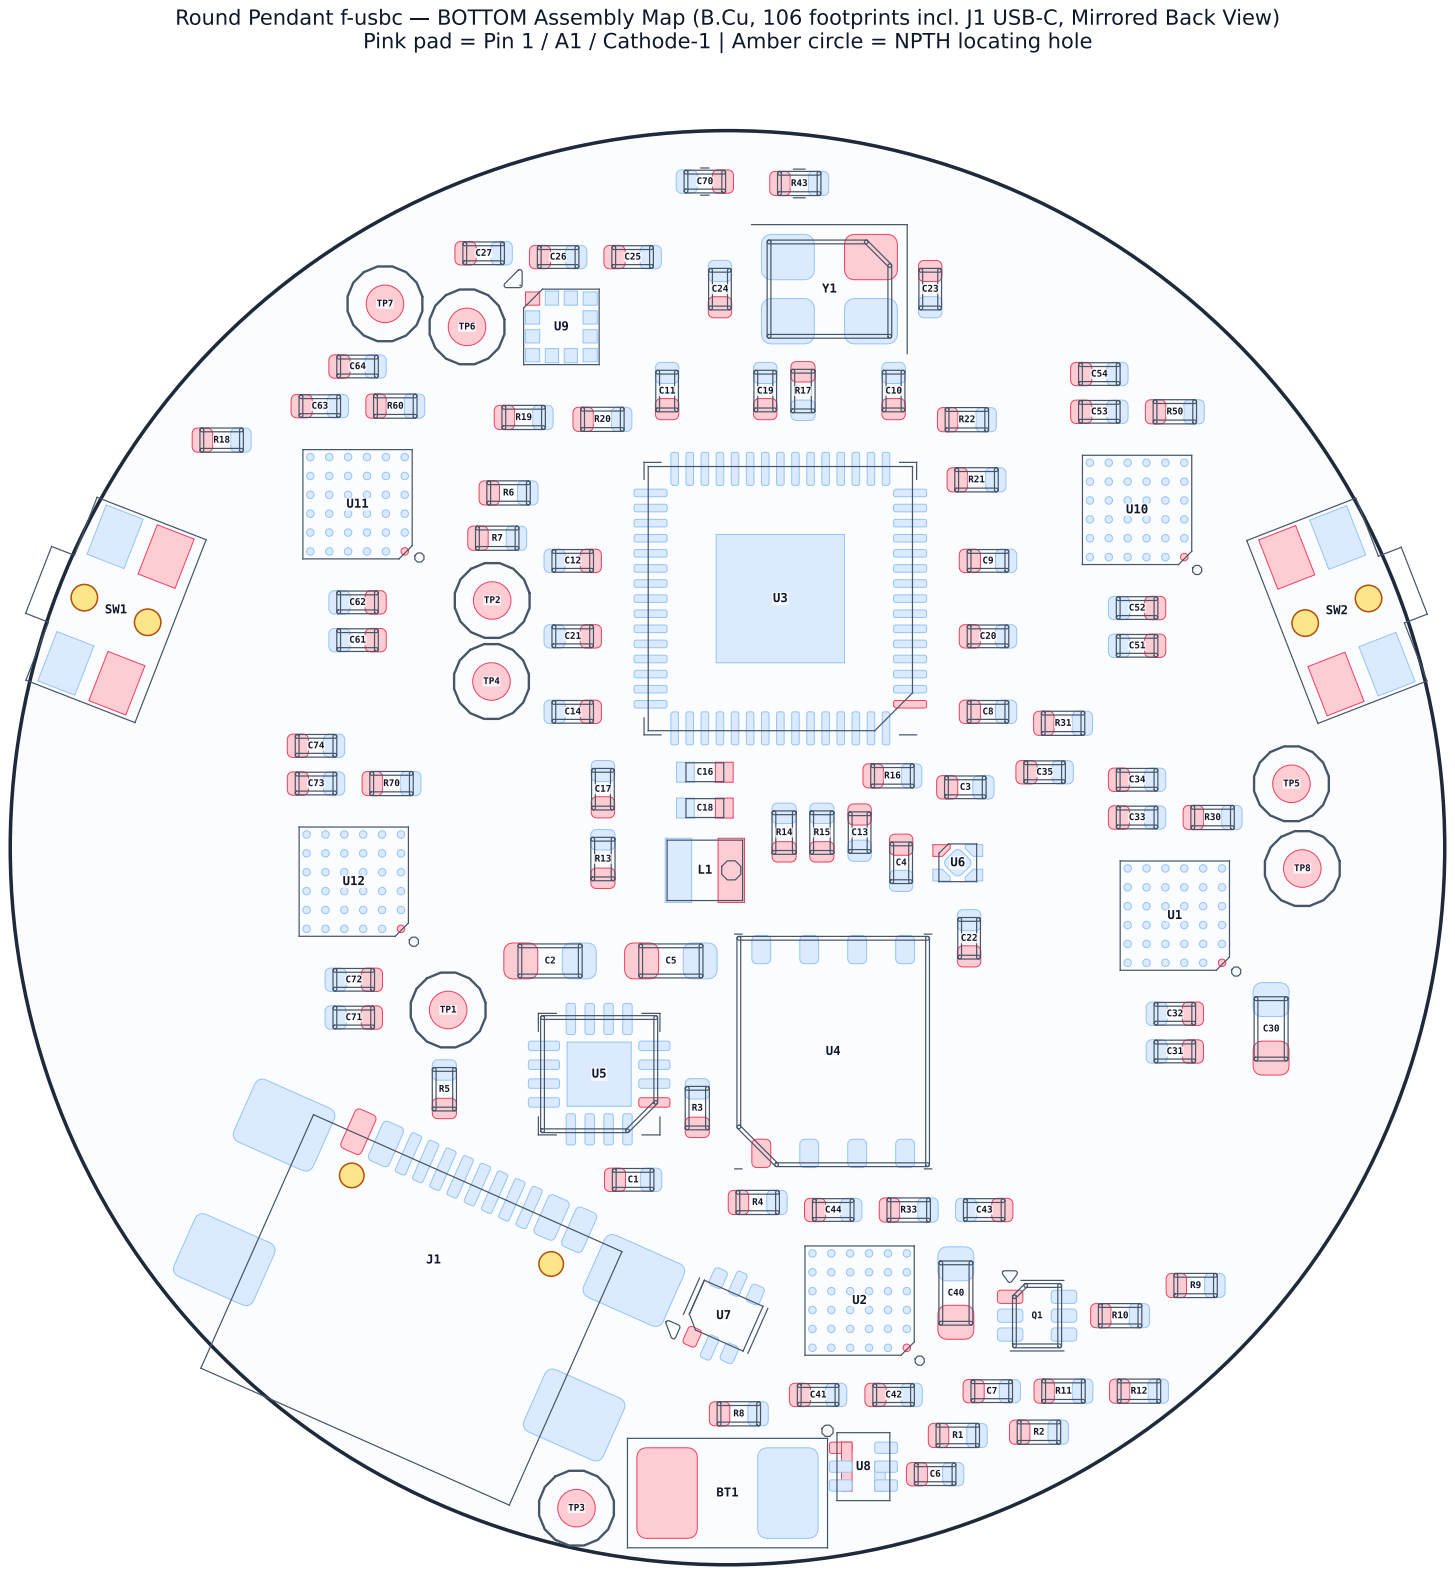
[picture p149: page 1]
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
