sequoia-hope/matrix-play/hw/parallelogram/p2-132-usb6/parallelogram.kicad_pcb

## KiCad design hw/parallelogram/p2-132-usb6/parallelogram.kicad_pcb (2026-11-10)

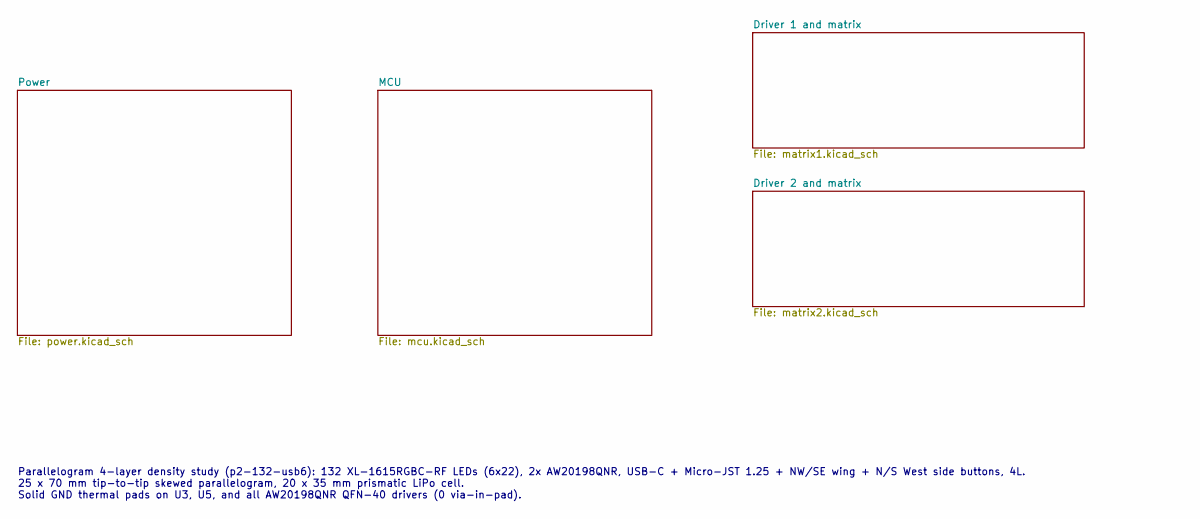
[picture p150: schematic parallelogram.kicad_sch, parallelogram (p2-132-usb6): top]

Notes on the sheet:
Parallelogram 4-layer density study (p2-132-usb6): 132 XL-1615RGBC-RF LEDs (6x22), 2x AW20198QNR, USB-C + Micro-JST 1.25 + NW/SE wing + N/S West side buttons, 4L. 25 x 70 mm tip-to-tip skewed parallelogram, 20 x 35 mm prismatic LiPo cell. Solid GND thermal pads on U3, U5, and all AW20198QNR QFN-40 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

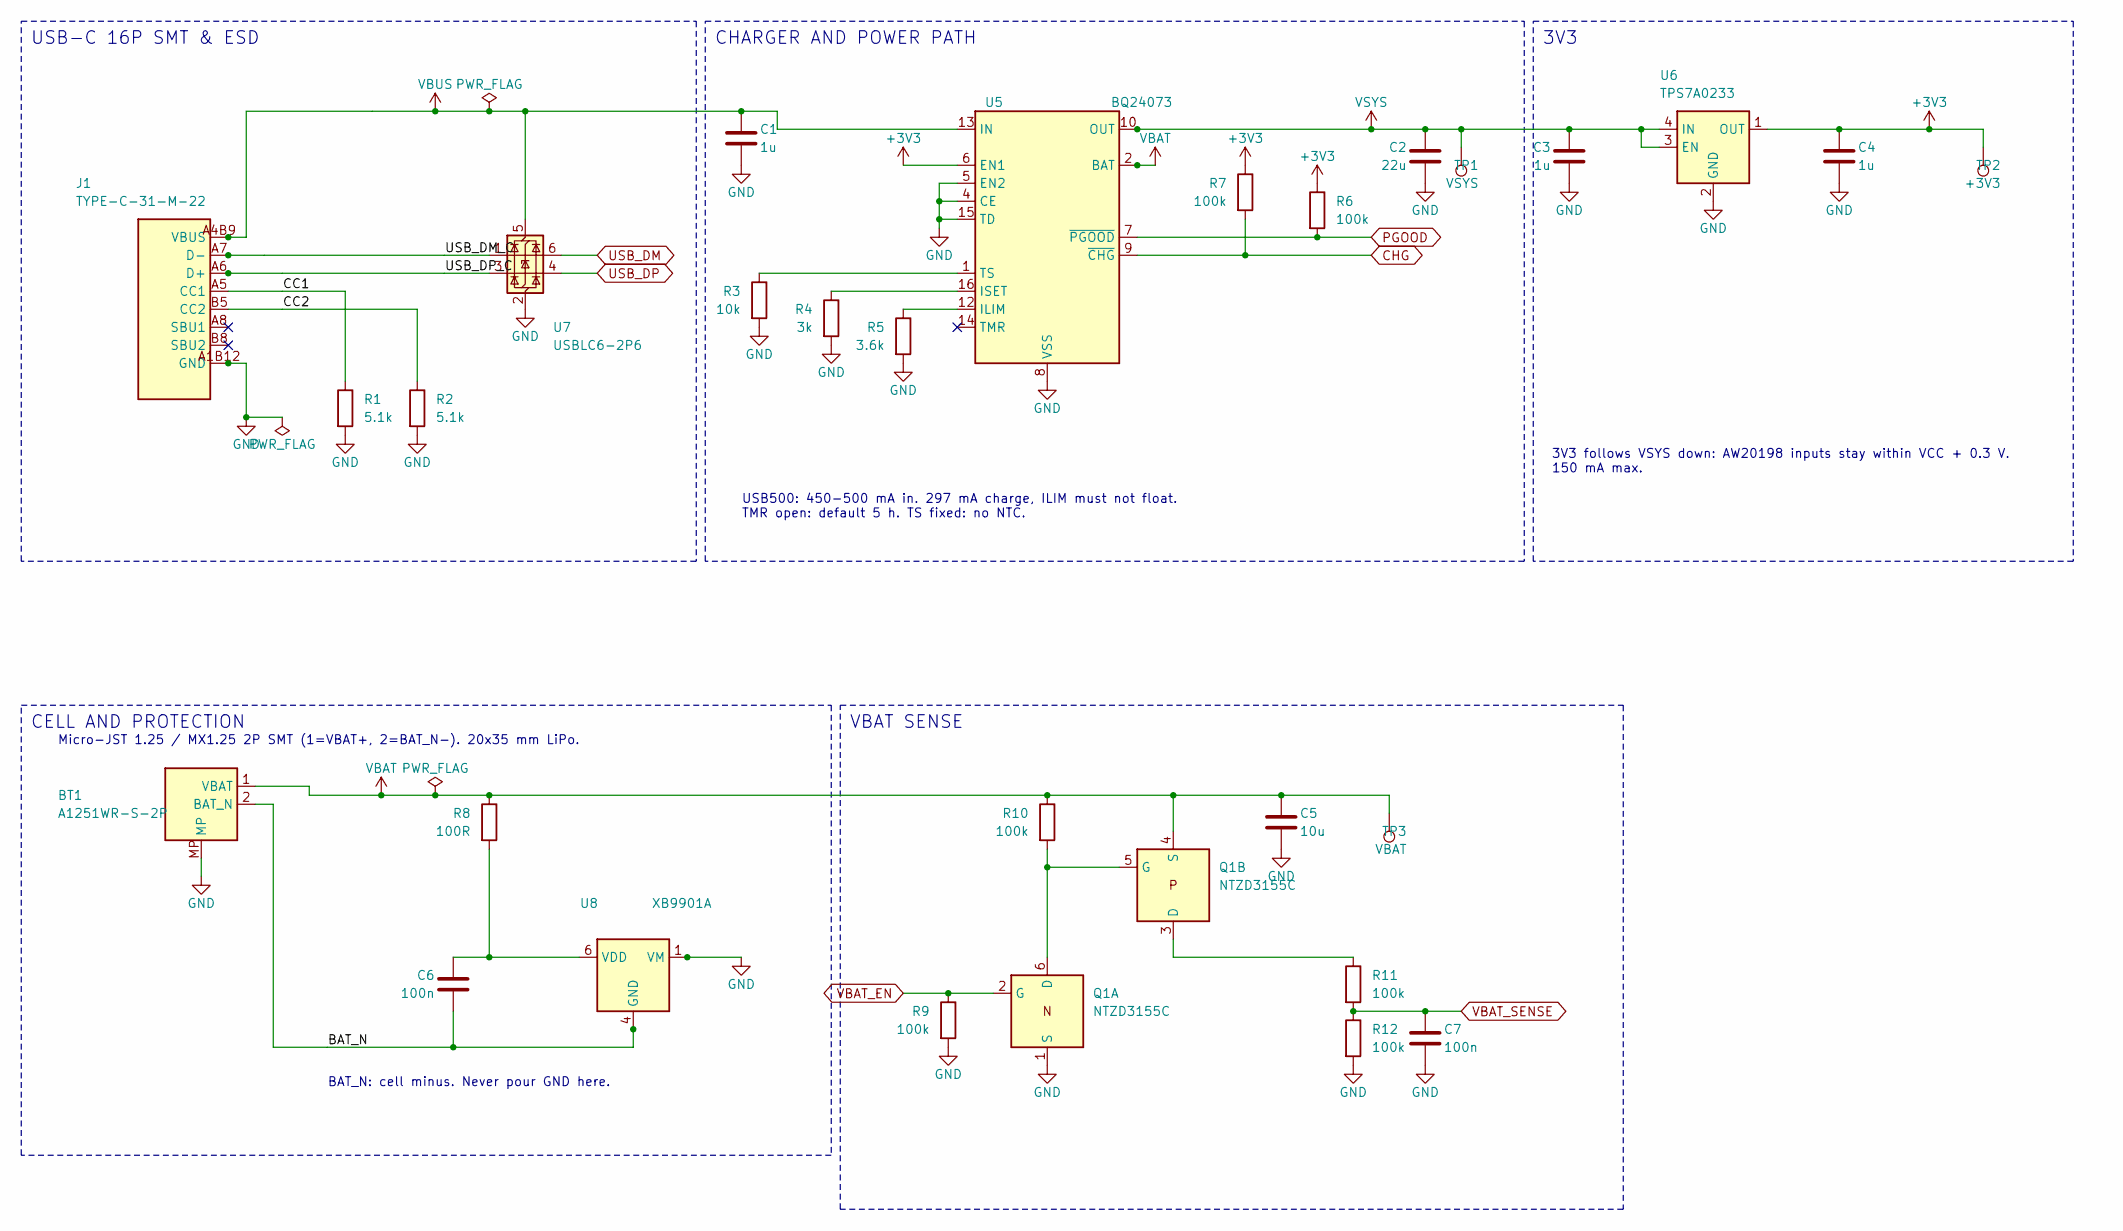
[picture p151: schematic power.kicad_sch, parallelogram (p2-132-usb6): power]

Parts:
BT1: A1251WR-S-2P; Molex_PicoBlade_53261-0271_1x02-1MP_P1.25mm_Horizontal; MPN A1251WR-S-2P; LCSC C225111
C1, C3, C4: 1u; C_0402_1005Metric; MPN CL05A105KA5NQNC; LCSC C52923
C2: 22u; C_0603_1608Metric; MPN CL10A226MP8NUNE; LCSC C86295
C5: 10u; C_0603_1608Metric; MPN CL10A106KP8NNNC; LCSC C19702
C6, C7: 100n; C_0402_1005Metric; MPN CL05B104KO5NNNC; LCSC C1525
J1: TYPE-C-31-M-22; USB_C_Receptacle_Hroparts_TYPE-C-31-M-22; MPN TYPE-C-31-M-22; LCSC C530612
Q1: NTZD3155C; SOT-563; MPN NTZD3155CT1G; LCSC C236117
R1, R2: 5.1k; R_0402_1005Metric; MPN 0402WGF5101TCE; LCSC C25905
R3: 10k; R_0402_1005Metric; MPN 0402WGF1002TCE; LCSC C25744
R4: 3k; R_0402_1005Metric; MPN 0402WGF3001TCE; LCSC C25784
R5: 3.6k; R_0402_1005Metric; MPN 0402WGF3601TCE; LCSC C25891
R6, R7, R9, R10, R11, R12: 100k; R_0402_1005Metric; MPN 0402WGF1003TCE; LCSC C25741
R8: 100R; R_0402_1005Metric; MPN 0402WGF1000TCE; LCSC C25076
TP1: VSYS; TestPoint_Pad_D1.0mm
TP2: +3V3; TestPoint_Pad_D1.0mm
TP3: VBAT; TestPoint_Pad_D1.0mm
U5: BQ24073; QFN-16-1EP_3x3mm_P0.5mm_EP1.7x1.7mm; MPN BQ24073RGTR; LCSC C15220
U6: TPS7A0233; Texas_X2SON-4_1x1mm_P0.65mm; MPN TPS7A0233PDQNR; LCSC C2860046
U7: USBLC6-2P6; SOT-666; MPN USBLC6-2P6; LCSC C15999
U8: XB9901A; XySemi_DFN-6_1.8x1.4mm; MPN XB9901A; LCSC C669687

Connections:
+3V3: C4.1, R6.1, R7.1, TP2.1, U5.6 (EN1), U6.1 (OUT); also elsewhere on the board
/Power/BAT_N: BT1.2 (BAT_N), C6.2, U8.4 (GND), U8.5 (GND)
/Power/CC1: J1.A5 (CC1), R1.1
/Power/CC2: J1.B5 (CC2), R2.1
/Power/USB_DM_C: J1.A7 (D-), J1.B7 (D-), U7.1 (I/O1)
/Power/USB_DP_C: J1.A6 (D+), J1.B6 (D+), U7.3 (I/O2)
CHG: R7.2, U5.9 (~CHG); also elsewhere on the board
unnamed: Q1.5 (G), Q1.6 (D), R10.2
unnamed: Q1.3 (D), R11.1
unnamed: R5.1, U5.12 (ILIM)
unnamed: R4.1, U5.16 (ISET)
unnamed: R3.1, U5.1 (TS)
unnamed: C6.1, R8.2, U8.6 (VDD)
PGOOD: R6.2, U5.7 (~PGOOD); also elsewhere on the board
USB_DM: U7.6 (I/O1); also elsewhere on the board
USB_DP: U7.4 (I/O2); also elsewhere on the board
VBAT_EN: Q1.2 (G), R9.1; also elsewhere on the board
VBAT_SENSE: C7.1, R11.2, R12.1; also elsewhere on the board
VSYS: C2.1, C3.1, TP1.1, U5.10 (OUT), U5.11 (OUT), U6.3 (EN), U6.4 (IN); also elsewhere on the board

Notes on the sheet:
USB-C 16P SMT & ESD
USB500: 450-500 mA in. 297 mA charge, ILIM must not float. TMR open: default 5 h. TS fixed: no NTC.
CHARGER AND POWER PATH
3V3 follows VSYS down: AW20198 inputs stay within VCC + 0.3 V. 150 mA max.
3V3
Micro-JST 1.25 / MX1.25 2P SMT (1=VBAT+, 2=BAT_N-). 20x35 mm LiPo.
BAT_N: cell minus. Never pour GND here.
CELL AND PROTECTION
VBAT SENSE

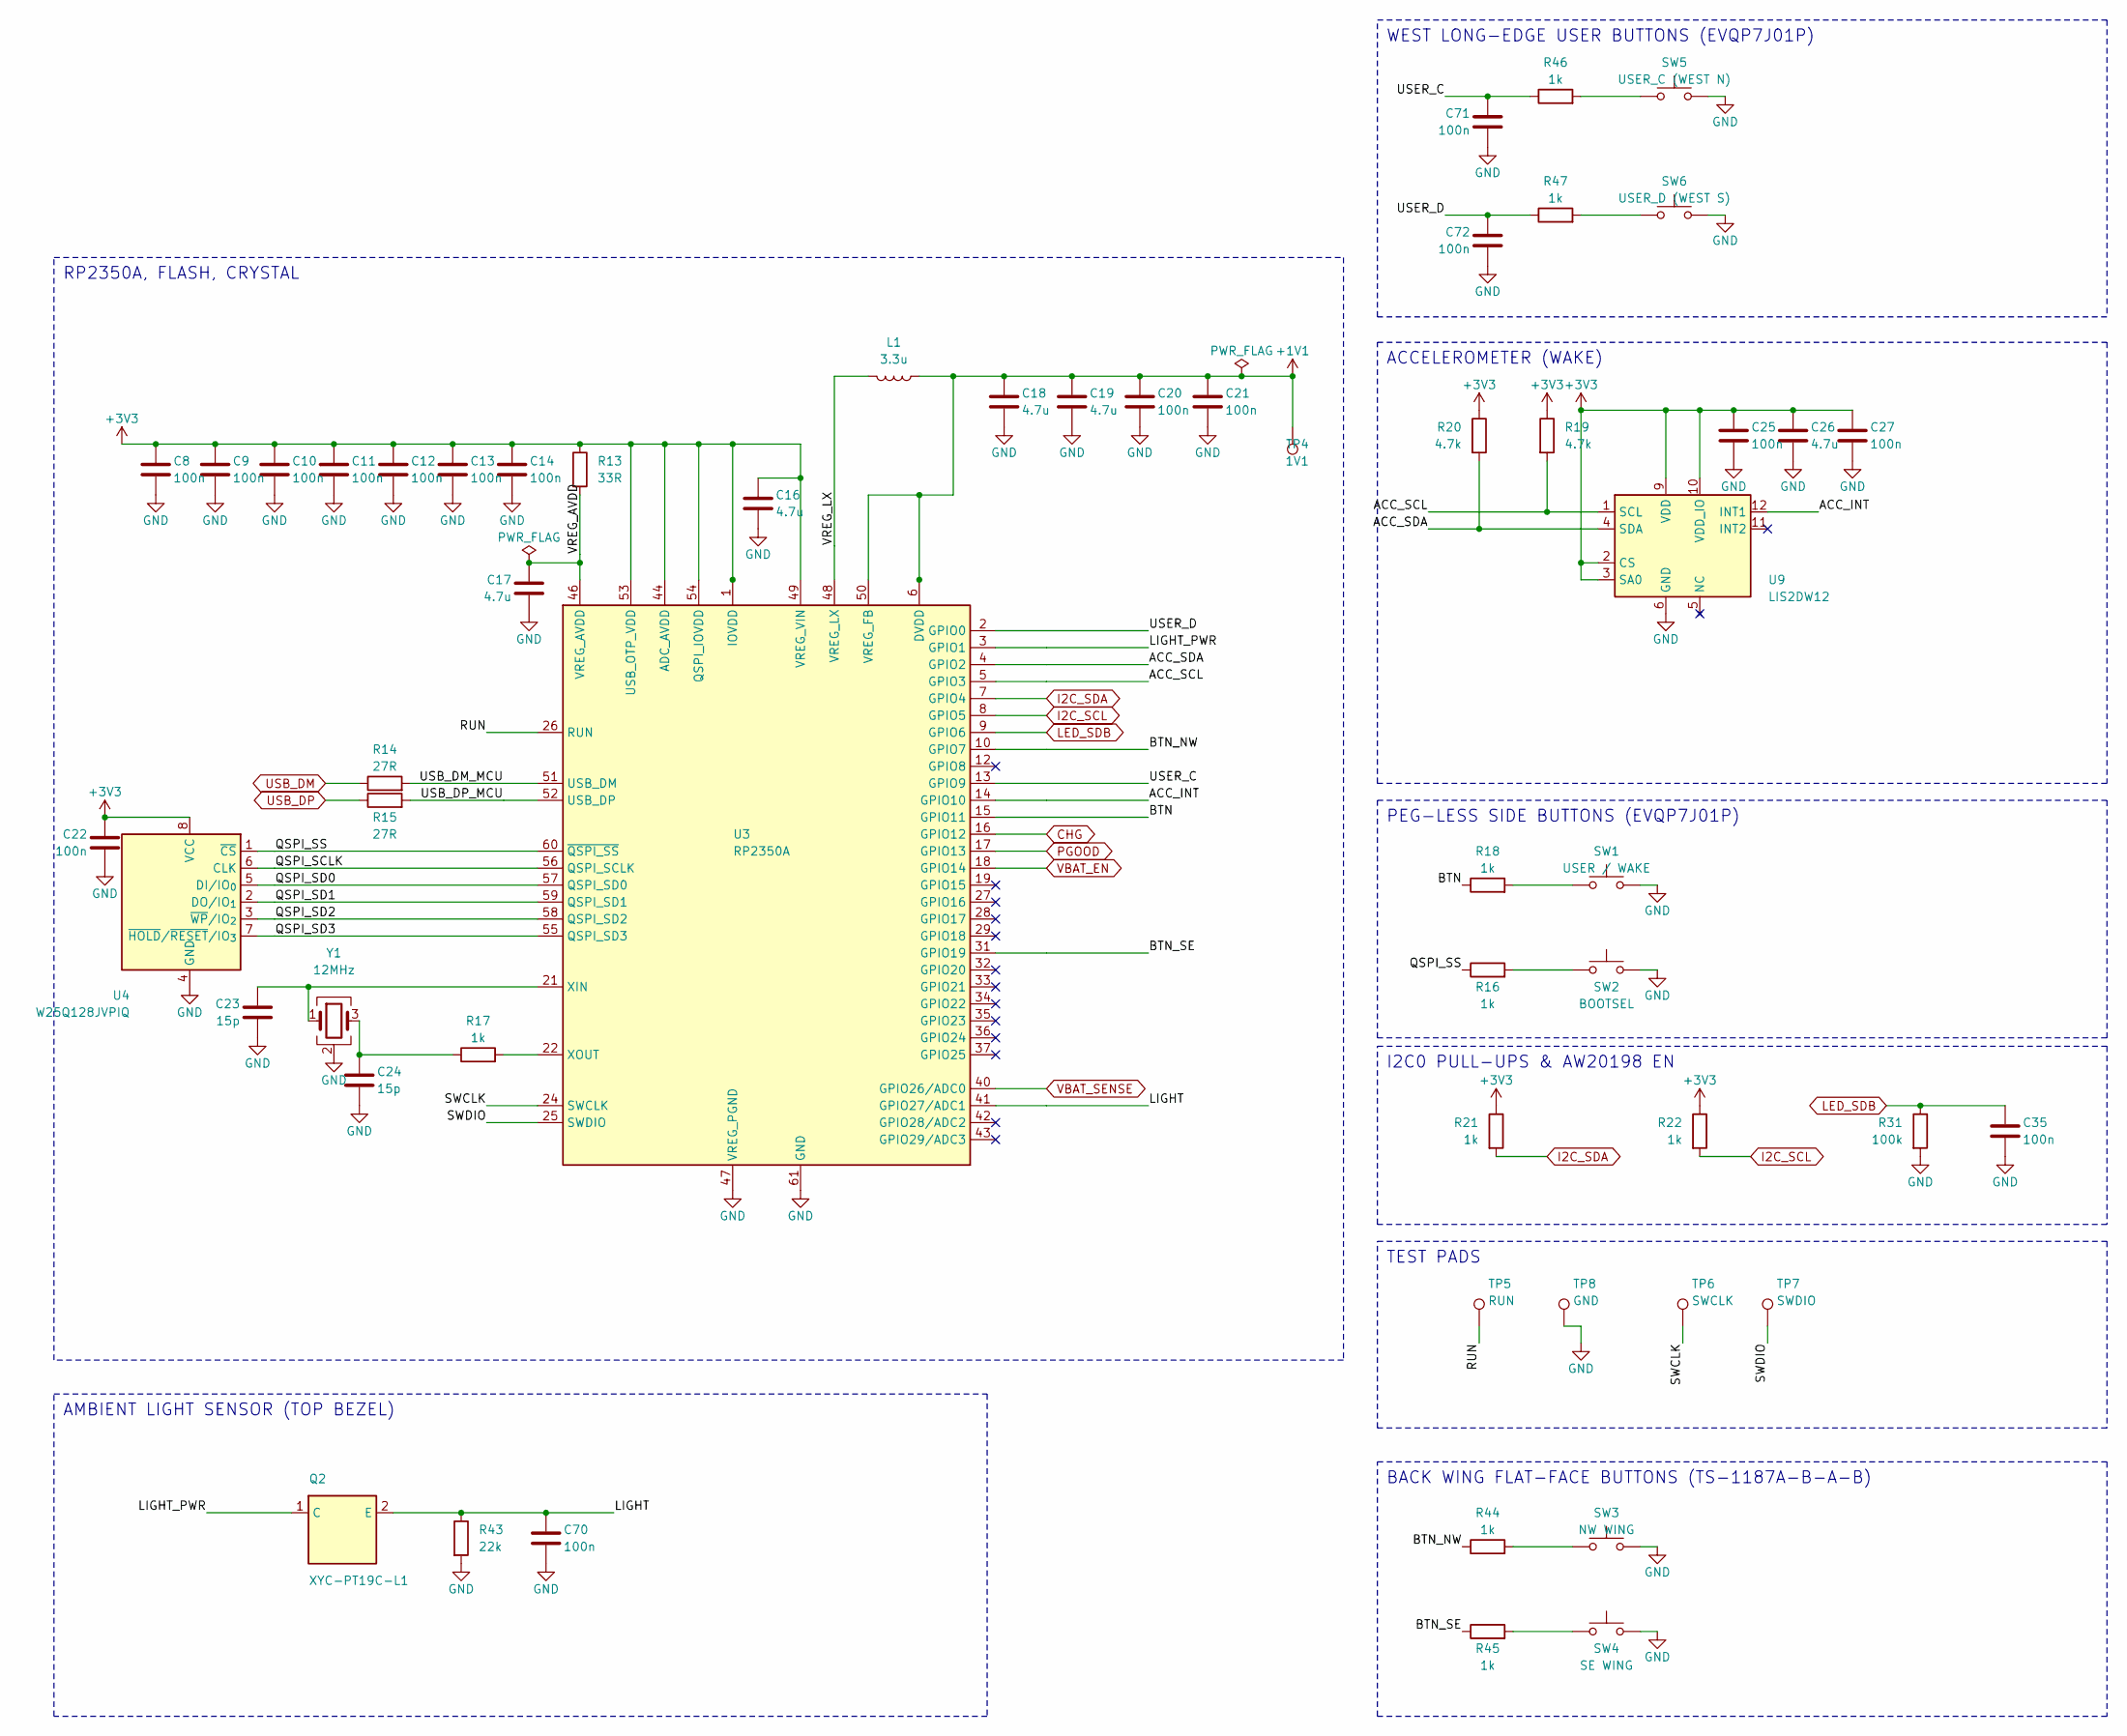
[picture p152: schematic mcu.kicad_sch, parallelogram (p2-132-usb6): mcu]

Parts:
C8, C9, C10, C11, C12, C13, C14, C20, C21, C22, C25, C27, C35, C70: 100n; C_0402_1005Metric; MPN CL05B104KO5NNNC; LCSC C1525
C16, C18: 4.7u; C_0402_1005Metric_small_pads; MPN CL05A475MP5NRNC; LCSC C23733
C17, C19, C26: 4.7u; C_0402_1005Metric; MPN CL05A475MP5NRNC; LCSC C23733
C23, C24: 15p; C_0402_1005Metric; MPN 0402CG150J500NT; LCSC C1548
C71, C72: 100n; C_0402_1005Metric; MPN CL05B104KB54PNC; LCSC C307331
L1: 3.3u; L_pol_2016; MPN AOTA-B201610S3R3-101-T; LCSC C42411119
Q2: XYC-PT19C-L1; SENSOR_ALS-PT19; MPN XYC-PT19C-L1; LCSC C2693594
R13: 33R; R_0402_1005Metric; MPN 0402WGF330JTCE; LCSC C25105
R14, R15: 27R; R_0402_1005Metric; MPN 0402WGF270JTCE; LCSC C25100
R16, R17, R18, R21, R22, R44, R45, R46, R47: 1k; R_0402_1005Metric; MPN 0402WGF1001TCE; LCSC C11702
R19, R20: 4.7k; R_0402_1005Metric; MPN 0402WGF4701TCE; LCSC C25900
R31: 100k; R_0402_1005Metric; MPN 0402WGF1003TCE; LCSC C25741
R43: 22k; R_0402_1005Metric; MPN 0402WGF2202TCE; LCSC C25768
SW1: USER / WAKE; SW_Panasonic_EVQP7J; MPN EVQP7J01P; LCSC C2828254
SW2: BOOTSEL; SW_Panasonic_EVQP7J; MPN EVQP7J01P; LCSC C2828254
SW3: NW WING; SW_Push_1P1T_XKB_TS-1187A; MPN TS-1187A-B-A-B; LCSC C318884
SW4: SE WING; SW_Push_1P1T_XKB_TS-1187A; MPN TS-1187A-B-A-B; LCSC C318884
SW5: USER_C (WEST N); SW_Panasonic_EVQP7J; MPN EVQP7J01P; LCSC C2828254
SW6: USER_D (WEST S); SW_Panasonic_EVQP7J; MPN EVQP7J01P; LCSC C2828254
TP4: 1V1; TestPoint_Pad_D1.0mm
TP5: RUN; TestPoint_Pad_D1.0mm
TP6: SWCLK; TestPoint_Pad_D1.0mm
TP7: SWDIO; TestPoint_Pad_D1.0mm
TP8: GND; TestPoint_Pad_D1.0mm
U3: RP2350A; RP2350-QFN-60-1EP_7x7_P0.4mm_EP3.4x3.4mm_ThermalVias; MPN RP2350A; LCSC C42411118
U4: W25Q128JVPIQ; WSON-8_6x5mm_P1.27mm_NoEPCopper; MPN W25Q128JVPIQ; LCSC C190862
U9: LIS2DW12; LGA-12_2x2mm_P0.5mm; MPN LIS2DW12TR; LCSC C189624
Y1: 12MHz; Crystal_SMD_3225-4Pin_3.2x2.5mm; MPN ABM8-272-T3; LCSC C20625731

Connections:
+3V3: C8.1, C9.1, C10.1, C11.1, C12.1, C13.1, C14.1, C16.1, C22.1, C25.1, C26.1, C27.1, R13.1, R19.1, R20.1, R21.1, R22.1, U3.1 (IOVDD), U3.11 (IOVDD), U3.20 (IOVDD), U3.30 (IOVDD), U3.38 (IOVDD), U3.44 (ADC_AVDD), U3.45 (IOVDD), U3.49 (VREG_VIN), U3.53 (USB_OTP_VDD), U3.54 (QSPI_IOVDD), U4.8 (VCC), U9.2 (CS), U9.3 (SA0), U9.9 (VDD), U9.10 (VDD_IO); also elsewhere on the board
/MCU/ACC_INT: U3.14 (GPIO10), U9.12 (INT1)
/MCU/ACC_SCL: R19.2, U3.5 (GPIO3), U9.1 (SCL)
/MCU/ACC_SDA: R20.2, U3.4 (GPIO2), U9.4 (SDA)
/MCU/BTN: R18.1, U3.15 (GPIO11)
/MCU/BTN_NW: R44.1, U3.10 (GPIO7)
/MCU/BTN_SE: R45.1, U3.31 (GPIO19)
/MCU/LIGHT: C70.1, Q2.2 (E), R43.1, U3.41 (GPIO27/ADC1)
/MCU/LIGHT_PWR: Q2.1 (C), U3.3 (GPIO1)
/MCU/QSPI_SCLK: U3.56 (QSPI_SCLK), U4.6 (CLK)
/MCU/QSPI_SD0: U3.57 (QSPI_SD0), U4.5 (DI/IO_{0})
/MCU/QSPI_SD1: U3.59 (QSPI_SD1), U4.2 (DO/IO_{1})
/MCU/QSPI_SD2: U3.58 (QSPI_SD2), U4.3 (~WP/IO_{2})
/MCU/QSPI_SD3: U3.55 (QSPI_SD3), U4.7 (~HOLD/~RESET/IO_{3})
/MCU/QSPI_SS: R16.1, U3.60 (~QSPI_SS), U4.1 (~CS)
/MCU/RUN: TP5.1, U3.26 (RUN)
/MCU/SWCLK: TP6.1, U3.24 (SWCLK)
/MCU/SWDIO: TP7.1, U3.25 (SWDIO)
/MCU/USB_DM_MCU: R14.2, U3.51 (USB_DM)
/MCU/USB_DP_MCU: R15.2, U3.52 (USB_DP)
/MCU/USER_C: C71.1, R46.1, U3.13 (GPIO9)
/MCU/USER_D: C72.1, R47.1, U3.2 (GPIO0)
/MCU/VREG_LX: L1.2, U3.48 (VREG_LX)
CHG: U3.16 (GPIO12); also elsewhere on the board
I2C_SCL: R22.2, U3.8 (GPIO5); also elsewhere on the board
I2C_SDA: R21.2, U3.7 (GPIO4); also elsewhere on the board
LED_SDB: C35.1, R31.1, U3.9 (GPIO6); also elsewhere on the board
unnamed: C24.1, R17.1, Y1.3
unnamed: R16.2, SW2.1
unnamed: R18.2, SW1.1
unnamed: R44.2, SW3.1
unnamed: R45.2, SW4.1
unnamed: R46.2, SW5.1
unnamed: R47.2, SW6.1
unnamed: C23.1, U3.21 (XIN), Y1.1
unnamed: R17.2, U3.22 (XOUT)
PGOOD: U3.17 (GPIO13); also elsewhere on the board
USB_DM: R14.1; also elsewhere on the board
USB_DP: R15.1; also elsewhere on the board
VBAT_EN: U3.18 (GPIO14); also elsewhere on the board
VBAT_SENSE: U3.40 (GPIO26/ADC0); also elsewhere on the board

Notes on the sheet:
RP2350A, FLASH, CRYSTAL
ACCELEROMETER (WAKE)
PEG-LESS SIDE BUTTONS (EVQP7J01P)
I2C0 PULL-UPS & AW20198 EN
TEST PADS
AMBIENT LIGHT SENSOR (TOP BEZEL)
BACK WING FLAT-FACE BUTTONS (TS-1187A-B-A-B)
WEST LONG-EDGE USER BUTTONS (EVQP7J01P)

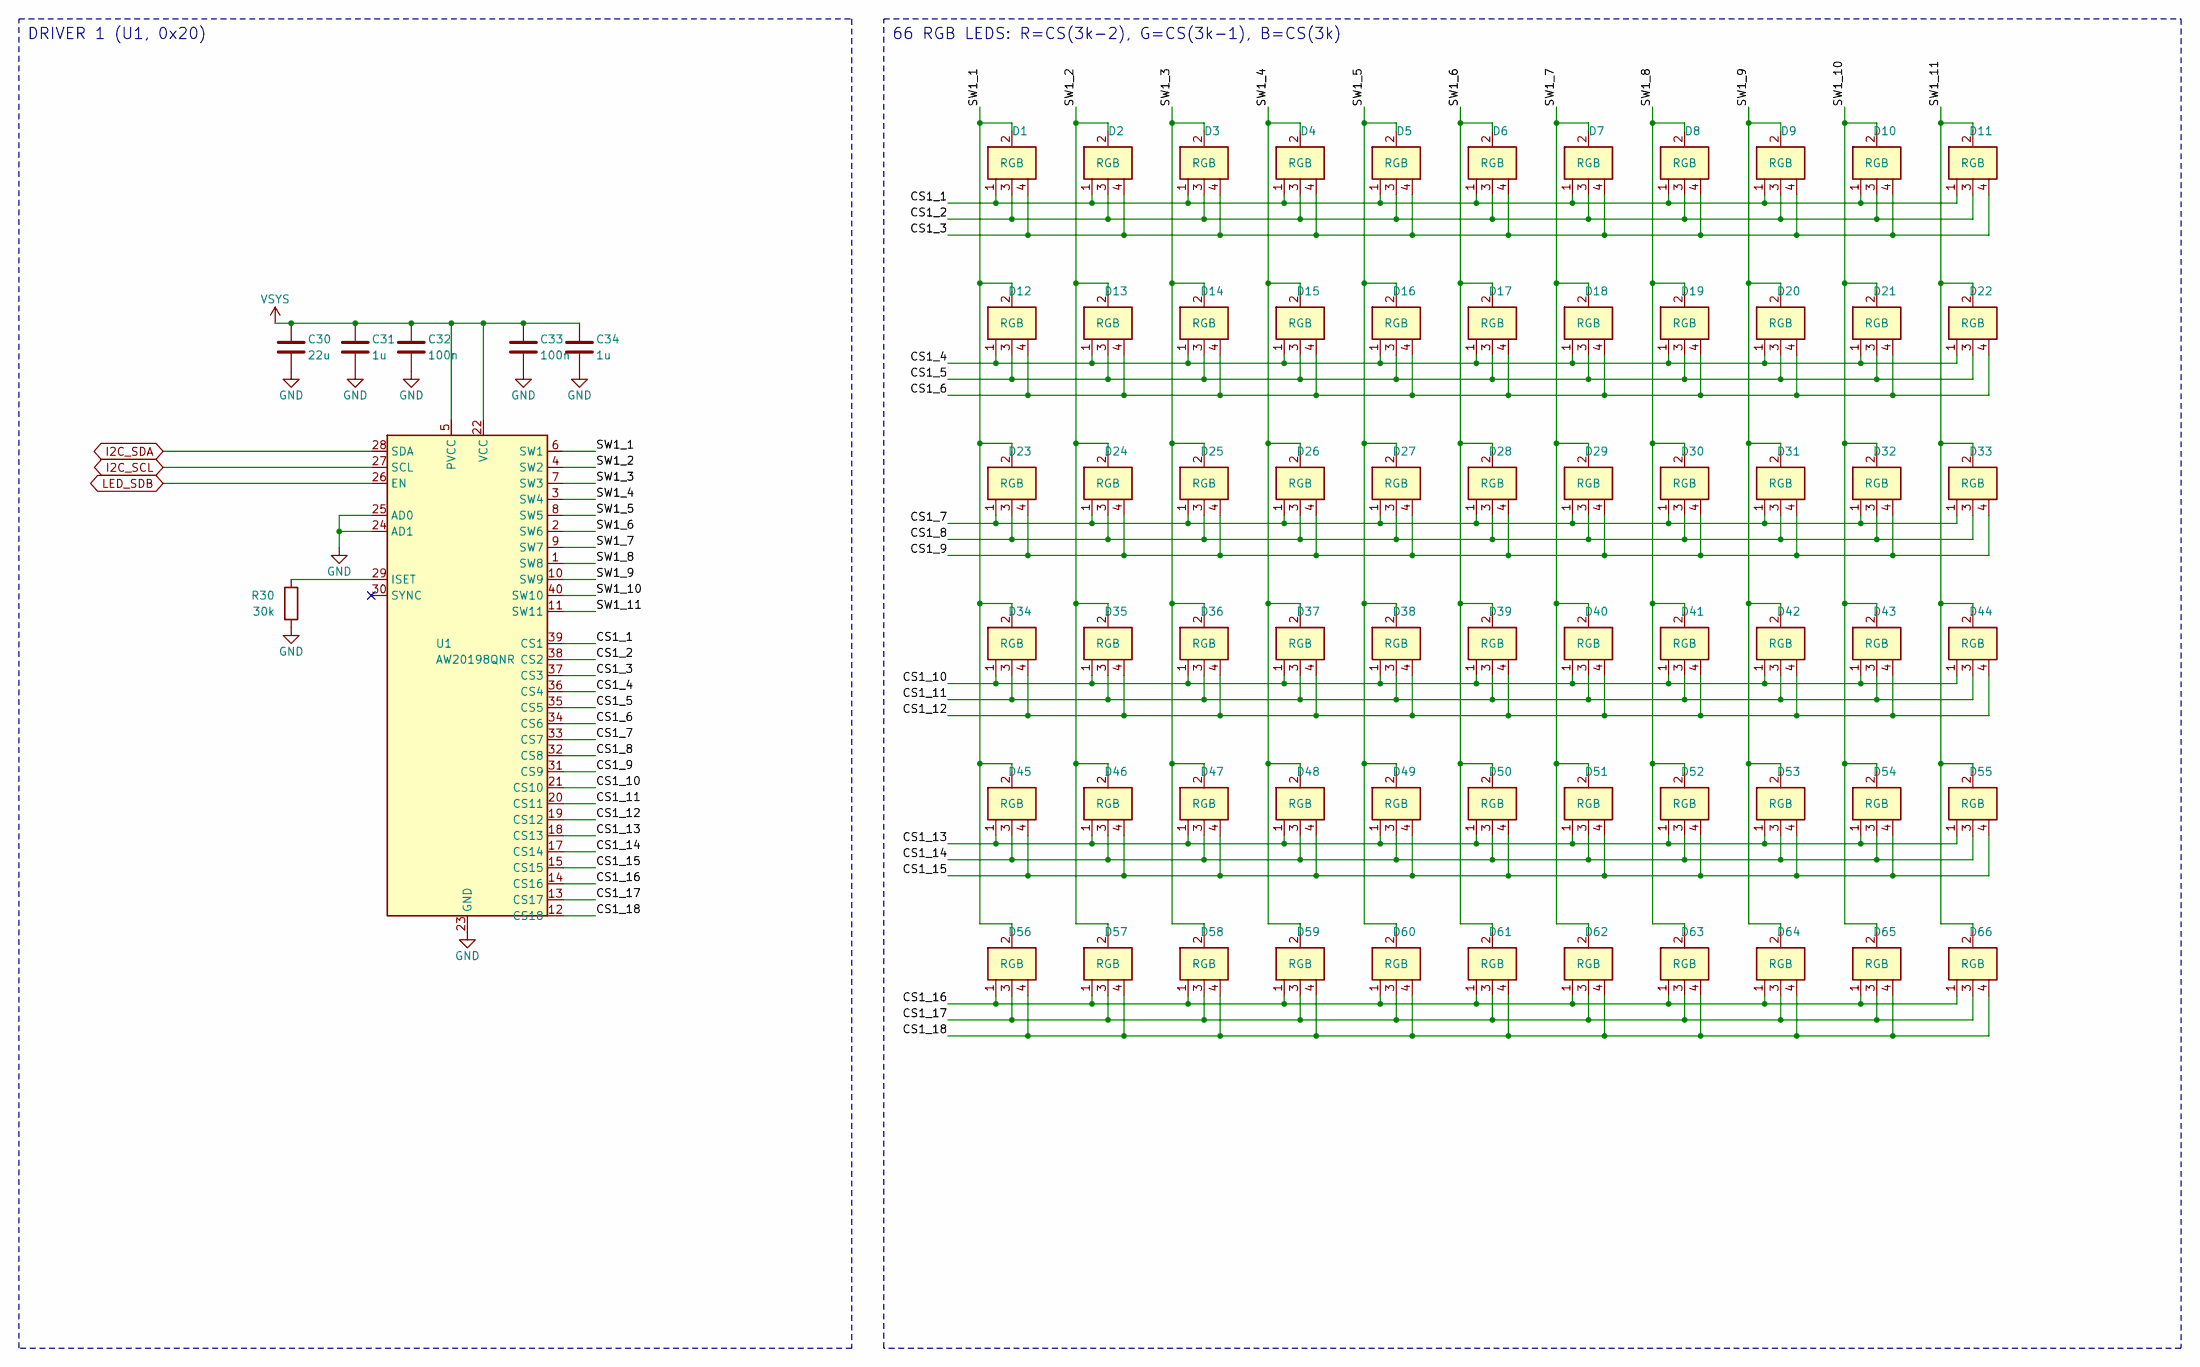
[picture p153: schematic matrix1.kicad_sch, parallelogram (p2-132-usb6): driver 1 and matrix]

Parts:
C30: 22u; C_0603_1608Metric; MPN CL10A226MP8NUNE; LCSC C86295
C31, C34: 1u; C_0402_1005Metric; MPN CL05A105KA5NQNC; LCSC C52923
C32, C33: 100n; C_0402_1005Metric; MPN CL05B104KO5NNNC; LCSC C1525
D1, D2, D3, D4, D5, D6, D7, D8, D9, D10, D11, D12, D13, D14, D15, D16, D17, D18, D19, D20, D21, D22, D23, D24, D25, D26, D27, D28, D29, D30, D31, D32, D33, D34, D35, D36, D37, D38, D39, D40, D41, D42, D43, D44, D45, D46, D47, D48, D49, D50, D51, D52, D53, D54, D55, D56, D57, D58, D59, D60, D61, D62, D63, D64, D65, D66: RGB; LED_XL-1615RGBC; MPN XL-1615RGBC-RF; LCSC C965840
R30: 30k; R_0402_1005Metric; MPN 0402WGF3002TCE; LCSC C25776
U1: AW20198QNR; AW20198_QFN-40-1EP_5x5mm_P0.4mm_EP3.4x3.4mm; MPN AW20198QNR; LCSC C5137654

Connections:
/Driver 1 and matrix/CS1_1: D1.1 (R), D2.1 (R), D3.1 (R), D4.1 (R), D5.1 (R), D6.1 (R), D7.1 (R), D8.1 (R), D9.1 (R), D10.1 (R), D11.1 (R), U1.39 (CS1)
/Driver 1 and matrix/CS1_2: D1.3 (G), D2.3 (G), D3.3 (G), D4.3 (G), D5.3 (G), D6.3 (G), D7.3 (G), D8.3 (G), D9.3 (G), D10.3 (G), D11.3 (G), U1.38 (CS2)
/Driver 1 and matrix/CS1_3: D1.4 (B), D2.4 (B), D3.4 (B), D4.4 (B), D5.4 (B), D6.4 (B), D7.4 (B), D8.4 (B), D9.4 (B), D10.4 (B), D11.4 (B), U1.37 (CS3)
/Driver 1 and matrix/CS1_4: D12.1 (R), D13.1 (R), D14.1 (R), D15.1 (R), D16.1 (R), D17.1 (R), D18.1 (R), D19.1 (R), D20.1 (R), D21.1 (R), D22.1 (R), U1.36 (CS4)
/Driver 1 and matrix/CS1_5: D12.3 (G), D13.3 (G), D14.3 (G), D15.3 (G), D16.3 (G), D17.3 (G), D18.3 (G), D19.3 (G), D20.3 (G), D21.3 (G), D22.3 (G), U1.35 (CS5)
/Driver 1 and matrix/CS1_6: D12.4 (B), D13.4 (B), D14.4 (B), D15.4 (B), D16.4 (B), D17.4 (B), D18.4 (B), D19.4 (B), D20.4 (B), D21.4 (B), D22.4 (B), U1.34 (CS6)
/Driver 1 and matrix/CS1_7: D23.1 (R), D24.1 (R), D25.1 (R), D26.1 (R), D27.1 (R), D28.1 (R), D29.1 (R), D30.1 (R), D31.1 (R), D32.1 (R), D33.1 (R), U1.33 (CS7)
/Driver 1 and matrix/CS1_8: D23.3 (G), D24.3 (G), D25.3 (G), D26.3 (G), D27.3 (G), D28.3 (G), D29.3 (G), D30.3 (G), D31.3 (G), D32.3 (G), D33.3 (G), U1.32 (CS8)
/Driver 1 and matrix/CS1_9: D23.4 (B), D24.4 (B), D25.4 (B), D26.4 (B), D27.4 (B), D28.4 (B), D29.4 (B), D30.4 (B), D31.4 (B), D32.4 (B), D33.4 (B), U1.31 (CS9)
/Driver 1 and matrix/CS1_10: D34.1 (R), D35.1 (R), D36.1 (R), D37.1 (R), D38.1 (R), D39.1 (R), D40.1 (R), D41.1 (R), D42.1 (R), D43.1 (R), D44.1 (R), U1.21 (CS10)
/Driver 1 and matrix/CS1_11: D34.3 (G), D35.3 (G), D36.3 (G), D37.3 (G), D38.3 (G), D39.3 (G), D40.3 (G), D41.3 (G), D42.3 (G), D43.3 (G), D44.3 (G), U1.20 (CS11)
/Driver 1 and matrix/CS1_12: D34.4 (B), D35.4 (B), D36.4 (B), D37.4 (B), D38.4 (B), D39.4 (B), D40.4 (B), D41.4 (B), D42.4 (B), D43.4 (B), D44.4 (B), U1.19 (CS12)
/Driver 1 and matrix/CS1_13: D45.1 (R), D46.1 (R), D47.1 (R), D48.1 (R), D49.1 (R), D50.1 (R), D51.1 (R), D52.1 (R), D53.1 (R), D54.1 (R), D55.1 (R), U1.18 (CS13)
/Driver 1 and matrix/CS1_14: D45.3 (G), D46.3 (G), D47.3 (G), D48.3 (G), D49.3 (G), D50.3 (G), D51.3 (G), D52.3 (G), D53.3 (G), D54.3 (G), D55.3 (G), U1.17 (CS14)
/Driver 1 and matrix/CS1_15: D45.4 (B), D46.4 (B), D47.4 (B), D48.4 (B), D49.4 (B), D50.4 (B), D51.4 (B), D52.4 (B), D53.4 (B), D54.4 (B), D55.4 (B), U1.15 (CS15)
/Driver 1 and matrix/CS1_16: D56.1 (R), D57.1 (R), D58.1 (R), D59.1 (R), D60.1 (R), D61.1 (R), D62.1 (R), D63.1 (R), D64.1 (R), D65.1 (R), D66.1 (R), U1.14 (CS16)
/Driver 1 and matrix/CS1_17: D56.3 (G), D57.3 (G), D58.3 (G), D59.3 (G), D60.3 (G), D61.3 (G), D62.3 (G), D63.3 (G), D64.3 (G), D65.3 (G), D66.3 (G), U1.13 (CS17)
/Driver 1 and matrix/CS1_18: D56.4 (B), D57.4 (B), D58.4 (B), D59.4 (B), D60.4 (B), D61.4 (B), D62.4 (B), D63.4 (B), D64.4 (B), D65.4 (B), D66.4 (B), U1.12 (CS18)
/Driver 1 and matrix/SW1_1: D1.2 (A), D12.2 (A), D23.2 (A), D34.2 (A), D45.2 (A), D56.2 (A), U1.6 (SW1)
/Driver 1 and matrix/SW1_2: D2.2 (A), D13.2 (A), D24.2 (A), D35.2 (A), D46.2 (A), D57.2 (A), U1.4 (SW2)
/Driver 1 and matrix/SW1_3: D3.2 (A), D14.2 (A), D25.2 (A), D36.2 (A), D47.2 (A), D58.2 (A), U1.7 (SW3)
/Driver 1 and matrix/SW1_4: D4.2 (A), D15.2 (A), D26.2 (A), D37.2 (A), D48.2 (A), D59.2 (A), U1.3 (SW4)
/Driver 1 and matrix/SW1_5: D5.2 (A), D16.2 (A), D27.2 (A), D38.2 (A), D49.2 (A), D60.2 (A), U1.8 (SW5)
/Driver 1 and matrix/SW1_6: D6.2 (A), D17.2 (A), D28.2 (A), D39.2 (A), D50.2 (A), D61.2 (A), U1.2 (SW6)
/Driver 1 and matrix/SW1_7: D7.2 (A), D18.2 (A), D29.2 (A), D40.2 (A), D51.2 (A), D62.2 (A), U1.9 (SW7)
/Driver 1 and matrix/SW1_8: D8.2 (A), D19.2 (A), D30.2 (A), D41.2 (A), D52.2 (A), D63.2 (A), U1.1 (SW8)
/Driver 1 and matrix/SW1_9: D9.2 (A), D20.2 (A), D31.2 (A), D42.2 (A), D53.2 (A), D64.2 (A), U1.10 (SW9)
/Driver 1 and matrix/SW1_10: D10.2 (A), D21.2 (A), D32.2 (A), D43.2 (A), D54.2 (A), D65.2 (A), U1.40 (SW10)
/Driver 1 and matrix/SW1_11: D11.2 (A), D22.2 (A), D33.2 (A), D44.2 (A), D55.2 (A), D66.2 (A), U1.11 (SW11)
I2C_SCL: U1.27 (SCL); also elsewhere on the board
I2C_SDA: U1.28 (SDA); also elsewhere on the board
LED_SDB: U1.26 (EN); also elsewhere on the board
unnamed: R30.1, U1.29 (ISET)
VSYS: C30.1, C31.1, C32.1, C33.1, C34.1, U1.5 (PVCC), U1.22 (VCC); also elsewhere on the board

Notes on the sheet:
DRIVER 1 (U1, 0x20)
66 RGB LEDS: R=CS(3k-2), G=CS(3k-1), B=CS(3k)
