sequoia-hope/matrix-play/hw/parallelogram/p2-132-usb6/parallelogram.kicad_pcb

## KiCad design hw/parallelogram/p2-132-usb6/parallelogram.kicad_pcb (continued)

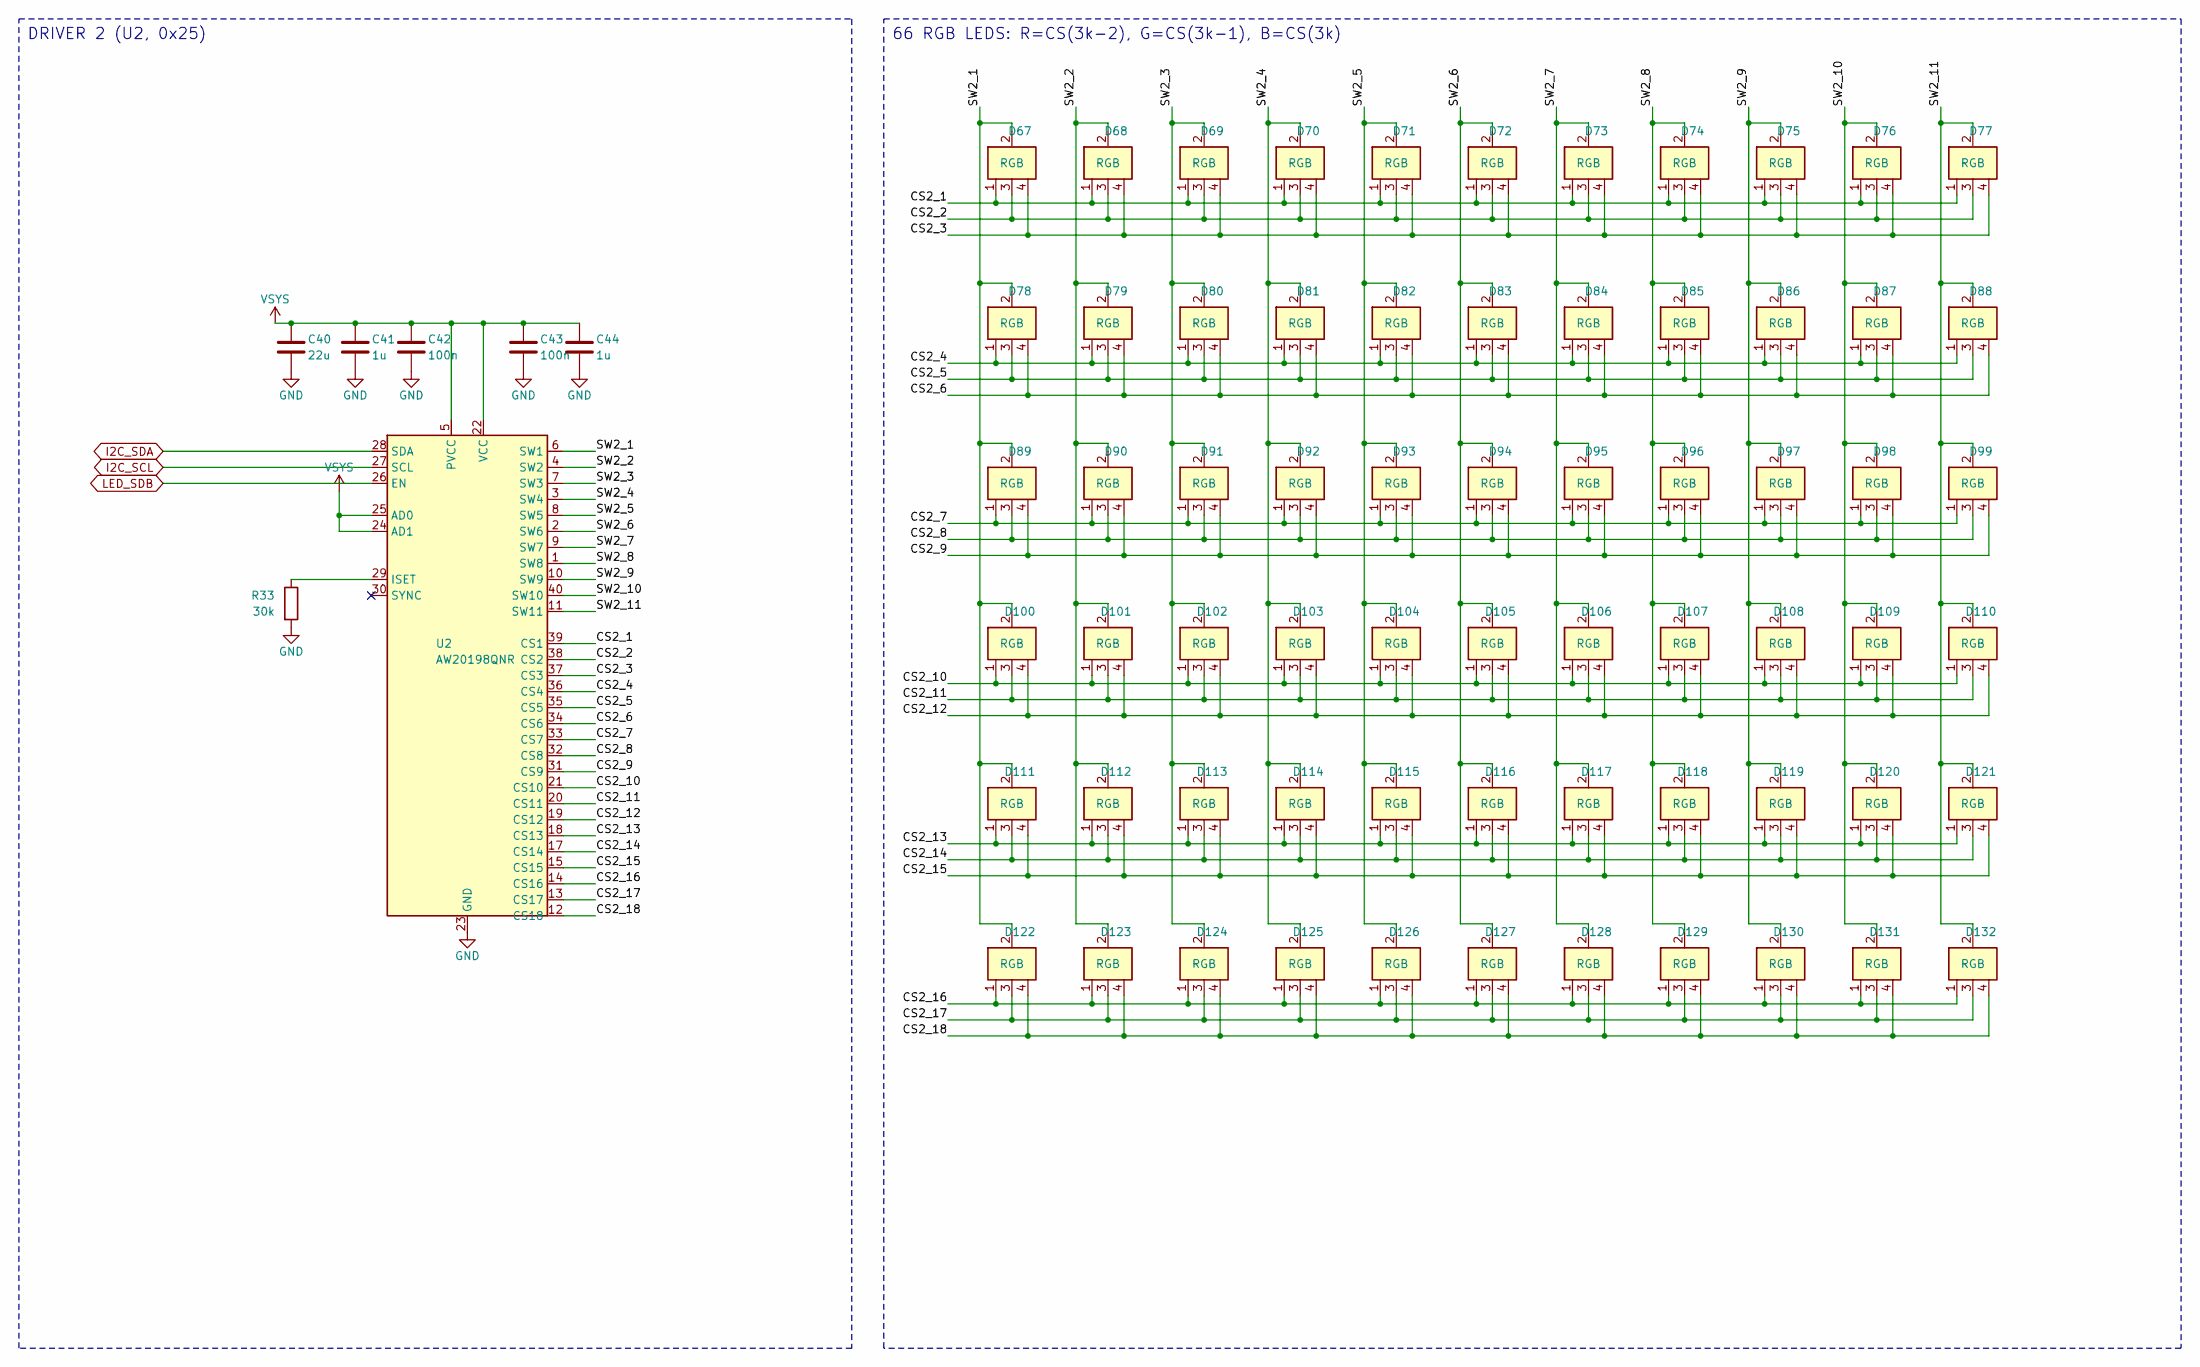
[picture p154: schematic matrix2.kicad_sch, parallelogram (p2-132-usb6): driver 2 and matrix]

Parts:
C40: 22u; C_0603_1608Metric; MPN CL10A226MP8NUNE; LCSC C86295
C41, C44: 1u; C_0402_1005Metric; MPN CL05A105KA5NQNC; LCSC C52923
C42, C43: 100n; C_0402_1005Metric; MPN CL05B104KO5NNNC; LCSC C1525
D67, D68, D69, D70, D71, D72, D73, D74, D75, D76, D77, D78, D79, D80, D81, D82, D83, D84, D85, D86, D87, D88, D89, D90, D91, D92, D93, D94, D95, D96, D97, D98, D99, D100, D101, D102, D103, D104, D105, D106, D107, D108, D109, D110, D111, D112, D113, D114, D115, D116, D117, D118, D119, D120, D121, D122, D123, D124, D125, D126, D127, D128, D129, D130, D131, D132: RGB; LED_XL-1615RGBC; MPN XL-1615RGBC-RF; LCSC C965840
R33: 30k; R_0402_1005Metric; MPN 0402WGF3002TCE; LCSC C25776
U2: AW20198QNR; AW20198_QFN-40-1EP_5x5mm_P0.4mm_EP3.4x3.4mm; MPN AW20198QNR; LCSC C5137654

Connections:
/Driver 2 and matrix/CS2_1: D67.1 (R), D68.1 (R), D69.1 (R), D70.1 (R), D71.1 (R), D72.1 (R), D73.1 (R), D74.1 (R), D75.1 (R), D76.1 (R), D77.1 (R), U2.39 (CS1)
/Driver 2 and matrix/CS2_2: D67.3 (G), D68.3 (G), D69.3 (G), D70.3 (G), D71.3 (G), D72.3 (G), D73.3 (G), D74.3 (G), D75.3 (G), D76.3 (G), D77.3 (G), U2.38 (CS2)
/Driver 2 and matrix/CS2_3: D67.4 (B), D68.4 (B), D69.4 (B), D70.4 (B), D71.4 (B), D72.4 (B), D73.4 (B), D74.4 (B), D75.4 (B), D76.4 (B), D77.4 (B), U2.37 (CS3)
/Driver 2 and matrix/CS2_4: D78.1 (R), D79.1 (R), D80.1 (R), D81.1 (R), D82.1 (R), D83.1 (R), D84.1 (R), D85.1 (R), D86.1 (R), D87.1 (R), D88.1 (R), U2.36 (CS4)
/Driver 2 and matrix/CS2_5: D78.3 (G), D79.3 (G), D80.3 (G), D81.3 (G), D82.3 (G), D83.3 (G), D84.3 (G), D85.3 (G), D86.3 (G), D87.3 (G), D88.3 (G), U2.35 (CS5)
/Driver 2 and matrix/CS2_6: D78.4 (B), D79.4 (B), D80.4 (B), D81.4 (B), D82.4 (B), D83.4 (B), D84.4 (B), D85.4 (B), D86.4 (B), D87.4 (B), D88.4 (B), U2.34 (CS6)
/Driver 2 and matrix/CS2_7: D89.1 (R), D90.1 (R), D91.1 (R), D92.1 (R), D93.1 (R), D94.1 (R), D95.1 (R), D96.1 (R), D97.1 (R), D98.1 (R), D99.1 (R), U2.33 (CS7)
/Driver 2 and matrix/CS2_8: D89.3 (G), D90.3 (G), D91.3 (G), D92.3 (G), D93.3 (G), D94.3 (G), D95.3 (G), D96.3 (G), D97.3 (G), D98.3 (G), D99.3 (G), U2.32 (CS8)
/Driver 2 and matrix/CS2_9: D89.4 (B), D90.4 (B), D91.4 (B), D92.4 (B), D93.4 (B), D94.4 (B), D95.4 (B), D96.4 (B), D97.4 (B), D98.4 (B), D99.4 (B), U2.31 (CS9)
/Driver 2 and matrix/CS2_10: D100.1 (R), D101.1 (R), D102.1 (R), D103.1 (R), D104.1 (R), D105.1 (R), D106.1 (R), D107.1 (R), D108.1 (R), D109.1 (R), D110.1 (R), U2.21 (CS10)
/Driver 2 and matrix/CS2_11: D100.3 (G), D101.3 (G), D102.3 (G), D103.3 (G), D104.3 (G), D105.3 (G), D106.3 (G), D107.3 (G), D108.3 (G), D109.3 (G), D110.3 (G), U2.20 (CS11)
/Driver 2 and matrix/CS2_12: D100.4 (B), D101.4 (B), D102.4 (B), D103.4 (B), D104.4 (B), D105.4 (B), D106.4 (B), D107.4 (B), D108.4 (B), D109.4 (B), D110.4 (B), U2.19 (CS12)
/Driver 2 and matrix/CS2_13: D111.1 (R), D112.1 (R), D113.1 (R), D114.1 (R), D115.1 (R), D116.1 (R), D117.1 (R), D118.1 (R), D119.1 (R), D120.1 (R), D121.1 (R), U2.18 (CS13)
/Driver 2 and matrix/CS2_14: D111.3 (G), D112.3 (G), D113.3 (G), D114.3 (G), D115.3 (G), D116.3 (G), D117.3 (G), D118.3 (G), D119.3 (G), D120.3 (G), D121.3 (G), U2.17 (CS14)
/Driver 2 and matrix/CS2_15: D111.4 (B), D112.4 (B), D113.4 (B), D114.4 (B), D115.4 (B), D116.4 (B), D117.4 (B), D118.4 (B), D119.4 (B), D120.4 (B), D121.4 (B), U2.15 (CS15)
/Driver 2 and matrix/CS2_16: D122.1 (R), D123.1 (R), D124.1 (R), D125.1 (R), D126.1 (R), D127.1 (R), D128.1 (R), D129.1 (R), D130.1 (R), D131.1 (R), D132.1 (R), U2.14 (CS16)
/Driver 2 and matrix/CS2_17: D122.3 (G), D123.3 (G), D124.3 (G), D125.3 (G), D126.3 (G), D127.3 (G), D128.3 (G), D129.3 (G), D130.3 (G), D131.3 (G), D132.3 (G), U2.13 (CS17)
/Driver 2 and matrix/CS2_18: D122.4 (B), D123.4 (B), D124.4 (B), D125.4 (B), D126.4 (B), D127.4 (B), D128.4 (B), D129.4 (B), D130.4 (B), D131.4 (B), D132.4 (B), U2.12 (CS18)
/Driver 2 and matrix/SW2_1: D67.2 (A), D78.2 (A), D89.2 (A), D100.2 (A), D111.2 (A), D122.2 (A), U2.6 (SW1)
/Driver 2 and matrix/SW2_2: D68.2 (A), D79.2 (A), D90.2 (A), D101.2 (A), D112.2 (A), D123.2 (A), U2.4 (SW2)
/Driver 2 and matrix/SW2_3: D69.2 (A), D80.2 (A), D91.2 (A), D102.2 (A), D113.2 (A), D124.2 (A), U2.7 (SW3)
/Driver 2 and matrix/SW2_4: D70.2 (A), D81.2 (A), D92.2 (A), D103.2 (A), D114.2 (A), D125.2 (A), U2.3 (SW4)
/Driver 2 and matrix/SW2_5: D71.2 (A), D82.2 (A), D93.2 (A), D104.2 (A), D115.2 (A), D126.2 (A), U2.8 (SW5)
/Driver 2 and matrix/SW2_6: D72.2 (A), D83.2 (A), D94.2 (A), D105.2 (A), D116.2 (A), D127.2 (A), U2.2 (SW6)
/Driver 2 and matrix/SW2_7: D73.2 (A), D84.2 (A), D95.2 (A), D106.2 (A), D117.2 (A), D128.2 (A), U2.9 (SW7)
/Driver 2 and matrix/SW2_8: D74.2 (A), D85.2 (A), D96.2 (A), D107.2 (A), D118.2 (A), D129.2 (A), U2.1 (SW8)
/Driver 2 and matrix/SW2_9: D75.2 (A), D86.2 (A), D97.2 (A), D108.2 (A), D119.2 (A), D130.2 (A), U2.10 (SW9)
/Driver 2 and matrix/SW2_10: D76.2 (A), D87.2 (A), D98.2 (A), D109.2 (A), D120.2 (A), D131.2 (A), U2.40 (SW10)
/Driver 2 and matrix/SW2_11: D77.2 (A), D88.2 (A), D99.2 (A), D110.2 (A), D121.2 (A), D132.2 (A), U2.11 (SW11)
I2C_SCL: U2.27 (SCL); also elsewhere on the board
I2C_SDA: U2.28 (SDA); also elsewhere on the board
LED_SDB: U2.26 (EN); also elsewhere on the board
unnamed: R33.1, U2.29 (ISET)
VSYS: C40.1, C41.1, C42.1, C43.1, C44.1, U2.5 (PVCC), U2.22 (VCC), U2.24 (AD1), U2.25 (AD0); also elsewhere on the board

Notes on the sheet:
DRIVER 2 (U2, 0x25)
66 RGB LEDS: R=CS(3k-2), G=CS(3k-1), B=CS(3k)

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
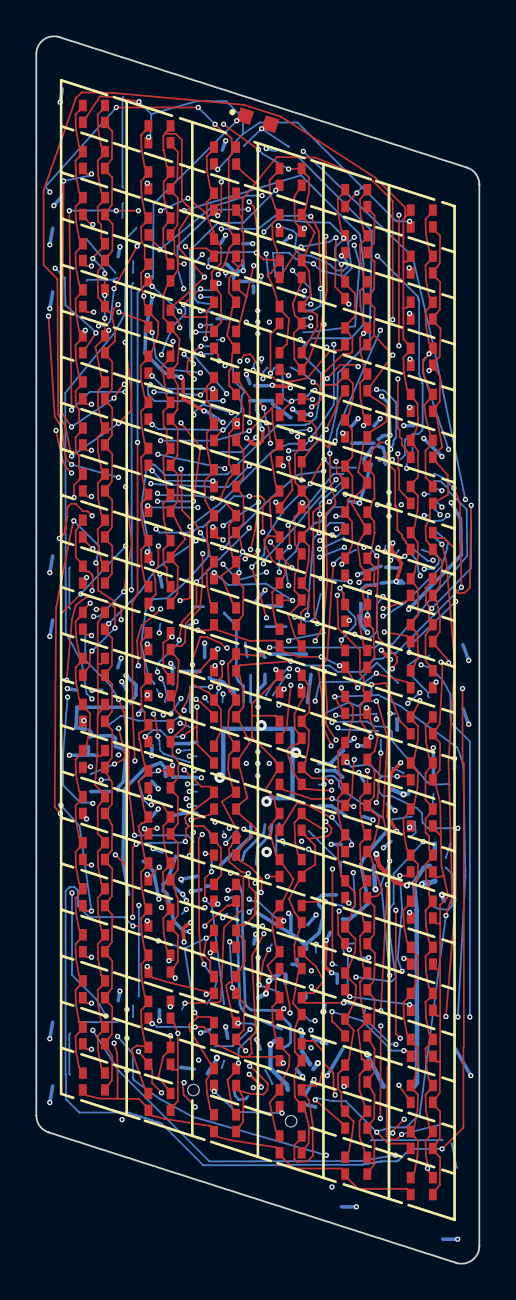
[picture p155: board hw/parallelogram/p2-132-usb6/parallelogram.kicad_pcb from above]

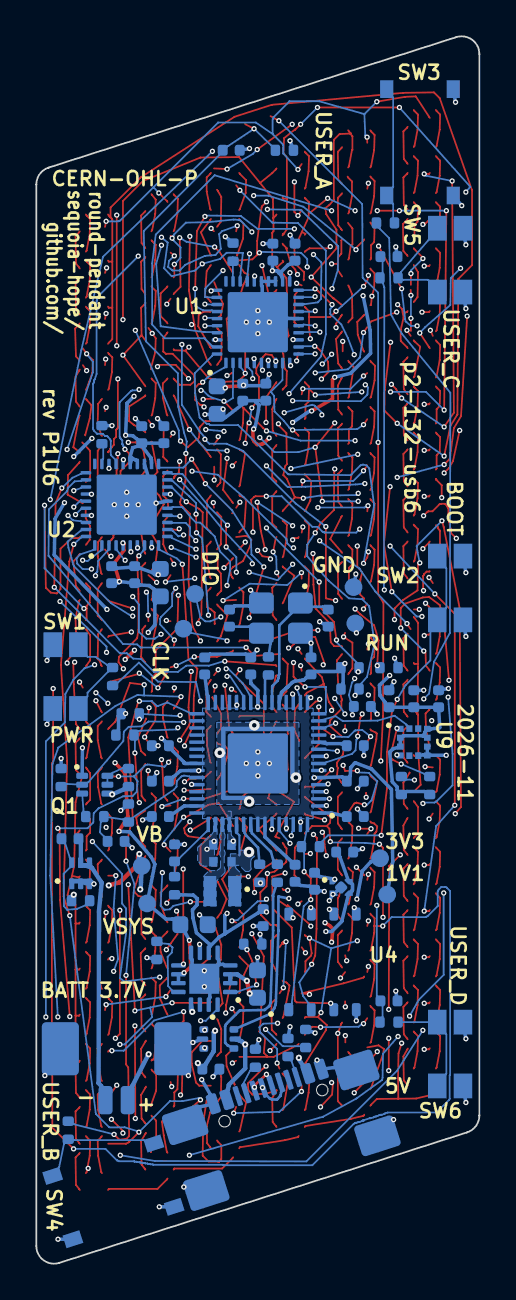
[picture p156: board hw/parallelogram/p2-132-usb6/parallelogram.kicad_pcb from below]

Board: 4 copper layers, 25.0 x 69.3 mm, 231 parts (98 on the bottom side), 118 nets.
