sequoia-hope/matrix-play/hw/round-pendant/f-usbc-rtc/round-pendant.kicad_pcb

## KiCad design hw/round-pendant/f-usbc-rtc/round-pendant.kicad_pcb (2026-11-10)

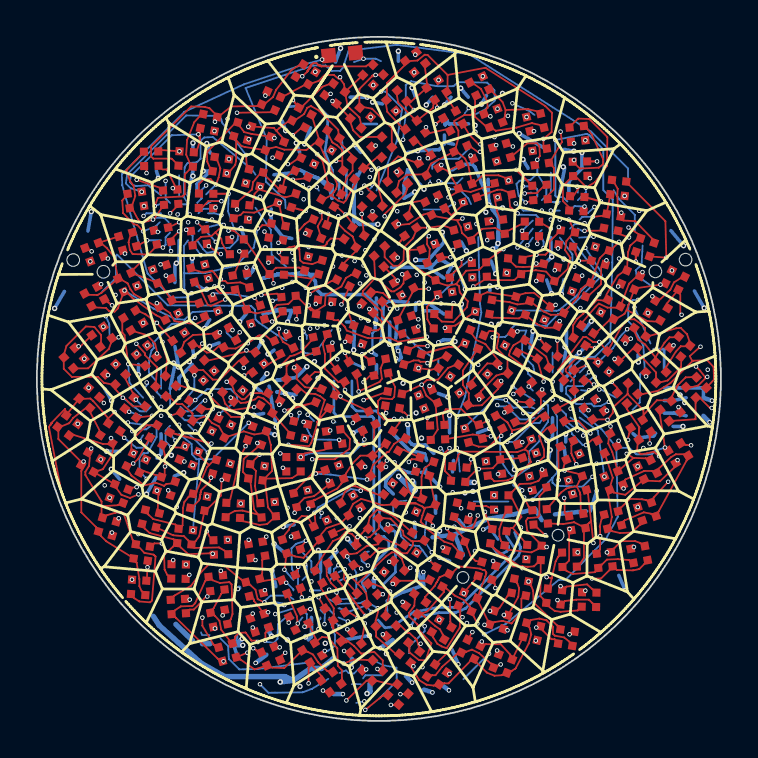
[picture p157: board round-pendant.kicad_pcb from above]

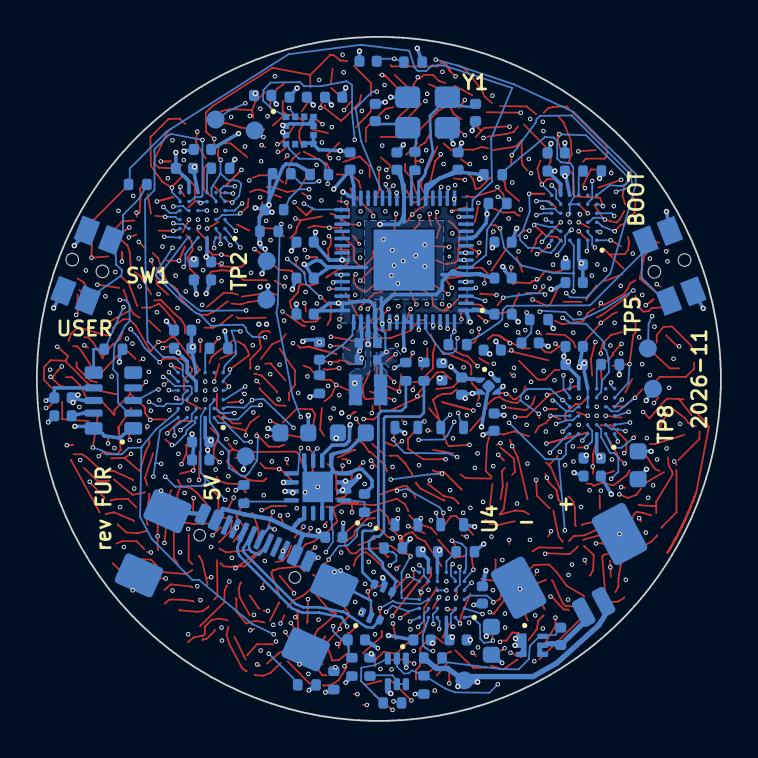
[picture p158: board round-pendant.kicad_pcb from below]

Board: 8 copper layers, 38.0 x 38.0 mm, 346 parts (110 on the bottom side), 187 nets.

Parts:
BT1: A1251WR-S-2P; Molex_PicoBlade_53261-0271_1x02-1MP_P1.25mm_Horizontal
C1, C3, C4, C31, C34, C41, C44, C51, C54, C61, C64, C71, C74, C76: 1u; C_0402_1005Metric
C2, C30, C40: 22u; C_0603_1608Metric
C5: 10u; C_0603_1608Metric
C6, C7, C8, C9, C10, C11, C12, C13, C14, C20, C21, C22, C25, C27, C32, C33, C35, C42, C43, C52, C53, C62, C63, C70, C72, C73, C75: 100n; C_0402_1005Metric
C16, C18: 4.7u; C_0402_1005Metric_small_pads
C17, C19, C26: 4.7u; C_0402_1005Metric
C23, C24: 15p; C_0402_1005Metric
D1, D2, D3, D4, D5, D6, D7, D8, D9, D10, D11, D12, D13, D14, D15, D16, D17, D18, D19, D20, D21, D22, D23, D24, D25, D26, D27, D28, D29, D30, D31, D32, D33, D34, D35, D36, D37, D38, D39, D40, D41, D42, D43, D44, D45, D46, D47, D48, D49, D50, D51, D52, D53, D54, D55, D56, D57, D58, D59, D60, D61, D62, D63, D64, D65, D66, D67, D68, D69, D70, D71, D72, D73, D74, D75, D76, D77, D78, D79, D80, D81, D82, D83, D84, D85, D86, D87, D88, D89, D90, D91, D92, D93, D94, D95, D96, D97, D98, D99, D100, D101, D102, D103, D104, D105, D106, D107, D108, D109, D110, D111, D112, D113, D114, D115, D116, D117, D118, D119, D120, D121, D122, D123, D124, D125, D126, D127, D128, D129, D130, D131, D132, D133, D134, D135, D136, D137, D138, D139, D140, D141, D142, D143, D144, D145, D146, D147, D148, D149, D150, D151, D152, D153, D154, D155, D156, D157, D158, D159, D160, D161, D162, D163, D164, D165, D166, D167, D168, D169, D170, D171, D172, D173, D174, D175, D176, D177, D178, D179, D180, D181, D182, D183, D184, D185, D186, D187, D188, D189, D190, D191, D192, D193, D194, D195, D196, D197, D198, D199, D200, D201, D202, D203, D204, D205, D206, D207, D208, D209, D210, D211, D212, D213, D214, D215, D216, D217, D218, D219, D220, D221, D222, D223, D224, D225, D226, D227, D228, D229, D230, D231, D232, D233, D234, D235: RGB; LED_XL-1010RGB
J1: TYPE-C-31-M-22; USB_C_Receptacle_Hroparts_TYPE-C-31-M-22
L1: 3.3u; L_pol_2016
Q1: NTZD3155C; SOT-563
Q2: ALS-PT19; SENSOR_ALS-PT19
R1, R2: 5.1k; R_0402_1005Metric
R3: 10k; R_0402_1005Metric
R4: 3k; R_0402_1005Metric
R5: 3.6k; R_0402_1005Metric
R6, R7, R9, R10, R11, R12, R31, R32: 100k; R_0402_1005Metric
R8: 100R; R_0402_1005Metric
R13: 33R; R_0402_1005Metric
R14, R15: 27R; R_0402_1005Metric
R16, R17, R18, R21, R22: 1k; R_0402_1005Metric
R19, R20: 4.7k; R_0402_1005Metric
R30, R33, R50, R60, R70: 30k; R_0402_1005Metric
R43: 22k; R_0402_1005Metric
SW1: USER / WAKE; SW_Panasonic_EVQP7C
SW2: BOOTSEL; SW_Panasonic_EVQP7C
TP1: VSYS; TestPoint_Pad_D1.0mm
TP2: +3V3; TestPoint_Pad_D1.0mm
TP3: VBAT; TestPoint_Pad_D1.0mm
TP4: 1V1; TestPoint_Pad_D1.0mm
TP5: RUN; TestPoint_Pad_D1.0mm
TP6: SWCLK; TestPoint_Pad_D1.0mm
TP7: SWDIO; TestPoint_Pad_D1.0mm
TP8: GND; TestPoint_Pad_D1.0mm
U1, U2, U10, U11, U12: IS31FL3745; WLCSP-36_2.9x2.9mm_P0.5mm
U3: RP2350A; RP2350-QFN-60-1EP_7x7_P0.4mm_EP3.4x3.4mm_ThermalVias
U4: W25Q128JVPIQ; WSON-8_6x5mm_P1.27mm_NoEPCopper
U5: BQ24073; QFN-16-1EP_3x3mm_P0.5mm_EP1.7x1.7mm
U6: TPS7A0233; Texas_X2SON-4_1x1mm_P0.65mm
U7: USBLC6-2P6; SOT-666
U8: XB9901A; XySemi_DFN-6_1.8x1.4mm
U9: LIS2DW12; LGA-12_2x2mm_P0.5mm
U13: RX8130CE; Seiko_Epson_RX8130CE_3.2x2.5mm_P0.7mm
Y1: 12MHz; Crystal_SMD_3225-4Pin_3.2x2.5mm

Connections:
+1V1: C18.1, C19.1, C20.1, C21.1, L1.1, TP4.1, U3.6, U3.23, U3.39, U3.50
+3V3: C4.1, C8.1, C9.1, C10.1, C11.1, C12.1, C13.1, C14.1, C16.1, C22.1, C25.1, C26.1, C27.1, C75.1, R6.1, R7.1, R13.1, R19.1, R20.1, R21.1, R22.1, R32.1, TP2.1, U3.1, U3.11, U3.20, U3.30, U3.38, U3.44, U3.45, U3.49, U3.53, U3.54, U4.8, U5.6, U6.1, U9.2, U9.3, U9.9, U9.10, U13.1, U13.8, U13.10
/Driver 1 and matrix/CS1_1: D1.4, D2.4, D3.4, D4.4, D5.4, D6.4, D7.4, D8.4, U1.B2
/Driver 1 and matrix/CS1_2: D1.2, D2.2, D3.2, D4.2, D5.2, D6.2, D7.2, D8.2, U1.B3
/Driver 1 and matrix/CS1_3: D1.1, D2.1, D3.1, D4.1, D5.1, D6.1, D7.1, D8.1, U1.C3
/Driver 1 and matrix/CS1_4: D9.4, D10.4, D11.4, D12.4, D13.4, D14.4, D15.4, D16.4, U1.C2
/Driver 1 and matrix/CS1_5: D9.2, D10.2, D11.2, D12.2, D13.2, D14.2, D15.2, D16.2, U1.D2
/Driver 1 and matrix/CS1_6: D9.1, D10.1, D11.1, D12.1, D13.1, D14.1, D15.1, D16.1, U1.D1
/Driver 1 and matrix/CS1_7: D17.4, D18.4, D19.4, D20.4, D21.4, D22.4, D23.4, D24.4, U1.E2
/Driver 1 and matrix/CS1_8: D17.2, D18.2, D19.2, D20.2, D21.2, D22.2, D23.2, D24.2, U1.E1
/Driver 1 and matrix/CS1_9: D17.1, D18.1, D19.1, D20.1, D21.1, D22.1, D23.1, D24.1, U1.F1
/Driver 1 and matrix/CS1_10: D25.4, D26.4, D27.4, D28.4, D29.4, D30.4, D31.4, D32.4, U1.F6
/Driver 1 and matrix/CS1_11: D25.2, D26.2, D27.2, D28.2, D29.2, D30.2, D31.2, D32.2, U1.E6
/Driver 1 and matrix/CS1_12: D25.1, D26.1, D27.1, D28.1, D29.1, D30.1, D31.1, D32.1, U1.D5
/Driver 1 and matrix/CS1_13: D33.4, D34.4, D35.4, D36.4, D37.4, D38.4, D39.4, D40.4, U1.D6
/Driver 1 and matrix/CS1_14: D33.2, D34.2, D35.2, D36.2, D37.2, D38.2, D39.2, D40.2, U1.C4
/Driver 1 and matrix/CS1_15: D33.1, D34.1, D35.1, D36.1, D37.1, D38.1, D39.1, D40.1, U1.C6
/Driver 1 and matrix/CS1_16: D41.4, D42.4, D43.4, D44.4, D45.4, D46.4, D47.4, U1.C5
/Driver 1 and matrix/CS1_17: D41.2, D42.2, D43.2, D44.2, D45.2, D46.2, D47.2, U1.B4
/Driver 1 and matrix/CS1_18: D41.1, D42.1, D43.1, D44.1, D45.1, D46.1, D47.1, U1.B5
/Driver 1 and matrix/SW1_1: D1.3, D9.3, D17.3, D25.3, D33.3, D41.3, U1.A2
/Driver 1 and matrix/SW1_2: D2.3, D10.3, D18.3, D26.3, D34.3, D42.3, U1.A4
/Driver 1 and matrix/SW1_3: D3.3, D11.3, D19.3, D27.3, D35.3, D43.3, U1.A1
/Driver 1 and matrix/SW1_4: D4.3, D12.3, D20.3, D28.3, D36.3, D44.3, U1.A5
/Driver 1 and matrix/SW1_5: D5.3, D13.3, D21.3, D29.3, D37.3, D45.3, U1.B1
/Driver 1 and matrix/SW1_6: D6.3, D14.3, D22.3, D30.3, D38.3, D46.3, U1.A6
/Driver 1 and matrix/SW1_7: D7.3, D15.3, D23.3, D31.3, D39.3, D47.3, U1.C1
/Driver 1 and matrix/SW1_8: D8.3, D16.3, D24.3, D32.3, D40.3, U1.B6
/Driver 2 and matrix/CS2_1: D48.4, D49.4, D50.4, D51.4, D52.4, D53.4, D54.4, D55.4, U2.B2
/Driver 2 and matrix/CS2_2: D48.2, D49.2, D50.2, D51.2, D52.2, D53.2, D54.2, D55.2, U2.B3
/Driver 2 and matrix/CS2_3: D48.1, D49.1, D50.1, D51.1, D52.1, D53.1, D54.1, D55.1, U2.C3
/Driver 2 and matrix/CS2_4: D56.4, D57.4, D58.4, D59.4, D60.4, D61.4, D62.4, D63.4, U2.C2
/Driver 2 and matrix/CS2_5: D56.2, D57.2, D58.2, D59.2, D60.2, D61.2, D62.2, D63.2, U2.D2
/Driver 2 and matrix/CS2_6: D56.1, D57.1, D58.1, D59.1, D60.1, D61.1, D62.1, D63.1, U2.D1
/Driver 2 and matrix/CS2_7: D64.4, D65.4, D66.4, D67.4, D68.4, D69.4, D70.4, D71.4, U2.E2
/Driver 2 and matrix/CS2_8: D64.2, D65.2, D66.2, D67.2, D68.2, D69.2, D70.2, D71.2, U2.E1
/Driver 2 and matrix/CS2_9: D64.1, D65.1, D66.1, D67.1, D68.1, D69.1, D70.1, D71.1, U2.F1
/Driver 2 and matrix/CS2_10: D72.4, D73.4, D74.4, D75.4, D76.4, D77.4, D78.4, D79.4, U2.F6
/Driver 2 and matrix/CS2_11: D72.2, D73.2, D74.2, D75.2, D76.2, D77.2, D78.2, D79.2, U2.E6
/Driver 2 and matrix/CS2_12: D72.1, D73.1, D74.1, D75.1, D76.1, D77.1, D78.1, D79.1, U2.D5
/Driver 2 and matrix/CS2_13: D80.4, D81.4, D82.4, D83.4, D84.4, D85.4, D86.4, D87.4, U2.D6
/Driver 2 and matrix/CS2_14: D80.2, D81.2, D82.2, D83.2, D84.2, D85.2, D86.2, D87.2, U2.C4
/Driver 2 and matrix/CS2_15: D80.1, D81.1, D82.1, D83.1, D84.1, D85.1, D86.1, D87.1, U2.C6
/Driver 2 and matrix/CS2_16: D88.4, D89.4, D90.4, D91.4, D92.4, D93.4, D94.4, U2.C5
/Driver 2 and matrix/CS2_17: D88.2, D89.2, D90.2, D91.2, D92.2, D93.2, D94.2, U2.B4
/Driver 2 and matrix/CS2_18: D88.1, D89.1, D90.1, D91.1, D92.1, D93.1, D94.1, U2.B5
/Driver 2 and matrix/SW2_1: D48.3, D56.3, D64.3, D72.3, D80.3, D88.3, U2.A2
/Driver 2 and matrix/SW2_2: D49.3, D57.3, D65.3, D73.3, D81.3, D89.3, U2.A4
/Driver 2 and matrix/SW2_3: D50.3, D58.3, D66.3, D74.3, D82.3, D90.3, U2.A1
/Driver 2 and matrix/SW2_4: D51.3, D59.3, D67.3, D75.3, D83.3, D91.3, U2.A5
/Driver 2 and matrix/SW2_5: D52.3, D60.3, D68.3, D76.3, D84.3, D92.3, U2.B1
/Driver 2 and matrix/SW2_6: D53.3, D61.3, D69.3, D77.3, D85.3, D93.3, U2.A6
/Driver 2 and matrix/SW2_7: D54.3, D62.3, D70.3, D78.3, D86.3, D94.3, U2.C1
/Driver 2 and matrix/SW2_8: D55.3, D63.3, D71.3, D79.3, D87.3, U2.B6
/Driver 3 and matrix/CS3_1: D95.4, D96.4, D97.4, D98.4, D99.4, D100.4, D101.4, D102.4, U10.B2
/Driver 3 and matrix/CS3_2: D95.2, D96.2, D97.2, D98.2, D99.2, D100.2, D101.2, D102.2, U10.B3
/Driver 3 and matrix/CS3_3: D95.1, D96.1, D97.1, D98.1, D99.1, D100.1, D101.1, D102.1, U10.C3
/Driver 3 and matrix/CS3_4: D103.4, D104.4, D105.4, D106.4, D107.4, D108.4, D109.4, D110.4, U10.C2
/Driver 3 and matrix/CS3_5: D103.2, D104.2, D105.2, D106.2, D107.2, D108.2, D109.2, D110.2, U10.D2
/Driver 3 and matrix/CS3_6: D103.1, D104.1, D105.1, D106.1, D107.1, D108.1, D109.1, D110.1, U10.D1
/Driver 3 and matrix/CS3_7: D111.4, D112.4, D113.4, D114.4, D115.4, D116.4, D117.4, D118.4, U10.E2
/Driver 3 and matrix/CS3_8: D111.2, D112.2, D113.2, D114.2, D115.2, D116.2, D117.2, D118.2, U10.E1
/Driver 3 and matrix/CS3_9: D111.1, D112.1, D113.1, D114.1, D115.1, D116.1, D117.1, D118.1, U10.F1
/Driver 3 and matrix/CS3_10: D119.4, D120.4, D121.4, D122.4, D123.4, D124.4, D125.4, D126.4, U10.F6
/Driver 3 and matrix/CS3_11: D119.2, D120.2, D121.2, D122.2, D123.2, D124.2, D125.2, D126.2, U10.E6
/Driver 3 and matrix/CS3_12: D119.1, D120.1, D121.1, D122.1, D123.1, D124.1, D125.1, D126.1, U10.D5
/Driver 3 and matrix/CS3_13: D127.4, D128.4, D129.4, D130.4, D131.4, D132.4, D133.4, D134.4, U10.D6
/Driver 3 and matrix/CS3_14: D127.2, D128.2, D129.2, D130.2, D131.2, D132.2, D133.2, D134.2, U10.C4
/Driver 3 and matrix/CS3_15: D127.1, D128.1, D129.1, D130.1, D131.1, D132.1, D133.1, D134.1, U10.C6
/Driver 3 and matrix/CS3_16: D135.4, D136.4, D137.4, D138.4, D139.4, D140.4, D141.4, U10.C5
/Driver 3 and matrix/CS3_17: D135.2, D136.2, D137.2, D138.2, D139.2, D140.2, D141.2, U10.B4
/Driver 3 and matrix/CS3_18: D135.1, D136.1, D137.1, D138.1, D139.1, D140.1, D141.1, U10.B5
/Driver 3 and matrix/SW3_1: D95.3, D103.3, D111.3, D119.3, D127.3, D135.3, U10.A2
/Driver 3 and matrix/SW3_2: D96.3, D104.3, D112.3, D120.3, D128.3, D136.3, U10.A4
/Driver 3 and matrix/SW3_3: D97.3, D105.3, D113.3, D121.3, D129.3, D137.3, U10.A1
/Driver 3 and matrix/SW3_4: D98.3, D106.3, D114.3, D122.3, D130.3, D138.3, U10.A5
/Driver 3 and matrix/SW3_5: D99.3, D107.3, D115.3, D123.3, D131.3, D139.3, U10.B1
/Driver 3 and matrix/SW3_6: D100.3, D108.3, D116.3, D124.3, D132.3, D140.3, U10.A6
/Driver 3 and matrix/SW3_7: D101.3, D109.3, D117.3, D125.3, D133.3, D141.3, U10.C1
/Driver 3 and matrix/SW3_8: D102.3, D110.3, D118.3, D126.3, D134.3, U10.B6
/Driver 4 and matrix/CS4_1: D142.4, D143.4, D144.4, D145.4, D146.4, D147.4, D148.4, D149.4, U11.B2
/Driver 4 and matrix/CS4_2: D142.2, D143.2, D144.2, D145.2, D146.2, D147.2, D148.2, D149.2, U11.B3
/Driver 4 and matrix/CS4_3: D142.1, D143.1, D144.1, D145.1, D146.1, D147.1, D148.1, D149.1, U11.C3
/Driver 4 and matrix/CS4_4: D150.4, D151.4, D152.4, D153.4, D154.4, D155.4, D156.4, D157.4, U11.C2
/Driver 4 and matrix/CS4_5: D150.2, D151.2, D152.2, D153.2, D154.2, D155.2, D156.2, D157.2, U11.D2
/Driver 4 and matrix/CS4_6: D150.1, D151.1, D152.1, D153.1, D154.1, D155.1, D156.1, D157.1, U11.D1
/Driver 4 and matrix/CS4_7: D158.4, D159.4, D160.4, D161.4, D162.4, D163.4, D164.4, D165.4, U11.E2
/Driver 4 and matrix/CS4_8: D158.2, D159.2, D160.2, D161.2, D162.2, D163.2, D164.2, D165.2, U11.E1
/Driver 4 and matrix/CS4_9: D158.1, D159.1, D160.1, D161.1, D162.1, D163.1, D164.1, D165.1, U11.F1
/Driver 4 and matrix/CS4_10: D166.4, D167.4, D168.4, D169.4, D170.4, D171.4, D172.4, D173.4, U11.F6
/Driver 4 and matrix/CS4_11: D166.2, D167.2, D168.2, D169.2, D170.2, D171.2, D172.2, D173.2, U11.E6
/Driver 4 and matrix/CS4_12: D166.1, D167.1, D168.1, D169.1, D170.1, D171.1, D172.1, D173.1, U11.D5
/Driver 4 and matrix/CS4_13: D174.4, D175.4, D176.4, D177.4, D178.4, D179.4, D180.4, D181.4, U11.D6
/Driver 4 and matrix/CS4_14: D174.2, D175.2, D176.2, D177.2, D178.2, D179.2, D180.2, D181.2, U11.C4
/Driver 4 and matrix/CS4_15: D174.1, D175.1, D176.1, D177.1, D178.1, D179.1, D180.1, D181.1, U11.C6
/Driver 4 and matrix/CS4_16: D182.4, D183.4, D184.4, D185.4, D186.4, D187.4, D188.4, U11.C5
/Driver 4 and matrix/CS4_17: D182.2, D183.2, D184.2, D185.2, D186.2, D187.2, D188.2, U11.B4
/Driver 4 and matrix/CS4_18: D182.1, D183.1, D184.1, D185.1, D186.1, D187.1, D188.1, U11.B5
/Driver 4 and matrix/SW4_1: D142.3, D150.3, D158.3, D166.3, D174.3, D182.3, U11.A2
/Driver 4 and matrix/SW4_2: D143.3, D151.3, D159.3, D167.3, D175.3, D183.3, U11.A4
/Driver 4 and matrix/SW4_3: D144.3, D152.3, D160.3, D168.3, D176.3, D184.3, U11.A1
/Driver 4 and matrix/SW4_4: D145.3, D153.3, D161.3, D169.3, D177.3, D185.3, U11.A5
/Driver 4 and matrix/SW4_5: D146.3, D154.3, D162.3, D170.3, D178.3, D186.3, U11.B1
/Driver 4 and matrix/SW4_6: D147.3, D155.3, D163.3, D171.3, D179.3, D187.3, U11.A6
/Driver 4 and matrix/SW4_7: D148.3, D156.3, D164.3, D172.3, D180.3, D188.3, U11.C1
/Driver 4 and matrix/SW4_8: D149.3, D157.3, D165.3, D173.3, D181.3, U11.B6
/Driver 5 and matrix/CS5_1: D189.4, D190.4, D191.4, D192.4, D193.4, D194.4, D195.4, D196.4, U12.B2
/Driver 5 and matrix/CS5_2: D189.2, D190.2, D191.2, D192.2, D193.2, D194.2, D195.2, D196.2, U12.B3
/Driver 5 and matrix/CS5_3: D189.1, D190.1, D191.1, D192.1, D193.1, D194.1, D195.1, D196.1, U12.C3
/Driver 5 and matrix/CS5_4: D197.4, D198.4, D199.4, D200.4, D201.4, D202.4, D203.4, D204.4, U12.C2
/Driver 5 and matrix/CS5_5: D197.2, D198.2, D199.2, D200.2, D201.2, D202.2, D203.2, D204.2, U12.D2
/Driver 5 and matrix/CS5_6: D197.1, D198.1, D199.1, D200.1, D201.1, D202.1, D203.1, D204.1, U12.D1
/Driver 5 and matrix/CS5_7: D205.4, D206.4, D207.4, D208.4, D209.4, D210.4, D211.4, D212.4, U12.E2
/Driver 5 and matrix/CS5_8: D205.2, D206.2, D207.2, D208.2, D209.2, D210.2, D211.2, D212.2, U12.E1
/Driver 5 and matrix/CS5_9: D205.1, D206.1, D207.1, D208.1, D209.1, D210.1, D211.1, D212.1, U12.F1
/Driver 5 and matrix/CS5_10: D213.4, D214.4, D215.4, D216.4, D217.4, D218.4, D219.4, D220.4, U12.F6
/Driver 5 and matrix/CS5_11: D213.2, D214.2, D215.2, D216.2, D217.2, D218.2, D219.2, D220.2, U12.E6
/Driver 5 and matrix/CS5_12: D213.1, D214.1, D215.1, D216.1, D217.1, D218.1, D219.1, D220.1, U12.D5
/Driver 5 and matrix/CS5_13: D221.4, D222.4, D223.4, D224.4, D225.4, D226.4, D227.4, D228.4, U12.D6
/Driver 5 and matrix/CS5_14: D221.2, D222.2, D223.2, D224.2, D225.2, D226.2, D227.2, D228.2, U12.C4
/Driver 5 and matrix/CS5_15: D221.1, D222.1, D223.1, D224.1, D225.1, D226.1, D227.1, D228.1, U12.C6
/Driver 5 and matrix/CS5_16: D229.4, D230.4, D231.4, D232.4, D233.4, D234.4, D235.4, U12.C5
/Driver 5 and matrix/CS5_17: D229.2, D230.2, D231.2, D232.2, D233.2, D234.2, D235.2, U12.B4
/Driver 5 and matrix/CS5_18: D229.1, D230.1, D231.1, D232.1, D233.1, D234.1, D235.1, U12.B5
/Driver 5 and matrix/SW5_1: D189.3, D197.3, D205.3, D213.3, D221.3, D229.3, U12.A2
/Driver 5 and matrix/SW5_2: D190.3, D198.3, D206.3, D214.3, D222.3, D230.3, U12.A4
/Driver 5 and matrix/SW5_3: D191.3, D199.3, D207.3, D215.3, D223.3, D231.3, U12.A1
/Driver 5 and matrix/SW5_4: D192.3, D200.3, D208.3, D216.3, D224.3, D232.3, U12.A5
/Driver 5 and matrix/SW5_5: D193.3, D201.3, D209.3, D217.3, D225.3, D233.3, U12.B1
/Driver 5 and matrix/SW5_6: D194.3, D202.3, D210.3, D218.3, D226.3, D234.3, U12.A6
/Driver 5 and matrix/SW5_7: D195.3, D203.3, D211.3, D219.3, D227.3, D235.3, U12.C1
/Driver 5 and matrix/SW5_8: D196.3, D204.3, D212.3, D220.3, D228.3, U12.B6
/MCU/ACC_INT: U3.14, U9.12
/MCU/ACC_SCL: R19.2, U3.5, U9.1, U13.2
/MCU/ACC_SDA: R20.2, U3.4, U9.4, U13.3
/MCU/BTN: R18.1, U3.15
/MCU/LIGHT: C70.1, Q2.2, R43.1, U3.41
/MCU/LIGHT_PWR: Q2.1, U3.3
/MCU/QSPI_SCLK: U3.56, U4.6
/MCU/QSPI_SD0: U3.57, U4.5
/MCU/QSPI_SD1: U3.59, U4.2
/MCU/QSPI_SD2: U3.58, U4.3
/MCU/QSPI_SD3: U3.55, U4.7
/MCU/QSPI_SS: R16.1, U3.60, U4.1
/MCU/RTC_INT: R32.2, U3.31, U13.6
/MCU/RTC_VOUT: C76.1, U13.9
/MCU/RUN: TP5.1, U3.26
/MCU/SWCLK: TP6.1, U3.24
/MCU/SWDIO: TP7.1, U3.25
/MCU/USB_DM_MCU: R14.2, U3.51
/MCU/USB_DP_MCU: R15.2, U3.52
/MCU/VREG_AVDD: C17.1, R13.2, U3.46
/MCU/VREG_LX: L1.2, U3.48
/Power/BAT_N: BT1.2, C6.2, U8.4, U8.5
/Power/CC1: J1.A5, R1.1
/Power/CC2: J1.B5, R2.1
/Power/USB_DM_C: J1.A7, J1.B7, U7.1
/Power/USB_DP_C: J1.A6, J1.B6, U7.3
CHG: R7.2, U3.16, U5.9
GND: BT1.MP, C1.2, C2.2, C3.2, C4.2, C5.2, C7.2, C8.2, C9.2, C10.2, C11.2, C12.2, C13.2, C14.2, C16.2, C17.2, C18.2, C19.2, C20.2, C21.2, C22.2, C23.2, C24.2, C25.2, C26.2, C27.2, C30.2, C31.2, C32.2, C33.2, C34.2, C35.2, C40.2, C41.2, C42.2, C43.2, C44.2, C51.2, C52.2, C53.2, C54.2, C61.2, C62.2, C63.2, C64.2, C70.2, C71.2, C72.2, C73.2, C74.2, C75.2, C76.2, J1.A1B12, J1.B1A12, J1.S1, Q1.1, R1.2, R2.2, R3.2, R4.2, R5.2, R9.2, R12.2, R30.2, R31.2, R33.2, R43.2, R50.2, R60.2, R70.2, SW1.2, SW2.2, TP8.1, U1.D4, U1.E4, U1.F4, U2.E4, U2.F4, U3.47, U3.61, U4.4, U5.4, U5.5, U5.8, U5.15, U5.17, U6.2, U6.5, U7.2, U8.1, U8.2, U8.3, U9.6, U9.7, U9.8, U10.F4, U11.F4, U12.F4, U13.7, Y1.2, Y1.4
I2C_SCL: R22.2, U1.E3, U2.E3, U3.8, U10.D4, U10.E3, U10.E4, U11.E3, U11.E4, U12.E3
I2C_SDA: R21.2, U1.D3, U2.D3, U2.D4, U3.7, U10.D3, U11.D3, U11.D4, U12.D3
LED_SDB: C35.1, R31.1, U1.E5, U2.E5, U3.9, U10.E5, U11.E5, U12.E5
unnamed: C24.1, R17.1, Y1.3
unnamed: Q1.5, Q1.6, R10.2
unnamed: Q1.3, R11.1
unnamed: R16.2, SW2.1
unnamed: R18.2, SW1.1
unnamed: R30.1, U1.F3
unnamed: R33.1, U2.F3
unnamed: C23.1, U3.21, Y1.1
unnamed: R17.2, U3.22
unnamed: R5.1, U5.12
unnamed: R4.1, U5.16
unnamed: R3.1, U5.1
unnamed: C6.1, R8.2, U8.6
unnamed: R50.1, U10.F3
unnamed: R60.1, U11.F3
unnamed: R70.1, U12.F3
PGOOD: R6.2, U3.17, U5.7
USB_DM: R14.1, U7.6
USB_DP: R15.1, U7.4
VBAT: BT1.1, C5.1, Q1.4, R8.1, R10.1, TP3.1, U5.2, U5.3
VBAT_EN: Q1.2, R9.1, U3.18
VBAT_SENSE: C7.1, R11.2, R12.1, U3.40
VBUS: C1.1, J1.A4B9, J1.B4A9, U5.13, U7.5
VSYS: C2.1, C3.1, C30.1, C31.1, C32.1, C33.1, C34.1, C40.1, C41.1, C42.1, C43.1, C44.1, C51.1, C52.1, C53.1, C54.1, C61.1, C62.1, C63.1, C64.1, C71.1, C72.1, C73.1, C74.1, TP1.1, U1.A3, U1.F5, U2.A3, U2.F5, U5.10, U5.11, U6.3, U6.4, U10.A3, U10.F5, U11.A3, U11.F5, U12.A3, U12.D4, U12.E4, U12.F5
