sequoia-hope/matrix-play/hw/parallelogram/p3-162/parallelogram.kicad_pcb

## KiCad design hw/parallelogram/p3-162/parallelogram.kicad_pcb (2026-11-07, an earlier design)

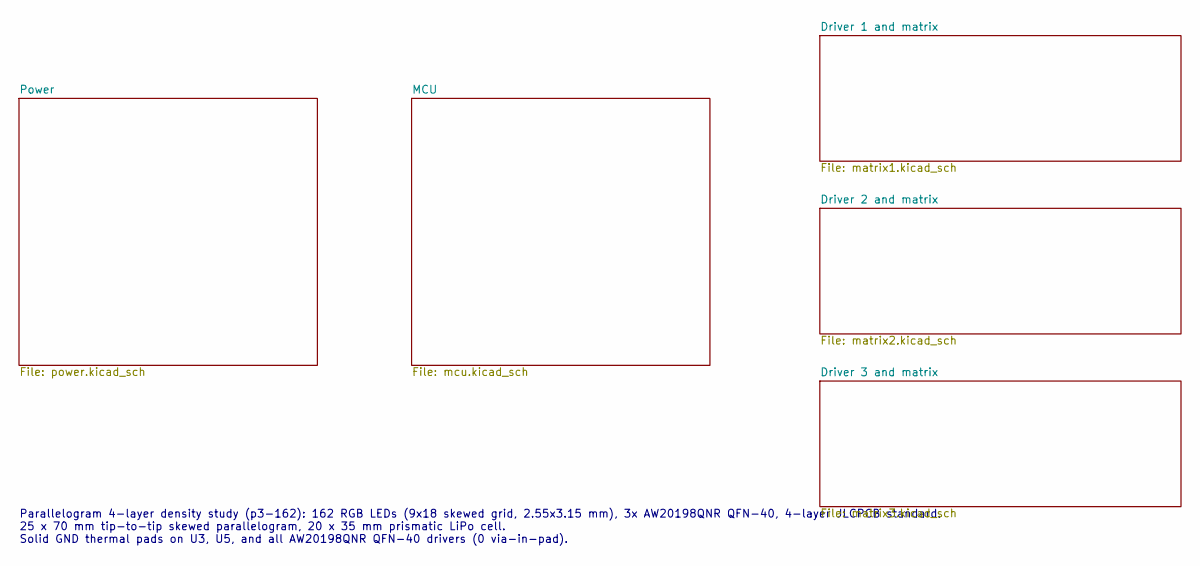
[picture p159: schematic parallelogram.kicad_sch, parallelogram (p3-162): top]

Notes on the sheet:
Parallelogram 4-layer density study (p3-162): 162 RGB LEDs (9x18 skewed grid, 2.55x3.15 mm), 3x AW20198QNR QFN-40, 4-layer JLCPCB standard. 25 x 70 mm tip-to-tip skewed parallelogram, 20 x 35 mm prismatic LiPo cell. Solid GND thermal pads on U3, U5, and all AW20198QNR QFN-40 drivers (0 via-in-pad).
