sequoia-hope/matrix-play/hw/parallelogram/p3-162/parallelogram.kicad_pcb

## KiCad design hw/parallelogram/p3-162/parallelogram.kicad_pcb (continued)

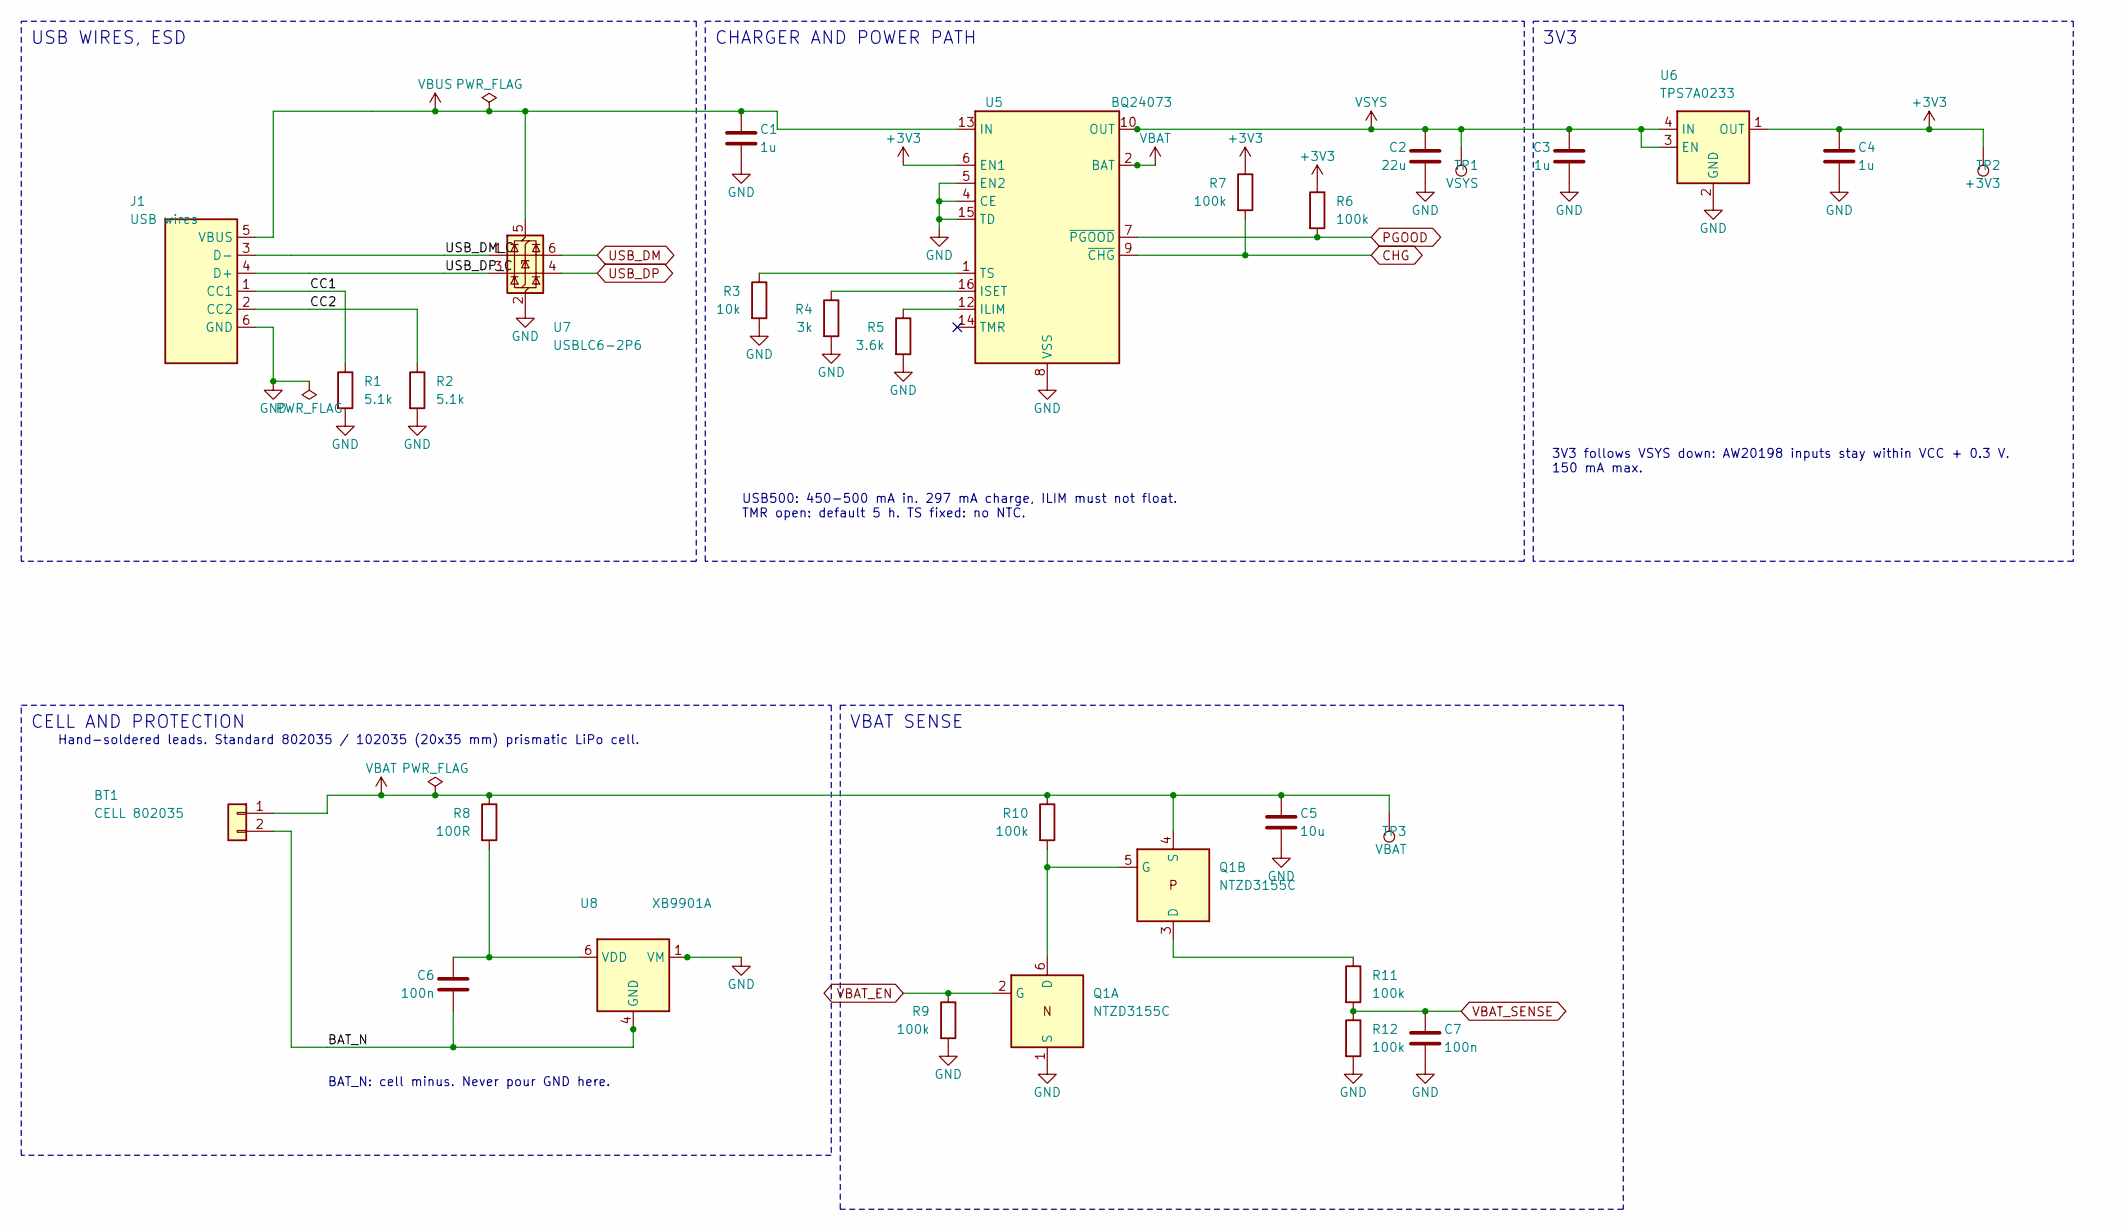
[picture p160: schematic power.kicad_sch, parallelogram (p3-162): power]

Parts:
BT1: CELL 802035; BatteryPads; MPN 802035
C1, C3, C4: 1u; C_0402_1005Metric; MPN CL05A105KA5NQNC; LCSC C52923
C2: 22u; C_0603_1608Metric; MPN CL10A226MP8NUNE; LCSC C86295
C5: 10u; C_0603_1608Metric; MPN CL10A106KP8NNNC; LCSC C19702
C6, C7: 100n; C_0402_1005Metric; MPN CL05B104KO5NNNC; LCSC C1525
J1: USB wires; USB_Pads; MPN none, wire pads
Q1: NTZD3155C; SOT-563; MPN NTZD3155CT1G; LCSC C236117
R1, R2: 5.1k; R_0402_1005Metric; MPN 0402WGF5101TCE; LCSC C25905
R3: 10k; R_0402_1005Metric; MPN 0402WGF1002TCE; LCSC C25744
R4: 3k; R_0402_1005Metric; MPN 0402WGF3001TCE; LCSC C25784
R5: 3.6k; R_0402_1005Metric; MPN 0402WGF3601TCE; LCSC C25891
R6, R7, R9, R10, R11, R12: 100k; R_0402_1005Metric; MPN 0402WGF1003TCE; LCSC C25741
R8: 100R; R_0402_1005Metric; MPN 0402WGF1000TCE; LCSC C25076
TP1: VSYS; TestPoint_Pad_D1.0mm
TP2: +3V3; TestPoint_Pad_D1.0mm
TP3: VBAT; TestPoint_Pad_D1.0mm
U5: BQ24073; QFN-16-1EP_3x3mm_P0.5mm_EP1.7x1.7mm; MPN BQ24073RGTR; LCSC C15220
U6: TPS7A0233; Texas_X2SON-4_1x1mm_P0.65mm; MPN TPS7A0233PDQNR; LCSC C2860046
U7: USBLC6-2P6; SOT-666; MPN USBLC6-2P6; LCSC C15999
U8: XB9901A; XySemi_DFN-6_1.8x1.4mm; MPN XB9901A; LCSC C669687

Connections:
+3V3: C4.1, R6.1, R7.1, TP2.1, U5.6 (EN1), U6.1 (OUT); also elsewhere on the board
/Power/BAT_N: BT1.2, C6.2, U8.4 (GND), U8.5 (GND)
/Power/CC1: J1.1 (CC1), R1.1
/Power/CC2: J1.2 (CC2), R2.1
/Power/USB_DM_C: J1.3 (D-), U7.1 (I/O1)
/Power/USB_DP_C: J1.4 (D+), U7.3 (I/O2)
CHG: R7.2, U5.9 (~CHG); also elsewhere on the board
unnamed: Q1.5 (G), Q1.6 (D), R10.2
unnamed: Q1.3 (D), R11.1
unnamed: R5.1, U5.12 (ILIM)
unnamed: R4.1, U5.16 (ISET)
unnamed: R3.1, U5.1 (TS)
unnamed: C6.1, R8.2, U8.6 (VDD)
PGOOD: R6.2, U5.7 (~PGOOD); also elsewhere on the board
USB_DM: U7.6 (I/O1); also elsewhere on the board
USB_DP: U7.4 (I/O2); also elsewhere on the board
VBAT_EN: Q1.2 (G), R9.1; also elsewhere on the board
VBAT_SENSE: C7.1, R11.2, R12.1; also elsewhere on the board
VSYS: C2.1, C3.1, TP1.1, U5.10 (OUT), U5.11 (OUT), U6.3 (EN), U6.4 (IN); also elsewhere on the board

Notes on the sheet:
USB WIRES, ESD
USB500: 450-500 mA in. 297 mA charge, ILIM must not float. TMR open: default 5 h. TS fixed: no NTC.
CHARGER AND POWER PATH
3V3 follows VSYS down: AW20198 inputs stay within VCC + 0.3 V. 150 mA max.
3V3
Hand-soldered leads. Standard 802035 / 102035 (20x35 mm) prismatic LiPo cell.
BAT_N: cell minus. Never pour GND here.
CELL AND PROTECTION
VBAT SENSE

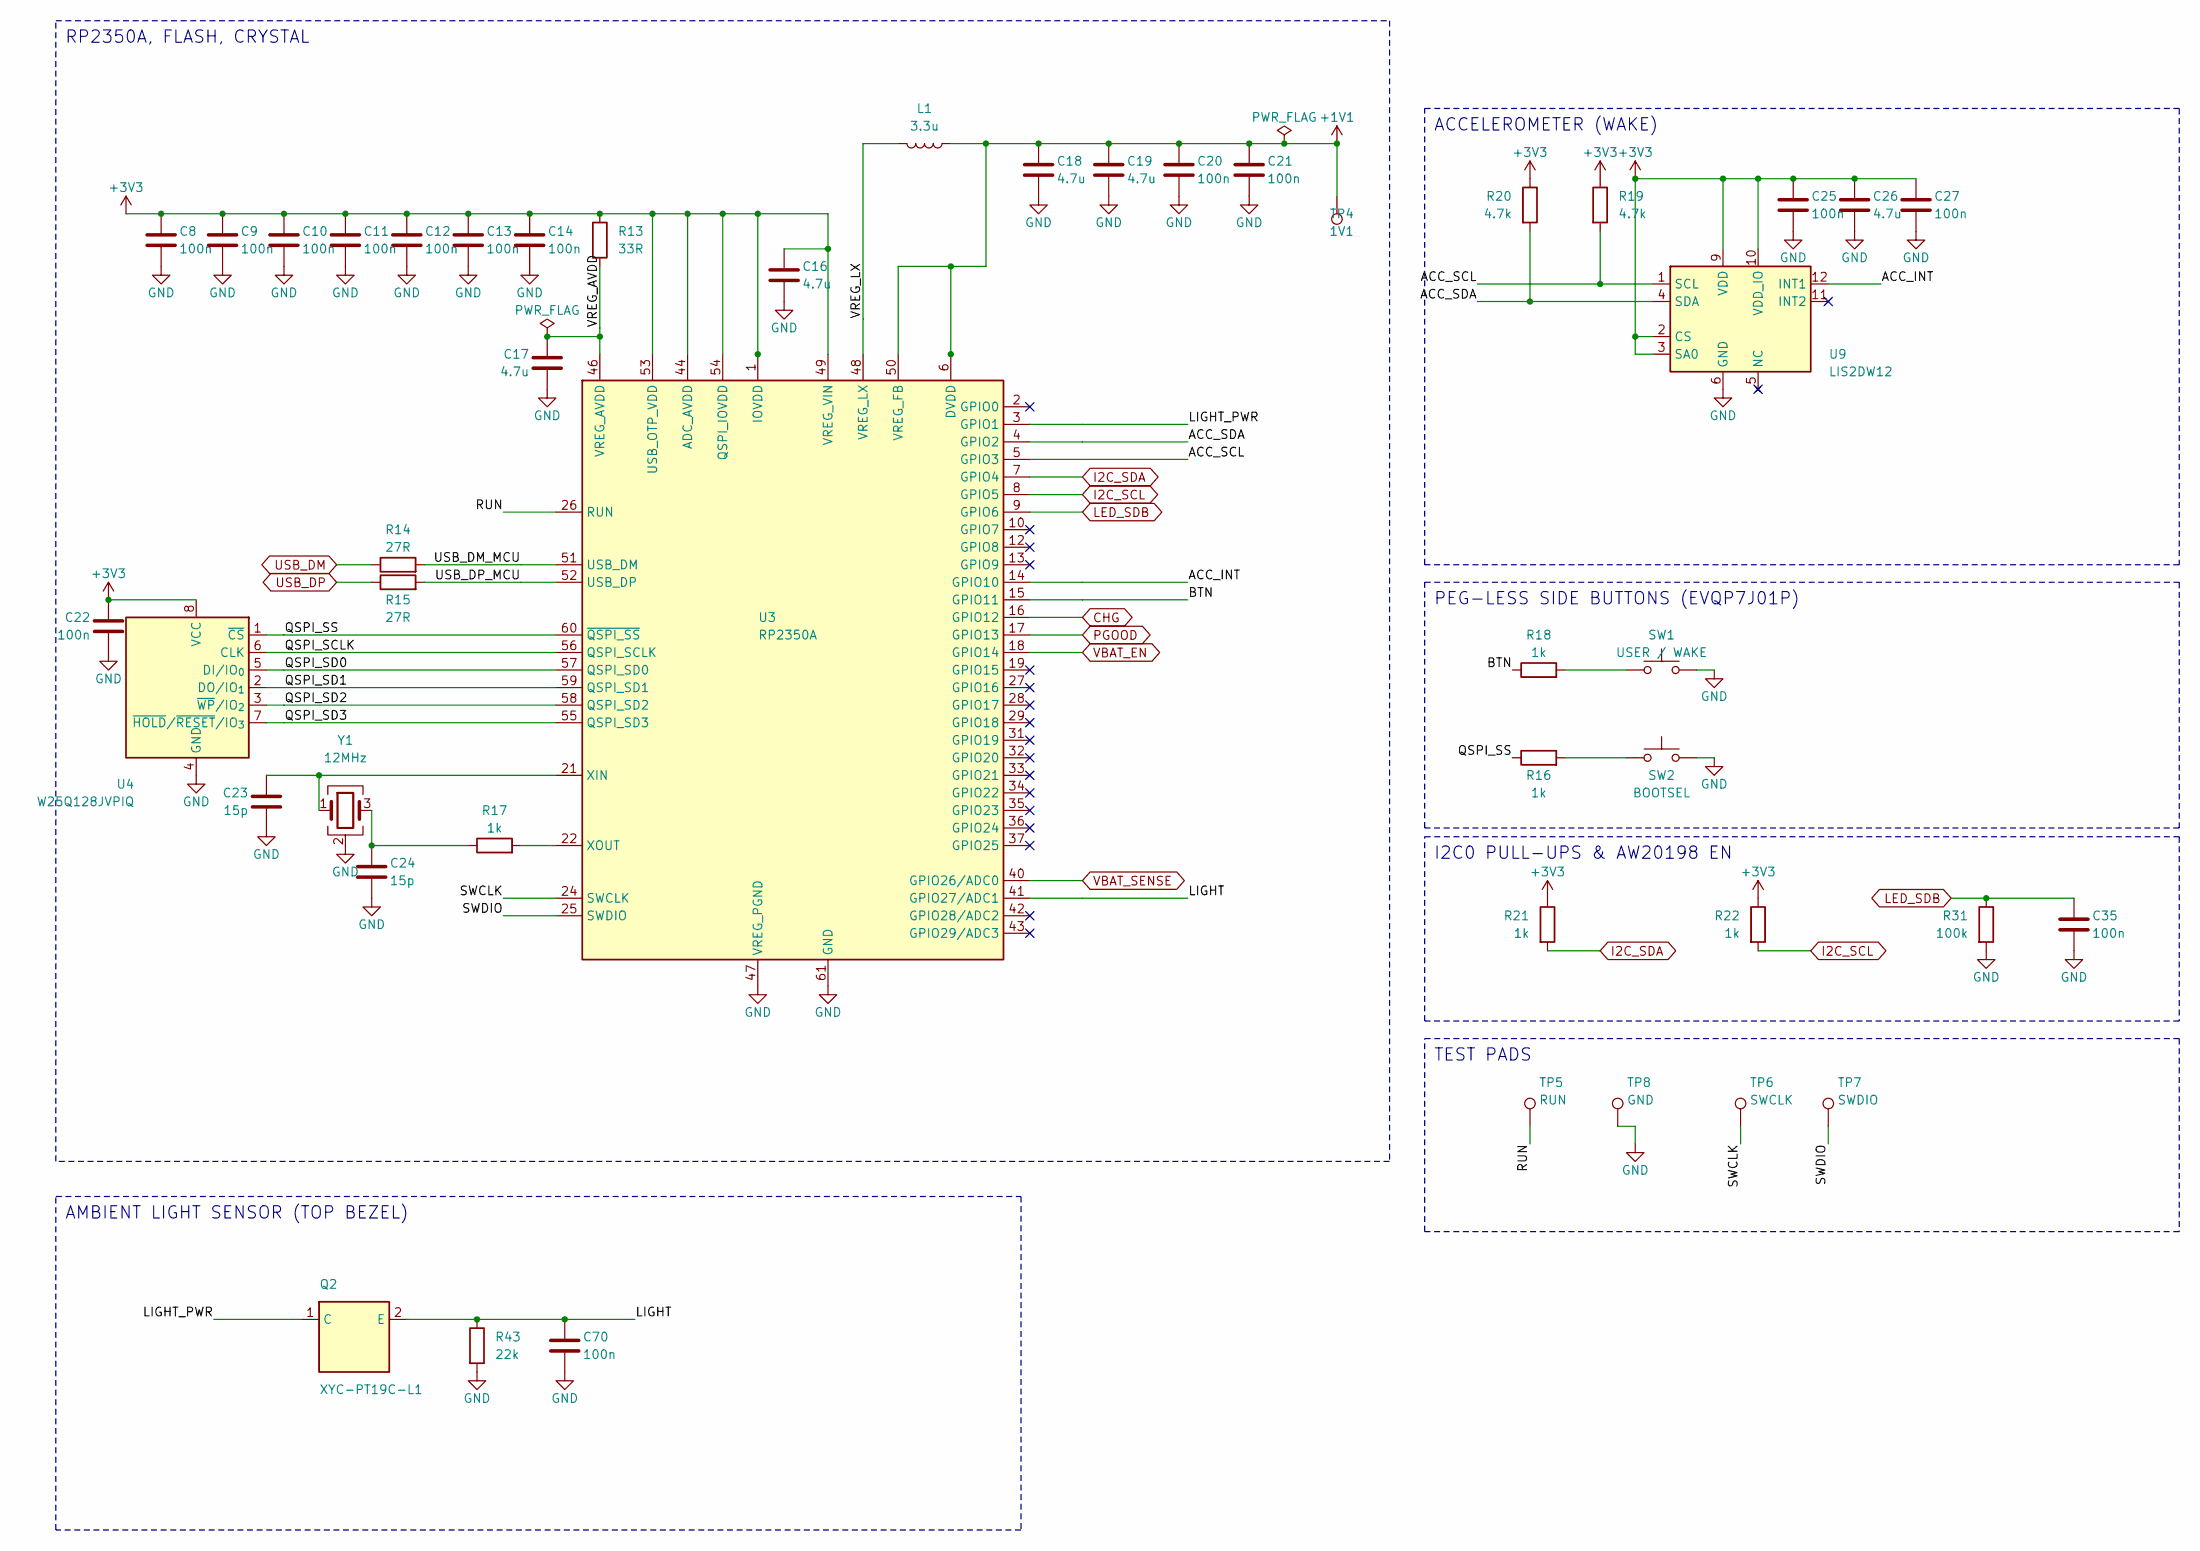
[picture p161: schematic mcu.kicad_sch, parallelogram (p3-162): mcu]

Parts:
C8, C9, C10, C11, C12, C13, C14, C20, C21, C22, C25, C27, C35, C70: 100n; C_0402_1005Metric; MPN CL05B104KO5NNNC; LCSC C1525
C16, C18: 4.7u; C_0402_1005Metric_small_pads; MPN CL05A475MP5NRNC; LCSC C23733
C17, C19, C26: 4.7u; C_0402_1005Metric; MPN CL05A475MP5NRNC; LCSC C23733
C23, C24: 15p; C_0402_1005Metric; MPN 0402CG150J500NT; LCSC C1548
L1: 3.3u; L_pol_2016; MPN AOTA-B201610S3R3-101-T; LCSC C42411119
Q2: XYC-PT19C-L1; SENSOR_ALS-PT19; MPN XYC-PT19C-L1; LCSC C2693594
R13: 33R; R_0402_1005Metric; MPN 0402WGF330JTCE; LCSC C25105
R14, R15: 27R; R_0402_1005Metric; MPN 0402WGF270JTCE; LCSC C25100
R16, R17, R18, R21, R22: 1k; R_0402_1005Metric; MPN 0402WGF1001TCE; LCSC C11702
R19, R20: 4.7k; R_0402_1005Metric; MPN 0402WGF4701TCE; LCSC C25900
R31: 100k; R_0402_1005Metric; MPN 0402WGF1003TCE; LCSC C25741
R43: 22k; R_0402_1005Metric; MPN 0402WGF2202TCE; LCSC C25768
SW1: USER / WAKE; SW_Panasonic_EVQP7J; MPN EVQP7J01P; LCSC C2828254
SW2: BOOTSEL; SW_Panasonic_EVQP7J; MPN EVQP7J01P; LCSC C2828254
TP4: 1V1; TestPoint_Pad_D1.0mm
TP5: RUN; TestPoint_Pad_D1.0mm
TP6: SWCLK; TestPoint_Pad_D1.0mm
TP7: SWDIO; TestPoint_Pad_D1.0mm
TP8: GND; TestPoint_Pad_D1.0mm
U3: RP2350A; RP2350-QFN-60-1EP_7x7_P0.4mm_EP3.4x3.4mm_ThermalVias; MPN RP2350A; LCSC C42411118
U4: W25Q128JVPIQ; WSON-8_6x5mm_P1.27mm_NoEPCopper; MPN W25Q128JVPIQ; LCSC C190862
U9: LIS2DW12; LGA-12_2x2mm_P0.5mm; MPN LIS2DW12TR; LCSC C189624
Y1: 12MHz; Crystal_SMD_3225-4Pin_3.2x2.5mm; MPN ABM8-272-T3; LCSC C20625731

Connections:
+3V3: C8.1, C9.1, C10.1, C11.1, C12.1, C13.1, C14.1, C16.1, C22.1, C25.1, C26.1, C27.1, R13.1, R19.1, R20.1, R21.1, R22.1, U3.1 (IOVDD), U3.11 (IOVDD), U3.20 (IOVDD), U3.30 (IOVDD), U3.38 (IOVDD), U3.44 (ADC_AVDD), U3.45 (IOVDD), U3.49 (VREG_VIN), U3.53 (USB_OTP_VDD), U3.54 (QSPI_IOVDD), U4.8 (VCC), U9.2 (CS), U9.3 (SA0), U9.9 (VDD), U9.10 (VDD_IO); also elsewhere on the board
/MCU/ACC_INT: U3.14 (GPIO10), U9.12 (INT1)
/MCU/ACC_SCL: R19.2, U3.5 (GPIO3), U9.1 (SCL)
/MCU/ACC_SDA: R20.2, U3.4 (GPIO2), U9.4 (SDA)
/MCU/BTN: R18.1, U3.15 (GPIO11)
/MCU/LIGHT: C70.1, Q2.2 (E), R43.1, U3.41 (GPIO27/ADC1)
/MCU/LIGHT_PWR: Q2.1 (C), U3.3 (GPIO1)
/MCU/QSPI_SCLK: U3.56 (QSPI_SCLK), U4.6 (CLK)
/MCU/QSPI_SD0: U3.57 (QSPI_SD0), U4.5 (DI/IO_{0})
/MCU/QSPI_SD1: U3.59 (QSPI_SD1), U4.2 (DO/IO_{1})
/MCU/QSPI_SD2: U3.58 (QSPI_SD2), U4.3 (~WP/IO_{2})
/MCU/QSPI_SD3: U3.55 (QSPI_SD3), U4.7 (~HOLD/~RESET/IO_{3})
/MCU/QSPI_SS: R16.1, U3.60 (~QSPI_SS), U4.1 (~CS)
/MCU/RUN: TP5.1, U3.26 (RUN)
/MCU/SWCLK: TP6.1, U3.24 (SWCLK)
/MCU/SWDIO: TP7.1, U3.25 (SWDIO)
/MCU/USB_DM_MCU: R14.2, U3.51 (USB_DM)
/MCU/USB_DP_MCU: R15.2, U3.52 (USB_DP)
/MCU/VREG_LX: L1.2, U3.48 (VREG_LX)
CHG: U3.16 (GPIO12); also elsewhere on the board
I2C_SCL: R22.2, U3.8 (GPIO5); also elsewhere on the board
I2C_SDA: R21.2, U3.7 (GPIO4); also elsewhere on the board
LED_SDB: C35.1, R31.1, U3.9 (GPIO6); also elsewhere on the board
unnamed: C24.1, R17.1, Y1.3
unnamed: R16.2, SW2.1
unnamed: R18.2, SW1.1
unnamed: C23.1, U3.21 (XIN), Y1.1
unnamed: R17.2, U3.22 (XOUT)
PGOOD: U3.17 (GPIO13); also elsewhere on the board
USB_DM: R14.1; also elsewhere on the board
USB_DP: R15.1; also elsewhere on the board
VBAT_EN: U3.18 (GPIO14); also elsewhere on the board
VBAT_SENSE: U3.40 (GPIO26/ADC0); also elsewhere on the board

Notes on the sheet:
RP2350A, FLASH, CRYSTAL
ACCELEROMETER (WAKE)
PEG-LESS SIDE BUTTONS (EVQP7J01P)
I2C0 PULL-UPS & AW20198 EN
TEST PADS
AMBIENT LIGHT SENSOR (TOP BEZEL)

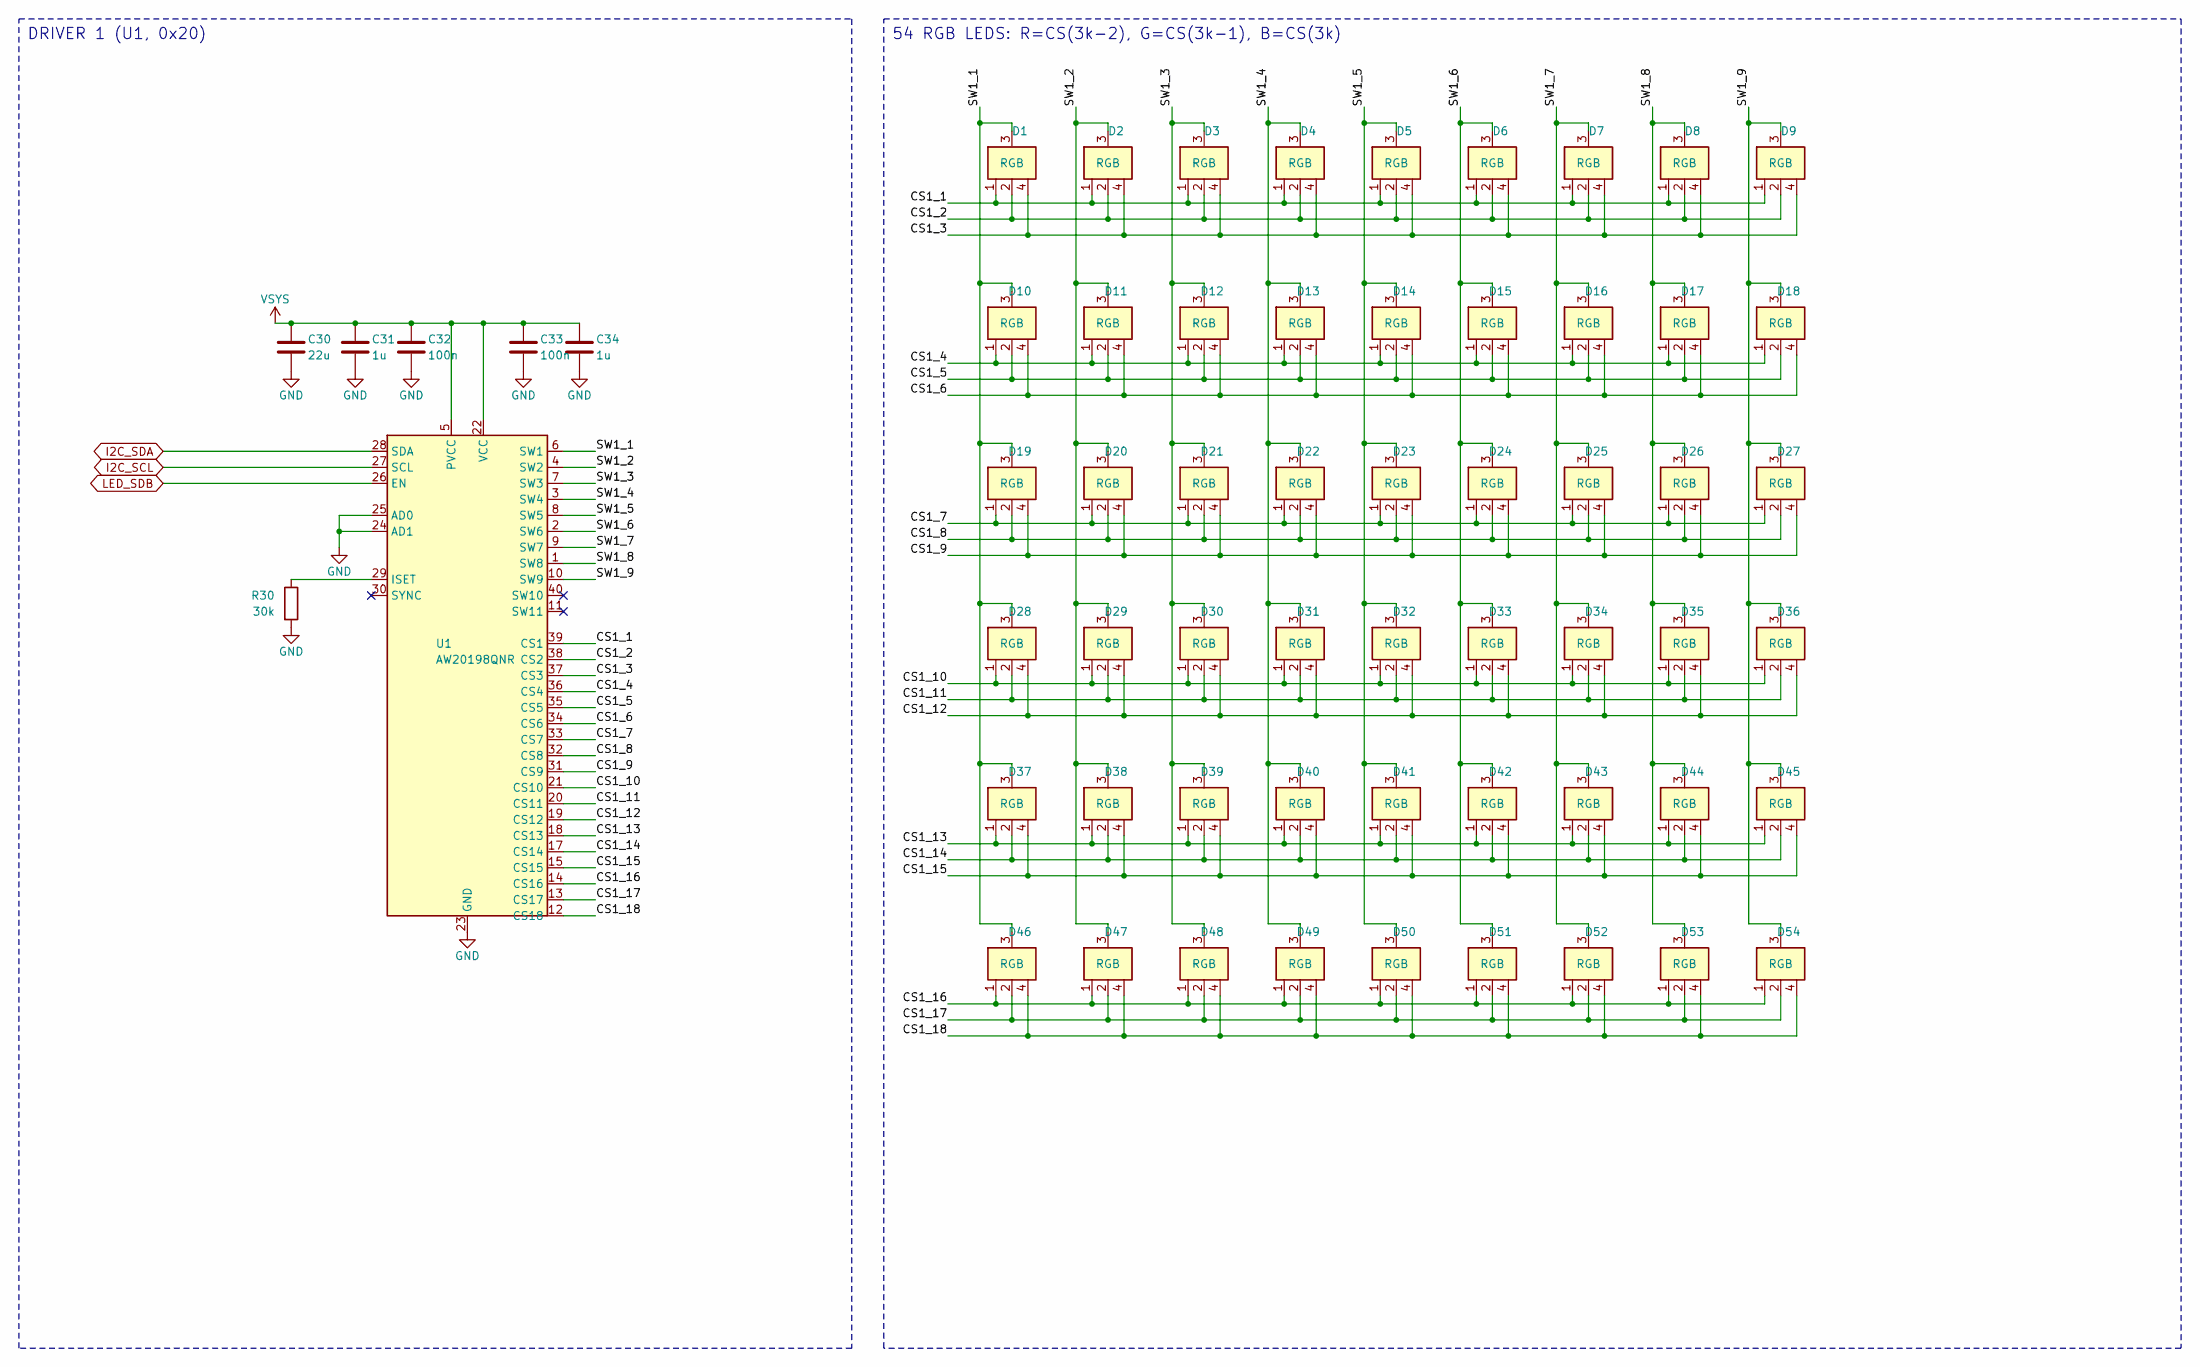
[picture p162: schematic matrix1.kicad_sch, parallelogram (p3-162): driver 1 and matrix]

Parts:
C30: 22u; C_0603_1608Metric; MPN CL10A226MP8NUNE; LCSC C86295
C31, C34: 1u; C_0402_1005Metric; MPN CL05A105KA5NQNC; LCSC C52923
C32, C33: 100n; C_0402_1005Metric; MPN CL05B104KO5NNNC; LCSC C1525
D1, D2, D3, D4, D5, D6, D7, D8, D9, D10, D11, D12, D13, D14, D15, D16, D17, D18, D19, D20, D21, D22, D23, D24, D25, D26, D27, D28, D29, D30, D31, D32, D33, D34, D35, D36, D37, D38, D39, D40, D41, D42, D43, D44, D45, D46, D47, D48, D49, D50, D51, D52, D53, D54: RGB; LED_XL-1010RGB; MPN XL-1010RGB-YG; LCSC C965834
R30: 30k; R_0402_1005Metric; MPN 0402WGF3002TCE; LCSC C25776
U1: AW20198QNR; AW20198_QFN-40-1EP_5x5mm_P0.4mm_EP3.4x3.4mm; MPN AW20198QNR; LCSC C5137654

Connections:
/Driver 1 and matrix/CS1_1: D1.1 (R), D2.1 (R), D3.1 (R), D4.1 (R), D5.1 (R), D6.1 (R), D7.1 (R), D8.1 (R), D9.1 (R), U1.39 (CS1)
/Driver 1 and matrix/CS1_2: D1.2 (G), D2.2 (G), D3.2 (G), D4.2 (G), D5.2 (G), D6.2 (G), D7.2 (G), D8.2 (G), D9.2 (G), U1.38 (CS2)
/Driver 1 and matrix/CS1_3: D1.4 (B), D2.4 (B), D3.4 (B), D4.4 (B), D5.4 (B), D6.4 (B), D7.4 (B), D8.4 (B), D9.4 (B), U1.37 (CS3)
/Driver 1 and matrix/CS1_4: D10.1 (R), D11.1 (R), D12.1 (R), D13.1 (R), D14.1 (R), D15.1 (R), D16.1 (R), D17.1 (R), D18.1 (R), U1.36 (CS4)
/Driver 1 and matrix/CS1_5: D10.2 (G), D11.2 (G), D12.2 (G), D13.2 (G), D14.2 (G), D15.2 (G), D16.2 (G), D17.2 (G), D18.2 (G), U1.35 (CS5)
/Driver 1 and matrix/CS1_6: D10.4 (B), D11.4 (B), D12.4 (B), D13.4 (B), D14.4 (B), D15.4 (B), D16.4 (B), D17.4 (B), D18.4 (B), U1.34 (CS6)
/Driver 1 and matrix/CS1_7: D19.1 (R), D20.1 (R), D21.1 (R), D22.1 (R), D23.1 (R), D24.1 (R), D25.1 (R), D26.1 (R), D27.1 (R), U1.33 (CS7)
/Driver 1 and matrix/CS1_8: D19.2 (G), D20.2 (G), D21.2 (G), D22.2 (G), D23.2 (G), D24.2 (G), D25.2 (G), D26.2 (G), D27.2 (G), U1.32 (CS8)
/Driver 1 and matrix/CS1_9: D19.4 (B), D20.4 (B), D21.4 (B), D22.4 (B), D23.4 (B), D24.4 (B), D25.4 (B), D26.4 (B), D27.4 (B), U1.31 (CS9)
/Driver 1 and matrix/CS1_10: D28.1 (R), D29.1 (R), D30.1 (R), D31.1 (R), D32.1 (R), D33.1 (R), D34.1 (R), D35.1 (R), D36.1 (R), U1.21 (CS10)
/Driver 1 and matrix/CS1_11: D28.2 (G), D29.2 (G), D30.2 (G), D31.2 (G), D32.2 (G), D33.2 (G), D34.2 (G), D35.2 (G), D36.2 (G), U1.20 (CS11)
/Driver 1 and matrix/CS1_12: D28.4 (B), D29.4 (B), D30.4 (B), D31.4 (B), D32.4 (B), D33.4 (B), D34.4 (B), D35.4 (B), D36.4 (B), U1.19 (CS12)
/Driver 1 and matrix/CS1_13: D37.1 (R), D38.1 (R), D39.1 (R), D40.1 (R), D41.1 (R), D42.1 (R), D43.1 (R), D44.1 (R), D45.1 (R), U1.18 (CS13)
/Driver 1 and matrix/CS1_14: D37.2 (G), D38.2 (G), D39.2 (G), D40.2 (G), D41.2 (G), D42.2 (G), D43.2 (G), D44.2 (G), D45.2 (G), U1.17 (CS14)
/Driver 1 and matrix/CS1_15: D37.4 (B), D38.4 (B), D39.4 (B), D40.4 (B), D41.4 (B), D42.4 (B), D43.4 (B), D44.4 (B), D45.4 (B), U1.15 (CS15)
/Driver 1 and matrix/CS1_16: D46.1 (R), D47.1 (R), D48.1 (R), D49.1 (R), D50.1 (R), D51.1 (R), D52.1 (R), D53.1 (R), D54.1 (R), U1.14 (CS16)
/Driver 1 and matrix/CS1_17: D46.2 (G), D47.2 (G), D48.2 (G), D49.2 (G), D50.2 (G), D51.2 (G), D52.2 (G), D53.2 (G), D54.2 (G), U1.13 (CS17)
/Driver 1 and matrix/CS1_18: D46.4 (B), D47.4 (B), D48.4 (B), D49.4 (B), D50.4 (B), D51.4 (B), D52.4 (B), D53.4 (B), D54.4 (B), U1.12 (CS18)
/Driver 1 and matrix/SW1_1: D1.3 (A), D10.3 (A), D19.3 (A), D28.3 (A), D37.3 (A), D46.3 (A), U1.6 (SW1)
/Driver 1 and matrix/SW1_2: D2.3 (A), D11.3 (A), D20.3 (A), D29.3 (A), D38.3 (A), D47.3 (A), U1.4 (SW2)
/Driver 1 and matrix/SW1_3: D3.3 (A), D12.3 (A), D21.3 (A), D30.3 (A), D39.3 (A), D48.3 (A), U1.7 (SW3)
/Driver 1 and matrix/SW1_4: D4.3 (A), D13.3 (A), D22.3 (A), D31.3 (A), D40.3 (A), D49.3 (A), U1.3 (SW4)
/Driver 1 and matrix/SW1_5: D5.3 (A), D14.3 (A), D23.3 (A), D32.3 (A), D41.3 (A), D50.3 (A), U1.8 (SW5)
/Driver 1 and matrix/SW1_6: D6.3 (A), D15.3 (A), D24.3 (A), D33.3 (A), D42.3 (A), D51.3 (A), U1.2 (SW6)
/Driver 1 and matrix/SW1_7: D7.3 (A), D16.3 (A), D25.3 (A), D34.3 (A), D43.3 (A), D52.3 (A), U1.9 (SW7)
/Driver 1 and matrix/SW1_8: D8.3 (A), D17.3 (A), D26.3 (A), D35.3 (A), D44.3 (A), D53.3 (A), U1.1 (SW8)
/Driver 1 and matrix/SW1_9: D9.3 (A), D18.3 (A), D27.3 (A), D36.3 (A), D45.3 (A), D54.3 (A), U1.10 (SW9)
I2C_SCL: U1.27 (SCL); also elsewhere on the board
I2C_SDA: U1.28 (SDA); also elsewhere on the board
LED_SDB: U1.26 (EN); also elsewhere on the board
unnamed: R30.1, U1.29 (ISET)
VSYS: C30.1, C31.1, C32.1, C33.1, C34.1, U1.5 (PVCC), U1.22 (VCC); also elsewhere on the board

Notes on the sheet:
DRIVER 1 (U1, 0x20)
54 RGB LEDS: R=CS(3k-2), G=CS(3k-1), B=CS(3k)

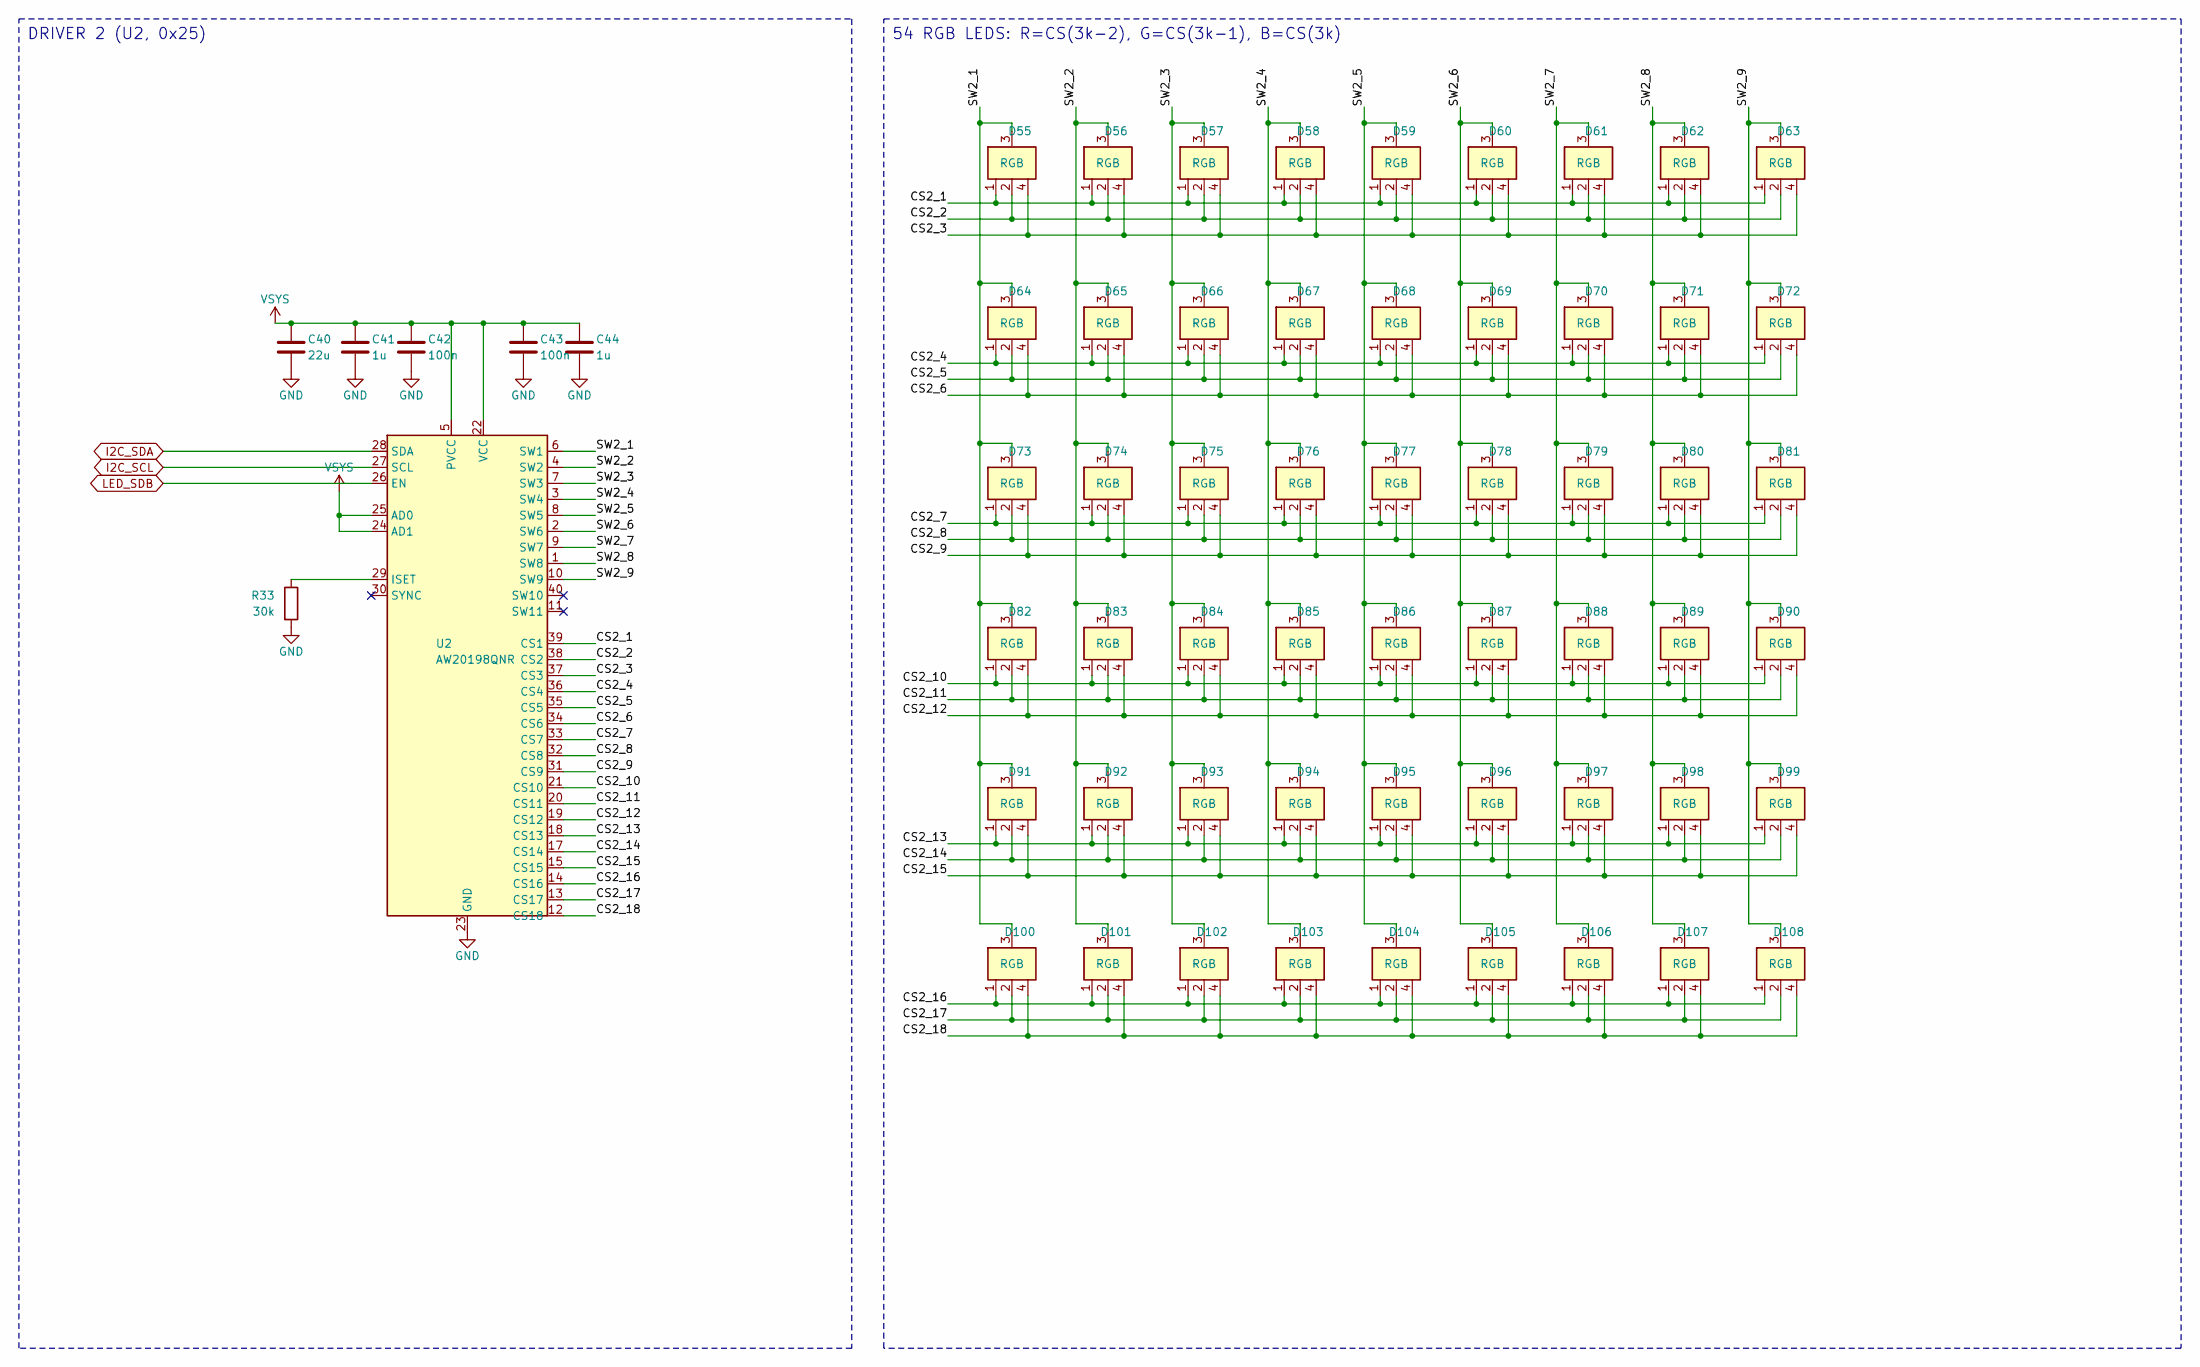
[picture p163: schematic matrix2.kicad_sch, parallelogram (p3-162): driver 2 and matrix]

Parts:
C40: 22u; C_0603_1608Metric; MPN CL10A226MP8NUNE; LCSC C86295
C41, C44: 1u; C_0402_1005Metric; MPN CL05A105KA5NQNC; LCSC C52923
C42, C43: 100n; C_0402_1005Metric; MPN CL05B104KO5NNNC; LCSC C1525
D55, D56, D57, D58, D59, D60, D61, D62, D63, D64, D65, D66, D67, D68, D69, D70, D71, D72, D73, D74, D75, D76, D77, D78, D79, D80, D81, D82, D83, D84, D85, D86, D87, D88, D89, D90, D91, D92, D93, D94, D95, D96, D97, D98, D99, D100, D101, D102, D103, D104, D105, D106, D107, D108: RGB; LED_XL-1010RGB; MPN XL-1010RGB-YG; LCSC C965834
R33: 30k; R_0402_1005Metric; MPN 0402WGF3002TCE; LCSC C25776
U2: AW20198QNR; AW20198_QFN-40-1EP_5x5mm_P0.4mm_EP3.4x3.4mm; MPN AW20198QNR; LCSC C5137654

Connections:
/Driver 2 and matrix/CS2_1: D55.1 (R), D56.1 (R), D57.1 (R), D58.1 (R), D59.1 (R), D60.1 (R), D61.1 (R), D62.1 (R), D63.1 (R), U2.39 (CS1)
/Driver 2 and matrix/CS2_2: D55.2 (G), D56.2 (G), D57.2 (G), D58.2 (G), D59.2 (G), D60.2 (G), D61.2 (G), D62.2 (G), D63.2 (G), U2.38 (CS2)
/Driver 2 and matrix/CS2_3: D55.4 (B), D56.4 (B), D57.4 (B), D58.4 (B), D59.4 (B), D60.4 (B), D61.4 (B), D62.4 (B), D63.4 (B), U2.37 (CS3)
/Driver 2 and matrix/CS2_4: D64.1 (R), D65.1 (R), D66.1 (R), D67.1 (R), D68.1 (R), D69.1 (R), D70.1 (R), D71.1 (R), D72.1 (R), U2.36 (CS4)
/Driver 2 and matrix/CS2_5: D64.2 (G), D65.2 (G), D66.2 (G), D67.2 (G), D68.2 (G), D69.2 (G), D70.2 (G), D71.2 (G), D72.2 (G), U2.35 (CS5)
/Driver 2 and matrix/CS2_6: D64.4 (B), D65.4 (B), D66.4 (B), D67.4 (B), D68.4 (B), D69.4 (B), D70.4 (B), D71.4 (B), D72.4 (B), U2.34 (CS6)
/Driver 2 and matrix/CS2_7: D73.1 (R), D74.1 (R), D75.1 (R), D76.1 (R), D77.1 (R), D78.1 (R), D79.1 (R), D80.1 (R), D81.1 (R), U2.33 (CS7)
/Driver 2 and matrix/CS2_8: D73.2 (G), D74.2 (G), D75.2 (G), D76.2 (G), D77.2 (G), D78.2 (G), D79.2 (G), D80.2 (G), D81.2 (G), U2.32 (CS8)
/Driver 2 and matrix/CS2_9: D73.4 (B), D74.4 (B), D75.4 (B), D76.4 (B), D77.4 (B), D78.4 (B), D79.4 (B), D80.4 (B), D81.4 (B), U2.31 (CS9)
/Driver 2 and matrix/CS2_10: D82.1 (R), D83.1 (R), D84.1 (R), D85.1 (R), D86.1 (R), D87.1 (R), D88.1 (R), D89.1 (R), D90.1 (R), U2.21 (CS10)
/Driver 2 and matrix/CS2_11: D82.2 (G), D83.2 (G), D84.2 (G), D85.2 (G), D86.2 (G), D87.2 (G), D88.2 (G), D89.2 (G), D90.2 (G), U2.20 (CS11)
/Driver 2 and matrix/CS2_12: D82.4 (B), D83.4 (B), D84.4 (B), D85.4 (B), D86.4 (B), D87.4 (B), D88.4 (B), D89.4 (B), D90.4 (B), U2.19 (CS12)
/Driver 2 and matrix/CS2_13: D91.1 (R), D92.1 (R), D93.1 (R), D94.1 (R), D95.1 (R), D96.1 (R), D97.1 (R), D98.1 (R), D99.1 (R), U2.18 (CS13)
/Driver 2 and matrix/CS2_14: D91.2 (G), D92.2 (G), D93.2 (G), D94.2 (G), D95.2 (G), D96.2 (G), D97.2 (G), D98.2 (G), D99.2 (G), U2.17 (CS14)
/Driver 2 and matrix/CS2_15: D91.4 (B), D92.4 (B), D93.4 (B), D94.4 (B), D95.4 (B), D96.4 (B), D97.4 (B), D98.4 (B), D99.4 (B), U2.15 (CS15)
/Driver 2 and matrix/CS2_16: D100.1 (R), D101.1 (R), D102.1 (R), D103.1 (R), D104.1 (R), D105.1 (R), D106.1 (R), D107.1 (R), D108.1 (R), U2.14 (CS16)
/Driver 2 and matrix/CS2_17: D100.2 (G), D101.2 (G), D102.2 (G), D103.2 (G), D104.2 (G), D105.2 (G), D106.2 (G), D107.2 (G), D108.2 (G), U2.13 (CS17)
/Driver 2 and matrix/CS2_18: D100.4 (B), D101.4 (B), D102.4 (B), D103.4 (B), D104.4 (B), D105.4 (B), D106.4 (B), D107.4 (B), D108.4 (B), U2.12 (CS18)
/Driver 2 and matrix/SW2_1: D55.3 (A), D64.3 (A), D73.3 (A), D82.3 (A), D91.3 (A), D100.3 (A), U2.6 (SW1)
/Driver 2 and matrix/SW2_2: D56.3 (A), D65.3 (A), D74.3 (A), D83.3 (A), D92.3 (A), D101.3 (A), U2.4 (SW2)
/Driver 2 and matrix/SW2_3: D57.3 (A), D66.3 (A), D75.3 (A), D84.3 (A), D93.3 (A), D102.3 (A), U2.7 (SW3)
/Driver 2 and matrix/SW2_4: D58.3 (A), D67.3 (A), D76.3 (A), D85.3 (A), D94.3 (A), D103.3 (A), U2.3 (SW4)
/Driver 2 and matrix/SW2_5: D59.3 (A), D68.3 (A), D77.3 (A), D86.3 (A), D95.3 (A), D104.3 (A), U2.8 (SW5)
/Driver 2 and matrix/SW2_6: D60.3 (A), D69.3 (A), D78.3 (A), D87.3 (A), D96.3 (A), D105.3 (A), U2.2 (SW6)
/Driver 2 and matrix/SW2_7: D61.3 (A), D70.3 (A), D79.3 (A), D88.3 (A), D97.3 (A), D106.3 (A), U2.9 (SW7)
/Driver 2 and matrix/SW2_8: D62.3 (A), D71.3 (A), D80.3 (A), D89.3 (A), D98.3 (A), D107.3 (A), U2.1 (SW8)
/Driver 2 and matrix/SW2_9: D63.3 (A), D72.3 (A), D81.3 (A), D90.3 (A), D99.3 (A), D108.3 (A), U2.10 (SW9)
I2C_SCL: U2.27 (SCL); also elsewhere on the board
I2C_SDA: U2.28 (SDA); also elsewhere on the board
LED_SDB: U2.26 (EN); also elsewhere on the board
unnamed: R33.1, U2.29 (ISET)
VSYS: C40.1, C41.1, C42.1, C43.1, C44.1, U2.5 (PVCC), U2.22 (VCC), U2.24 (AD1), U2.25 (AD0); also elsewhere on the board

Notes on the sheet:
DRIVER 2 (U2, 0x25)
54 RGB LEDS: R=CS(3k-2), G=CS(3k-1), B=CS(3k)
