sequoia-hope/matrix-play/hw/parallelogram/p3-162/parallelogram.kicad_pcb

## KiCad design hw/parallelogram/p3-162/parallelogram.kicad_pcb (continued)

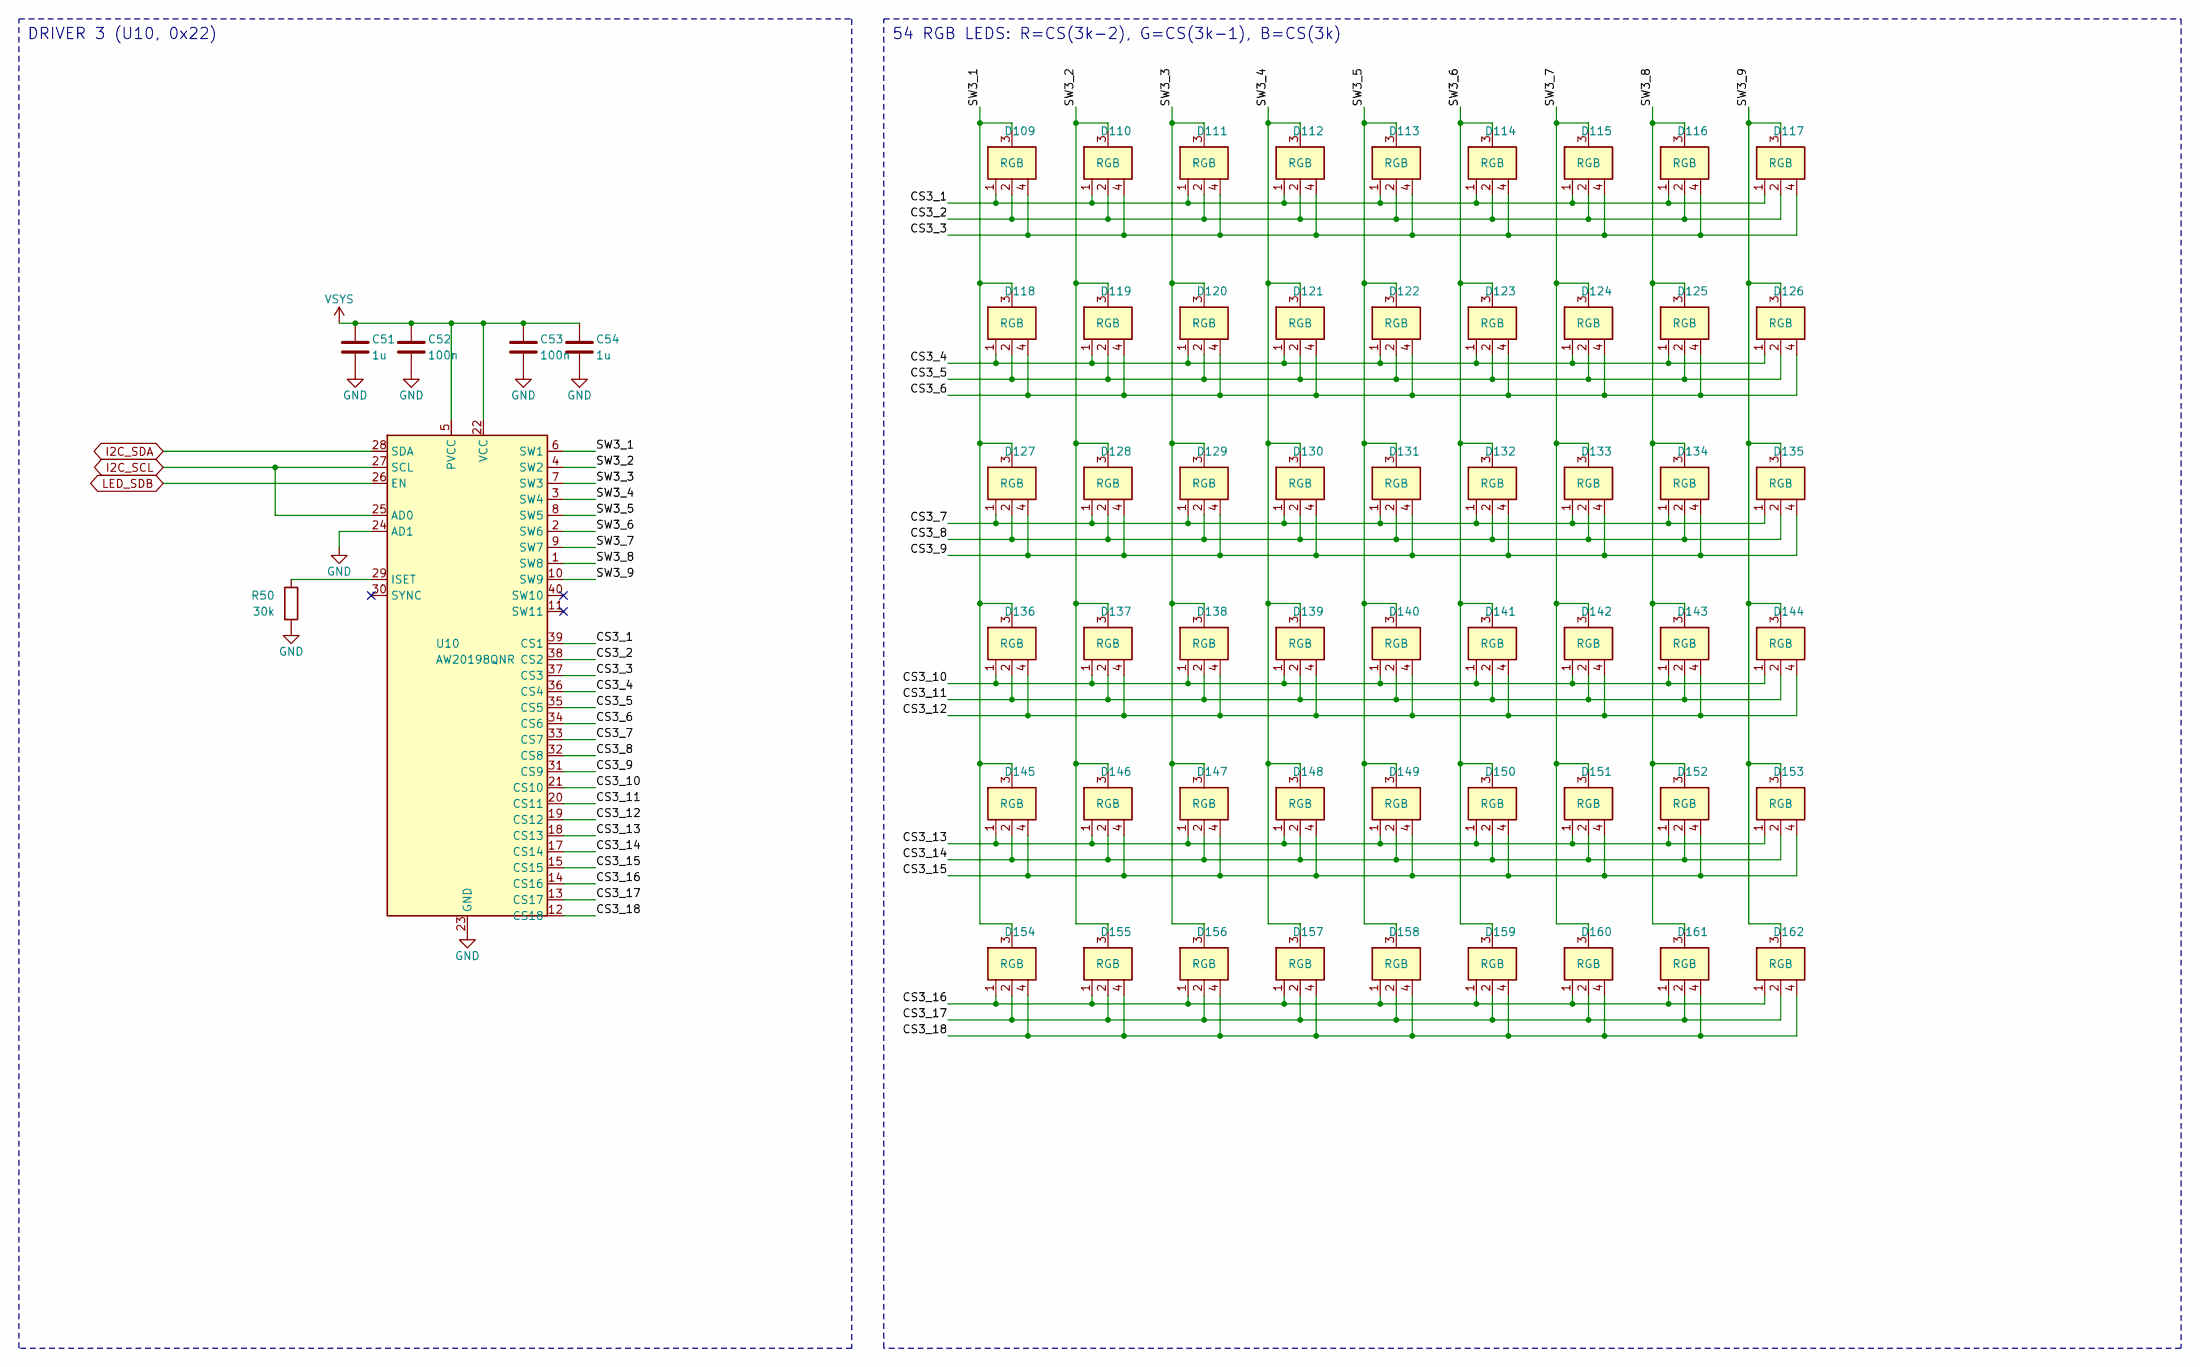
[picture p164: schematic matrix3.kicad_sch, parallelogram (p3-162): driver 3 and matrix]

Parts:
C51, C54: 1u; C_0402_1005Metric; MPN CL05A105KA5NQNC; LCSC C52923
C52, C53: 100n; C_0402_1005Metric; MPN CL05B104KO5NNNC; LCSC C1525
D109, D110, D111, D112, D113, D114, D115, D116, D117, D118, D119, D120, D121, D122, D123, D124, D125, D126, D127, D128, D129, D130, D131, D132, D133, D134, D135, D136, D137, D138, D139, D140, D141, D142, D143, D144, D145, D146, D147, D148, D149, D150, D151, D152, D153, D154, D155, D156, D157, D158, D159, D160, D161, D162: RGB; LED_XL-1010RGB; MPN XL-1010RGB-YG; LCSC C965834
R50: 30k; R_0402_1005Metric; MPN 0402WGF3002TCE; LCSC C25776
U10: AW20198QNR; AW20198_QFN-40-1EP_5x5mm_P0.4mm_EP3.4x3.4mm; MPN AW20198QNR; LCSC C5137654

Connections:
/Driver 3 and matrix/CS3_1: D109.1 (R), D110.1 (R), D111.1 (R), D112.1 (R), D113.1 (R), D114.1 (R), D115.1 (R), D116.1 (R), D117.1 (R), U10.39 (CS1)
/Driver 3 and matrix/CS3_2: D109.2 (G), D110.2 (G), D111.2 (G), D112.2 (G), D113.2 (G), D114.2 (G), D115.2 (G), D116.2 (G), D117.2 (G), U10.38 (CS2)
/Driver 3 and matrix/CS3_3: D109.4 (B), D110.4 (B), D111.4 (B), D112.4 (B), D113.4 (B), D114.4 (B), D115.4 (B), D116.4 (B), D117.4 (B), U10.37 (CS3)
/Driver 3 and matrix/CS3_4: D118.1 (R), D119.1 (R), D120.1 (R), D121.1 (R), D122.1 (R), D123.1 (R), D124.1 (R), D125.1 (R), D126.1 (R), U10.36 (CS4)
/Driver 3 and matrix/CS3_5: D118.2 (G), D119.2 (G), D120.2 (G), D121.2 (G), D122.2 (G), D123.2 (G), D124.2 (G), D125.2 (G), D126.2 (G), U10.35 (CS5)
/Driver 3 and matrix/CS3_6: D118.4 (B), D119.4 (B), D120.4 (B), D121.4 (B), D122.4 (B), D123.4 (B), D124.4 (B), D125.4 (B), D126.4 (B), U10.34 (CS6)
/Driver 3 and matrix/CS3_7: D127.1 (R), D128.1 (R), D129.1 (R), D130.1 (R), D131.1 (R), D132.1 (R), D133.1 (R), D134.1 (R), D135.1 (R), U10.33 (CS7)
/Driver 3 and matrix/CS3_8: D127.2 (G), D128.2 (G), D129.2 (G), D130.2 (G), D131.2 (G), D132.2 (G), D133.2 (G), D134.2 (G), D135.2 (G), U10.32 (CS8)
/Driver 3 and matrix/CS3_9: D127.4 (B), D128.4 (B), D129.4 (B), D130.4 (B), D131.4 (B), D132.4 (B), D133.4 (B), D134.4 (B), D135.4 (B), U10.31 (CS9)
/Driver 3 and matrix/CS3_10: D136.1 (R), D137.1 (R), D138.1 (R), D139.1 (R), D140.1 (R), D141.1 (R), D142.1 (R), D143.1 (R), D144.1 (R), U10.21 (CS10)
/Driver 3 and matrix/CS3_11: D136.2 (G), D137.2 (G), D138.2 (G), D139.2 (G), D140.2 (G), D141.2 (G), D142.2 (G), D143.2 (G), D144.2 (G), U10.20 (CS11)
/Driver 3 and matrix/CS3_12: D136.4 (B), D137.4 (B), D138.4 (B), D139.4 (B), D140.4 (B), D141.4 (B), D142.4 (B), D143.4 (B), D144.4 (B), U10.19 (CS12)
/Driver 3 and matrix/CS3_13: D145.1 (R), D146.1 (R), D147.1 (R), D148.1 (R), D149.1 (R), D150.1 (R), D151.1 (R), D152.1 (R), D153.1 (R), U10.18 (CS13)
/Driver 3 and matrix/CS3_14: D145.2 (G), D146.2 (G), D147.2 (G), D148.2 (G), D149.2 (G), D150.2 (G), D151.2 (G), D152.2 (G), D153.2 (G), U10.17 (CS14)
/Driver 3 and matrix/CS3_15: D145.4 (B), D146.4 (B), D147.4 (B), D148.4 (B), D149.4 (B), D150.4 (B), D151.4 (B), D152.4 (B), D153.4 (B), U10.15 (CS15)
/Driver 3 and matrix/CS3_16: D154.1 (R), D155.1 (R), D156.1 (R), D157.1 (R), D158.1 (R), D159.1 (R), D160.1 (R), D161.1 (R), D162.1 (R), U10.14 (CS16)
/Driver 3 and matrix/CS3_17: D154.2 (G), D155.2 (G), D156.2 (G), D157.2 (G), D158.2 (G), D159.2 (G), D160.2 (G), D161.2 (G), D162.2 (G), U10.13 (CS17)
/Driver 3 and matrix/CS3_18: D154.4 (B), D155.4 (B), D156.4 (B), D157.4 (B), D158.4 (B), D159.4 (B), D160.4 (B), D161.4 (B), D162.4 (B), U10.12 (CS18)
/Driver 3 and matrix/SW3_1: D109.3 (A), D118.3 (A), D127.3 (A), D136.3 (A), D145.3 (A), D154.3 (A), U10.6 (SW1)
/Driver 3 and matrix/SW3_2: D110.3 (A), D119.3 (A), D128.3 (A), D137.3 (A), D146.3 (A), D155.3 (A), U10.4 (SW2)
/Driver 3 and matrix/SW3_3: D111.3 (A), D120.3 (A), D129.3 (A), D138.3 (A), D147.3 (A), D156.3 (A), U10.7 (SW3)
/Driver 3 and matrix/SW3_4: D112.3 (A), D121.3 (A), D130.3 (A), D139.3 (A), D148.3 (A), D157.3 (A), U10.3 (SW4)
/Driver 3 and matrix/SW3_5: D113.3 (A), D122.3 (A), D131.3 (A), D140.3 (A), D149.3 (A), D158.3 (A), U10.8 (SW5)
/Driver 3 and matrix/SW3_6: D114.3 (A), D123.3 (A), D132.3 (A), D141.3 (A), D150.3 (A), D159.3 (A), U10.2 (SW6)
/Driver 3 and matrix/SW3_7: D115.3 (A), D124.3 (A), D133.3 (A), D142.3 (A), D151.3 (A), D160.3 (A), U10.9 (SW7)
/Driver 3 and matrix/SW3_8: D116.3 (A), D125.3 (A), D134.3 (A), D143.3 (A), D152.3 (A), D161.3 (A), U10.1 (SW8)
/Driver 3 and matrix/SW3_9: D117.3 (A), D126.3 (A), D135.3 (A), D144.3 (A), D153.3 (A), D162.3 (A), U10.10 (SW9)
I2C_SCL: U10.25 (AD0), U10.27 (SCL); also elsewhere on the board
I2C_SDA: U10.28 (SDA); also elsewhere on the board
LED_SDB: U10.26 (EN); also elsewhere on the board
unnamed: R50.1, U10.29 (ISET)
VSYS: C51.1, C52.1, C53.1, C54.1, U10.5 (PVCC), U10.22 (VCC); also elsewhere on the board

Notes on the sheet:
DRIVER 3 (U10, 0x22)
54 RGB LEDS: R=CS(3k-2), G=CS(3k-1), B=CS(3k)

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
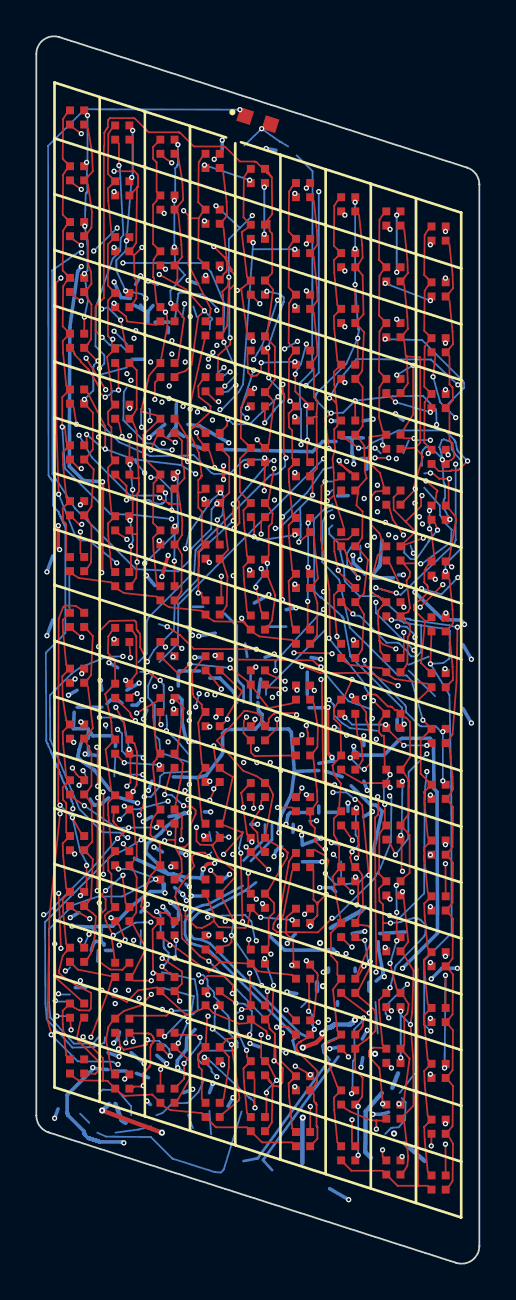
[picture p165: board hw/parallelogram/p3-162/parallelogram.kicad_pcb from above]

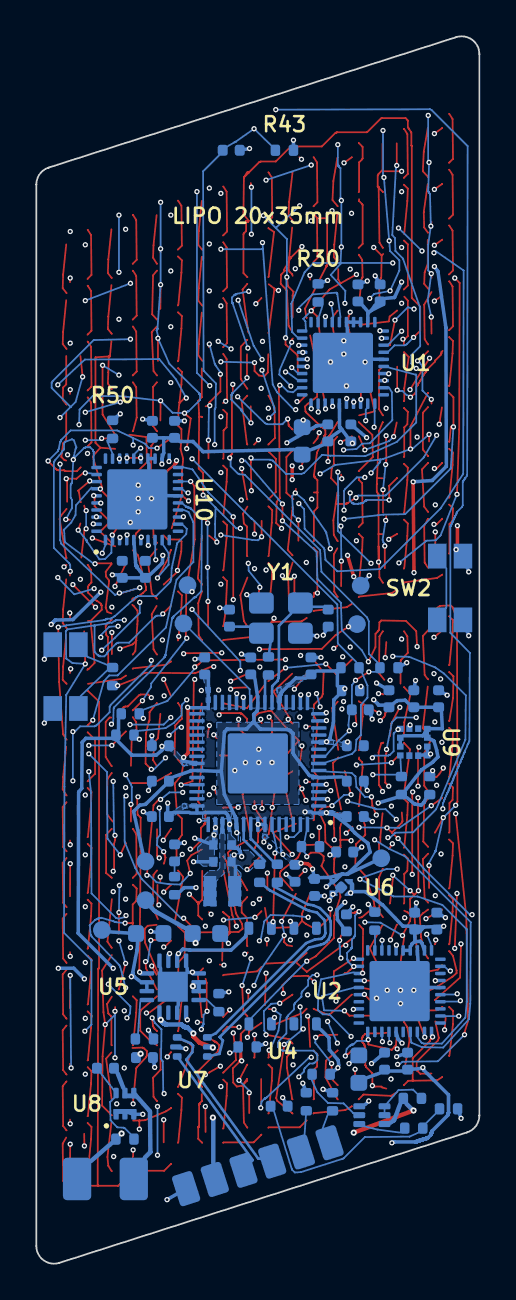
[picture p166: board hw/parallelogram/p3-162/parallelogram.kicad_pcb from below]

Board: 4 copper layers, 25.0 x 69.3 mm, 257 parts (94 on the bottom side), 134 nets.
