sequoia-hope/matrix-play/fw/p2-132/p2-132-fw/build.rs

use std::env;
use std::fs;
use std::path::PathBuf;

fn main() {
    let out_dir = PathBuf::from(env::var("OUT_DIR").expect("OUT_DIR"));
    let manifest_dir = PathBuf::from(env::var("CARGO_MANIFEST_DIR").expect("CARGO_MANIFEST_DIR"));
    let linker_script = manifest_dir.join("memory.x");
    fs::copy(&linker_script, out_dir.join("memory.x")).expect("copy memory.x to OUT_DIR");
    println!("cargo:rustc-link-search={}", out_dir.display());
    println!("cargo:rerun-if-changed={}", linker_script.display());
}
