sequoia-hope/matrix-play/scripts/variant_fusbc_rtc/compare_with_parent.py

#!/usr/bin/env python3
"""compare_with_parent.py — Exact side-by-side verification of round-pendant f-usbc-rtc vs parent f-usbc & f:
  - 236 front footprints (235 LEDs + Q2) 0.000 mm / 0.00 deg delta
  - J1, SW1, SW2, U1..U7, U9..U12, L1, Y1 0.000 mm / 0.00 deg delta vs f-usbc
  - 147 locked RP2350 +3V3/+1V1 decoupling/LDO/FB tracks 100% preserved
  - Via counts (by drill/width) and track counts/lengths
  - Every copper zone's filled piece count and copper area (mm^2) vs f-usbc
  - J1 NPTH clearances across all 8 layers + RX8130_xtal_end B.Cu keepout audit
"""
from __future__ import annotations

import math
import os
import sys
import pcbnew

BOARD_P = "hw/round-pendant/f-usbc/round-pendant.kicad_pcb"
BOARD_R = "hw/round-pendant/f-usbc-rtc/round-pendant.kicad_pcb"

um = pcbnew.ToMM
mm = lambda v: pcbnew.FromMM(float(v))


def is_via(t):
    return isinstance(t, pcbnew.PCB_VIA)


def item_sig(t, brd):
    if is_via(t):
        p = t.GetPosition()
        return ("V", t.GetNetname(), p.x, p.y, t.GetDrill())
    return (
        "T",
        t.GetNetname(),
        brd.GetLayerName(t.GetLayer()),
        t.GetStart().x,
        t.GetStart().y,
        t.GetEnd().x,
        t.GetEnd().y,
        t.GetWidth(),
    )


def zone_stats(brd):
    filler = pcbnew.ZONE_FILLER(brd)
    filler.Fill(brd.Zones())
    rows = []
    cu_layers = [l for l in range(64) if brd.GetLayerName(l).endswith(".Cu") and brd.IsLayerEnabled(l)]
    for idx, z in enumerate(brd.Zones()):
        if z.GetIsRuleArea():
            continue
        zname = z.GetZoneName() or f"zone_{idx}"
        net = z.GetNetname()
        for l in cu_layers:
            if not z.IsOnLayer(l):
                continue
            lname = brd.GetLayerName(l)
            poly = z.GetFilledPolysList(l)
            n_pieces = poly.OutlineCount()
            area_mm2 = 0.0
            for oi in range(n_pieces):
                outline = poly.Outline(oi)
                a = abs(outline.Area()) / 1e12
                for hi in range(poly.HoleCount(oi)):
                    a -= abs(poly.Hole(oi, hi).Area()) / 1e12
                area_mm2 += a
            rows.append((idx, zname, net, lname, n_pieces, area_mm2))
    return rows


def main():
    bp = pcbnew.LoadBoard(BOARD_P)
    br = pcbnew.LoadBoard(BOARD_R)

    fps_p = {f.GetReference(): f for f in bp.GetFootprints()}
    fps_r = {f.GetReference(): f for f in br.GetFootprints()}

    front_count = 0
    for ref, fp in fps_p.items():
        if not fp.IsFlipped():
            fr = fps_r[ref]
            dx = abs(um(fp.GetPosition().x - fr.GetPosition().x))
            dy = abs(um(fp.GetPosition().y - fr.GetPosition().y))
            da = abs((fp.GetOrientationDegrees() - fr.GetOrientationDegrees() + 180) % 360 - 180)
            assert dx < 1e-4 and dy < 1e-4 and da < 1e-3, f"Front footprint {ref} moved!"
            front_count += 1

    moved_back = []
    for ref, fp in sorted(fps_p.items()):
        if fp.IsFlipped():
            fr = fps_r[ref]
            dx = um(fr.GetPosition().x - fp.GetPosition().x)
            dy = um(fr.GetPosition().y - fp.GetPosition().y)
            da = (fr.GetOrientationDegrees() - fp.GetOrientationDegrees() + 180) % 360 - 180
            if math.hypot(dx, dy) > 1e-3 or abs(da) > 1e-2:
                moved_back.append((
                    ref,
                    (um(fp.GetPosition().x), um(fp.GetPosition().y), fp.GetOrientationDegrees()),
                    (um(fr.GetPosition().x), um(fr.GetPosition().y), fr.GetOrientationDegrees()),
                ))
    added_back = sorted(set(fps_r.keys()) - set(fps_p.keys()))

    print("=== 1. FOOTPRINT PARITY (f-usbc-rtc vs f-usbc) ===")
    print(f"  Front parts unchanged: {front_count}/{front_count} (235 LEDs + Q2, max delta 0.0000 mm / 0.00 deg)")
    print(f"  Back parts moved/swapped: {len(moved_back)}")
    for ref, (ox, oy, oa), (nx, ny, na) in moved_back:
        print(f"    {ref:4s}: ({ox:7.3f}, {oy:7.3f}, {oa:7.2f} deg) -> ({nx:7.3f}, {ny:7.3f}, {na:7.2f} deg)")
    print(f"  New back parts added: {len(added_back)} ({', '.join(added_back)})")
    for ref in added_back:
        fr = fps_r[ref]
        print(f"    {ref:4s}: NEW at ({um(fr.GetPosition().x):7.3f}, {um(fr.GetPosition().y):7.3f}, {fr.GetOrientationDegrees():7.2f} deg)")

    r_sigs = {item_sig(t, br) for t in br.GetTracks()}
    r_locked = {item_sig(t, br) for t in br.GetTracks() if t.IsLocked()}
    p_decap = [
        t for t in bp.GetTracks()
        if not is_via(t) and t.GetNetname() in ("+3V3", "+1V1") and um(t.GetStart().y) < 102.0 and t.IsLocked()
    ]
    decap_kept = sum(1 for t in p_decap if item_sig(t, bp) in r_sigs)
    decap_locked = sum(1 for t in p_decap if item_sig(t, bp) in r_locked)
    print("\n=== 2. LOCKED RP2350 DECOUPLING TRACKS ===")
    print(f"  Survived intact: {decap_kept}/{len(p_decap)} (locked={decap_locked}/{len(p_decap)})")
    assert decap_kept == len(p_decap), "ERROR: RP2350 decoupling track missing!"

    vias_p = [t for t in bp.GetTracks() if is_via(t)]
    trks_p = [t for t in bp.GetTracks() if not is_via(t)]
    vias_r = [t for t in br.GetTracks() if is_via(t)]
    trks_r = [t for t in br.GetTracks() if not is_via(t)]
    len_p = sum(um(t.GetLength()) for t in trks_p)
    len_r = sum(um(t.GetLength()) for t in trks_r)
    shared_items = len({item_sig(t, bp) for t in bp.GetTracks()} & r_sigs)

    print("\n=== 3. COPPER TRACKS & VIAS (F-USBC vs F-USBC-RTC) ===")
    print(f"  Board F-USBC    : {len(vias_p):4d} vias, {len(trks_p):4d} track segs ({len_p:8.2f} mm)")
    print(f"  Board F-USBC-RTC: {len(vias_r):4d} vias, {len(trks_r):4d} track segs ({len_r:8.2f} mm)")
    print(f"  Delta           : {len(vias_r)-len(vias_p):+4d} vias, {len(trks_r)-len(trks_p):+4d} track segs ({len_r-len_p:+8.2f} mm)")
    print(f"  Identical copper items preserved verbatim from F-USBC: {shared_items}/{len(bp.GetTracks())} ({100.0*shared_items/len(bp.GetTracks()):.1f}%)")

    zp = zone_stats(bp)
    zr = zone_stats(br)
    print("\n=== 4. ZONE PIECE COUNTS & FILLED AREAS (F-USBC vs F-USBC-RTC) ===")
    print(f"  {'Idx':>3s} {'Zone Name':<18s} {'Net':<16s} {'Layer':<7s} | {'P pcs':>5s} {'P mm^2':>9s} | {'R pcs':>5s} {'R mm^2':>9s} | {'dPcs':>4s} {'dArea':>8s}")
    print("  " + "-" * 96)
    zp_by_key = {(zn, net, ln): (pf, af) for _, zn, net, ln, pf, af in zp}
    for idx, zn, net, ln, pr, ar in zr:
        pf, af = zp_by_key[(zn, net, ln)]
        print(f"  {idx:3d} {zn:<18s} {net:<16s} {ln:<7s} | {pf:5d} {af:9.3f} | {pr:5d} {ar:9.3f} | {pr-pf:+4d} {ar-af:+8.3f}")

    # Verify RX8130_xtal_end B.Cu rule area has 0 tracks/vias/pours inside
    bcu = br.GetLayerID("B.Cu")
    xtal_ra = next((z for z in br.Zones() if z.GetZoneName() == "RX8130_xtal_end"), None)
    assert xtal_ra is not None, "Missing RX8130_xtal_end rule area!"
    xtal_hits = 0
    for t in br.GetTracks():
        if is_via(t):
            if xtal_ra.Outline().Collide(t.GetEffectiveShape(bcu)):
                xtal_hits += 1
        elif t.GetLayer() == bcu:
            if xtal_ra.Outline().Collide(t.GetEffectiveShape(bcu)):
                xtal_hits += 1
    print(f"\n=== 5. RX8130_xtal_end B.Cu KEEPOUT AUDIT ===")
    print(f"  B.Cu tracks/vias intruding RX8130_xtal_end [114.30..115.20, 102.30..103.05]: {xtal_hits} (MUST BE 0)")
    assert xtal_hits == 0

    print("\n=== 6. J1 NPTH 8-LAYER CLEARANCE AUDIT ===")
    cu_layers = [l for l in range(64) if br.GetLayerName(l).endswith(".Cu") and br.IsLayerEnabled(l)]
    npths = [p for p in fps_r["J1"].Pads() if p.GetAttribute() == pcbnew.PAD_ATTRIB_NPTH]
    for ni, np in enumerate(npths, 1):
        nx, ny = um(np.GetPosition().x), um(np.GetPosition().y)
        nr = um(np.GetDrillSize().x) / 2.0
        print(f"  NPTH #{ni}: center=({nx:.3f}, {ny:.3f}) mm, drill={2*nr:.2f} mm (r={nr:.3f} mm)")
        for l in cu_layers:
            lname = br.GetLayerName(l)
            best_d = 999.0
            best_desc = "none"
            for f in br.GetFootprints():
                for p in f.Pads():
                    if p == np or p.GetAttribute() == pcbnew.PAD_ATTRIB_NPTH or not p.IsOnLayer(l):
                        continue
                    ps = p.GetEffectiveShape(l)
                    lo, hi = 0.0, 3.0
                    for _ in range(22):
                        mid = 0.5 * (lo + hi)
                        if ps.Collide(pcbnew.SHAPE_CIRCLE(np.GetPosition(), mm(nr + mid))):
                            hi = mid
                        else:
                            lo = mid
                    if hi < best_d:
                        best_d = hi
                        best_desc = f"Pad {f.GetReference()}.{p.GetNumber()} ({p.GetNetname()})"
            for t in br.GetTracks():
                if is_via(t):
                    d_cu = math.hypot(um(t.GetPosition().x) - nx, um(t.GetPosition().y) - ny) - nr - um(t.GetWidth(l)) / 2.0
                    if d_cu < best_d:
                        best_d = d_cu
                        best_desc = f"Via ({t.GetNetname()}) @({um(t.GetPosition().x):.3f},{um(t.GetPosition().y):.3f}) [cu]"
                elif t.GetLayer() == l:
                    ts = t.GetEffectiveShape(l)
                    if not ts.Collide(pcbnew.SHAPE_CIRCLE(np.GetPosition(), mm(nr + best_d))):
                        continue
                    lo, hi = 0.0, best_d
                    for _ in range(22):
                        mid = 0.5 * (lo + hi)
                        if ts.Collide(pcbnew.SHAPE_CIRCLE(np.GetPosition(), mm(nr + mid))):
                            hi = mid
                        else:
                            lo = mid
                    if hi < best_d:
                        best_d = hi
                        best_desc = f"Track ({t.GetNetname()})"
            for z in br.Zones():
                if z.GetIsRuleArea() or not z.IsOnLayer(l):
                    continue
                poly = z.GetFilledPolysList(l)
                if poly.IsEmpty():
                    continue
                lo, hi = 0.0, min(best_d, 2.0)
                if not poly.Collide(pcbnew.VECTOR2I(mm(nx), mm(ny)), mm(nr + hi)):
                    continue
                for _ in range(22):
                    mid = 0.5 * (lo + hi)
                    if poly.Collide(pcbnew.VECTOR2I(mm(nx), mm(ny)), mm(nr + mid)):
                        hi = mid
                    else:
                        lo = mid
                if hi < best_d:
                    best_d = hi
                    best_desc = f"Zone '{z.GetZoneName()}' ({z.GetNetname()})"
            print(f"    {lname:6s}: min clearance = {best_d:.3f} mm  -> {best_desc}")

    sys.stdout.flush()
    os._exit(0)


if __name__ == "__main__":
    main()
