sequoia-hope/matrix-play/scripts/review_page.py

#!/usr/bin/env python3
"""review_page.py — build the "Needs your review" pages, readable on a phone.

Every gate file under design/gates/ whose Status line says awaiting_signoff
becomes a card on design/review/index.html, plus every needs_user entry in
design/status.json. Gate records and the markdown files they link to are
rendered to HTML under design/review/doc/ (mirroring repo paths, so relative
links and images keep working); linked images and PDFs are copied alongside.
Plain-language notes, written by hand, go in design/review/notes/:
  <variant>-phase<N>.md   shown on that gate's card
  <variant>.md            shown on every card of that variant

The main page (index.html) gets a banner between the review-banner markers
naming how many sign-offs are waiting.

Usage:
  python3 scripts/review_page.py              # build into this checkout
  python3 scripts/review_page.py --ghp build/ghp
                                              # also copy into the gh-pages tree
Run it at every gate (the pcb-design skill's LESSONS.md says so).
"""
import argparse
import html
import json
import os
import re
import shutil
from pathlib import Path

import markdown

ROOT = Path(__file__).resolve().parent.parent
GATES = ROOT / "design" / "gates"
OUT = ROOT / "design" / "review"
DOC = OUT / "doc"
NOTES = OUT / "notes"
STATUS = ROOT / "design" / "status.json"
REPO_URL = "https://github.com/sequoia-hope/matrix-play/blob/main/"
COPY_EXT = {".png", ".jpg", ".jpeg", ".svg", ".gif", ".webp", ".pdf"}
COPY_MAX = 10 * 1024 * 1024
BANNER_START = "<!-- review-banner:start -->"
BANNER_END = "<!-- review-banner:end -->"
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
