sequoia-hope/matrix-play/(commit log)

2026-11-03 Round pendant: 235-LED 8-layer board, work in progress
    Sunflower of 235 RGB LEDs on a 38 mm round board, with RP2350A and two IS31FL3741A drivers.
    Best route is hw/round-pendant/c-web, with a seed web on the front silk. Not signed off.
2026-11-03 Put the board viewer at the top of the page
2026-11-03 Bump pcbview: 3D popping, framing and zoom fixes
2026-11-05 Variant D: 5x WLCSP-36 BGA LED drivers, solid exposed pads, 0 open / 0 DRC errors
2026-11-05 Variant E: add 12-o'clock top-rim ALS-PT19 light sensor, route & clean to 0 DRC errors/warnings, export JLCPCB files
2026-11-06 Website: frame intro around exploring LED matrix geometry and patterns
2026-11-06 Website: display all 13 viewer boards including Variant A rectangular grid on front page
2026-11-06 Bump pcbview submodule to 26ba32b (1:1 life-size scale button)
2026-11-06 Add ultra-dense 20x20 mm MHPA0808 square matrix boards (s16-256, s15-225) and p2-132 EM + picoem co-simulation
    - Add hw/dense-square/s16-256 (16x16 = 256 MHPA0808RGBDT C404279 0808 RGB LEDs at 1.27 mm = 50 mil pitch, 64.0 LEDs/cm^2) and hw/dense-square/s15-225 (15x15 = 225 LEDs at 1.36 mm pitch) on 25 x 50 mm 8-layer ENIG PCBs with zero components under the north 20 x 20 mm LED window and south-bay 4x AW20198QNR + RP2350A electronics: both 100.00% routed (1,156/1,156 and 1,100/1,100), 0 DRC errors/warnings, 0 copper_audit defects, 0 thin pad joints, fab Gerbers/BOM/CPL exported.
    - Add design/sim/p2-132/ 3D FDTD / PEEC full-wave EM simulation suites (P0-P4) and fw/p2-132/ bare-metal dual-core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
2026-11-06 Add 4-layer 38 mm sunflower family (66-132 XL-1615 LEDs, AW20198) and bump ultraroute to 3de3d83
    - scripts/sunflower/: generator forked from the parallelogram flow; Vogel-spiral
    LED field with courtyard relaxation, wedge matrix map, Variant D's RP2350 block,
    and a no-via-in-SMD-pad rule (physical_hole_clearance).
    - hw/sunflower/: s1-66, s2-88, s2-110, s2-132 (vias in pads, all 0 open), plus
    s2-88 and s1-66 re-routed with no vias in pads (s2-88 0 open, s1-66 1 open).
    s1-66-pofv and s2-88-pofv are DRC-clean with BOM/CPL in fab/.
    - design/study/sunflower/: study README and cost.json; decisions, status
    (sunflower-tier question), pcbview.toml and the project page updated.
    - vendor/ultra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
2026-11-06 Sunflower: PicoBlade battery socket, seed-web front silk, button labels; add Pattern Explorer
    - BT1 is a Molex PicoBlade 53261-0271 (C177225), the friction-fit "JST 1.25"
    plug most small LiPos ship with, at the north-west rim with the plug entering
    from the board-centre side. jst_site.py finds a site clear on every tier;
    apply_jst.py swaps and strips; finish_jst.sh cleans, silks and audits.
    - Front: the main pendant's Voronoi seed web. Back: PWR / BOOT button labels,
    BATT with a +/- pair in pin order and a pin-1 dot; label clearance now uses
    real pad shapes.
    - All six boards re-routed locally: s1-66-pofv, s2-88-pofv, s2-88 at 0 open and
    0 DRC (fab files re-exported for the two po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
2026-11-07 Sunflower s2-110-usbc: USB-C on the back, centre LED, rim light sensor (routing in progress, 1 open)
    USB-C receptacle (HRO TYPE-C-31-M-12) on B.Cu at the south rim with the
    front LEDs steered round its through-holes; LED at the spiral centre; ALS at
    the top rim. VBAT_EN moves to GPIO28 on this variant so it routes beside
    VBAT_SENSE. Adds the 4-layer one-connection fixer and a GND-plane via helper.
    Project page gains the board card and comparison row.
2026-11-07 Sunflower s2-110-usbc: routed to 0 opens, 0 DRC; fix USB-C D+/D- merged into CC1
    - Schematic: J1's D+/D- now join U7 by label; the jogged wire ended on the
    CC1 wire and merged the three nets (present in 997affe). Board synced and
    the nets re-routed.
    - No via-in-pad: U2's PVCC caps sit 0.45 mm further out (pcb_gen, east
    driver, USB-C variants) so its south pins can escape.
    - +3V3 neck at the LDO output removed; copper audit clean.
    - 612 vias, DRC 0 errors/warnings/unconnected, pad joints, sync and nets
    checks pass. Fab files exported. Page card and row updated.
2026-11-07 Sunflower s2-110-usbc: 3D model for the HRO TYPE-C-31-M-12 receptacle
    KiCad ships no STEP for its footprint; use the LCSC C165948 model, turned
    180 degrees and moved 0.8 mm so its legs and pegs sit in the footprint's
    slots (checked with a kicad-cli render).
2026-11-07 Sunflower s2-110-usbc: bring-up test pads, board ID straps, UART1 on GPIO24/25
    Fourteen back-side test pads (power rails, SWD and RUN, I2C0, UART1 TX/RX
    on GPIO24/25, spare ADC GPIO29) using a 0.75 mm courtyard copy of KiCad's
    1.0 mm pad. Board ID straps on GPIO19-21 (pull-ups, tied = 0); this board
    ties GPIO19 through net tie NT1 and reads ID 6. Re-routed to 0 opens,
    0 DRC, audits clean, 637 vias; fab files re-exported (BOM unchanged).
2026-11-07 Sunflower s2-110-usbc: In1 LX cutout follows the VREG_LX copper
    The layer-2 GND cutout under the RP2350 switch node was the bounding box
    of U3 pin 48 and L1's LX pad, which also cleared plane under pins 46/47
    and the PGND pour (9.2 mm2). It is now the VREG_LX zone and LX pads grown
    0.25 mm (5.4 mm2). Plane refilled; 0 DRC, audits clean; gerbers
    re-exported (BOM and CPL unchanged).
2026-11-07 Parallelogram boards: In1 LX cutout follows the VREG_LX copper
    Same fix as the sunflower s2-110-usbc: the layer-2 GND cutout under the
    RP2350 switch node was the bounding box of U3 pin 48 and L1's LX pad
    (9.2 mm2), also clearing plane under pins 46/47 and the PGND pour. It is
    now the VREG_LX zone and LX pads grown 0.25 mm (5.4-5.5 mm2), in the
    generator and on p1-66, p2-132, p3-162, p3-198 and p4-264 in place
    (plane refilled, no copper moved). p1-66 and p2-132 stay at 0 DRC with
    audits clean; gerbers re-exported, BOM and CPL unchanged. On the p3/p4
    boards the PGND tie vias, previously inside the box, now reach the plane.
2026-11-08 Penrose round boards: pn-dense (67 LEDs, 2 drivers) and pn-dense-1d (1 driver + GPIO centre LED)
    38 mm 4-layer sunflower-family boards with the LEDs on the vertices of the
    pattern explorer's dense Penrose P3 tiling (closest pair 2.547 mm, rhomb
    edge 4.12 mm, centre vertex at the board centre; 4 vertices on the USB-C
    holes dropped, not moved). Front silk draws the rhomb edges.
    pn-dense: 2x AW20198, 0 open, 0 DRC, 419 vias, none in pads, $11.75 @10.
    pn-dense-1d: 66 LEDs on one AW20198, centre LED on RP2350 GPIO7/8/9 through
    150/510/510 ohm with the anode on +3V3 (design/parts/direct-led.md);
    0 open, 0 DRC, 528 vias, none in pads, $10.81 @10.
    The wedge matrix map now takes LED counts that are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
2026-11-08 Main page: add the Penrose pn-dense and pn-dense-1d boards
2026-11-09 Main page: every board gets a card (Round Pendant F, the parallelogram USB-C boards, p3-162, square-bezel BGA boards, s1-66 no-via-in-pad, D, and the earlier B/C variants and route snapshots)
2026-11-09 Sunflower s2-110-usbc: phase gates 0-10 (5-9 held for a waiver-or-respin decision), bottom-side CPL rotation fix, stale Fabrication Toolkit export moved aside
    Gates run by a Gemini 4 Argon agent with fresh-context reviewers. Gates 1-3 pass; 0, 4 and 10
    await sign-off; 5-9 are held on layout findings against the RP2350 reference (+3V3 band in 4
    pieces, COUT without spokes, shared PGND/CFILT via), placement (U8 far from BT1, C22 far from U4),
    silk and net-class rules. Board and schematic unchanged. Also commits the earlier sessions'
    pending pcbview.toml entries and decisions rows, and Round Pendant E's corrected note.
2026-11-09 Parallelogram: commit the USB-C family (p1-66-usb..p4-264-usb) and add p2-132-usb6 with two West-edge side buttons
    p2-132-usb6 (Gemini 4 Argon, fresh-context reviewers): SW5 USER_C on GPIO9 and SW6 USER_D on
    GPIO0, EVQP7J01P on the West edge near each end, 1k + 100 nF each. 0 opens, 0 DRC errors or
    warnings, planes and RP2350 zones whole; gates 5-9 passed, 4 and 10 await sign-off. Generator
    changes sit behind VariantSpec.extra_side_buttons; existing variants regenerate identically.
    The -usb boards and their generator changes were built in an earlier session but never committed.
2026-11-10 round-pendant-f-usbc-rtc: add inward 1.25mm battery socket + RX8130CE RTC (Rev FUR, Gates 1-10, fab)
2026-11-10 p2-132-usb6: reference 1V1 spokes for U3's ring; ultraroute cleanup inventory
    U3's 1V1 ring reached DVDD pins 6/23/39 only through 0.2 mm inner-layer wires and
    0.3/0.15 vias. It now has the RP2350 reference spokes, mirrored for the back side:
    four 0.6/0.25 ring vias, 0.6 mm In2.Cu spokes to the pins' in-pad vias and to a
    COUT via, and pin 23 -> C19 on B.Cu (scripts/parallelogram/u3_spokes.py). Displaced
    nets re-routed with ultraroute --adopt near U3, then clean_copper_4l. The independent
    review's MAJOR (a dropped PGND plane via) is fixed.
    DRC 0/0/0 with schematic parity; copper_audit, pad_joints, sync, nets_check pass;
    Gate 8 PDN re-run PASS; fab re-exported (BOM/CPL unchanged). Same-net lo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
